FabienFerrero/UCA_Board/Gerber/readme.md

The PCB has been layout by hand, I'm an antenna designer and not a professional PCB layout maker, 
so you may find the layout not so much professional.

Whatever, this PCB is working quite well for proof of concept projects.

If you want to give an hand to make this project more professional, please send me an email.

Top View from ADS software

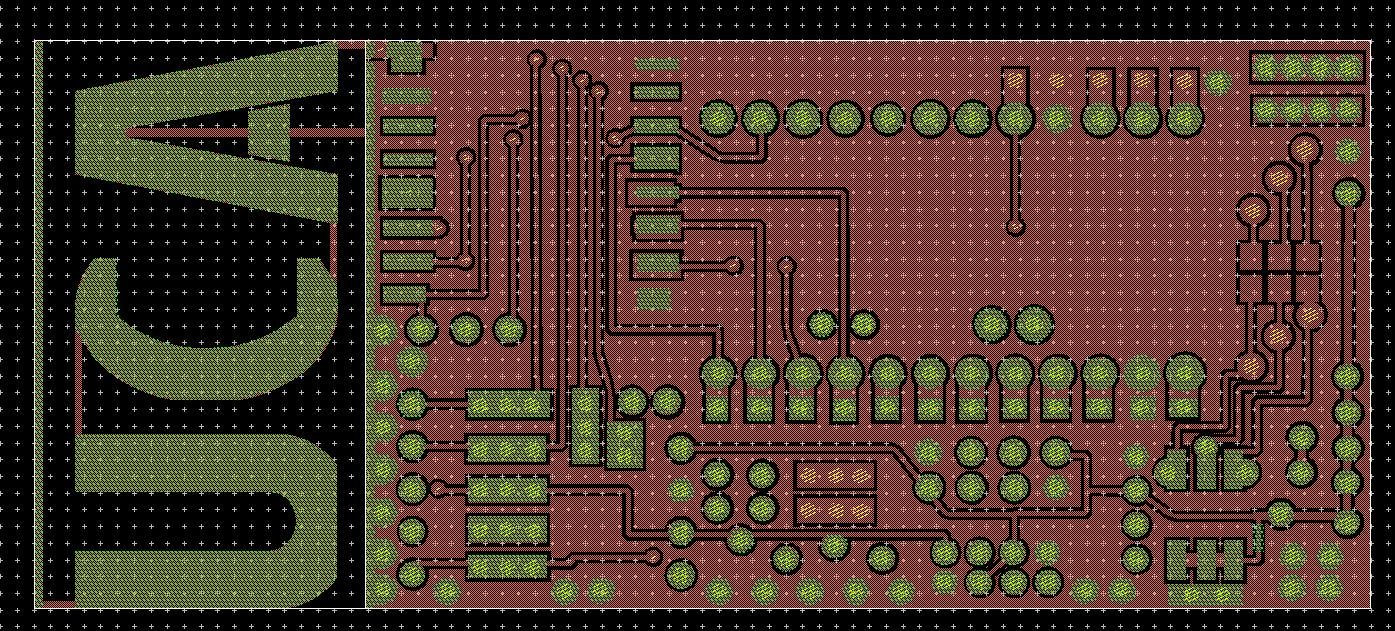
[picture p5: documents/pictures/UCA_layout.png]


Top view from DipTrace

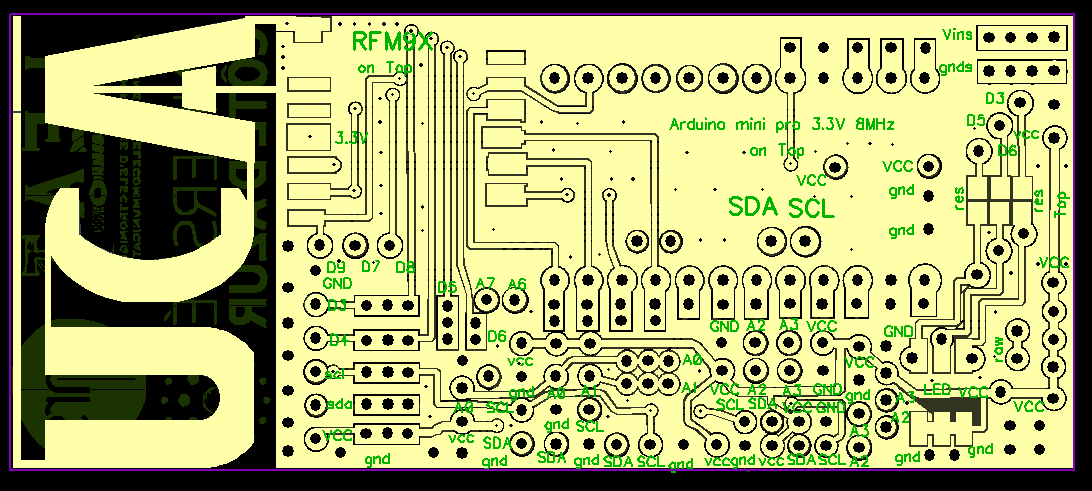
[picture p6: documents/pictures/UCA_layout_top.png]


Bottom view from DipTrace

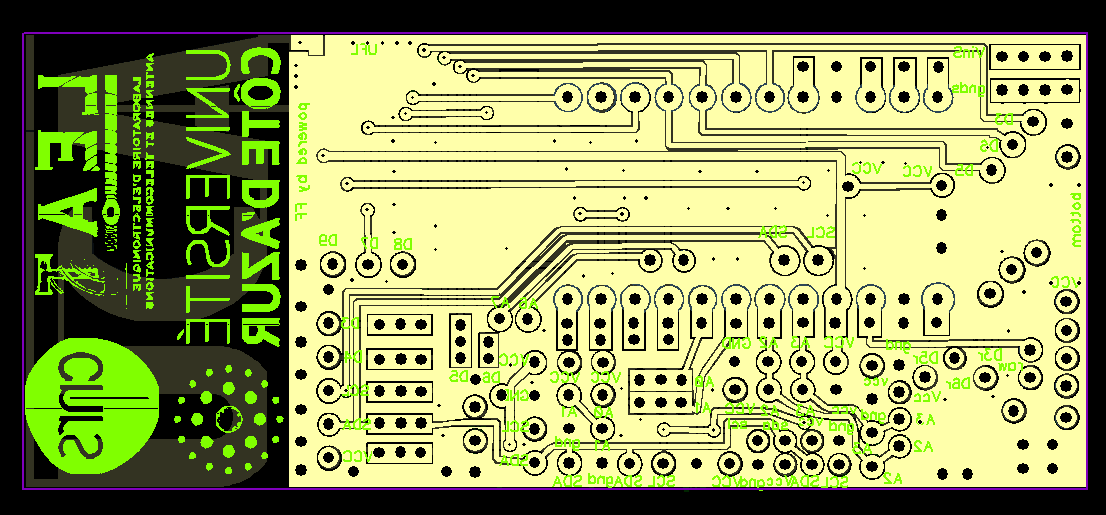
[picture p7: documents/pictures/UCA_layout_bot.png]


Picture of the Top view of the pcb
