FabienFerrero/UCA_Board/Antenna/readme.md

# This section is dedicated to the antenna part.

* Antennas are very sensitive to the environment, a tutorial is proposed to tune the UCA antenna
