FabienFerrero/UCA_Board/documents/Course/readme.md

You will find in this directory the course on LP-WAN technology in the frame of the MIT module
