FabienFerrero/UCA_Board/documents/Labs/readme.md

This Labs are done in the frame of Connected Objet course in Polytech'Nice
