FabienFerrero/UCA_Board/Arduino_Code/CW/readme.md

This code has been realized by CongDuc Pham,

It provides on Continuous wave for power for TRP measurements
