FabienFerrero/UCA_Board/Arduino_Code/LORAWAN/OTAA/LP_SI7021_TEMT6000/readme.md

This code has been modified from : https://github.com/tkerby/minilora-test

It includes :

* LoRaWan OTAA activation
* Adaptative Spreading factor
* Low-power sleep between Tx 
* SI7021 sensor for temperature and humidity
* Cayenne Payload

This code has been tested on EUR868 and AS923 bands

The bands can be selected in config.h of Arduino_LMIC Lib
