FabienFerrero/UCA_Board/Arduino_Code/LORAWAN/ABP/Basic/readme.md

Exemple of Activation By Personalisation (ABP)

You have to define :

NWKSKEY : [16 Bytes] MSB

APPSKEY : [16 Bytes] MSB

DEV ADDRESS : [8 Bytes] MSB

Pay attention to the frame counter in TTN, you have to reset it each time you reset your board.
