FabienFerrero/UCA_Board/Arduino_Code/LORAWAN/OTAA/LP_Thermistance/readme.md

This code has been modified from :
https://github.com/tkerby/minilora-test

A thermistance is used to measure temperature, and the data are formatted in LPP Cayenne format.
