FabienFerrero/UCA_Board/Antenna/UCA_Antenna_tuto.pdf

### Laboratory of Electronics Antennas and Telecommunications

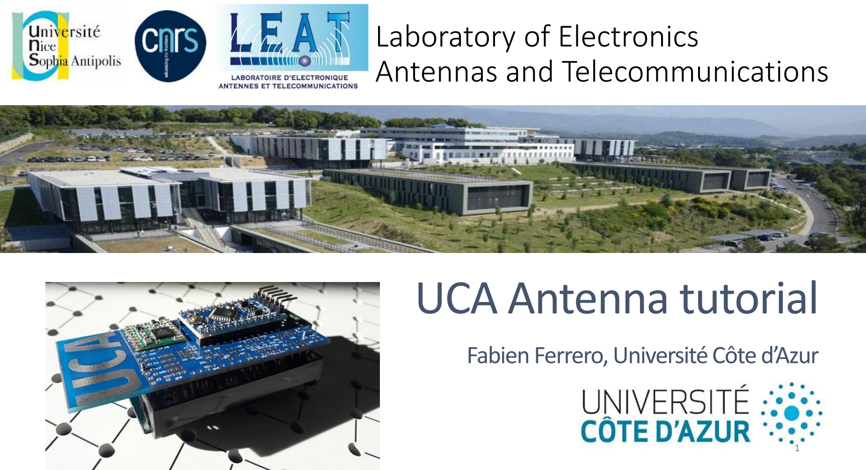
[picture p19: page 1]

# UCA Antenna tutorial

Fabien Ferrero, Université Côte d’Azur

## Antenna key parameters

- Antenna is a resonnant structure :
- antenna input impedance is changing with frequency
- antenna have a limited frequency bandwidth
- Miniature antenna can have a low efficiency due to metallic or dielectric losses
- Antenna is an open structure
- Compare to electronic components, antenna is strongly influenced by its surrounding environment
- For integrated antenna, the electromagnetic wave is generated by the antena and by the terminal ground plane
➢Small antenna has to be carefully tuned

Trade-off

Efficiency

Size | Bandwidth

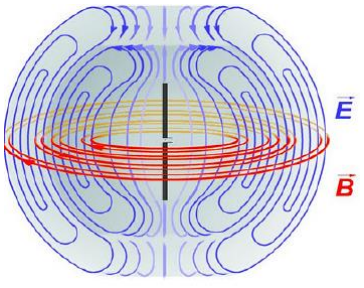
[picture p20: figure]

## Antenna key parameters

- Definition :
- Ps
: Power from the source
- Pref : Power reflected by the antenna
- Prad power radiated by the antenna
- Antenna Performance Indicator
- Reflection coefficient
- S11 is usually plotted in dB scale
- Classical S11 criteria is -10 dB (90% transmitted power)
- For miniature antenna, -6dB is commonly used (75% transmitted power)
- Total Efficiency
- Include matching loss (from S_11) and radiation loss caused by metallic and dielectric losses
- Can be plotted in linear or dB scale
- No specific criteria, 30-70% classically observed

50 ohm
source
N°1

Ps

Pref

Prad

|S11|

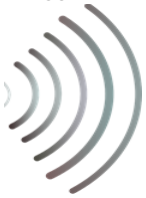
[picture p21: figure]

2 = Pref/Ps

ηt = Prad/Ps

## Antenna key parameters

- Antenna Performance Indicator
- Directivity
- Directional properties of the antenna as compared with those of an isotropic source.
- For an isotropic source, power is equally radiated in all directions.
- U is the mean radiation intensity over a sphere
- U θ,φ is the radiation intensity in a given direction
- Plotted in dBi
- Gain
- Include matching, radiation loss and directivity
- Radiation intensity of your antenna referenced to a loss-less isotropic source
- Plotted in dBi

G(θ,φ) =

U θ, φ
Ps/4π

U =

Prad
4π

D(θ, φ) =

U θ, φ
U

## UCA Antenna layout

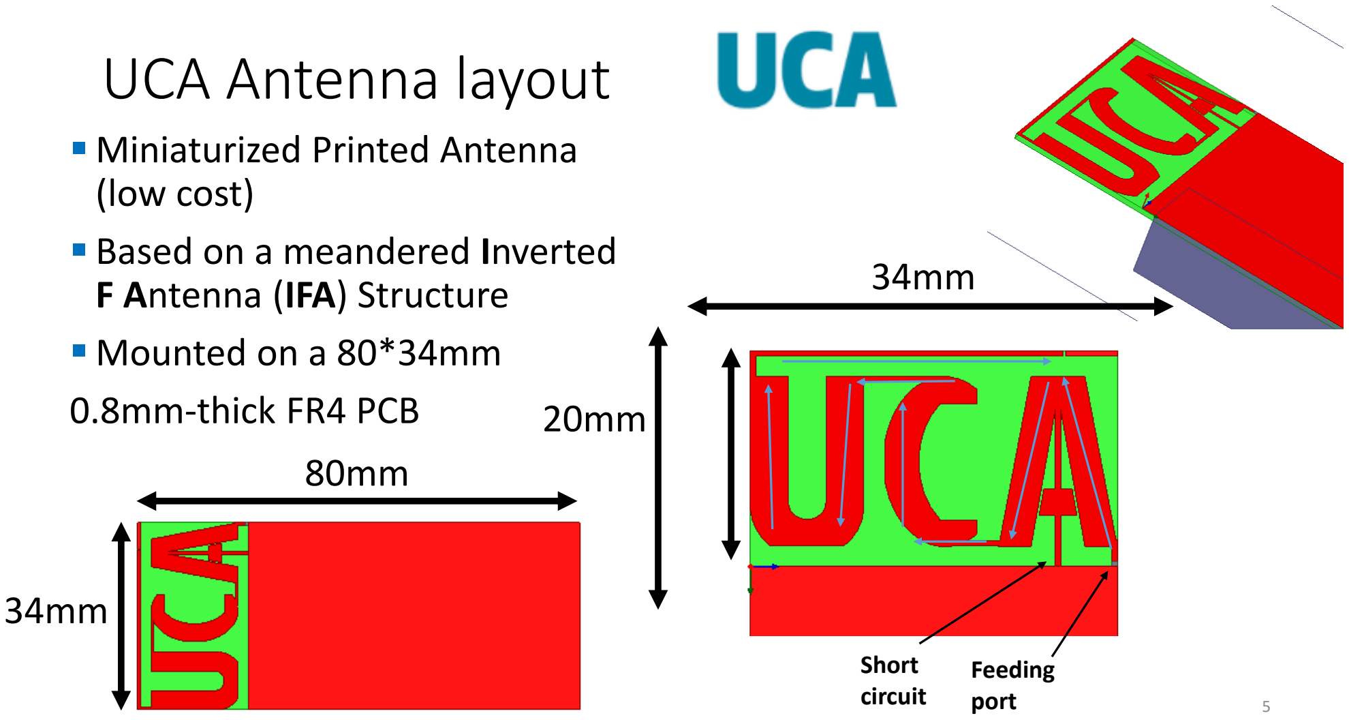
[picture p22: page 5]

- Miniaturized Printed Antenna (low cost)
- Based on a meandered Inverted F Antenna (IFA) Structure
- Mounted on a 80*34mm
0.8mm-thick FR4 PCB

34mm

20mm

34mm

80mm

Short
circuit

Feeding
port

## UCA Antenna tuned for EU band

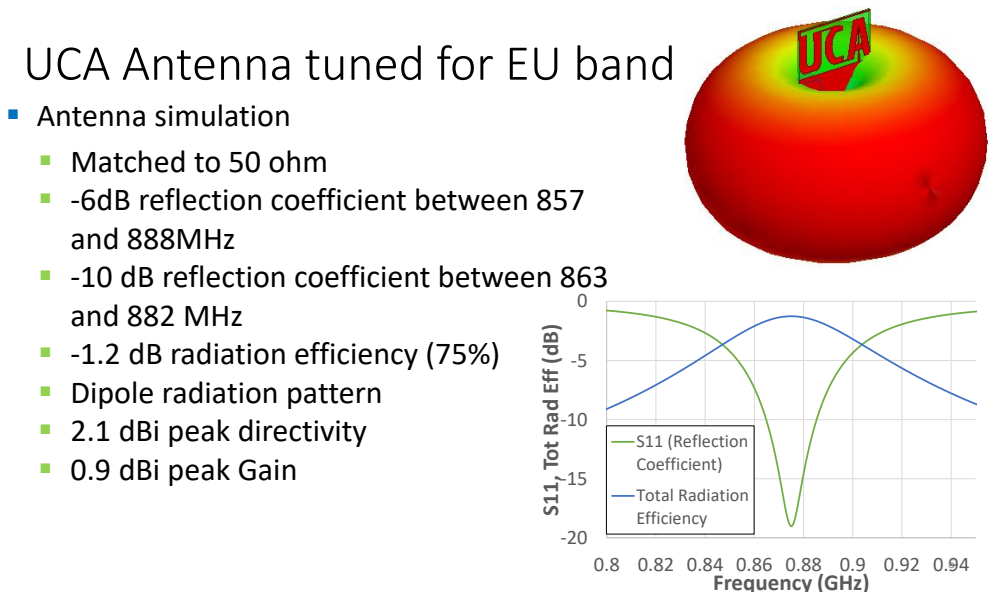
[picture p23: page 6]
0.8 0.82 0.84 0.86 0.88 0.9 0.92 0.94 Frequency (GHz); S11 (Reflection Coefficient); Total Radiation Efficiency

▪ Antenna simulation
▪ Matched to 50 ohm
▪ -6dB reflection coefficient between 857
and 888MHz
▪ -10 dB reflection coefficient between 863
and 882 MHz
▪ -1.2 dB radiation efficiency (75%)
▪ Dipole radiation pattern
▪ 2.1 dBi peak directivity
▪ 0.9 dBi peak Gain

S11, Tot Rad Eff (dB)

## UCA Antenna tuned for EU band

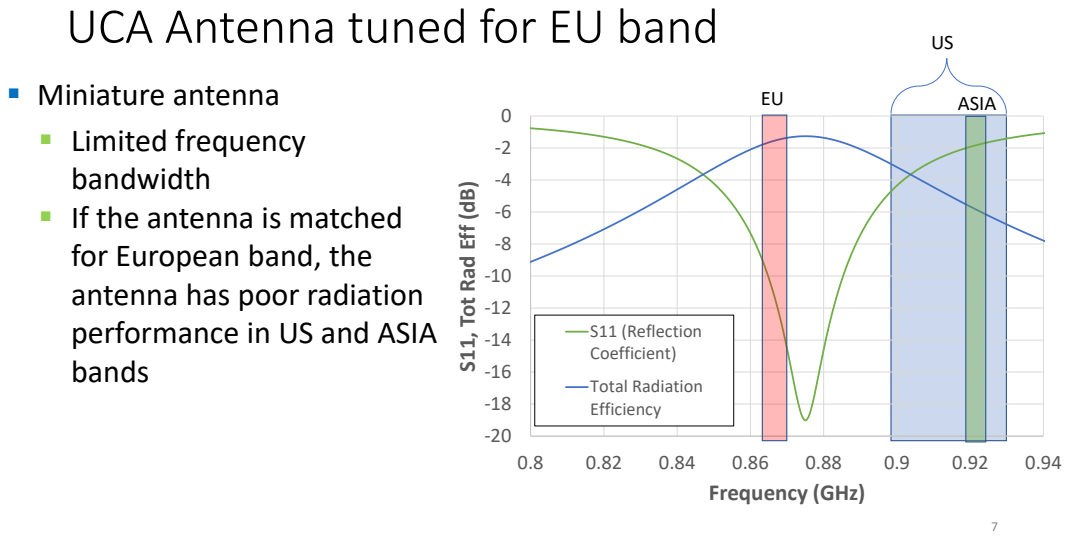
[picture p24: page 7]
Frequency (GHz); ASIA

▪ Miniature antenna
▪ Limited frequency
bandwidth
▪ If the antenna is matched
for European band, the
antenna has poor radiation
performance in US and ASIA
bands

S11, Tot Rad Eff (dB)

S11 (Reflection
Coefficient)
Total Radiation
Efficiency

## UCA Antenna tuning

- The antenna shape can be easily tuned to different frequencies
- The top line can be cut at different position to change the antenna trace length
- T_ant parameter can be tuned from 0 to 34mm
- Antenna resonance frequency can be tuned from 845 to 950MHz

Small cut in the top line

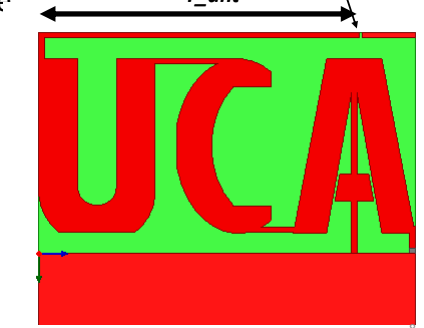
[picture p25: figure]

T_ant

## UCA Antenna tuning : Reflection coefficient

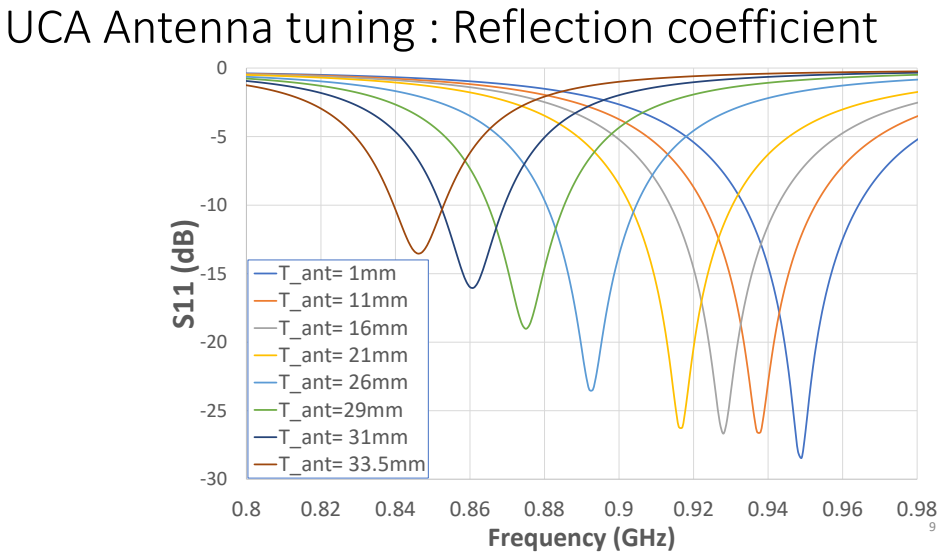
[picture p26: page 9]
Frequency (GHz)

T_ant= 1mm
T_ant= 11mm T_ant= 16mm

T_ant= 21mm T_ant= 26mm T_ant=29mm

T_ant= 31mm T_ant= 33.5mm

## UCA Antenna :Linear Total Radiation Efficiency

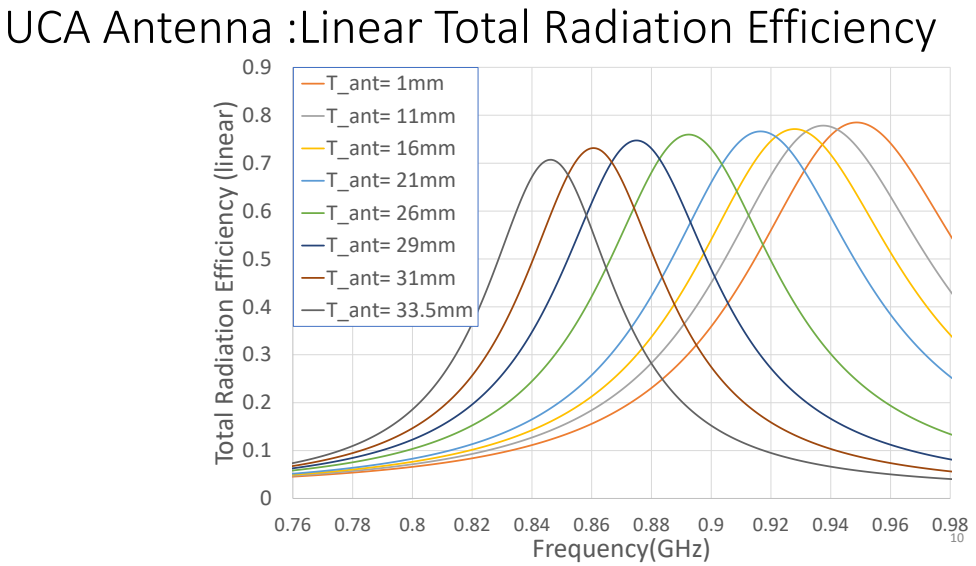
[picture p27: page 10]
Frequency(GHz)

T_ant= 1mm T_ant= 11mm

Total Radiation Efficiency (linear)

T_ant= 16mm
T_ant= 21mm T_ant= 26mm

T_ant= 29mm
T_ant= 31mm
T_ant= 33.5mm

## UCA Antenna :Total Radiation Efficiency in dB

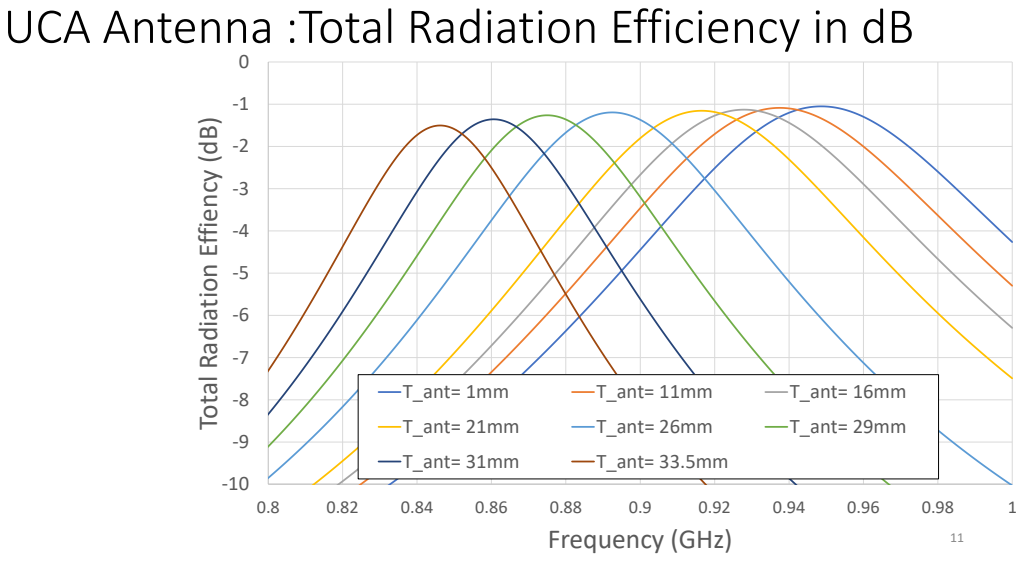
[picture p28: page 11]
Frequency (GHz)

Total Radiation Effiency (dB)

T_ant= 1mm | T_ant= 11mm | T_ant= 16mm
T_ant= 21mm | T_ant= 26mm | T_ant= 29mm
T_ant= 31mm | T_ant= 33.5mm

## UCA Antenna : Comparison with on-the-shelf antenna

80mm
170mm

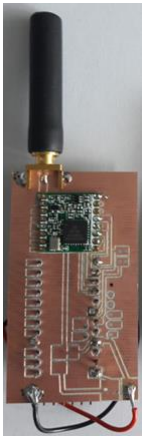
[picture p29: figure]

Short
monopole

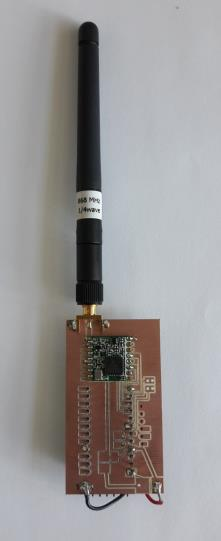
[picture p30: figure]

Quarter-wave
monopole

280mm

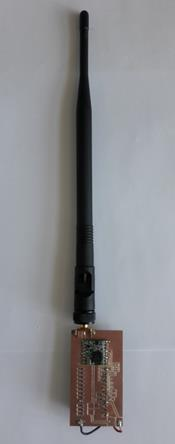
[picture p31: figure]

half-wave

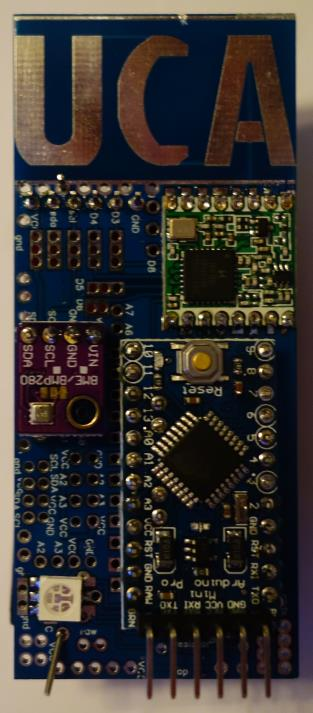
[picture p32: figure]

dipole UCA
antenna

105mm

## UCA Antenna : Measurements

- Measurement on Satimo Starlab
station
- Continuous wave with 14 dBm power from RFM95W module
- Efficiency calculated from the 3D
antenna measurement

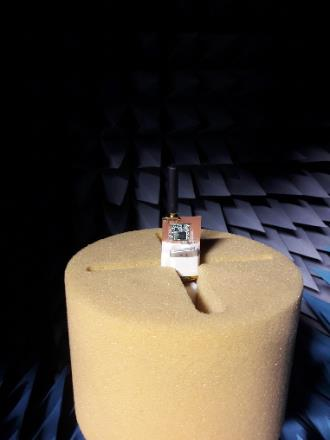
[picture p33: figure]
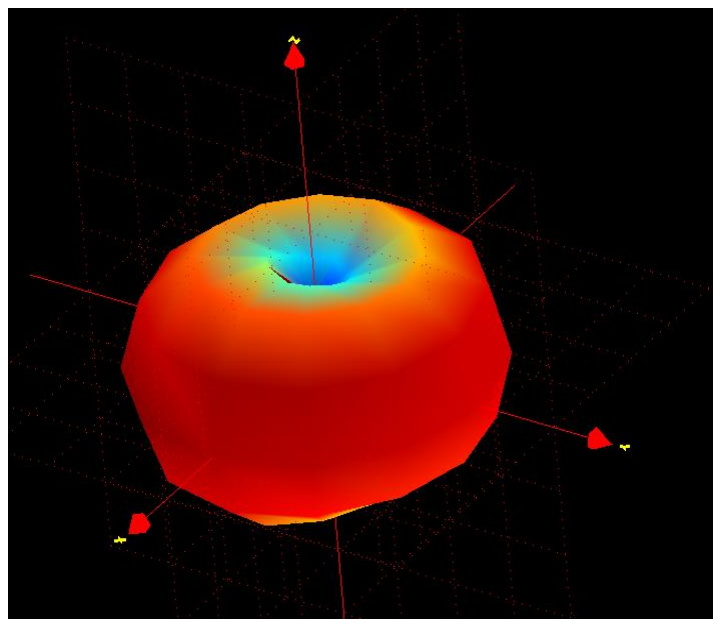
[picture p34: figure]

Antenna structure | TRP (dBm) | Total efficiency | Max Dimension
Small monopole | 14.7 | 74% | 105 mm
Quarter-wave monop. | 15.7 | 94% | 170 mm
Half-wave dipole. | 13.9 | 61% | 280 mm
UCA untuned | 13.8 | 60% | 80mm
UCA after tuning | 14.8 | 76% | 80mm 13
