FabienFerrero/UCA_Board/documents/Labs/Lab4_Power consumption.pdf

# Power consumption Lab

F. Ferrero

# Power consumption Lab

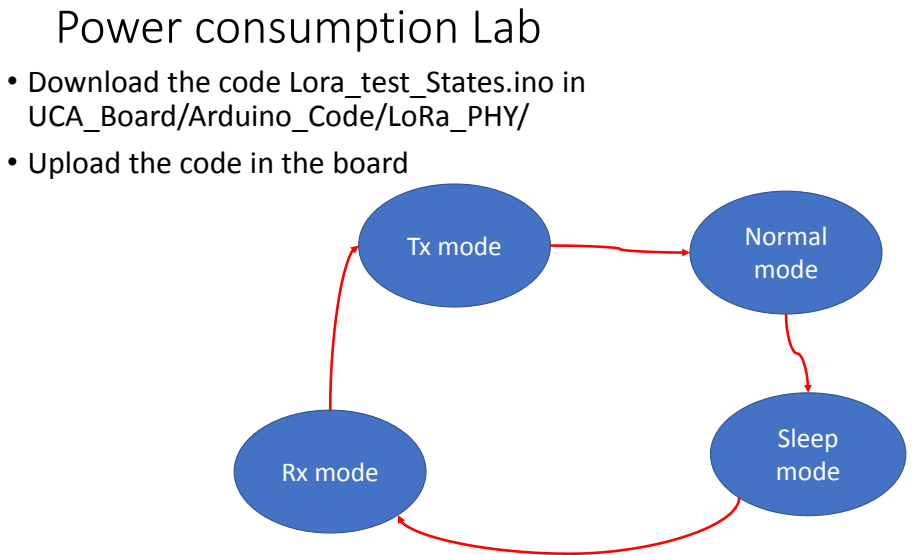
[picture p35: page 2]
Tx mode; Rx mode; Sleep mode; Normal mode

• Download the code Lora_test_States.ino in
UCA_Board/Arduino_Code/LoRa_PHY/
• Upload the code in the board

# Power consumption Lab

- The code set 4 differents states :
- Transmission mode (the Tx power can be tuned from 2 to 20dBm)
- Normal mode (Arduino in normal mode and transciever in sleep mode)
- Sleep mode
- Reception mode

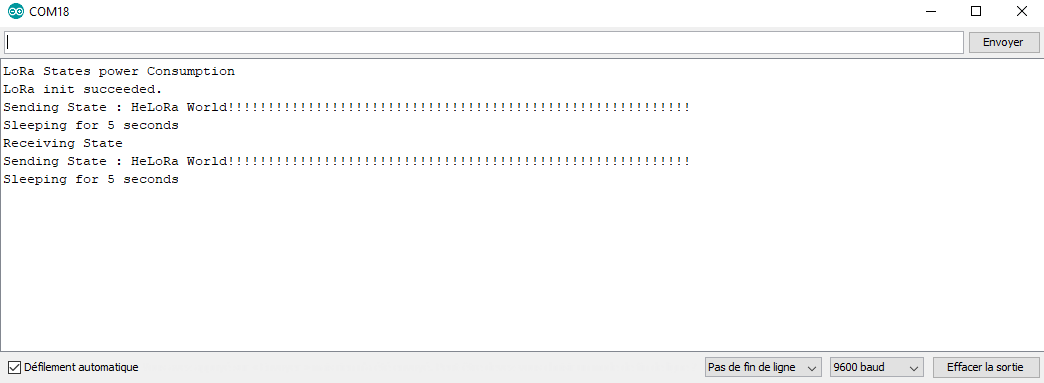
[picture p36: figure]

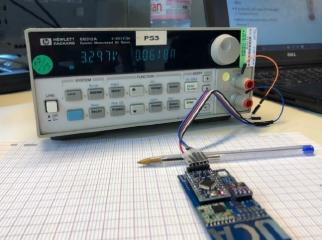
[picture p37: figure]

# Power consumption Lab

- You can use a 66312A DC source to measure the power consumption in the 3 different modes with 3.3V
- Try to power the Arduino on Vcc Pin and Raw Pin.
- The Vcc Pin can be powered up to 5V

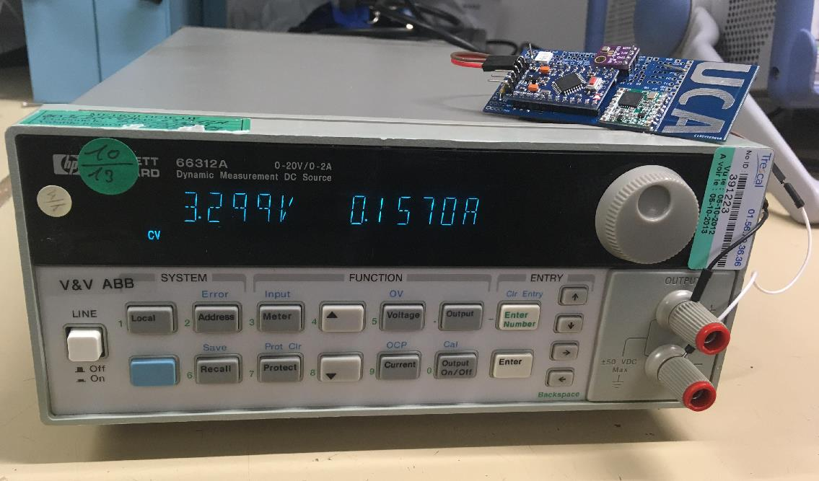
[picture p38: figure]

# Power consumption Lab

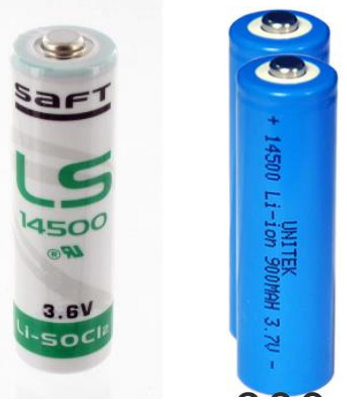
[picture p39: figure]

- Compare the autonomy of your device for a primary and secondary battery
- Scenario :
- For transmit, a SF9 and 14 dBm
- A transmit will take 200ms and 1 Tx each 10mn
- To wake-up and process the data, you need 300 ms with a normal mode
- Rest of the time, the device is in sleep mode
- What is the autonomy of the device ?
- For a AA metal lithium battery with 2.6 A.h
- For a AA lithium-ion battery with 0.9 A.h
