FabienFerrero/UCA_Board/documents/Course/Course_LPWAN.pdf

## Laboratory of Electronics Antennas and Telecommunications

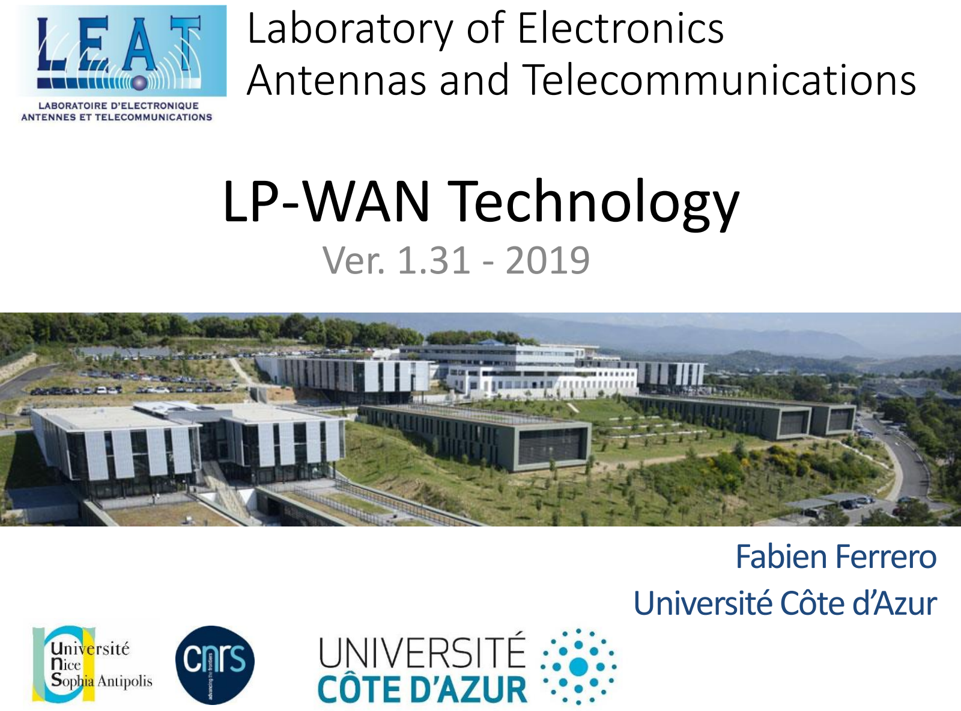
[picture p89: page 1]

# LP-WAN Technology

## Ver. 1.31 - 2019

### Fabien Ferrero Université Côte d’Azur

# Objectives

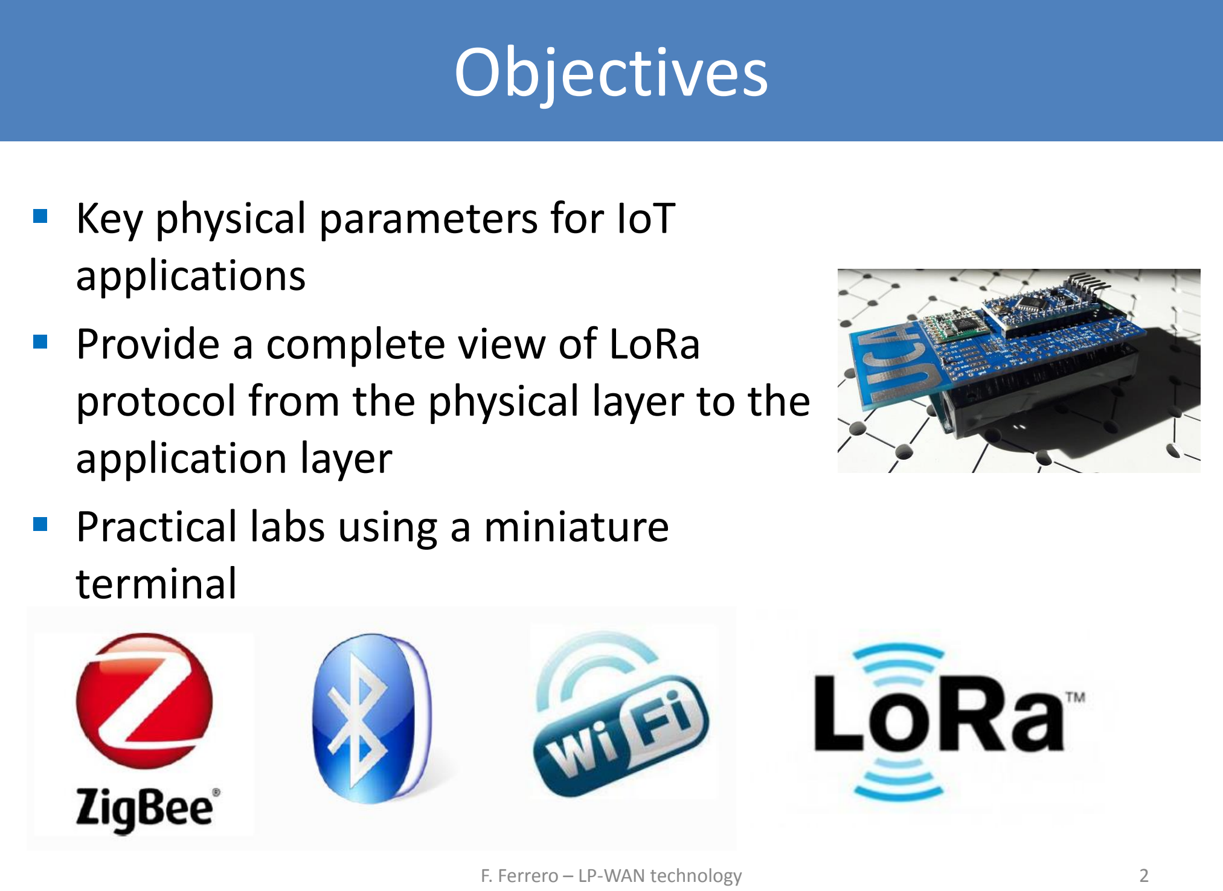
[picture p90: page 2]

### - Key physical parameters for IoT applications - Provide a complete view of LoRa protocol from the physical layer to the application layer - Practical labs using a miniature terminal

F. Ferrero – LP-WAN technology | 2

# Outline

## 0. Introduction I. Antenna and channel model II. Physical layer (LoRa modulation) III. MAC layer (LoRaWAN) and security

F. Ferrero – LP-WAN technology | 3

# LoRa vs LoRaWan

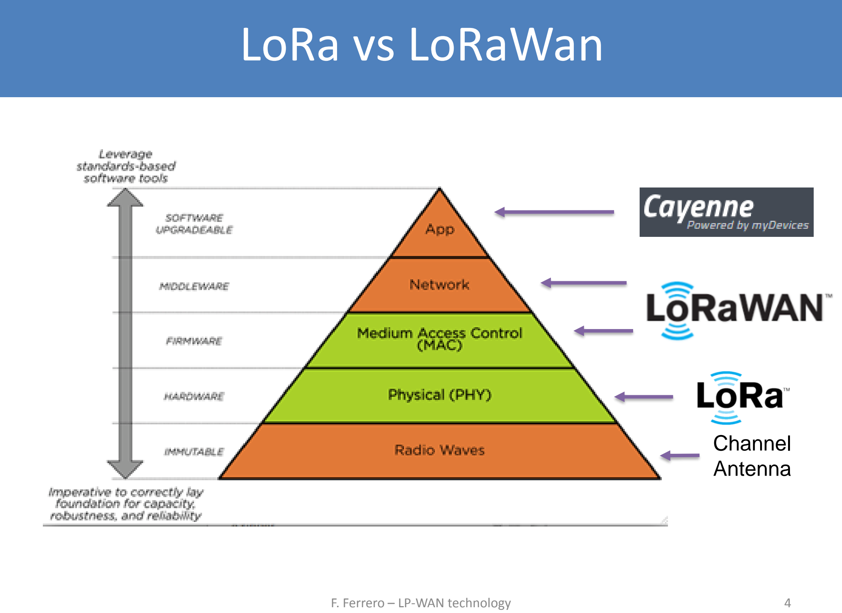
[picture p91: page 4]

F. Ferrero – LP-WAN technology | 4

Channel
Antenna

# What are we talking about ?

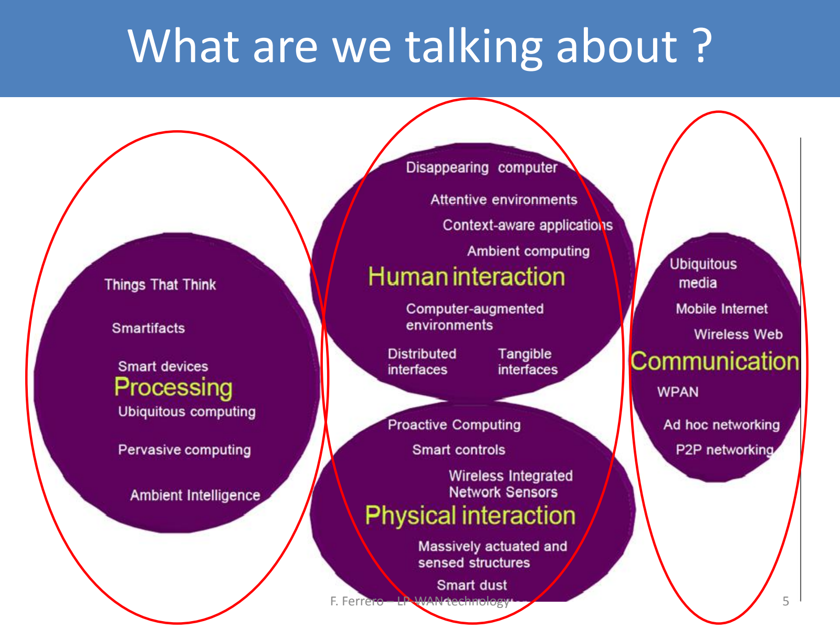
[picture p92: page 5]

F. Ferrero – LP-WAN technology | 5

# Anatomy of an IoT device

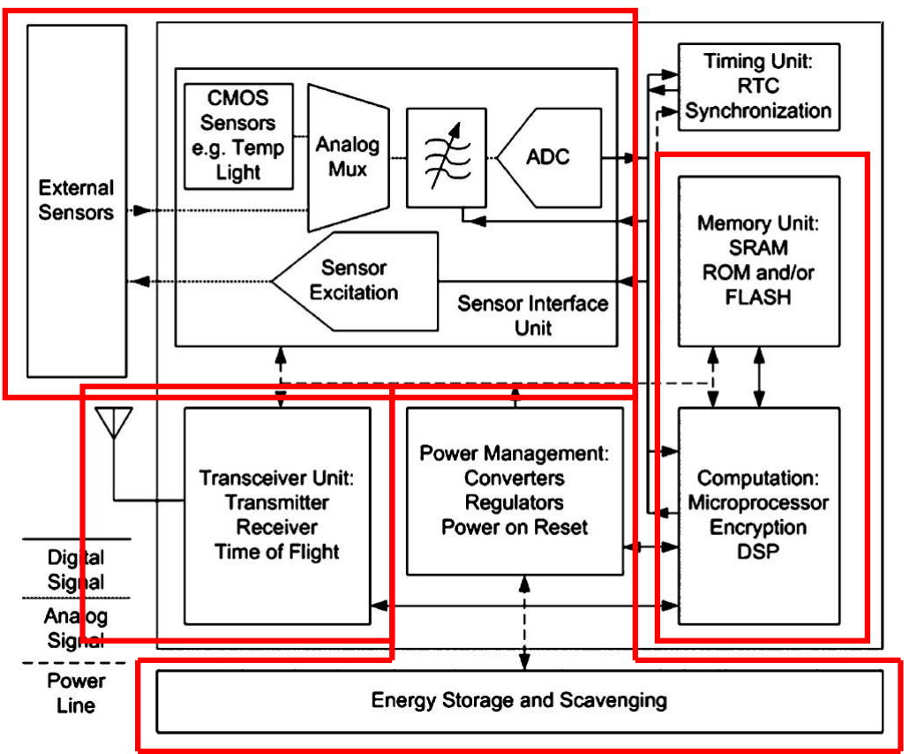
[picture p93: figure]

F. Ferrero – LP-WAN technology | 6

# Anatomy of our IoT device

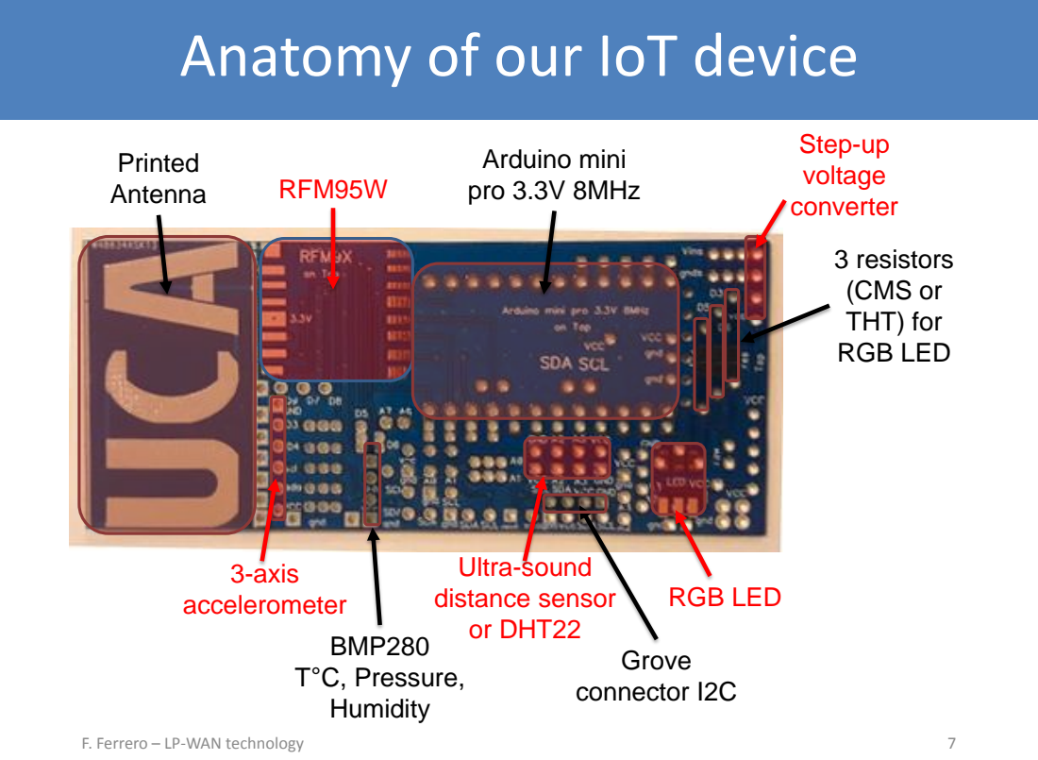
[picture p94: page 7]
F. Ferrero – LP-WAN technology; 3 resistors (CMS or THT) for RGB LED; RFM95W; Arduino mini pro 3.3V 8MHz; Step-up voltage converter; RGB LED; 3-axis accelerometer; BMP280 T°C, Pressure, Humidity; Grove connector I2C; Ultra-sound distance sensor or DHT22; Printed Antenna

# Communication Technology

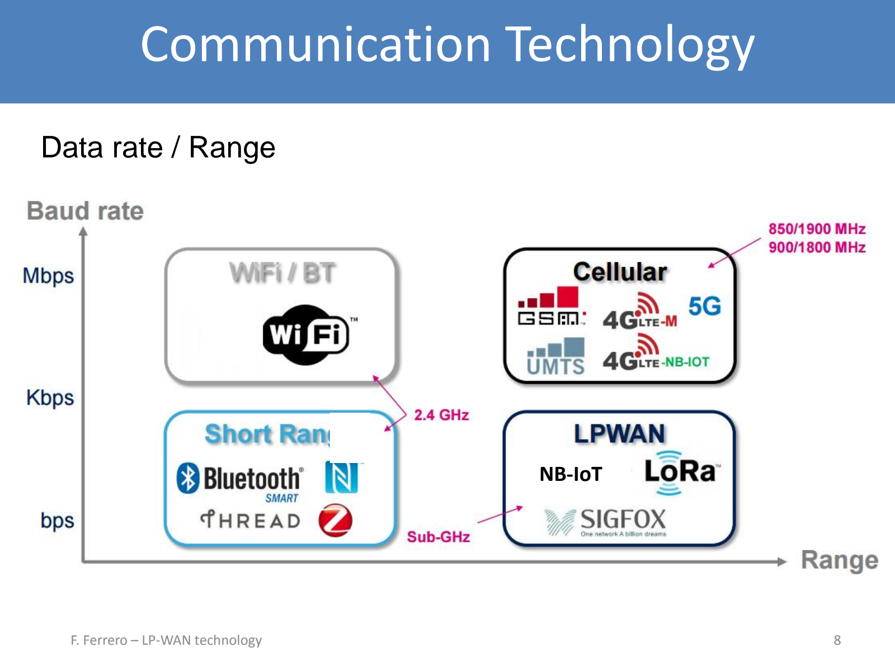
[picture p95: page 8]

F. Ferrero – LP-WAN technology | 8

NB-IoT

Data rate / Range

# Communication Technology

F. Ferrero – LP-WAN technology | 9
Techno | Net. Type | Freq | Range | Data Rate | Power
Wifi | Star | 2.4- 5GHz | 100m | 100Mb/s | 1W
BLE | P2P, mesh | 2.4- 5GHz | 100m | 1Mb/s | 10mW
Zigbee | P2P, mesh | 2.4- 5GHz | 250m | 250kb/s | 100mW
RFID | P2P | 900MHz | 7m | 500kb/s | 2W
NFC | P2P | 13.56MHz | 0.1m | 500kb/s | 100mW
EDGE | GERAN | 900MHz | 15 km | 384kb/s | 2W
UMTS | UTRAN | 2100MHz | 10 km | 10Mb/s | 2W
LTE | UTRAN | 700 MHz | 10 km | 100Mb/s | 2W
SigFox | Star | 900MHz | 15km | 100b/s | 25mW
LoRa | Star | 900MHz | 15km | 290b/s- 5kb/s | 25mw

# LP-WAN connectivity overview

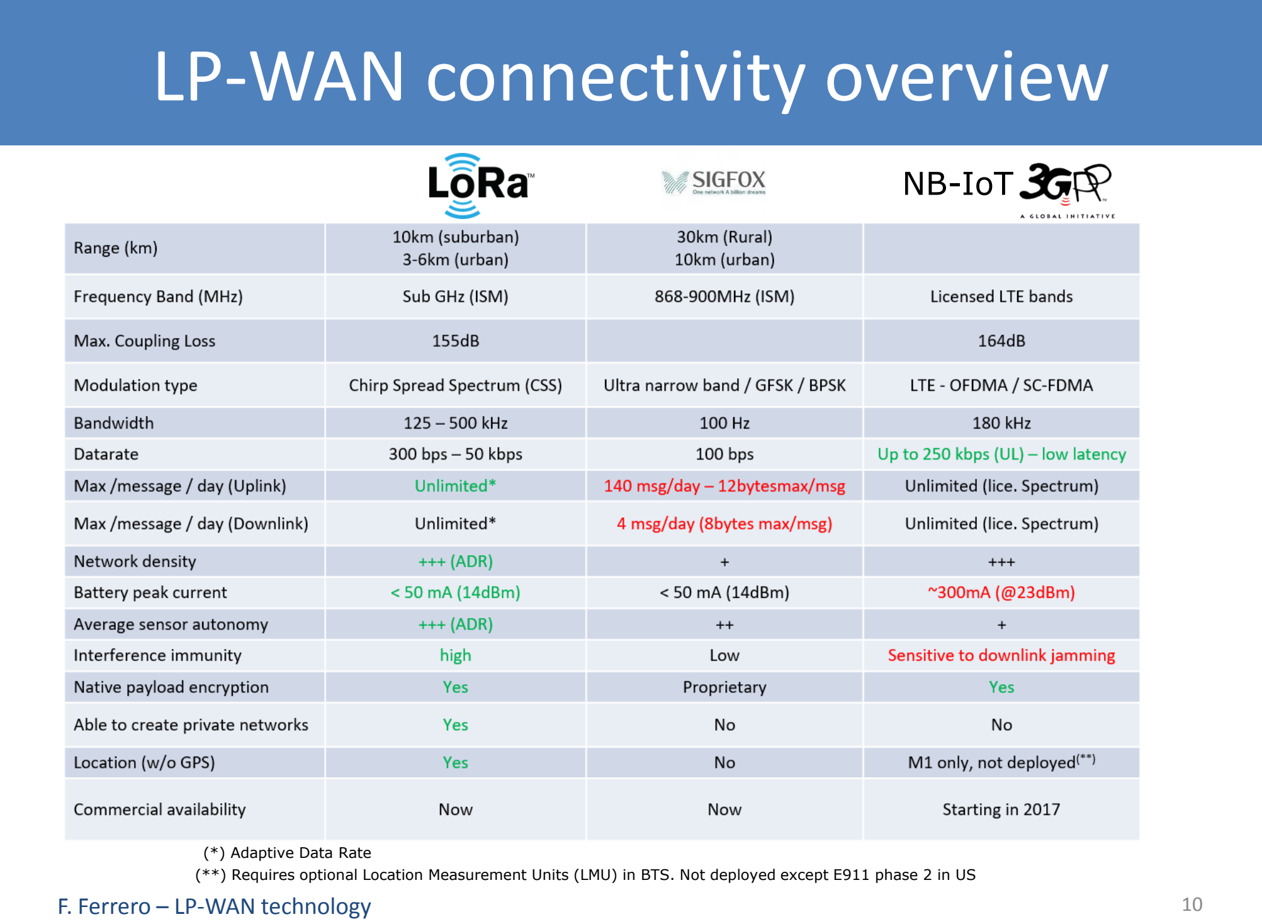
[picture p96: page 10]

F. Ferrero – LP-WAN technology | 10

(**) Requires optional Location Measurement Units (LMU) in BTS. Not deployed except E911 phase 2 in US

(*) Adaptive Data Rate

NB-IoT

# IoT Physical Key parameters

F. Ferrero – LP-WAN technology | Pictures from Nokia White paper | 11
- Propagation Channel
- Power sources
- Device size
- Security

# Propagation channel

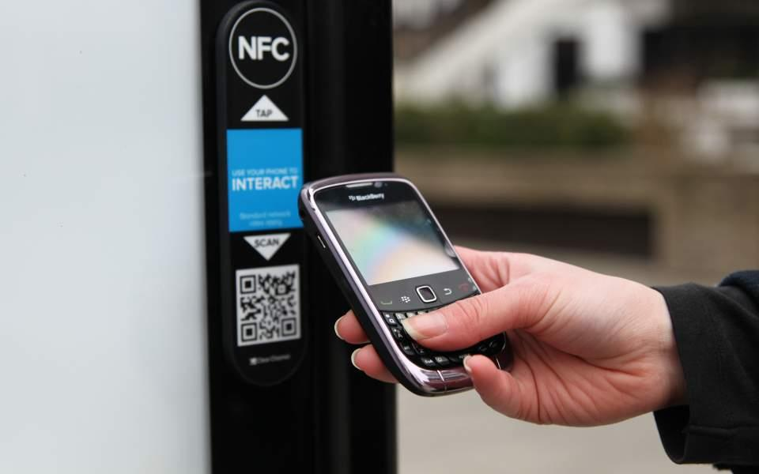
[picture p97: figure]
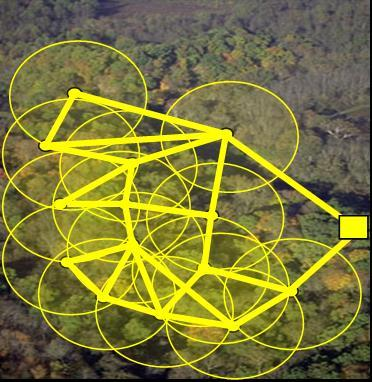
[picture p98: figure]

F. Ferrero – LP-WAN technology | 12
- Type of channel
- Distance among the communicating objects communicants
- Line of sight (LOS) / non-LOS
- Channel noise (interferences)

# Network area definitions

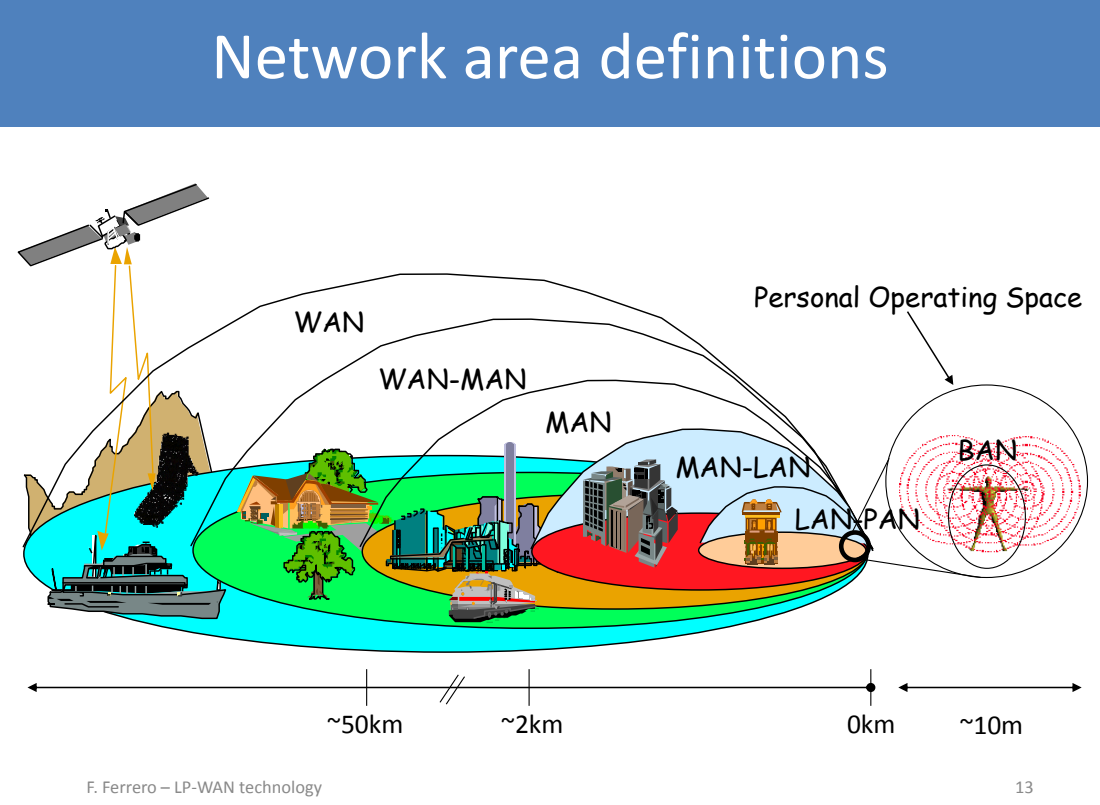
[picture p99: page 13]
F. Ferrero – LP-WAN technology; WAN; WAN-MAN; MAN; Pico-Cell; MAN-LAN; BAN; LAN-PAN

Personal Operating Space

# Network area definitions

F. Ferrero – LP-WAN technology | 14
- WAN (Wide Area Network)
- WANs interconnects facilities in different parts of a country or of the world
- MAN (Metropolitan Area Network)
- MANs shall be capable of operating over an area up to 50 Km in diameter
- LAN (Local Area Network)
- LANs shall be capable of supporting segments at least 100 meters in length.
- PAN (Personal Area Network)
- PANs shall be capable of supporting segments at least 10 meters in length.
- BAN (Body Area Network)
- A Wireless Body Area Network consists of small, intelligent devices attached on or implanted in the body.

# Practically

F. Ferrero – LP-WAN technology | 15
Carrier frequency | Channel losses over the same distance
Carrier frequency | Antenna dimensions

Communication

distance | X 10 | Channel attenuation

X 100

X 1000

Ideally

Usually, even more…

# Energy consumption

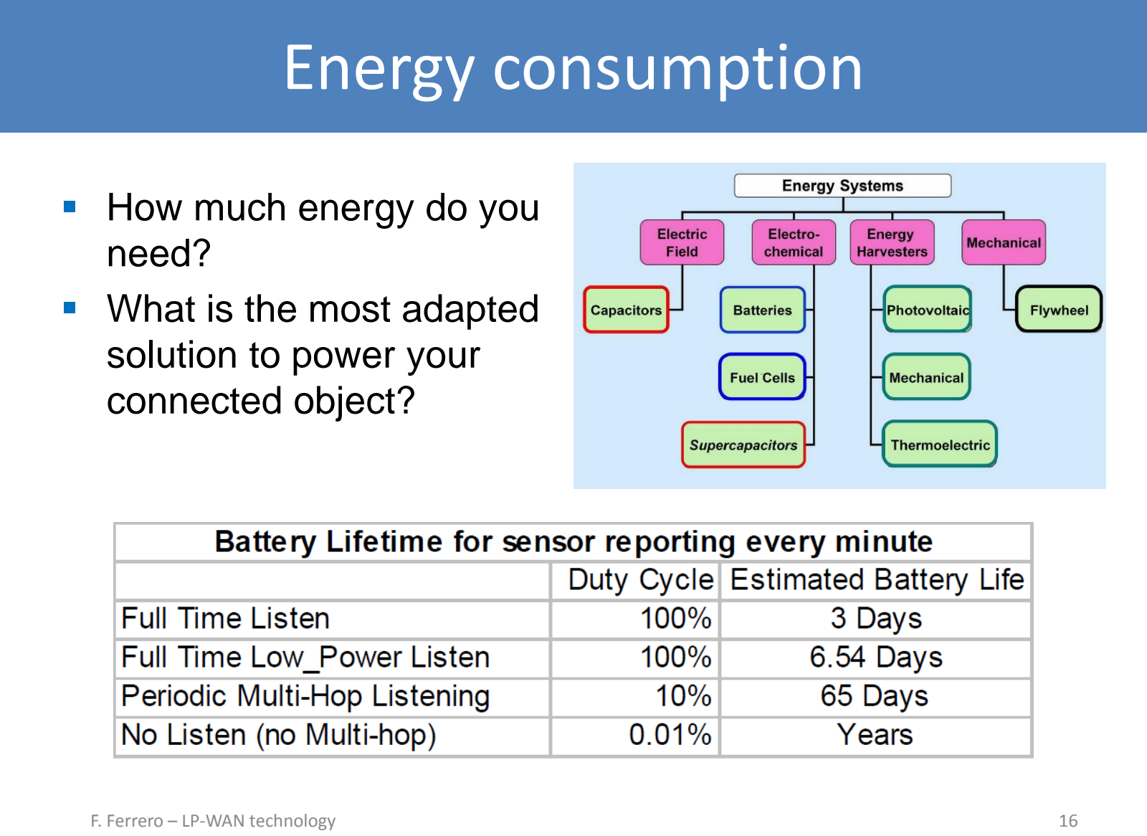
[picture p100: page 16]

F. Ferrero – LP-WAN technology | 16
- How much energy do you
need?
- What is the most adapted solution to power your
connected object?

# Object dimension

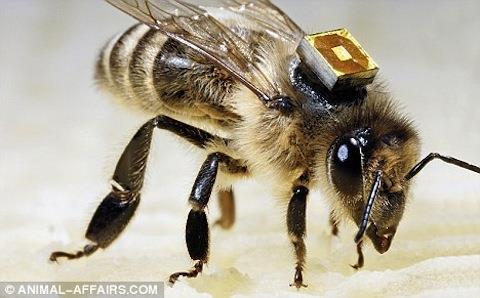
[picture p101: figure]

F. Ferrero – LP-WAN technology | 17
- As the dimension of the object decreases, the energy that can be stored decreases as well
- If the available space is not sufficient for storing enough energy (battery), this should be transferred (RFID) or found locally.
- Small dimensions limit the antenna efficiency. Communication will be still possible but over smaller distances.
- Usually electronics is not an issue in terms of miniaturization. The elements that need space are the antenna and the battery.

# Security

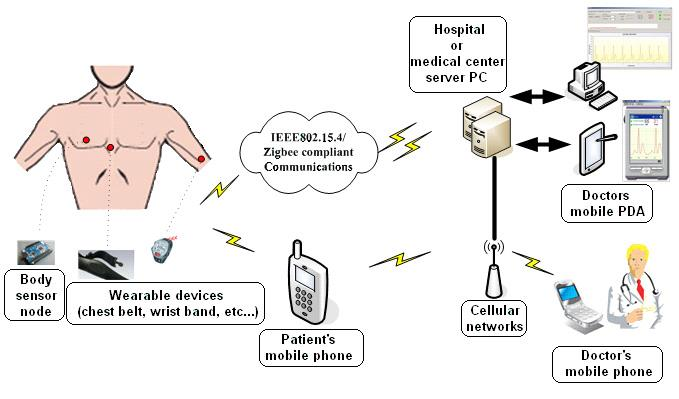
[picture p102: figure]

F. Ferrero – LP-WAN technology | 18
- What is the level of security needed by your application?
- What is the level of reliability needed by your application?

# What a the key parameters ?

F. Ferrero – LP-WAN technology | 19
- How much data rate do you need ?
- How is the propagation channel ?
- How small my device need to be ?
- How much energy do you need ?
- What level of security do you need ?

# Outline

## 0. Introduction I. Channel model and Antenna II. Physical layer (LoRa modulation) III. MAC layer (LoRaWAN) and security

F. Ferrero – LP-WAN technology | 20

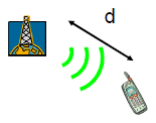
[picture p103: figure]

F. Ferrero – LP-WAN technology | 21

Free-space propagation

- No obstacles between transmitter and receiver
- The atmosphere is a uniform and non-absorbing medium
- Attenuation Lp depends on the distance d and the wavelength of the signal l
- l=c/f and c=3x10⁸ m/s

# Channel Ideal model

F. Ferrero – LP-WAN technology | 22

Real propagation :

- No Line of Sight
- Multiple paths between the transmitter and the receiver
- Attenuation Lp depends not only on the distance d and the wavelength of the signal l

# Real channel model

F. Ferrero – LP-WAN technology | 23

Practically, the free-space model is inadequate since:

- Multipath phenomenon
- Multiple paths between the transmitter and the receiver
- Shadowing phenomenon
- Obstruction of the direct line of sight between transmitter and receiver
- Fast fading phenomenon
- Destructive composition of different signal path that are close in time (phase opposition)

# Real Propagation

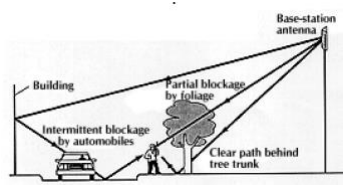
[picture p104: figure]

F. Ferrero – LP-WAN technology | 24
- Macroscopically, the electromagnetic waves are reflected by the obstacles between TX and RX
- The RX receives multiple signals shifted in time

# Multipath

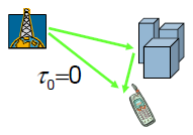
[picture p105: figure]

F. Ferrero – LP-WAN technology | 25

☐ Signal r(t): sum of N delayed and attenuated versions of s(t)

# Multipath

F. Ferrero – LP-WAN technology | 26

☐ Microscopically, the electromagnetic waves are diffracted and refracted by the obstacles between TX and RX
☐ Every path is constituted by a continuum of multiple paths

# Fading

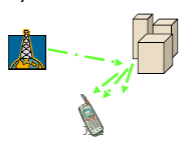
[picture p106: figure]

F. Ferrero – LP-WAN technology | 27

☐ Signal r(t): copy of s(t) attenuated and randomly delayed

# Fading

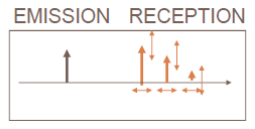
[picture p107: figure]

F. Ferrero – LP-WAN technology | 28

☐ Signal r(t): sum of N copies of s(t) randomly attenuated and delayed

# Multipath + Fading

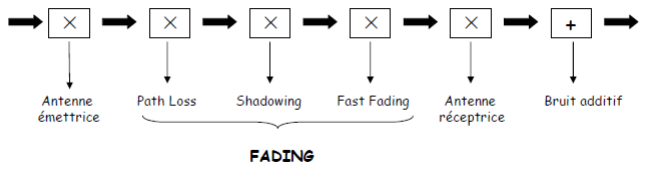
[picture p108: figure]

F. Ferrero – LP-WAN technology | 29

3 types of attenuation

☐ Path loss (distance attenuation)

- Decrease of the signal power due to the distance (deterministic)
☐ Shadowing (or slow fading)
- Slow variation of the signal amplitude due to large obstacle compare to the wavelength (hills, forest, building,…)
☐ Fast fading
- Fast variation of the signal amplitude (constructive or destructive combination of the electromagnetic waves)

# Attenuation

# Attenuation

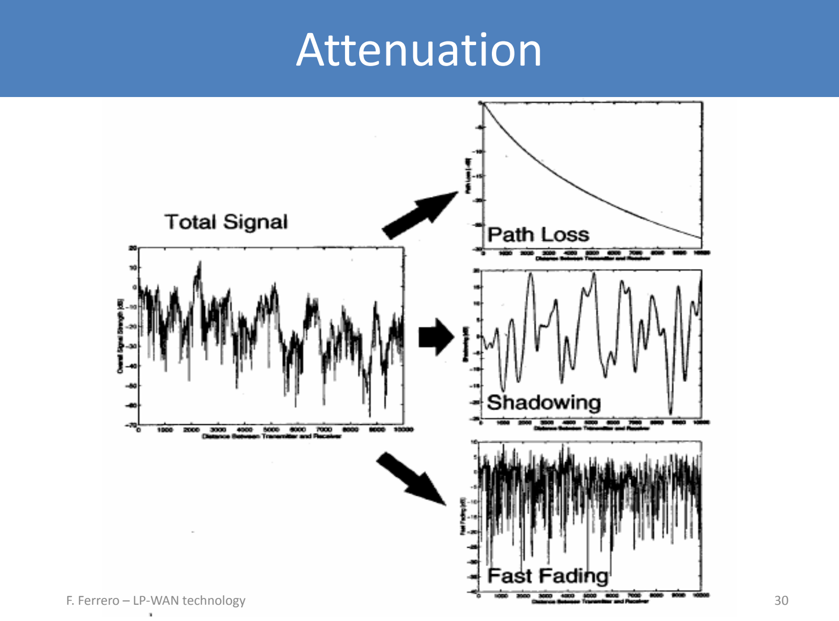
[picture p109: page 30]

F. Ferrero – LP-WAN technology | 30

# Average loss: power law model

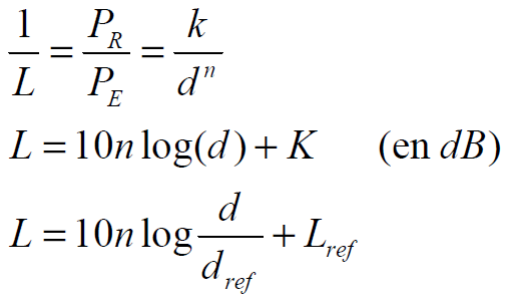
[picture p110: figure]

### - n : path loss calculated with measurements - Can be expressed in relative compared to a reference distance

- Most of the time, a distance of 1 m is choosen.
F. Ferrero – LP-WAN technology | 31

# Power law model

### Set of measurements done in a dedicated environment Curve interpolation fitting with the measured points

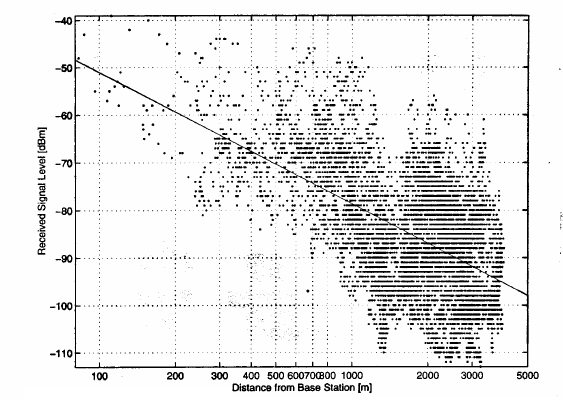
[picture p111: figure]

F. Ferrero – LP-WAN technology | 32

# Propagation

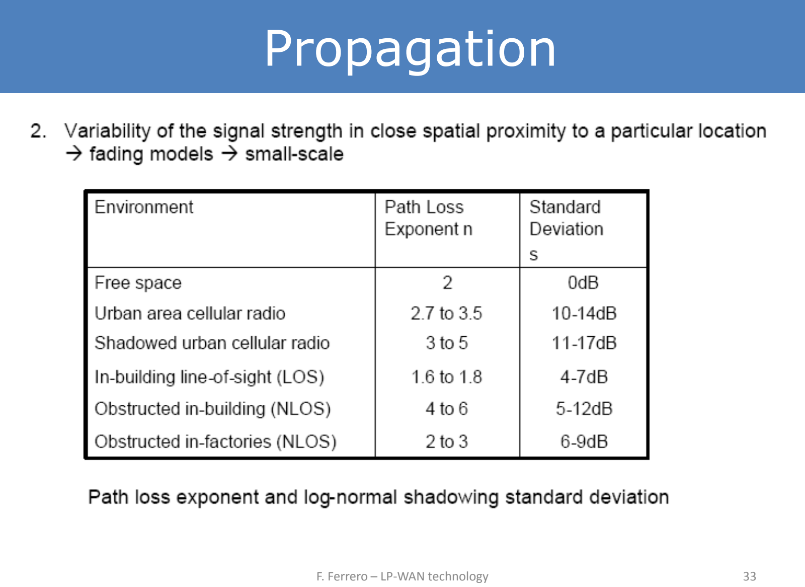
[picture p112: page 33]

33

F. Ferrero – LP-WAN technology

# Log-normal distribution around the average loss

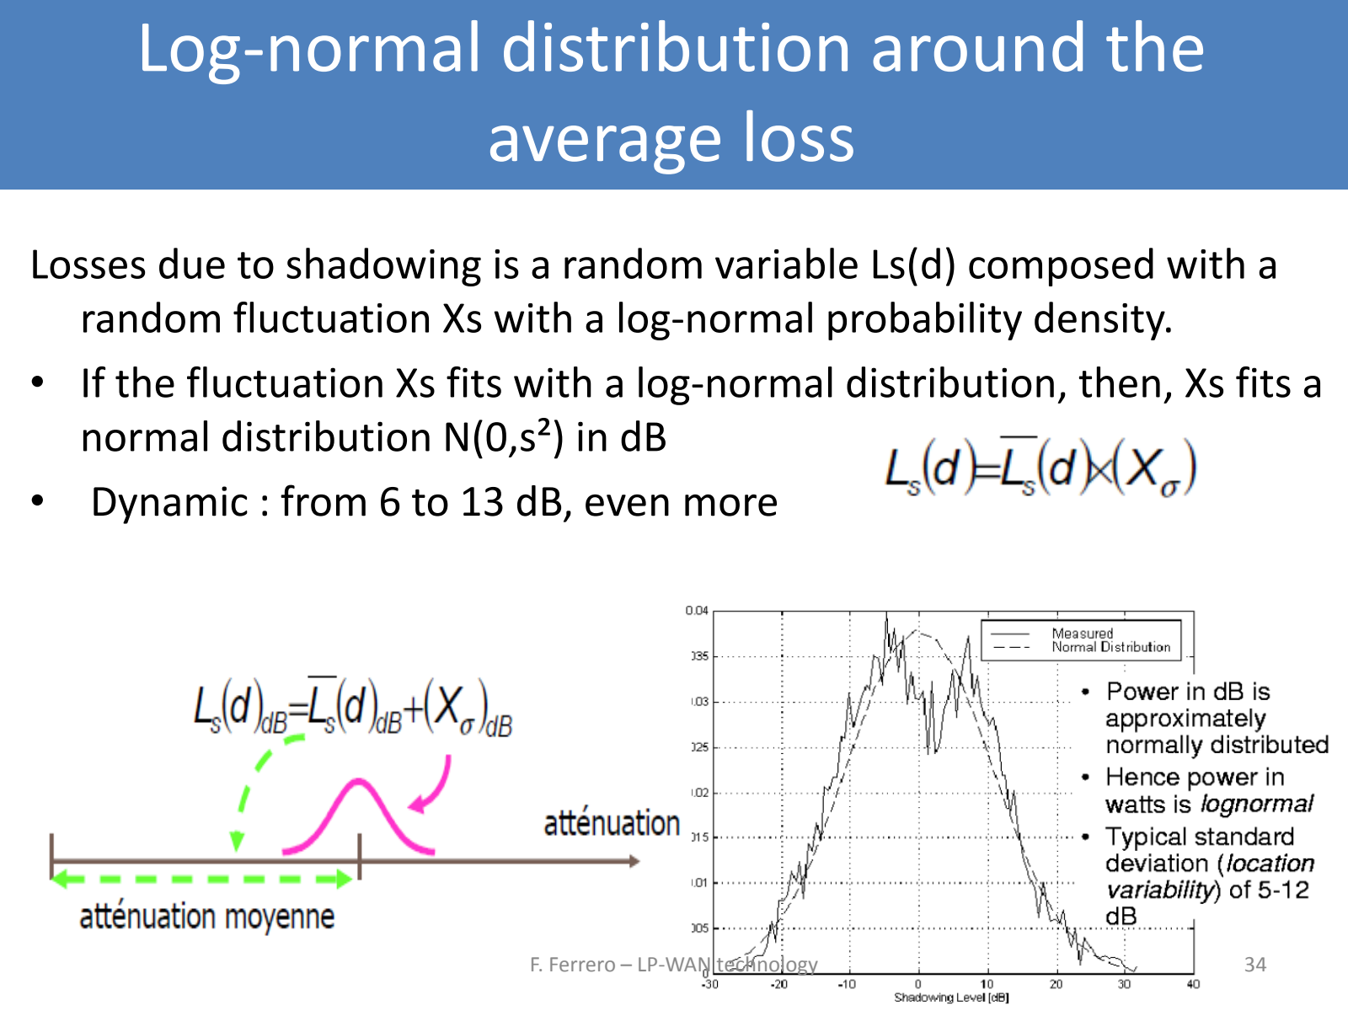
[picture p113: page 34]

Losses due to shadowing is a random variable Ls(d) composed with a random fluctuation Xs with a log-normal probability density.
- If the fluctuation Xs fits with a log-normal distribution, then, Xs fits a normal distribution N(0,s²) in dB
- Dynamic : from 6 to 13 dB, even more
F. Ferrero – LP-WAN technology | 34

# Labs

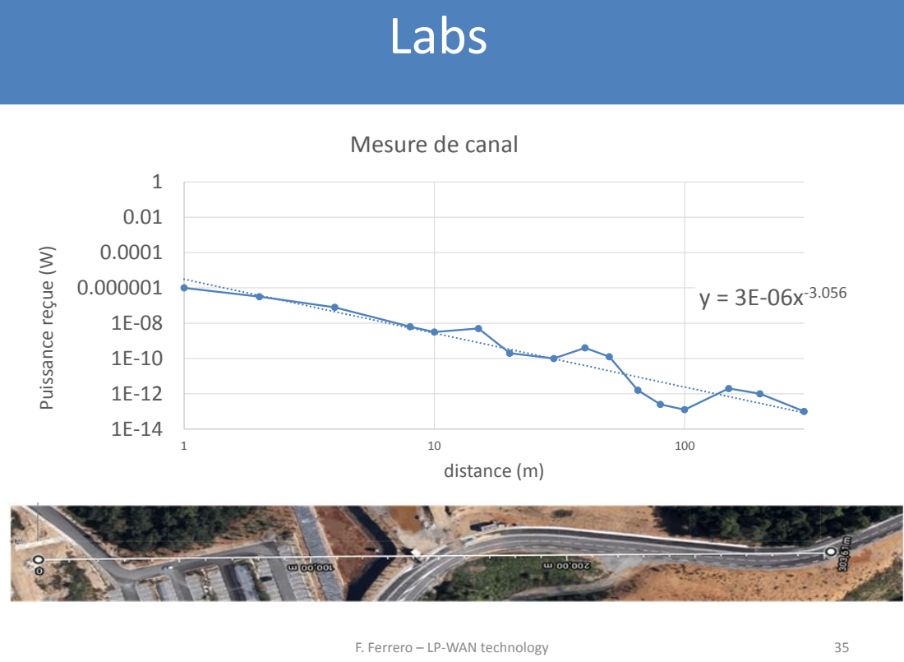
[picture p114: page 35]
F. Ferrero – LP-WAN technology; Puissance reçue (W); distance (m)

Mesure de canal

# Antenna Outline

- Antenna physical key parameters
- Low-cost Antenna Open Source project
F. Ferrero – LP-WAN technology | 36

## Antenna performance indicator

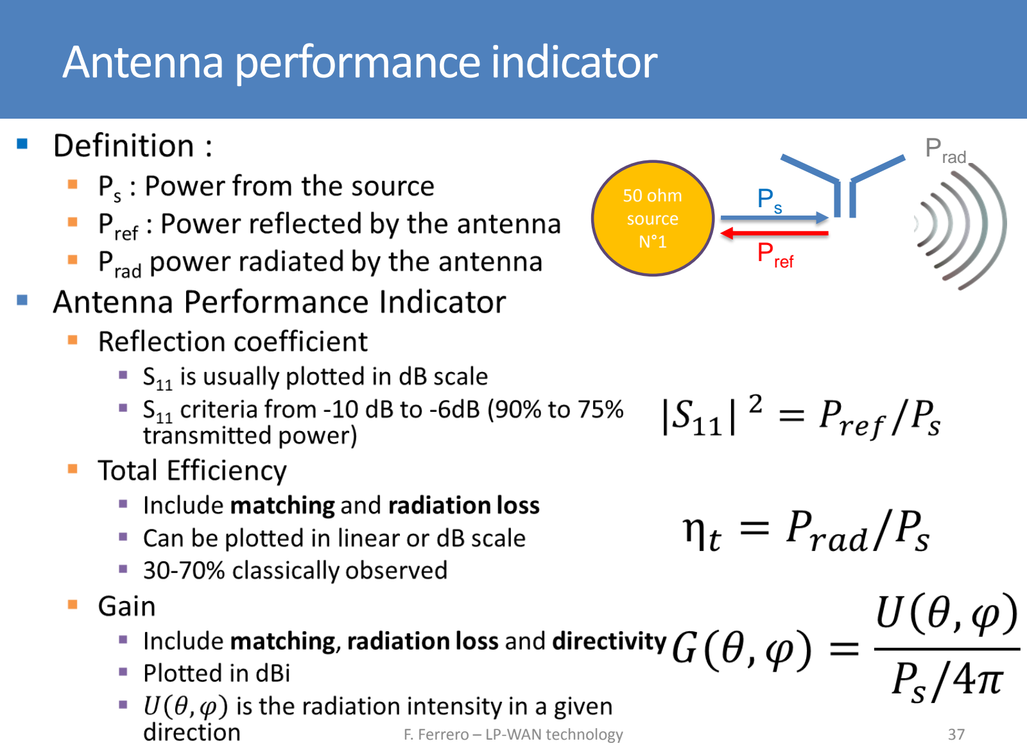
[picture p115: page 37]

50 ohm
source
N°1

Ps

Pref

Prad

37

F. Ferrero – LP-WAN technology

### - Antenna is a resonnant structure :

- Input impedance is changing with frequency
- Limited frequency bandwidth
- Miniature antenna can have a low efficiency due to metallic or dielectric losses

### - Antenna is an open structure

- Compare to electronic components, antenna is strongly influenced by its surrounding environment
- For integrated antenna, the electromagnetic wave is generated by the antenna and by the terminal ground plane

### - Small antenna has to be carefully tuned

Trade-off

Efficiency

Size | Bandwidth

## Antenna key parameters

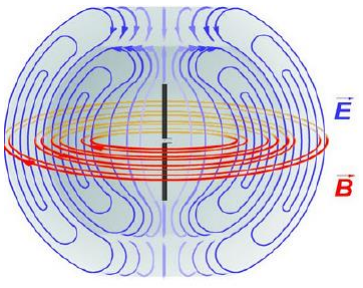
[picture p116: figure]

F. Ferrero – LP-WAN technology | 38

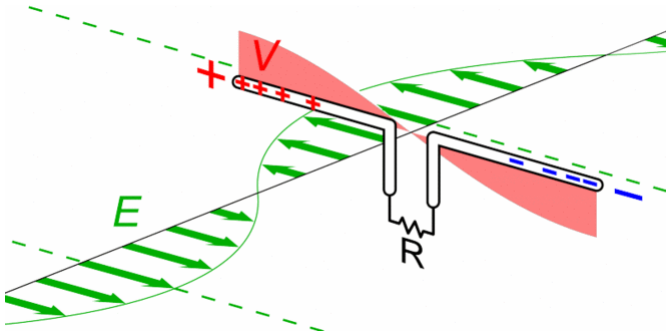
[picture p117: figure]

### - Antennas can be:

- Dual-pole : 2 parts will

## Effect of terminal chassis

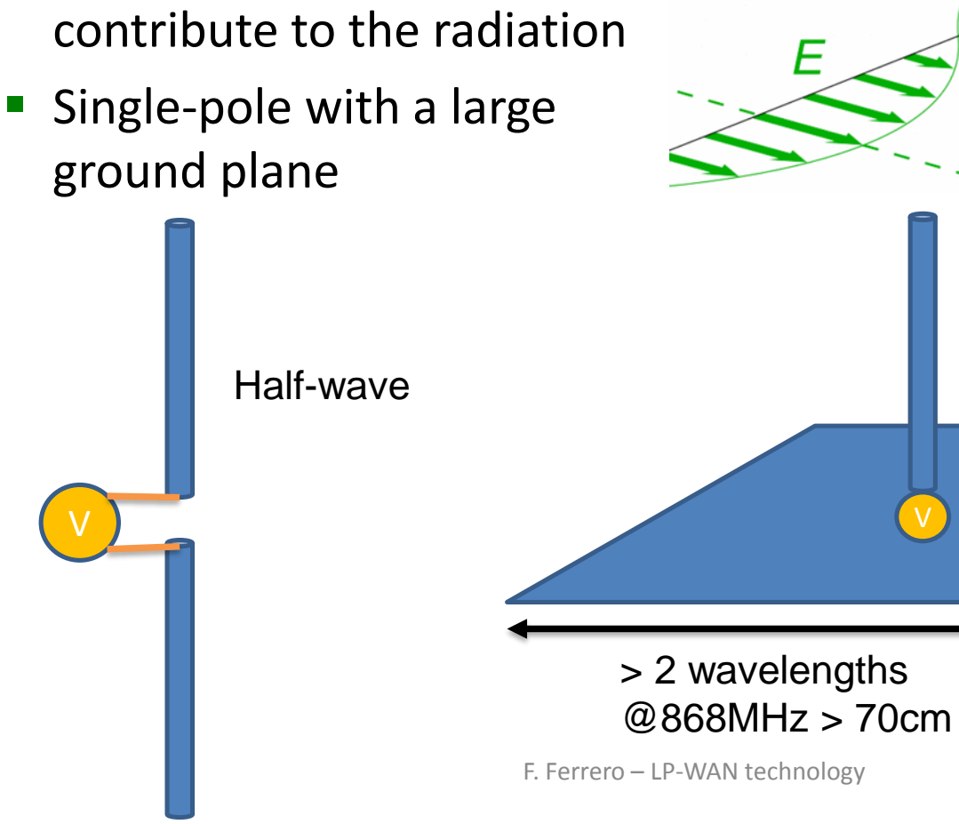
[picture p118: figure]
contribute to the radiation ▪ Single-pole with a large ground plane; Half-wave; > 2 wavelengths @868MHz > 70cm
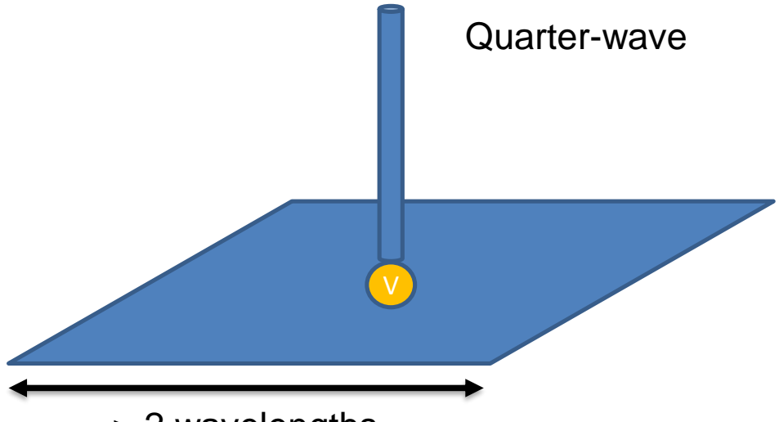
[picture p119: figure]
Quarter-wave

F. Ferrero – LP-WAN technology | 39

## - In most of the case, you will have a dual-pole antenna

## Effect of terminal chassis

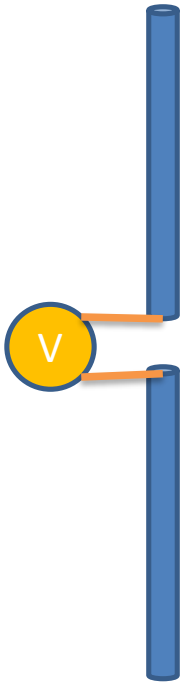
[picture p120: figure]

Half-wave

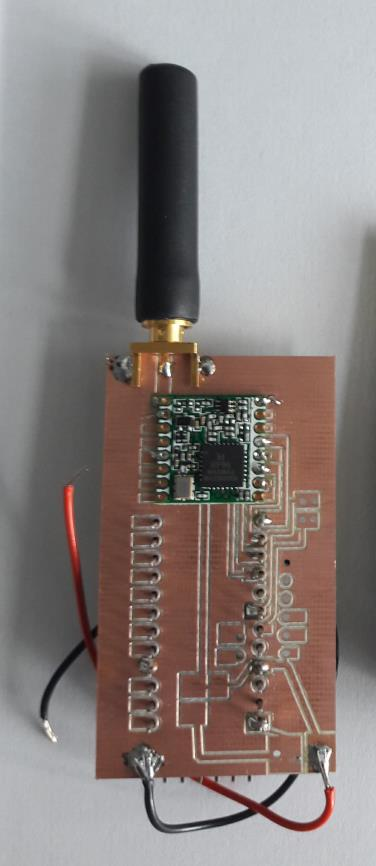
[picture p121: figure]
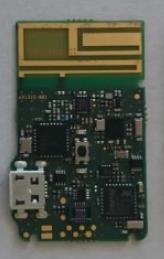
[picture p122: figure]

F. Ferrero – LP-WAN technology | 40

## - LoRa (868MHz) and GPS (1575MHz) antenna on small terminal

## Effect of terminal chassis

41

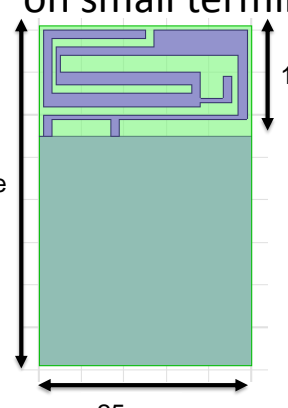
[picture p123: figure]

Device
size

25mm

11mm

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
20 | 30 | 40 | 50 | 60 | 70 | 80

Total Efficiency (dB)

Device Size (mm)

LoRa

GPS

F. Ferrero – LP-WAN technology

## Effect of the environment

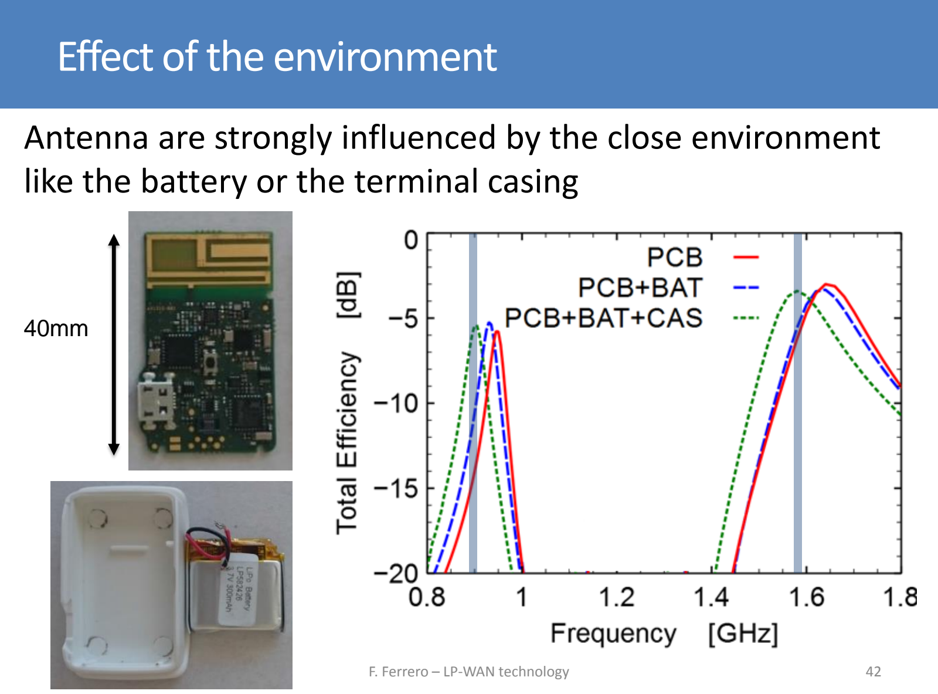
[picture p124: page 42]

### Antenna are strongly influenced by the close environment like the battery or the terminal casing

42

40mm

F. Ferrero – LP-WAN technology

## Effect of the environment

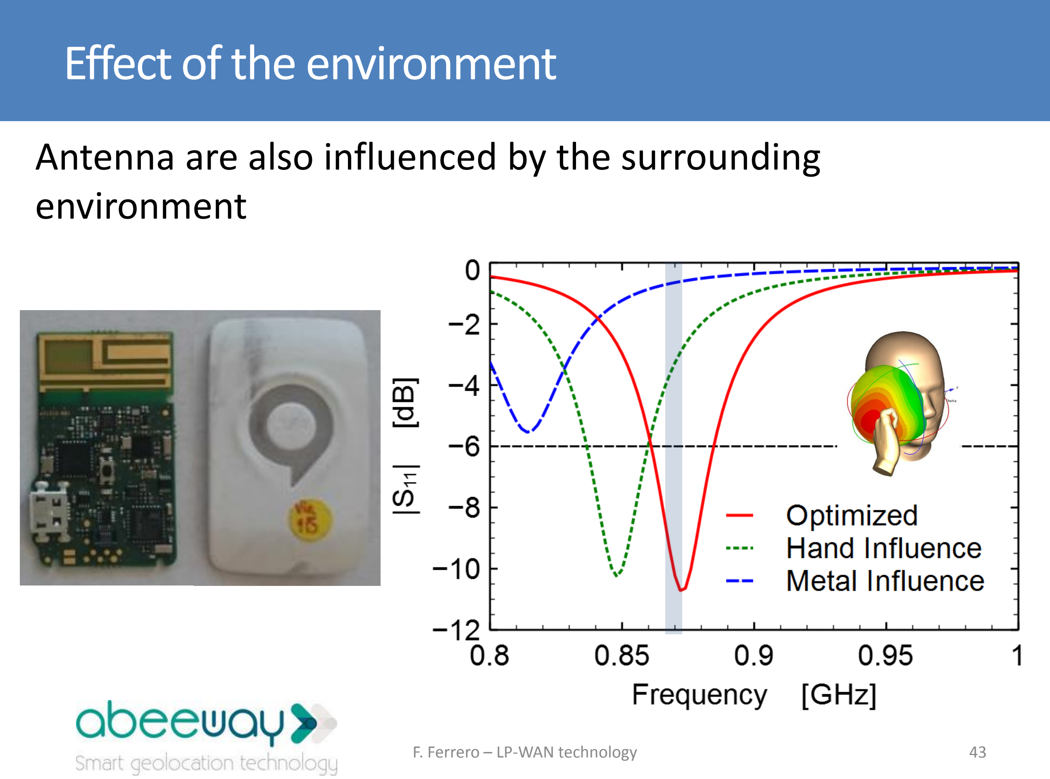
[picture p125: page 43]

### Antenna are also influenced by the surrounding environment

F. Ferrero – LP-WAN technology | 43

## Antenna measurement

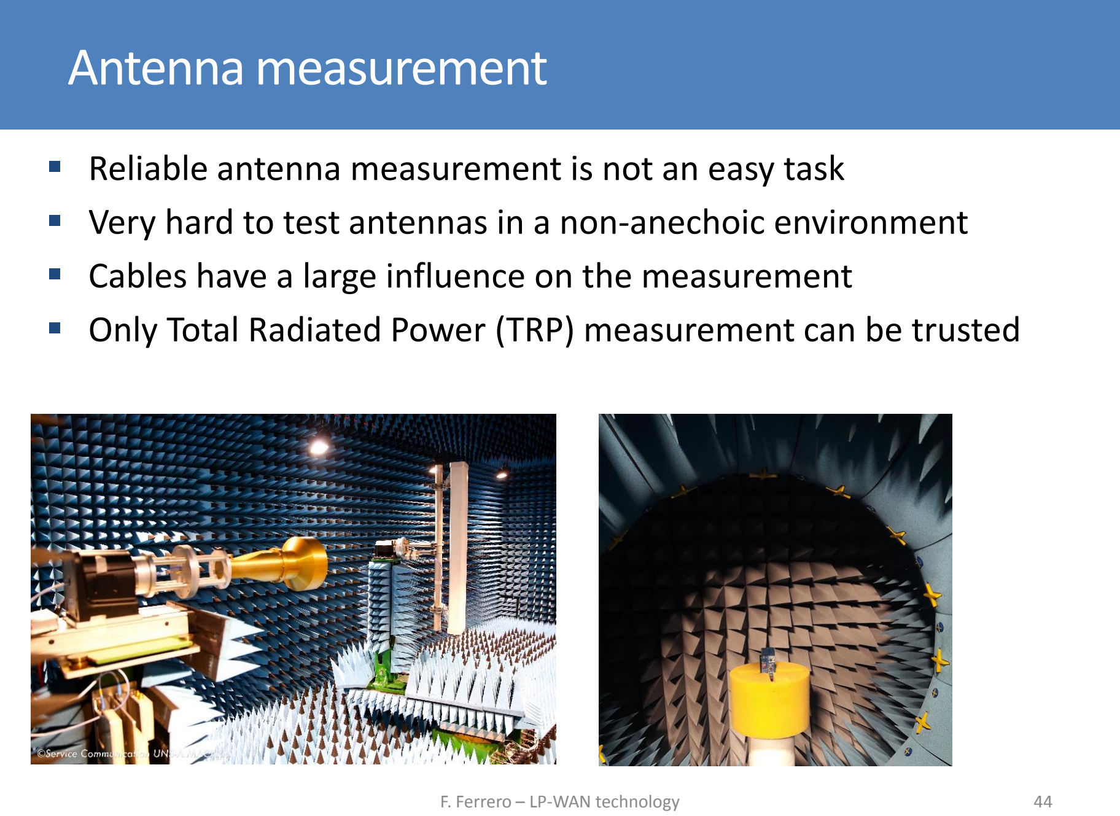
[picture p126: page 44]

- Reliable antenna measurement is not an easy task
- Very hard to test antennas in a non-anechoic environment
- Cables have a large influence on the measurement
- Only Total Radiated Power (TRP) measurement can be trusted
F. Ferrero – LP-WAN technology | 44

# Antenna Outline

- Antenna key parameters
- Low-cost Antenna Open Source project
- Micro-tracker Antenna Industrial project
F. Ferrero – LP-WAN technology | 45

# Design of cost efficient antenna @868MHz

- LoRa collar for Cattle Rustling applications

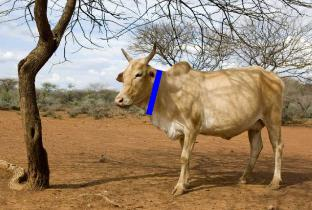
[picture p127: figure]

- Cost reduction
- Remove RF connectors ( a SMA connector is 4$)
- Avoid external antenna (cost between 2 and 8 $)
- A PCB is needed for component integration
- The cost for an extension of the PCB is negligible, so

PCB integrated antenna is very cost efficient

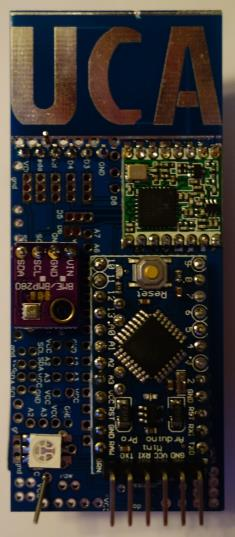
[picture p128: figure]

F. Ferrero – LP-WAN technology | 46

https://github.com/FabienFerrero/UCA_Board

# UCA Antenna layout

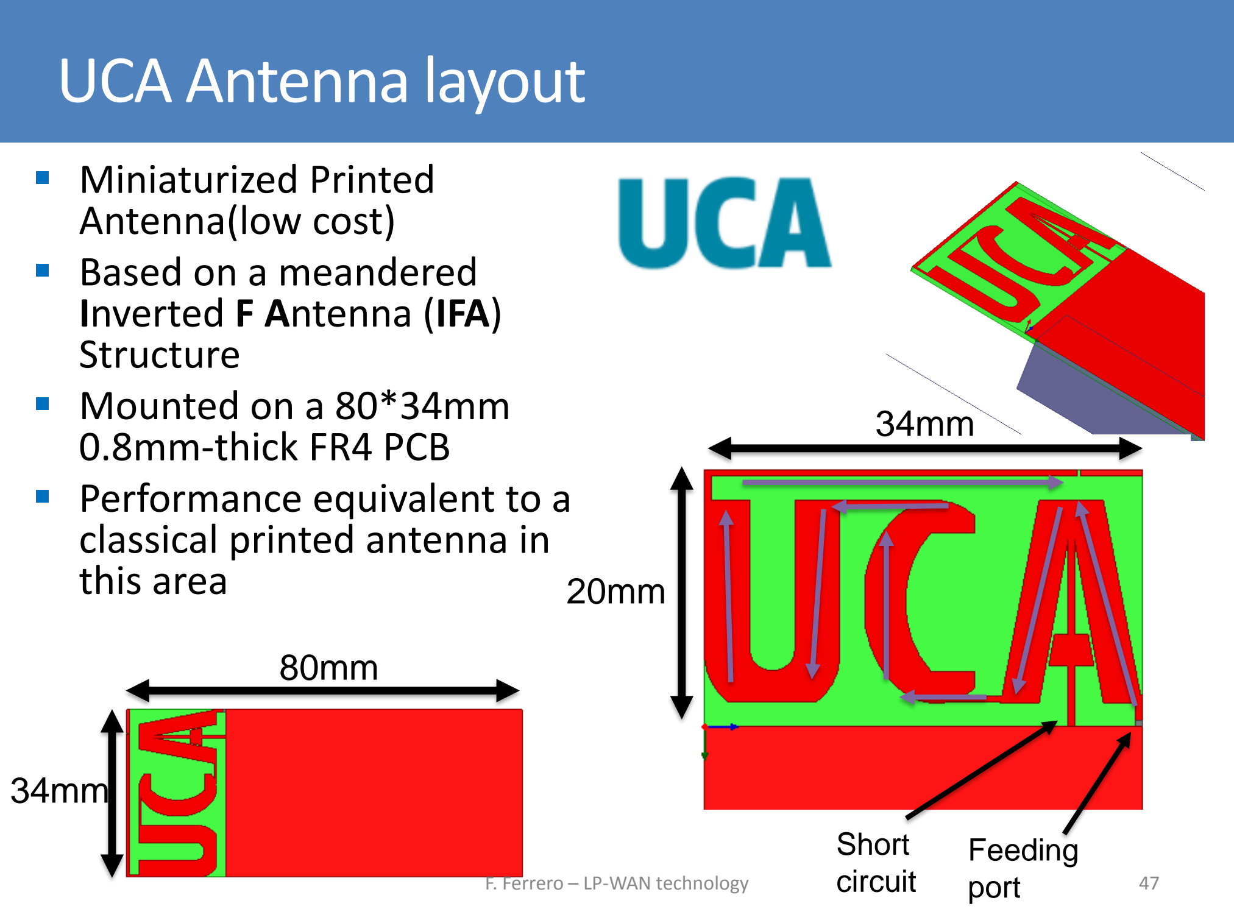
[picture p129: page 47]

- Miniaturized Printed
Antenna(low cost)
- Based on a meandered
Inverted F Antenna (IFA)
Structure
- Mounted on a 80*34mm
0.8mm-thick FR4 PCB
- Performance equivalent to a classical printed antenna in this area

34mm

20mm

34mm

80mm

47

Short
circuit

Feeding

port F. Ferrero – LP-WAN technology

### - Antenna simulation

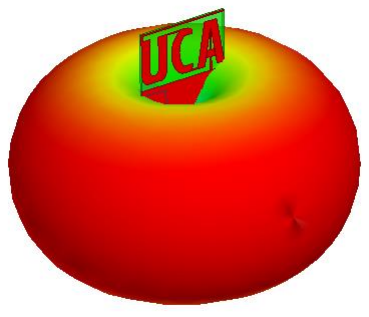
[picture p130: figure]

### - Matched to 50 ohm

### - Bw = 30MHz (@-6dB )

### - -1.2 dB radiation efficiency

(75%)

### - Dipole radiation pattern

### - 2.1 dBi peak directivity

### - 0.9 dBi peak Gain

48

# UCA Antenna tuned for EU band

F. Ferrero – LP-WAN technology

# UCA Antenna tuned for EU band

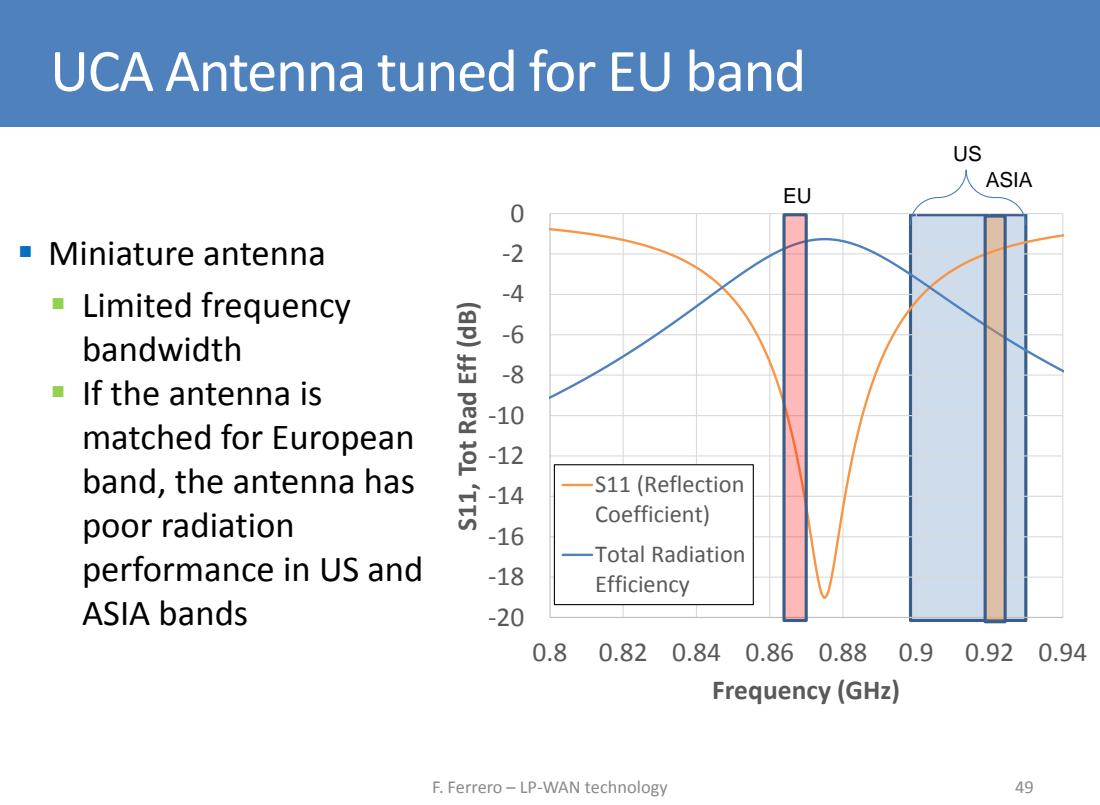
[picture p131: page 49]
ASIA bands; 0.8 0.82 0.84 0.86 0.88 0.9 0.92 0.94 Frequency (GHz); ASIA

▪ Miniature antenna
▪ Limited frequency
bandwidth
▪ If the antenna is
matched for European
band, the antenna has
poor radiation
performance in US and

S11, Tot Rad Eff (dB)

S11 (Reflection
Coefficient)
Total Radiation
Efficiency

F. Ferrero – LP-WAN technology

- The antenna shape can be easily tuned to different frequencies
- The top line can be cut at different position to change the antenna trace length
- T_ant parameter can be tuned from 0 to 34mm
- Antenna resonance frequency can be tuned from 845 to
950MHz

Small cut in the top
line

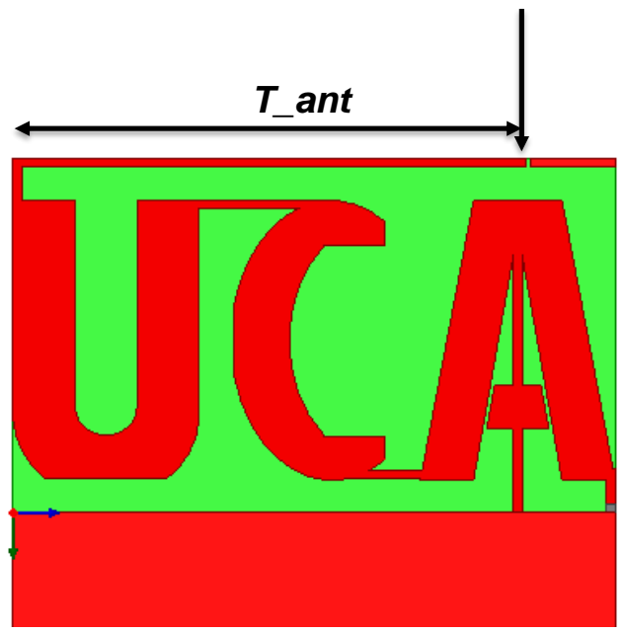
[picture p132: figure]
T_ant

50

# Antenna design

F. Ferrero – LP-WAN technology

## UCA Antenna tuning : Reflection coefficient

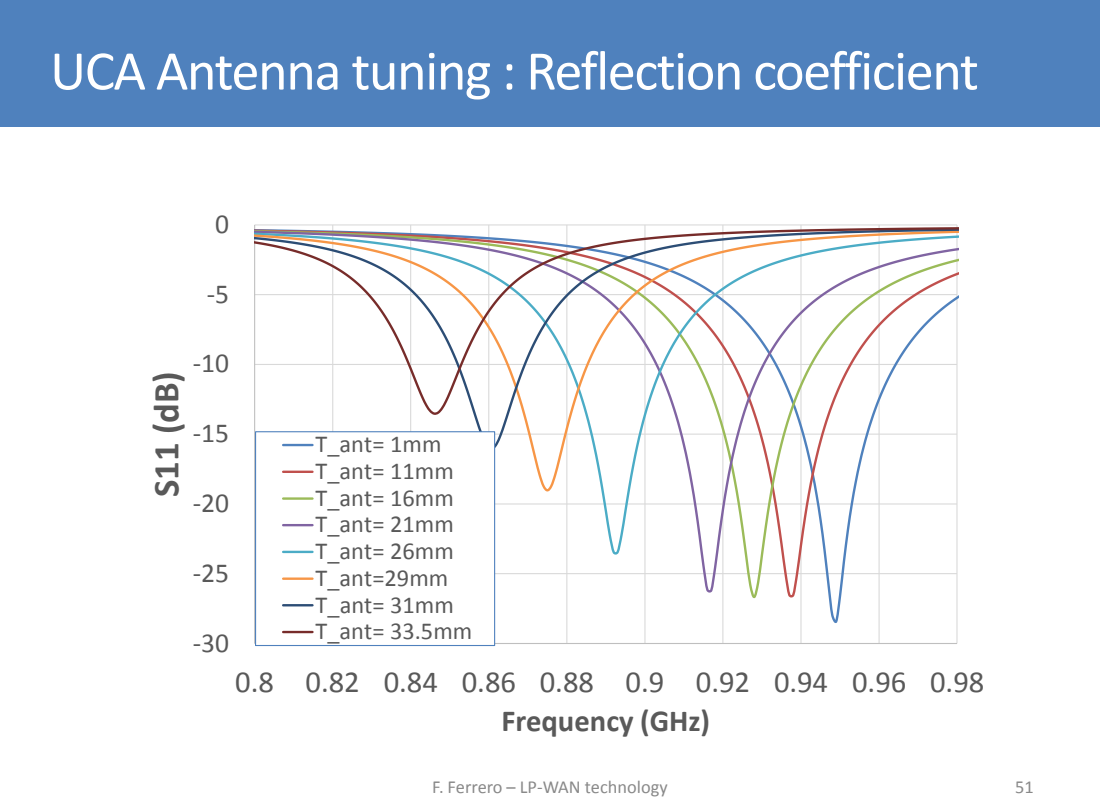
[picture p133: page 51]
Frequency (GHz)

T_ant= 1mm T_ant= 11mm T_ant= 16mm

T_ant= 21mm T_ant= 26mm

T_ant=29mm T_ant= 31mm T_ant= 33.5mm

F. Ferrero – LP-WAN technology

# UCA Antenna : Linear Total Rad. Efficiency

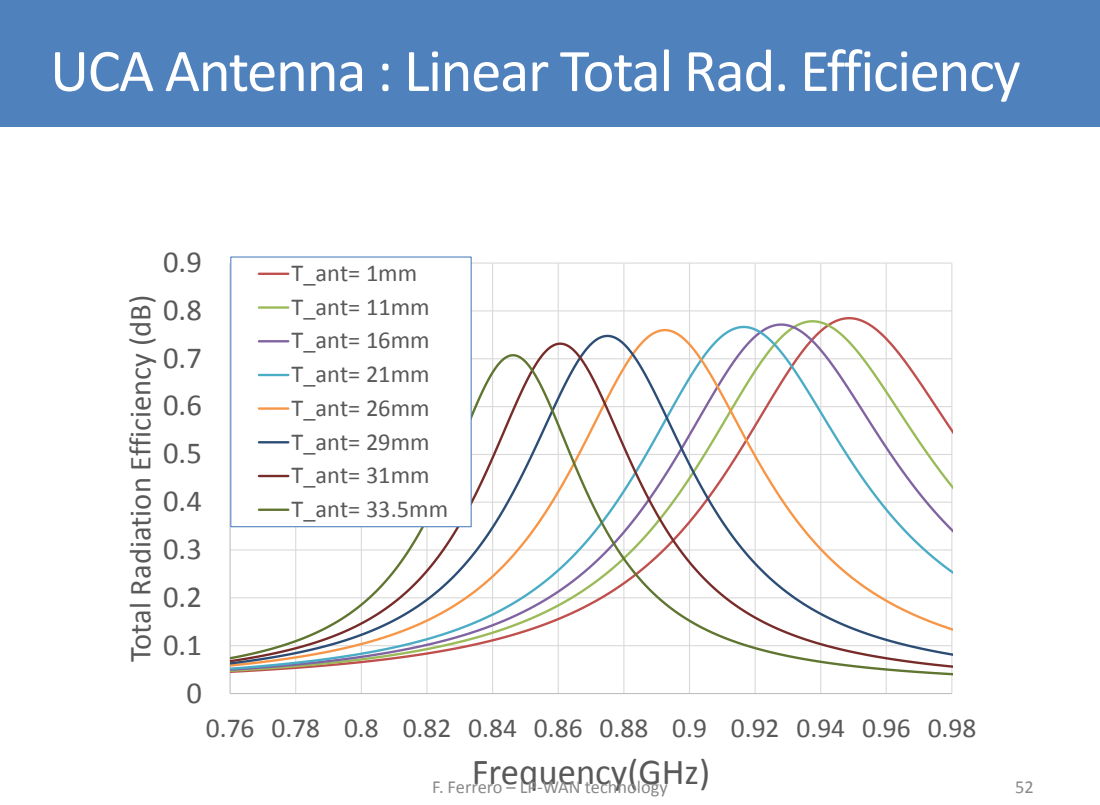
[picture p134: page 52]

T_ant= 1mm T_ant= 11mm

Total Radiation Efficiency (dB)

T_ant= 16mm
T_ant= 21mm T_ant= 26mm

T_ant= 29mm
T_ant= 31mm
T_ant= 33.5mm

Frequency(GHz)
F. Ferrero – LP-WAN technology

# II. Physical layer (LoRa modulation)

- Spread Spreading technique
- Chirp Spread Spectrum
- LoRa Spreading factor
F. Ferrero – LP-WAN technology | 53

## LoRa modulation

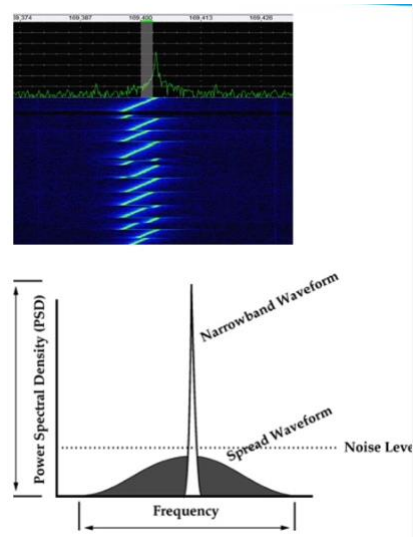
[picture p135: figure]

F. Ferrero – LP-WAN technology | 54

Spread spectrum technique :

Increase communication distance by increasing energy per bit :
- Increase transmit power
- Lower modulation rate

3 types of spread spectrum technique :
- FHSS : Freq Hopping (used in Bluetooth)
- DSSS : Direct Sequence (UMTS and Zigbee)
- CCS : Chirp Spread Spectrum (LoRa)

Robust to interference, multipath and fading

## CSS : Chirp Spread Spectrum

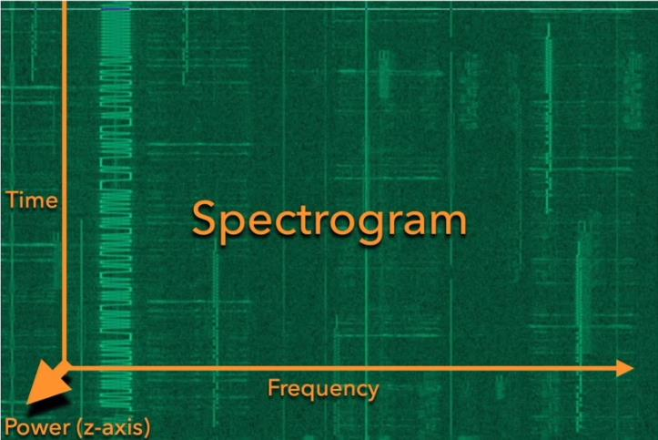
[picture p136: figure]

F. Ferrero – LP-WAN technology | 55

## CSS : Chirp Spread Spectrum

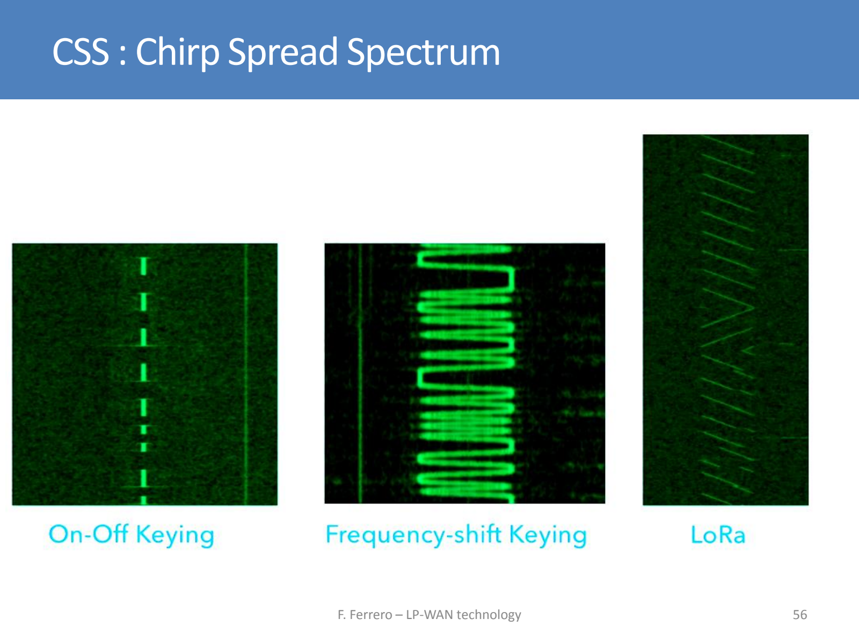
[picture p137: page 56]

F. Ferrero – LP-WAN technology | 56

## LoRa Chirp Spread Spectrum (CSS)

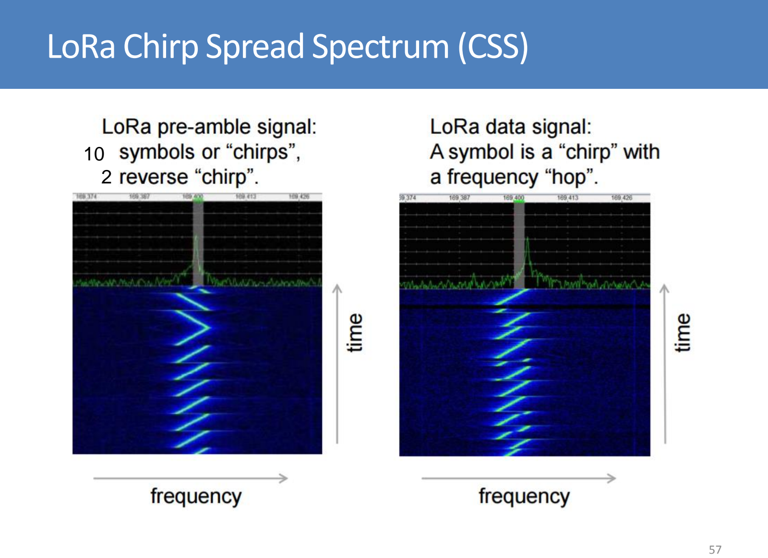
[picture p138: page 57]

57

2

10

## LoRa Chirp Spread Spectrum (CSS)

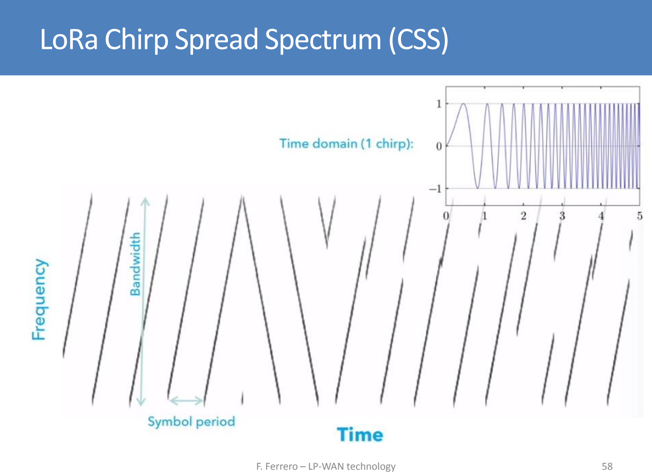
[picture p139: page 58]

F. Ferrero – LP-WAN technology | 58

## LoRa Bit rate

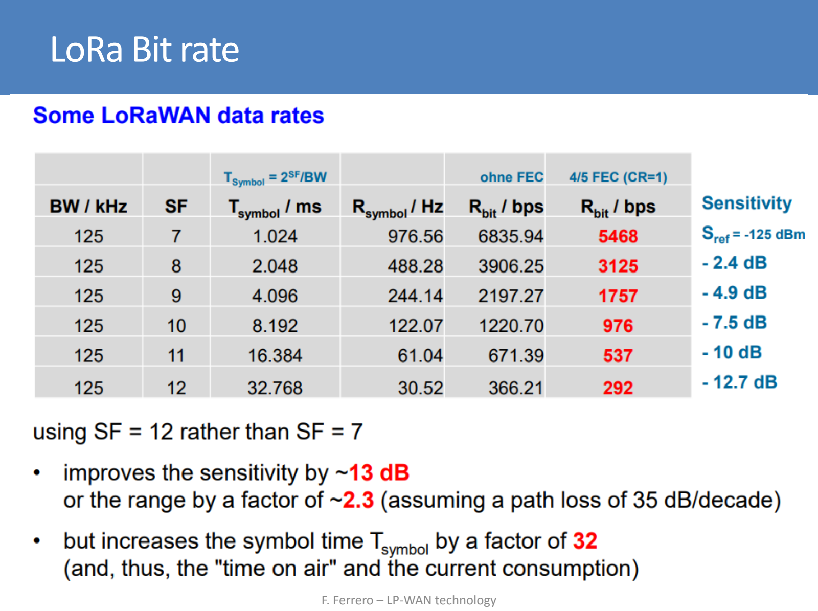
[picture p140: page 59]

59
F. Ferrero – LP-WAN technology

## LoRa CSS modulation

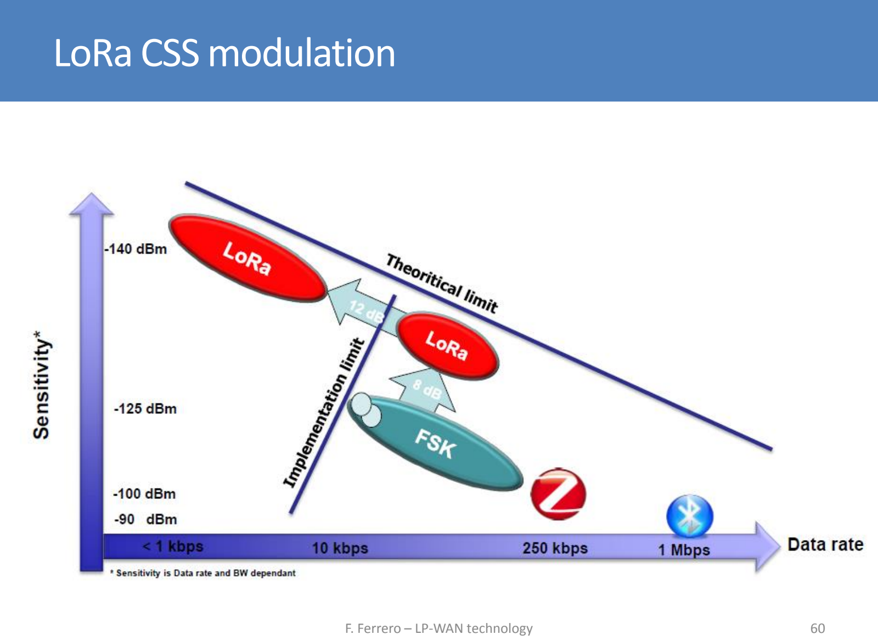
[picture p141: page 60]

F. Ferrero – LP-WAN technology | 60

## LoRa Modulation : Synthesis

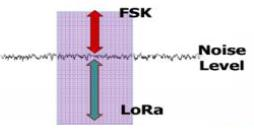
[picture p142: figure]

F. Ferrero – LP-WAN technology | 61

Benefits :

- Simple to implement (Constant enveloppe)
- Bandwidth scalable
- Very resistant to in-band and out-of band interferences
- High immunity to multi path and fading
- Doppler shift resitance
- Moving devices
- High clock tolerances
- Orthogonal with other non-LoRa communications (OFDM, narrowband FSK…)
- Orthogonal with LoRa systems using a different Spreading Factor
- Good sensitivity
- Lora reception is simple
