FabienFerrero/UCA_Board/documents/Conferences/DaNang_UCA_04_2018.pdf

## Laboratory of Electronics Antennas and Telecommunications

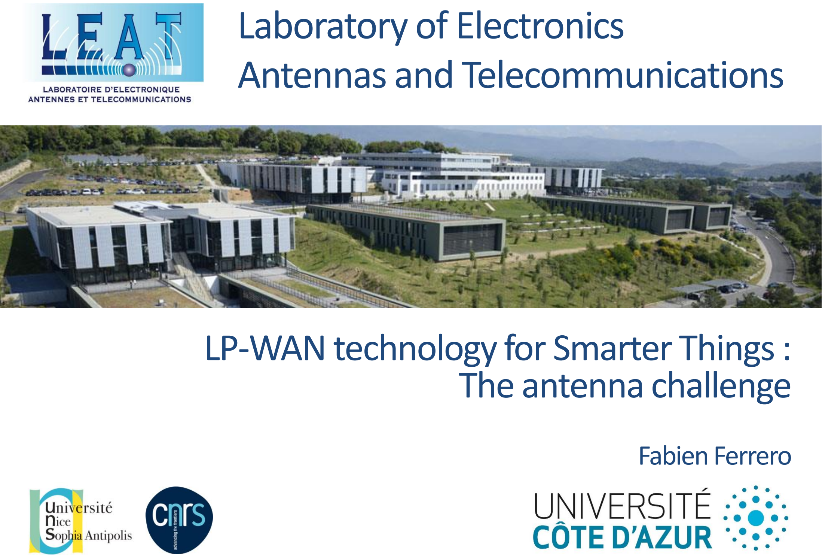
[picture p143: page 1]

## LP-WANtechnology for Smarter Things : The antenna challenge

Fabien Ferrero

## Outline

- LP-WAN Motivation
- Why antenna is important ? A practical example
- Antenna key parameters
- Low-cost Antenna Open Source project
- Micro-tracker Antenna Industrial project
- Da Nang/UCA : research perspectives
- Next Smart Campus Campaign

## IoT opportunities : Potential market

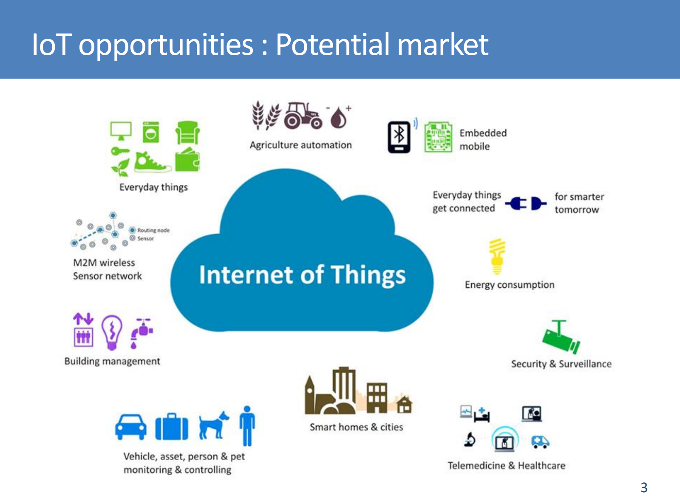
[picture p144: page 3]

## IoT opportunities : Potential market

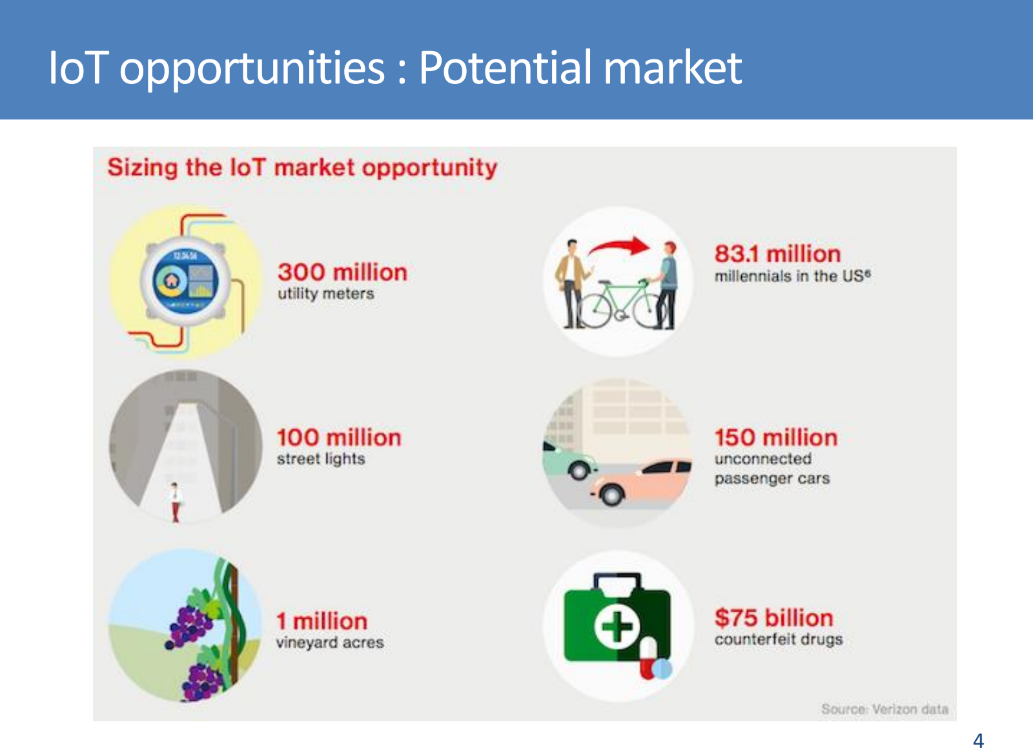
[picture p145: page 4]

## IoT opportunities : Potential market

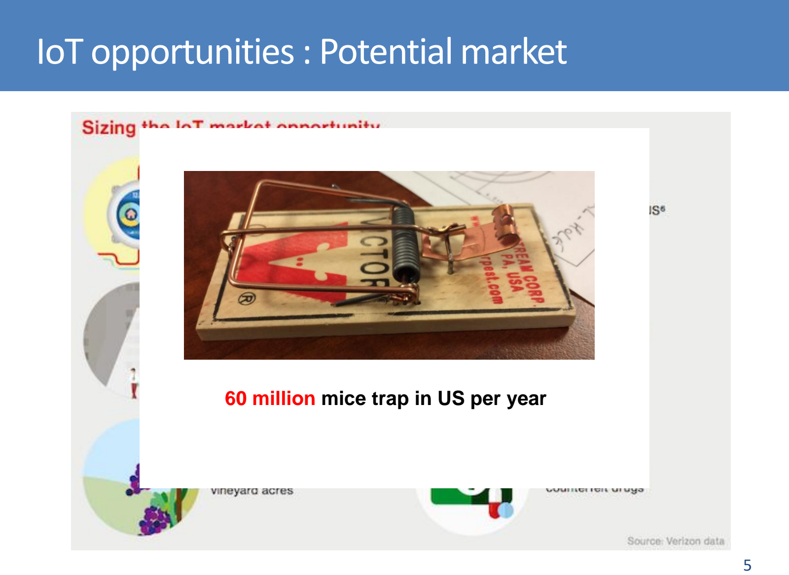
[picture p146: page 5]

### 60 million mice trap in US per year

## LP-WAN to improve energy and water access

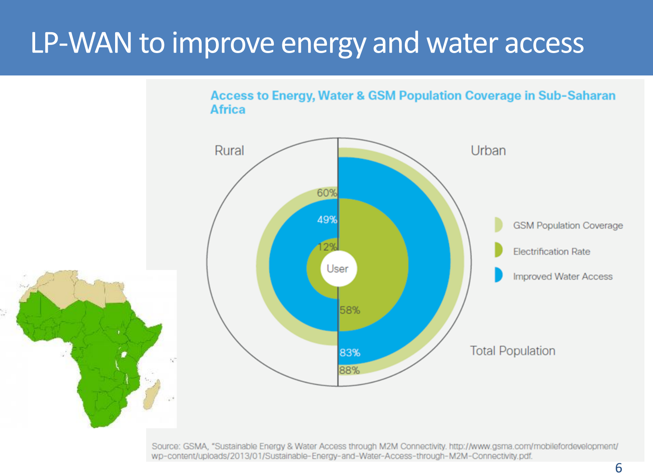
[picture p147: page 6]

## IoT opportunities : Hype cycle

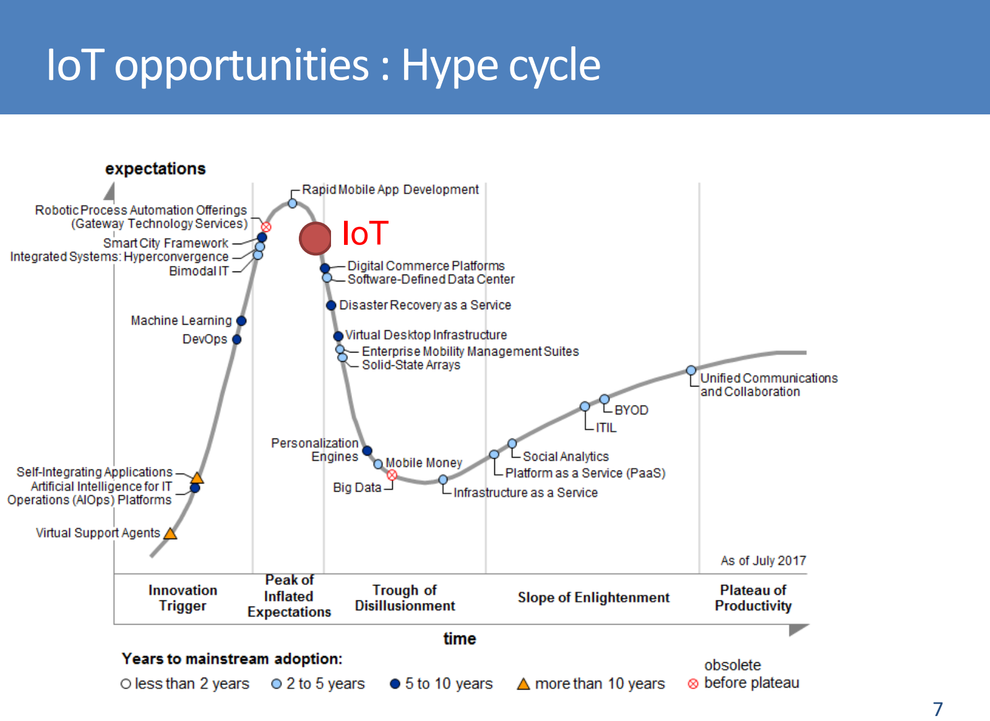
[picture p148: page 7]

IoT

## LP-WAN technologies opportunities

LP-WAN provides
new capabilities :

Low-power and long
communication
range

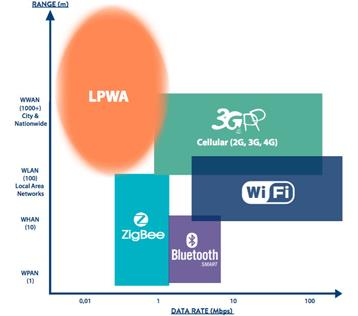
[picture p149: figure]

Power | 1mW | 10mW | 100mW

## LP-WAN technologies opportunities

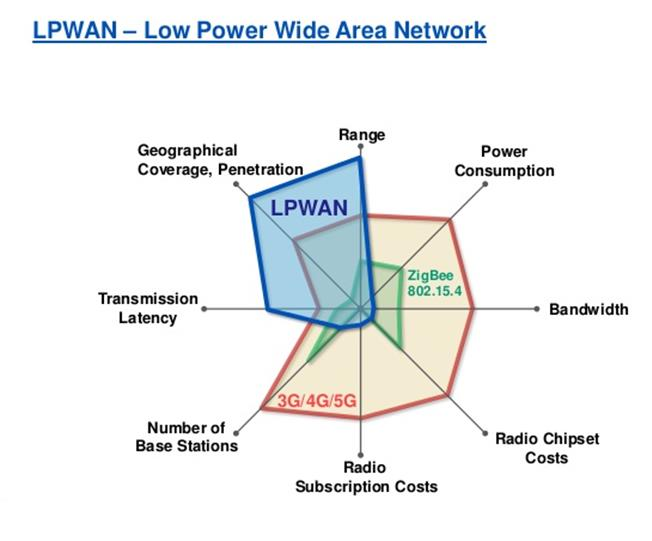
[picture p150: figure]

## LP-WAN ISM bands

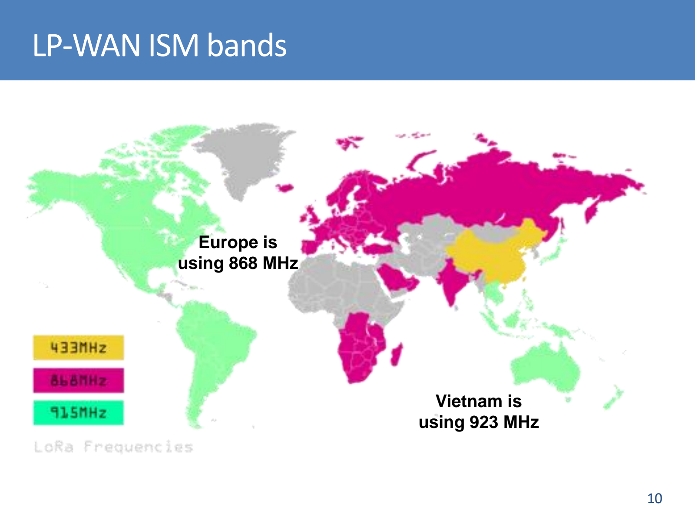
[picture p151: page 10]

Europe is
using 868 MHz

Vietnam is
using 923 MHz

## LP-WAN technologies comparison

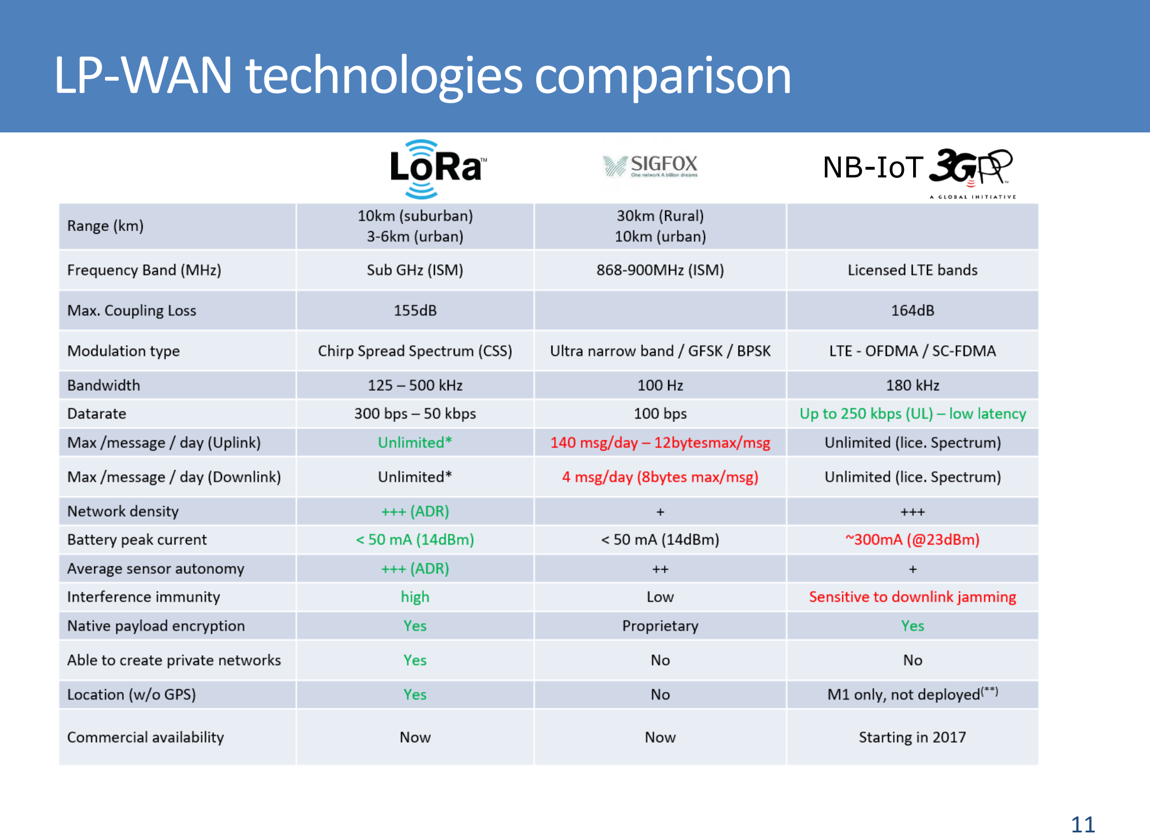
[picture p152: page 11]

NB-IoT

## LP-WAN network

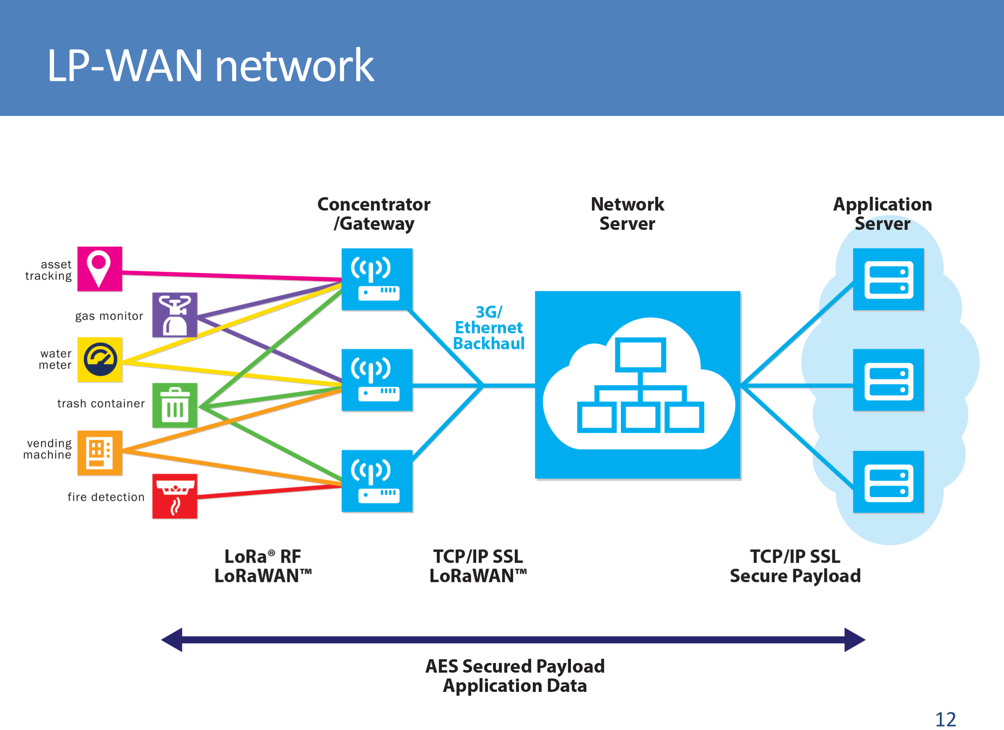
[picture p153: page 12]

## Outline

- LP-WAN Motivation
- Why antenna is important ? A practical example
- Antenna key parameters
- Low-cost Antenna Open Source project
- Micro-tracker Antenna Industrial project
- Da Nang/UCA : research perspectives
- Conclusion and perspectives

## Antenna isimportant for communication range

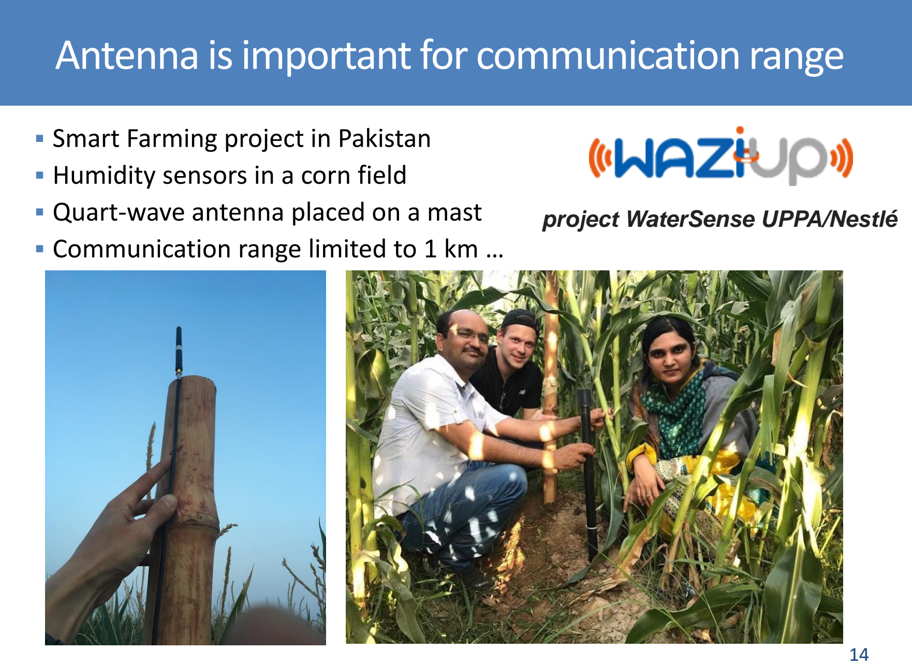
[picture p154: page 14]

- Smart Farming project in Pakistan
- Humidity sensors in a corn field
- Quart-wave antenna placed on a mast
- Communication range limited to 1 km … project WaterSense UPPA/Nestlé

## Antenna isimportant for communication range

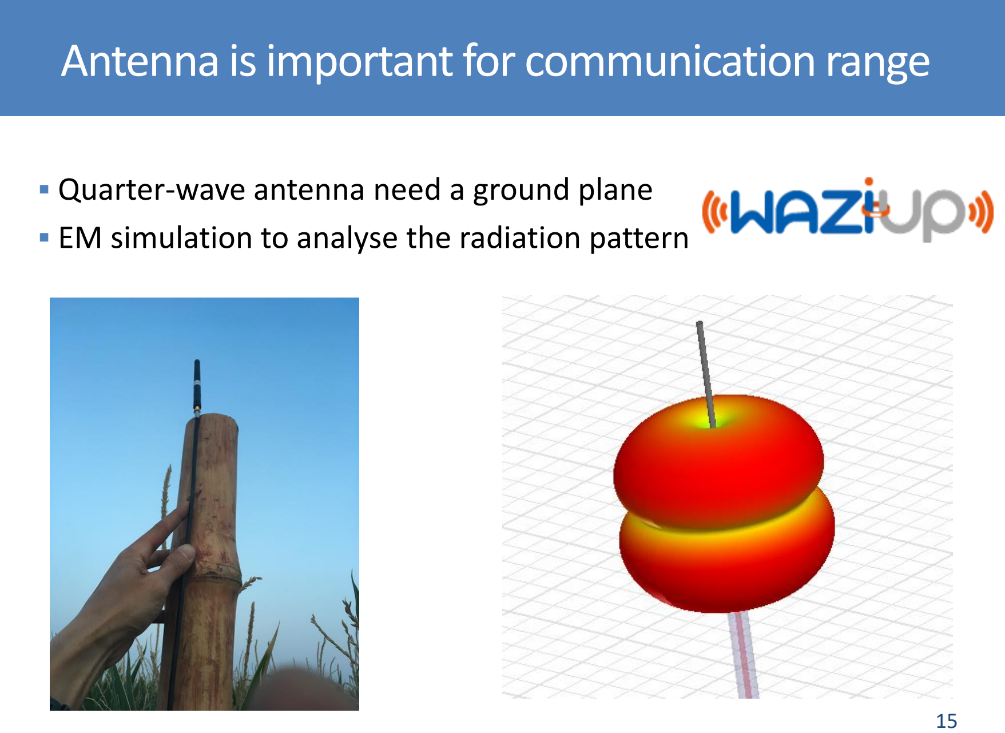
[picture p155: page 15]

- Quarter-wave antenna need a ground plane
- EM simulation to analyse the radiation pattern

## Antenna isimportant for communication range

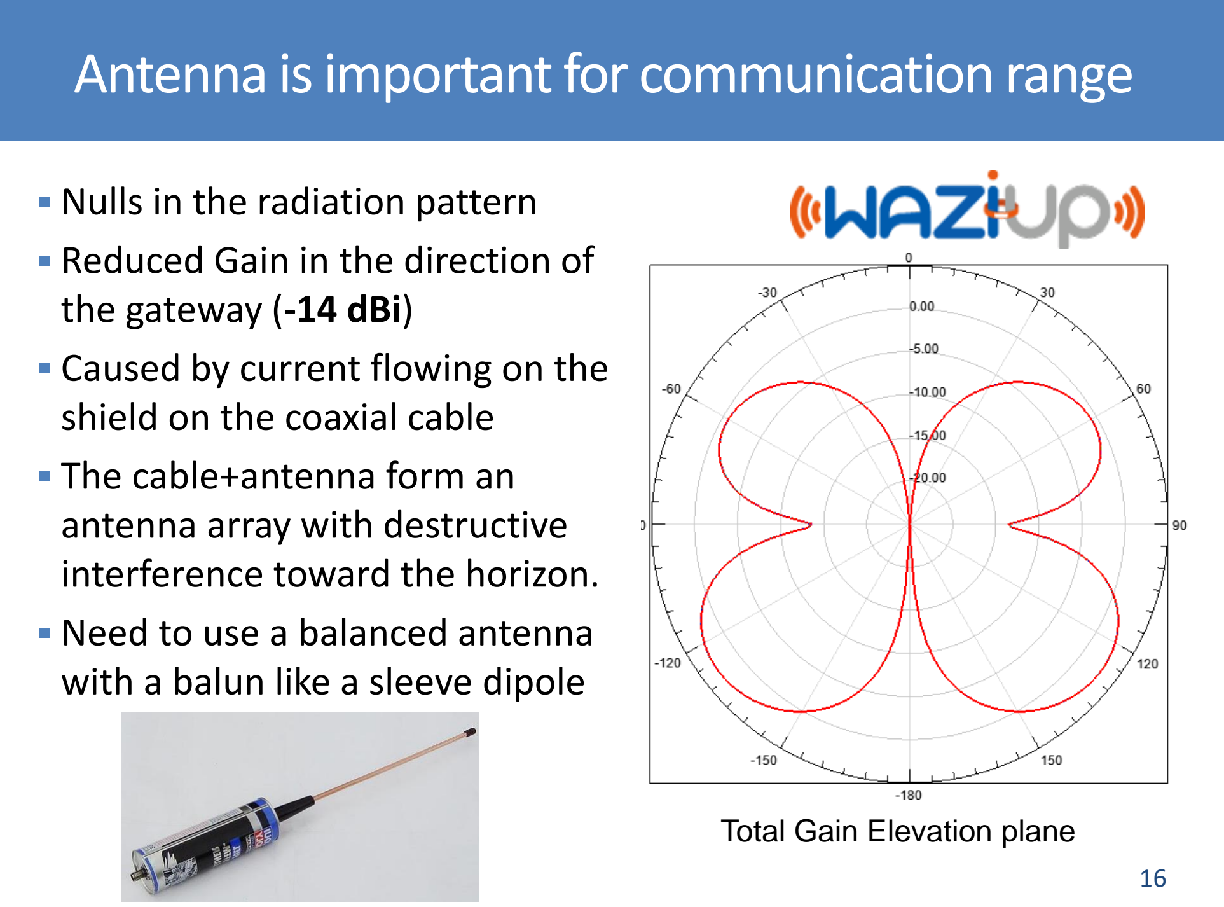
[picture p156: page 16]

- Nulls in the radiation pattern
- Reduced Gain in the direction of the gateway (-14 dBi)
- Caused by current flowing on the shield on the coaxial cable
- The cable+antenna form an antenna array with destructive interference toward the horizon.
- Need to use a balanced antenna with a balun like a sleeve dipole

Total Gain Elevation plane

## Outline

- LP-WAN Motivation
- Why antenna is important ? A practical example
- Antenna key parameters
- Low-cost Antenna Open Source project
- Micro-tracker Antenna Industrial project
- Da Nang/UCA : research perspectives
- Conclusion and perspectives

- Definition :
- Ps

: Power from the source
- Pref : Power reflected by the antenna
- Prad power radiated by the antenna
- Antenna Performance Indicator
- Reflection coefficient
- S11 is usually plotted in dB scale
- S11 criteria from -10 dB to -6dB (90% to 75% transmitted power)
- Total Efficiency
- Include matching and radiation loss
- Can be plotted in linear or dB scale
- 30-70% classically observed
- Gain
- Include matching, radiation loss and directivity
- Plotted in dBi
- U θ,φ is the radiation intensity in a given direction

50 ohm
source
N°1

Ps

Pref

Prad

|S11|

2 = Pref/Ps

ηt = Prad/Ps

## Antenna performance indicator

## G(θ,φ) =

## U θ, φ Ps/4π

### ▪Antenna is a resonnant structure :

- Input impedance is changing with frequency
- Limited frequency bandwidth
- Miniature antenna can have a low efficiency due to metallic or dielectric losses

### ▪Antenna is an open structure

- Compare to electronic components, antenna is strongly influenced by its surrounding environment
- For integrated antenna, the electromagnetic wave is generated by the antenna and by the terminal ground plane
- Small antenna has to be carefully tuned

Trade-off

Efficiency

Size | Bandwidth

## Antenna key parameters

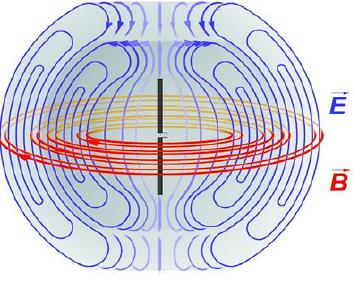
[picture p157: figure]

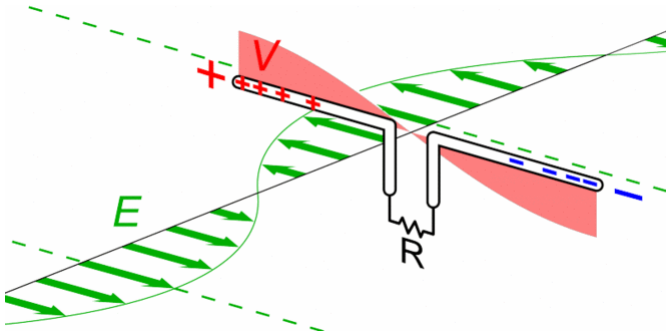
[picture p158: figure]

▪Antennas can be:
- Dual-pole : 2 parts will

## Effect of terminal chassis

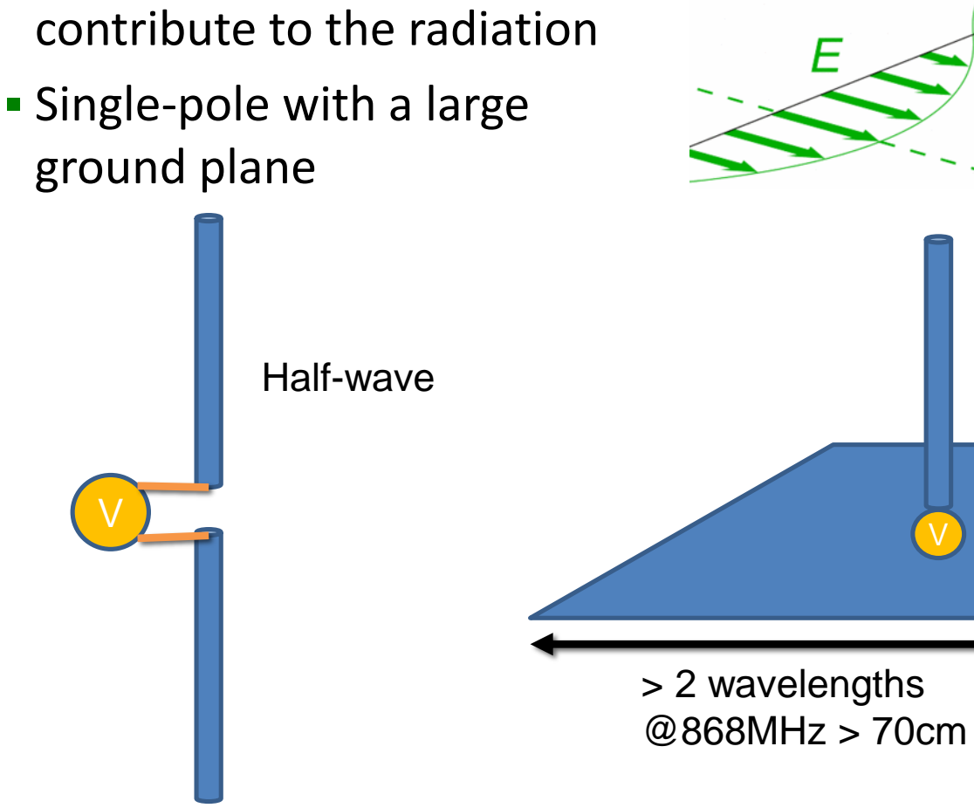
[picture p159: figure]
contribute to the radiation ▪ Single-pole with a large ground plane; Half-wave; > 2 wavelengths @868MHz > 70cm
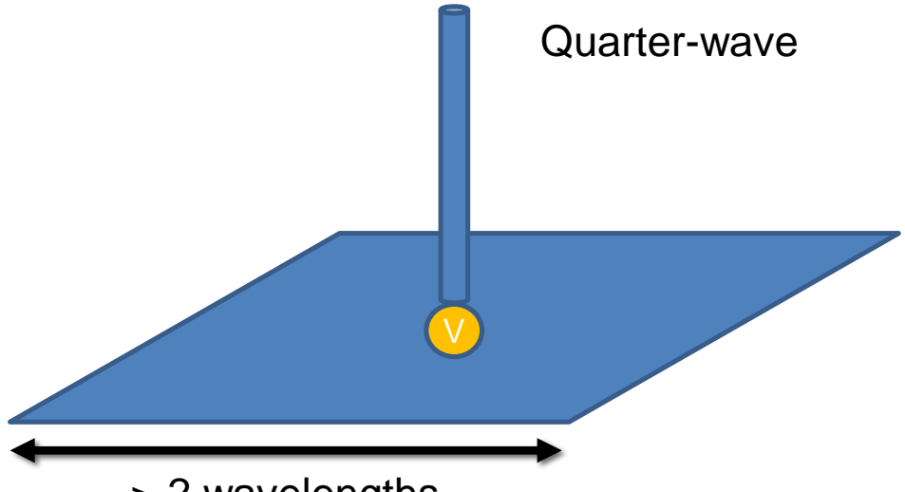
[picture p160: figure]
Quarter-wave

- In most of the case, you will have a dual-pole antenna

## Effect of terminal chassis

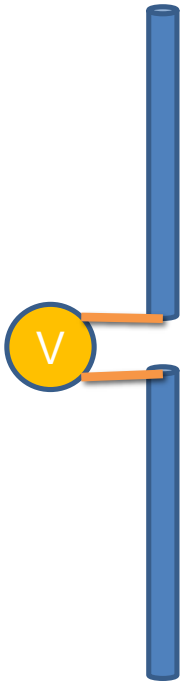
[picture p161: figure]

Half-wave


- LoRa (868MHz) and GPS (1575MHz) antenna on small terminal

## Effect of terminal chassis

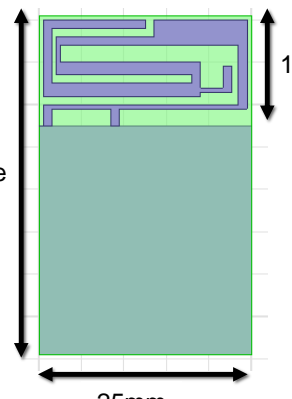
[picture p162: figure]

Device
size

25mm

11mm

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
20 | 30 | 40 | 50 | 60 | 70 | 80

Total Efficiency (dB)

Device Size (mm)

LoRa

GPS

## Effect of the environment

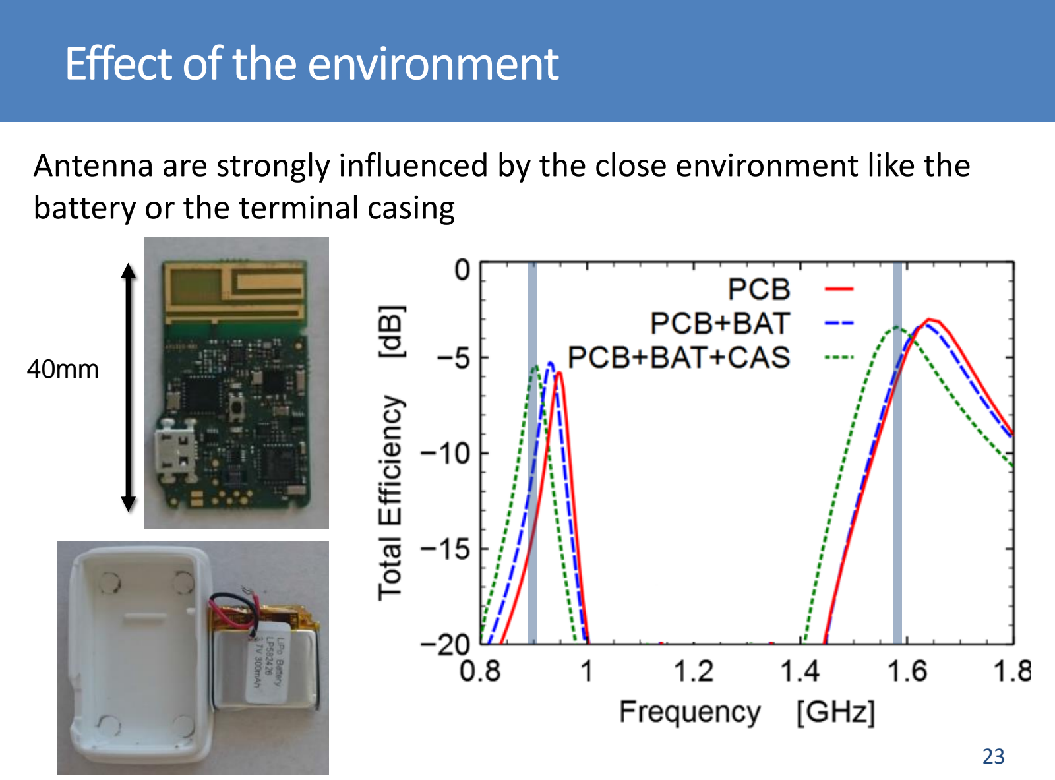
[picture p163: page 23]

Antenna are strongly influenced by the close environment like the battery or the terminal casing

40mm

## Effect of the environment

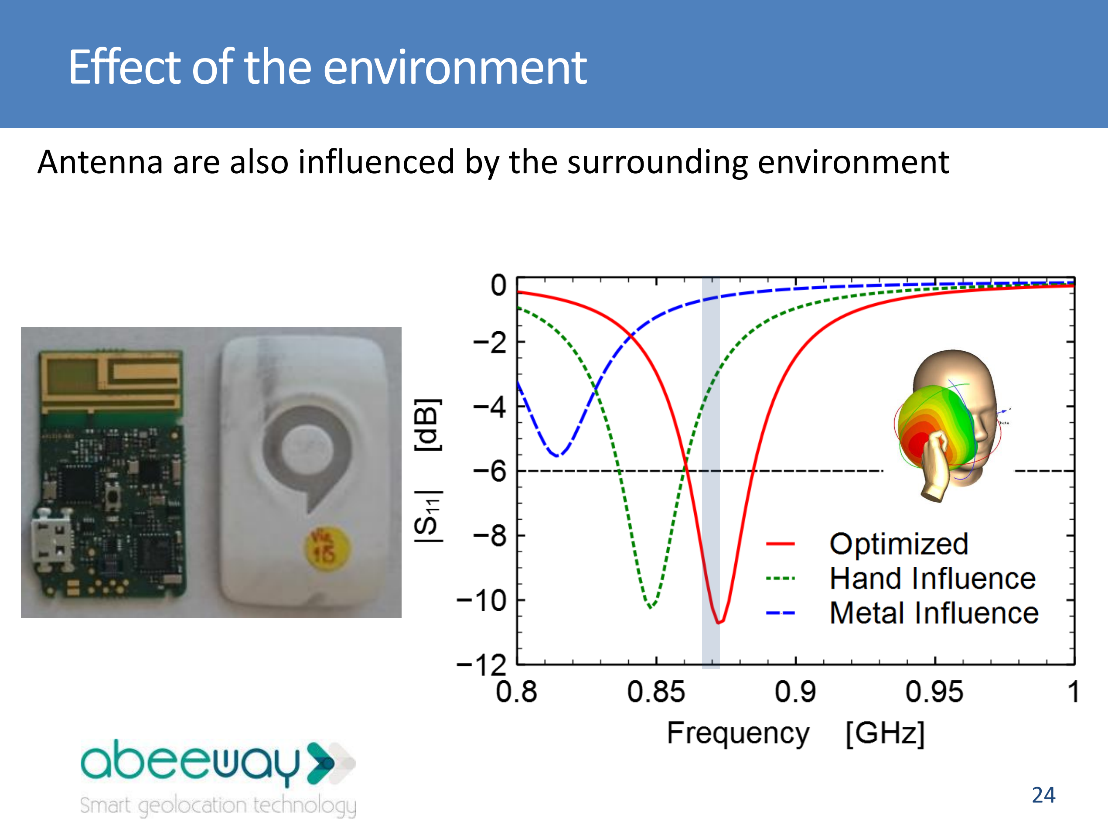
[picture p164: page 24]

Antenna are also influenced by the surrounding environment

## Antenna measurement

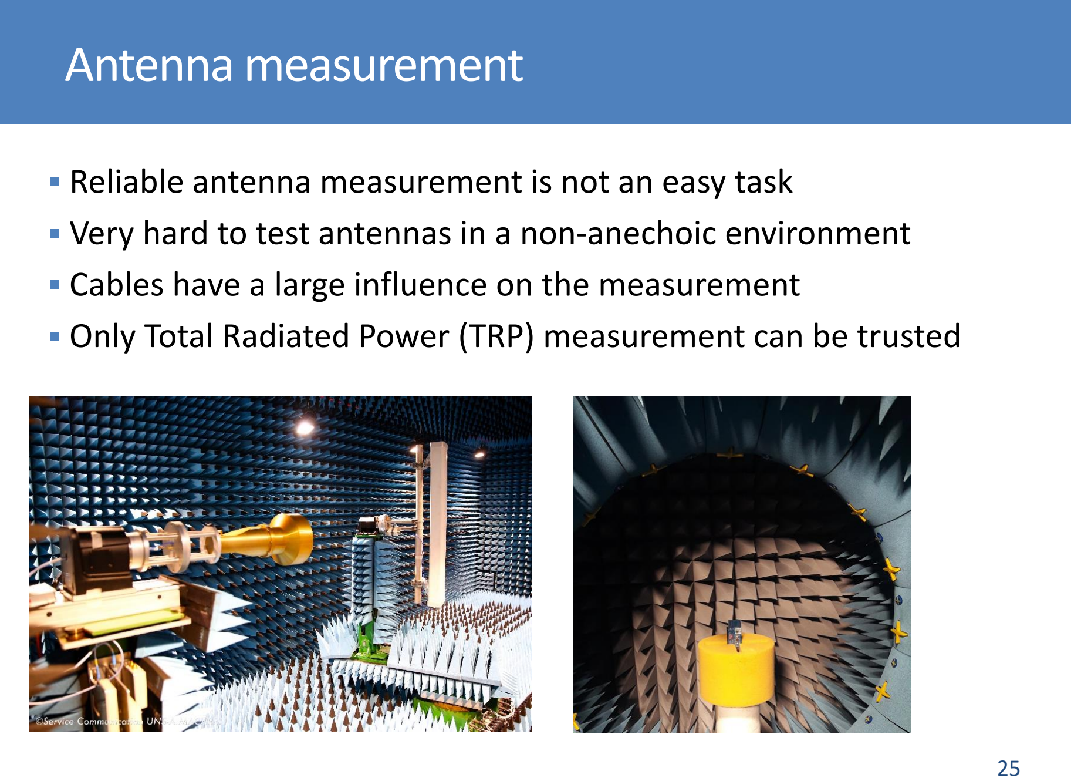
[picture p165: page 25]

- Reliable antenna measurement is not an easy task
- Very hard to test antennas in a non-anechoic environment
- Cables have a large influence on the measurement
- Only Total Radiated Power (TRP) measurement can be trusted

## Outline

- LP-WAN Motivation
- Why antenna is important ? A practical example
- Antenna key parameters
- Low-cost Antenna Open Source project
- Micro-tracker Antenna Industrial project
- Da Nang/UCA : research perspectives
- Conclusion and perspectives

## Design of cost efficient antenna @868MHz

- LoRa collar for Cattle Rustling applications


- Cost reduction
- Remove RF connectors ( a SMA connector is 4$)
- Avoid external antenna (cost between 2 and 8 $)
- A PCB is needed for component integration
- The cost for an extension of the PCB is negligible, so

PCB integrated antenna is very cost efficient

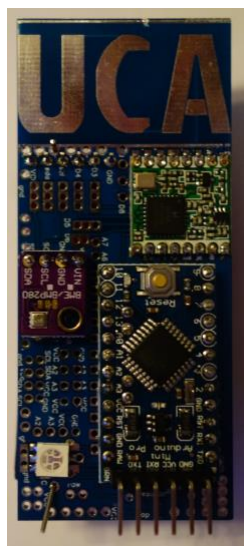
[picture p166: figure]

## UCA Antenna layout

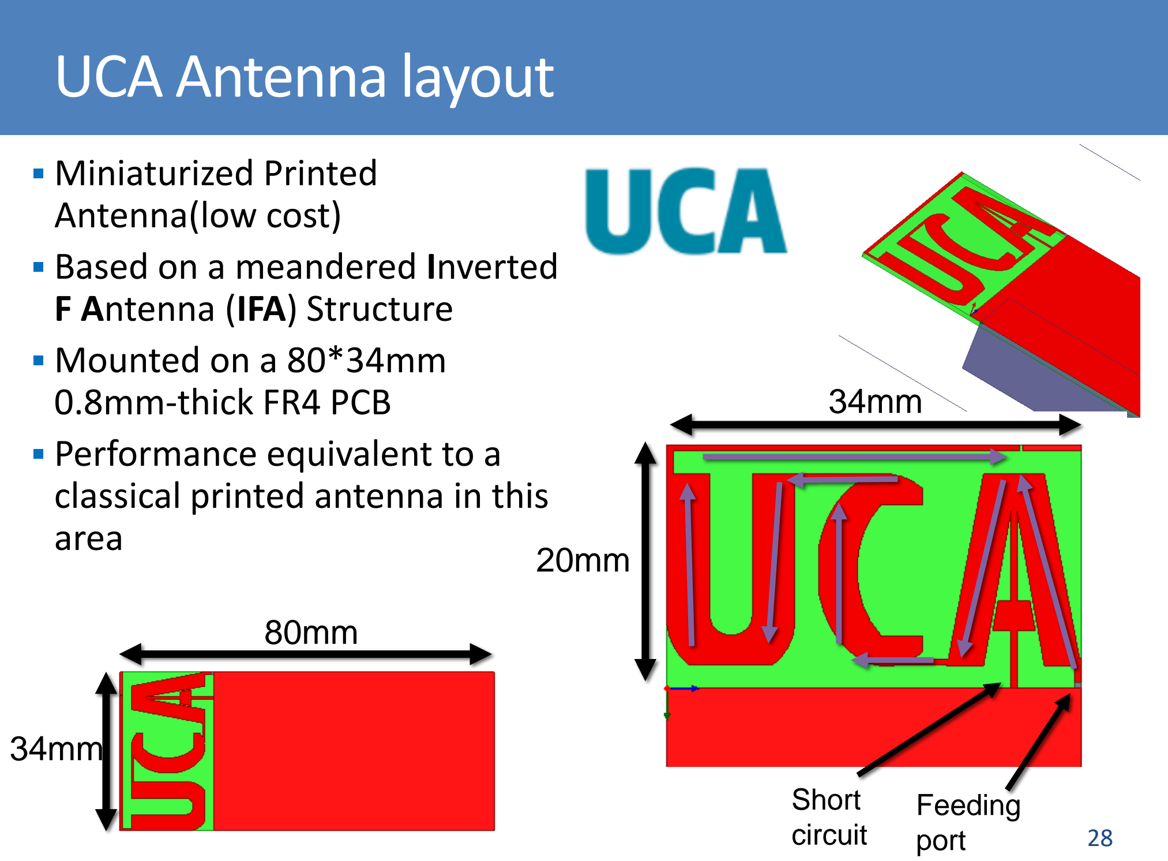
[picture p167: page 28]

- Miniaturized Printed
Antenna(low cost)
- Based on a meandered Inverted F Antenna (IFA) Structure
- Mounted on a 80*34mm
0.8mm-thick FR4 PCB
- Performance equivalent to a classical printed antenna in this area

34mm

20mm

34mm

80mm

Short
circuit

Feeding
port

- Antenna simulation


- Matched to 50 ohm
- Bw = 30MHz (@-6dB )
- -1.2 dB radiation efficiency

(75%)

- Dipole radiation pattern
- 2.1 dBi peak directivity
- 0.9 dBi peak Gain

## UCA Antenna tuned for EU band

## UCA Antenna tuned for EU band

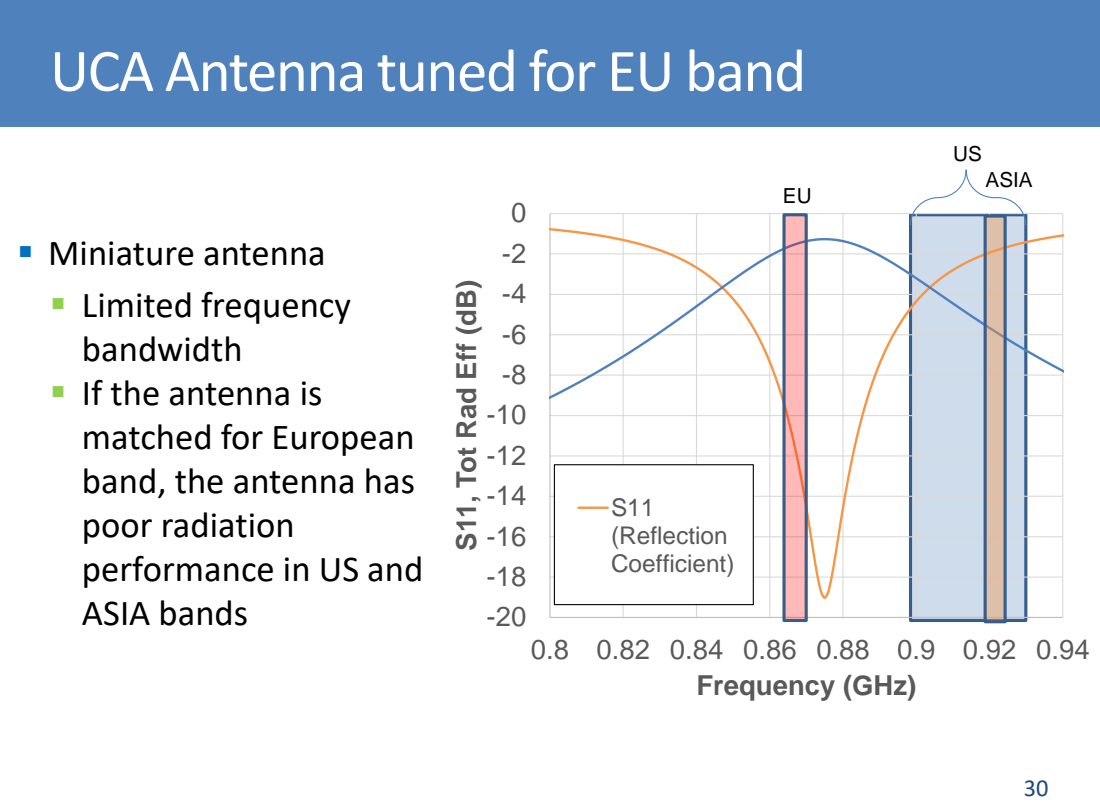
[picture p168: page 30]
ASIA bands; 0.8 0.82 0.84 0.86 0.88 0.9 0.92 0.94 Frequency (GHz); ASIA

▪ Miniature antenna
▪ Limited frequency
bandwidth
▪ If the antenna is
matched for European
band, the antenna has
poor radiation
performance in US and

S11, Tot Rad Eff (dB)

S11 (Reflection

Coefficient)

- The antenna shape can be easily tuned to different frequencies
- The top line can be cut at different position to change the antenna trace length
- T_ant parameter can be tuned from 0 to 34mm
- Antenna resonance frequency can be tuned from 845 to
950MHz

Small cut in the top
line

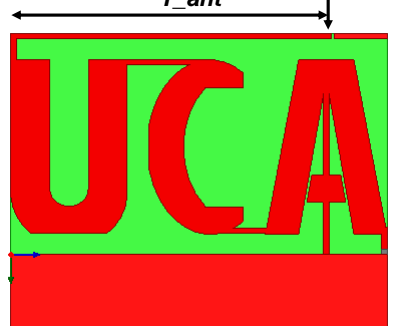
[picture p169: figure]

T_ant

## Antenna design

## UCA Antenna tuning : Reflection coefficient

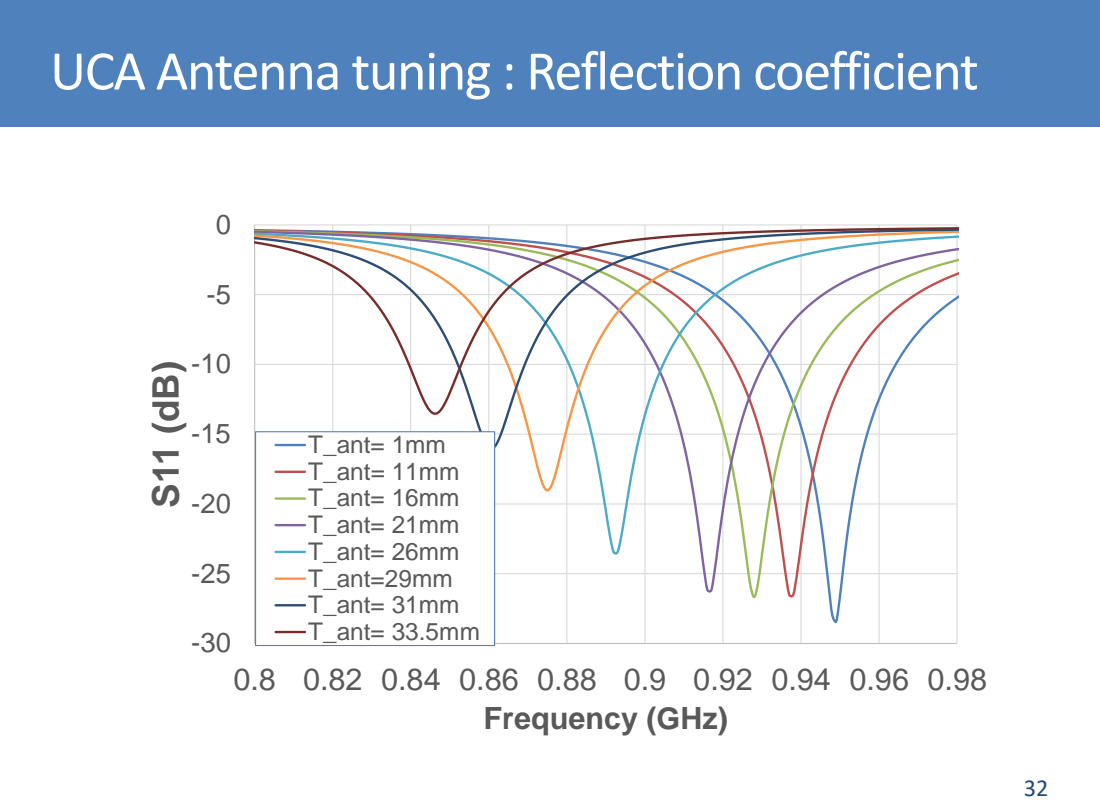
[picture p170: page 32]
Frequency (GHz)

T_ant= 1mm T_ant= 11mm T_ant= 16mm

T_ant= 21mm T_ant= 26mm

T_ant=29mm T_ant= 31mm T_ant= 33.5mm

## UCA Antenna : Linear Total Rad. Efficiency

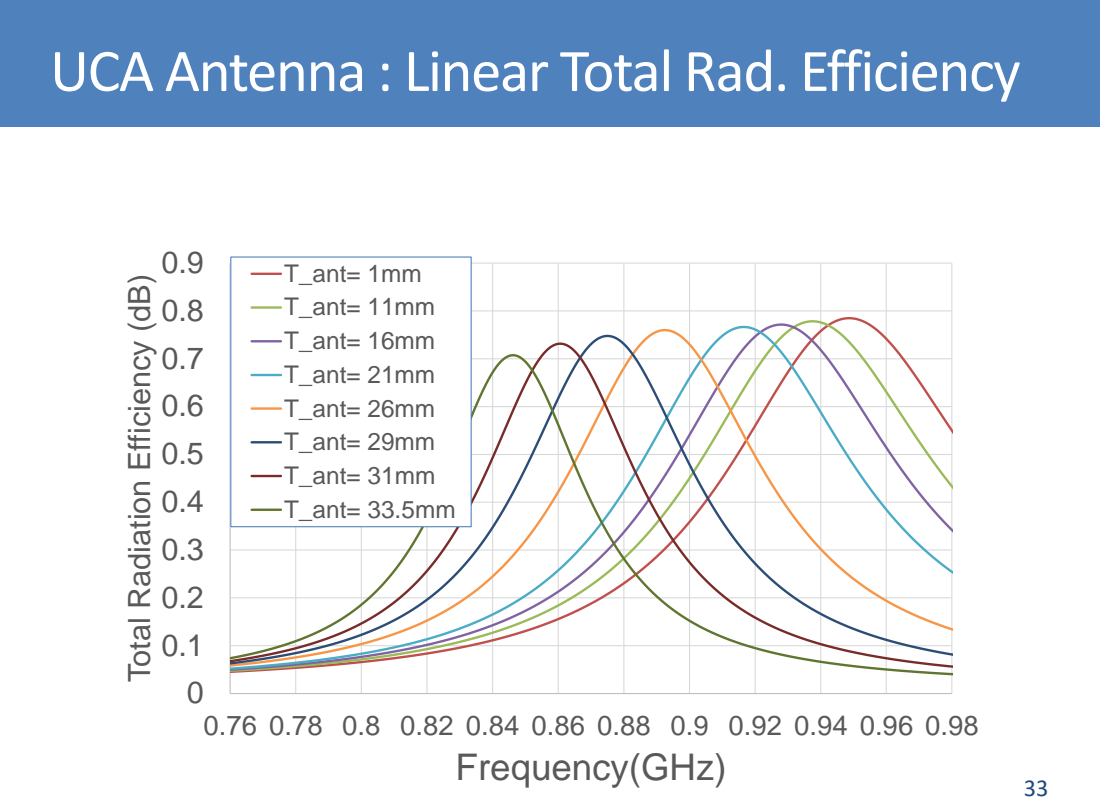
[picture p171: page 33]
0.76 0.78 0.8 0.82 0.84 0.86 0.88 0.9 0.92 0.94 0.96 0.98 Frequency(GHz)

Total Radiation Efficiency (dB)

T_ant= 1mm T_ant= 11mm

T_ant= 16mm
T_ant= 21mm
T_ant= 26mm T_ant= 29mm

T_ant= 31mm
T_ant= 33.5mm

## Comparison with on-the-shelf antenna

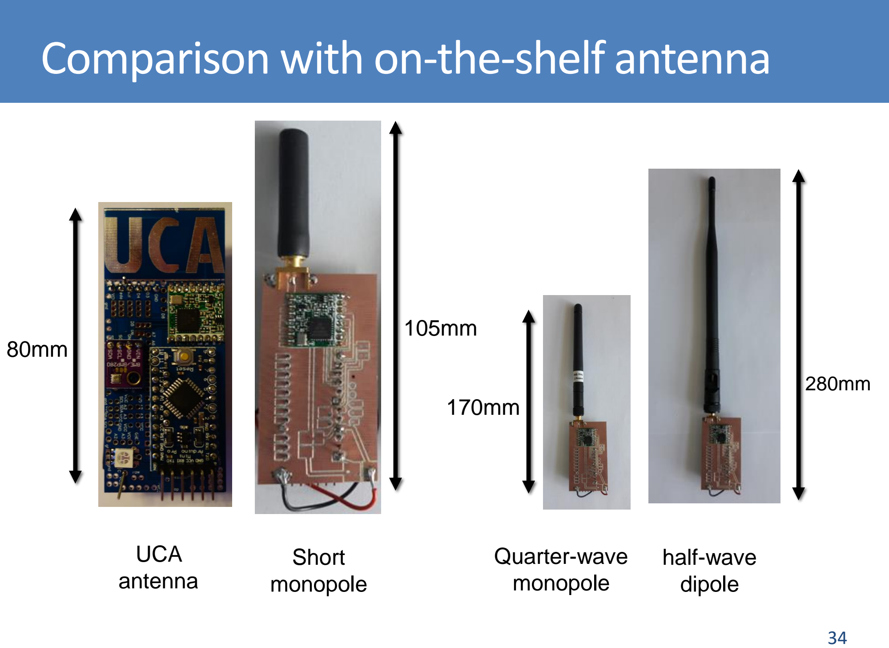
[picture p172: page 34]

80mm

170mm

Short
monopole

Quarter-wave
monopole

280mm

half-wave
dipole

UCA
antenna

105mm

- Measurement on Satimo
Starlab station
- Continuous wave with 14 dBm power from RFM95W module
- Efficiency calculated from the
3D antenna measurement

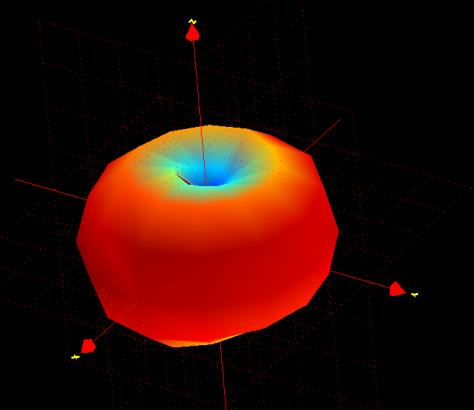
[picture p173: figure]

Antenna structure | EIRP (dBm) | Total efficiency | Max Dimension
Small monopole | 14.7 | 74% | 105 mm
Quarter-wave monop. | 15.7 | 94% | 170 mm
Half-wave dipole | 13.9 | 61% | 280 mm
UCA untuned | 13.8 | 60% | 80mm
UCA after tuning | 14.8 | 76% | 80mm

## Comparison with on-the-shelf antenna

https://github.com/FabienFerrero/UCA_Board

## Terminal Autonomy with a battery

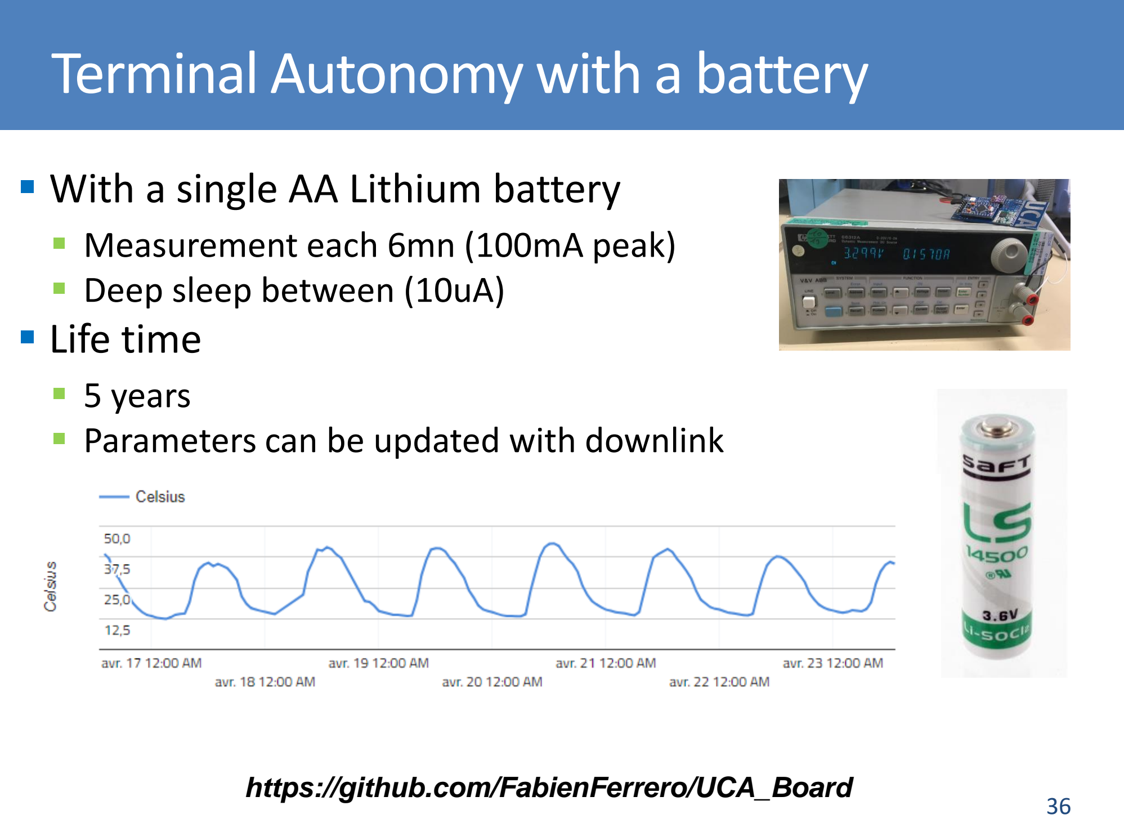
[picture p174: page 36]

- With a single AA Lithium battery
- Measurement each 6mn (100mA peak)
- Deep sleep between (10uA)
- Life time
- 5 years
- Parameters can be updated with downlink

https://github.com/FabienFerrero/UCA_Board

## Outline

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

## Micro-tracker Antenna Industrial project

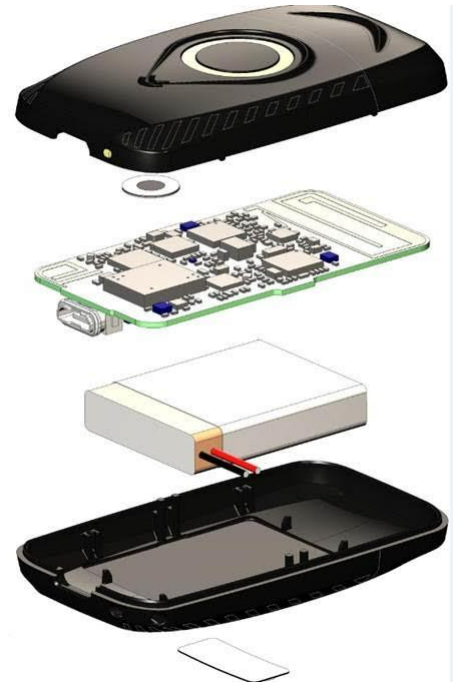
[picture p175: figure]

- Specs
- LoRa 868 or 915MHz
- WiFi/BLE (2.4GHz)
- GPS L1
- Terminal size: 50*28mm²
- Proposed solution
- Dual-band LoRa/GPS
- SP4T to switch between LoRa Rx/Tx/Txboost and GPS.
- WiFi/BLE antenna (2.4-2.48 GHz)

## Micro-tracker Antenna Industrial project

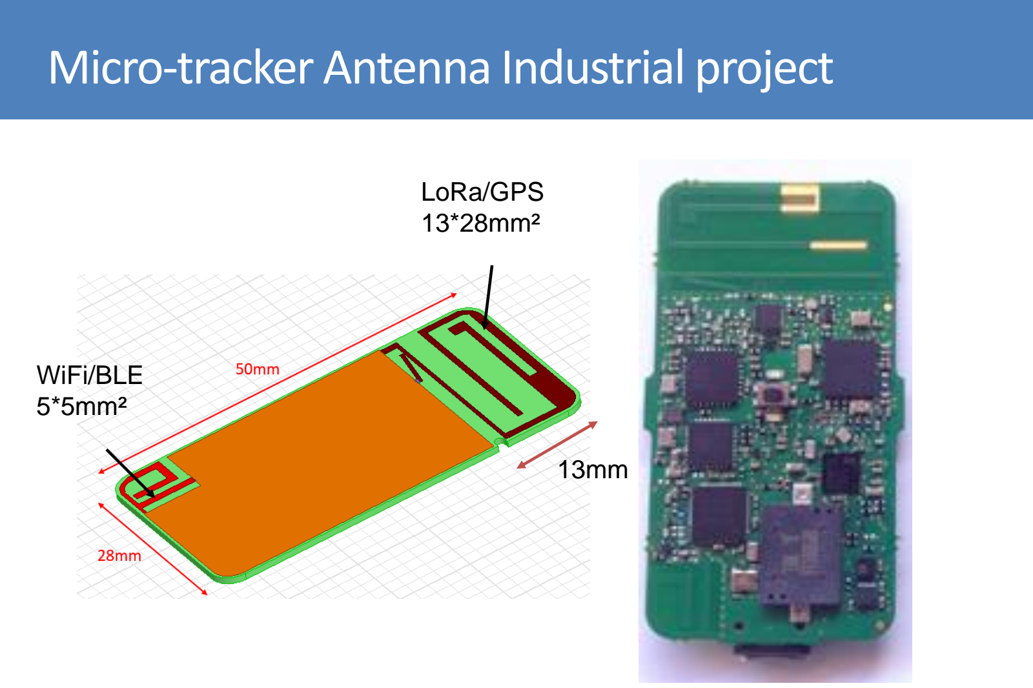
[picture p176: page 39]

LoRa/GPS
13*28mm²

WiFi/BLE
5*5mm²

13mm

## Micro-tracker Antenna Industrial project

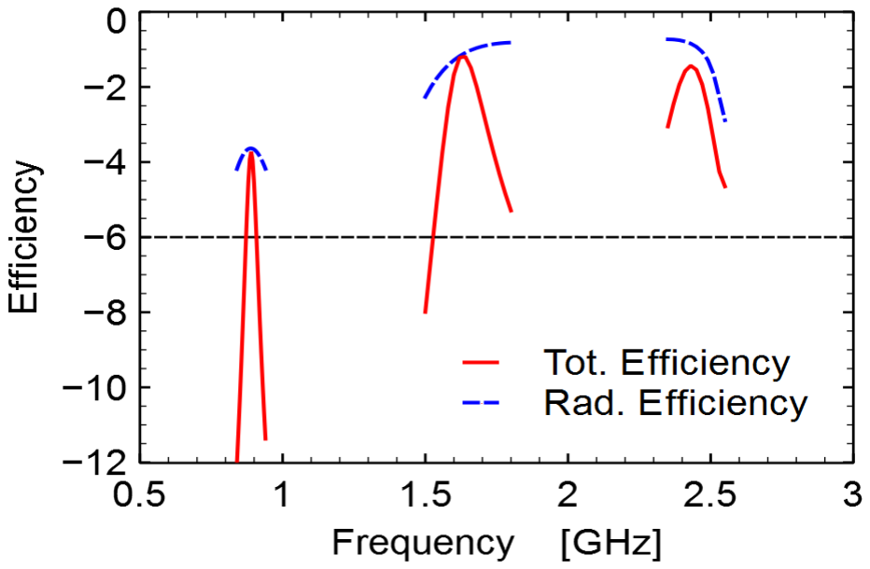
[picture p177: figure]

- Total Efficiency LoRa -4 dB (40%)
- Total Efficiency GPS -1.5 dB (70%)
- Total Efficiency WiFi/BLE -1.5 dB (70%)

## Micro-tracker Antenna Industrial project

Radiation pattern

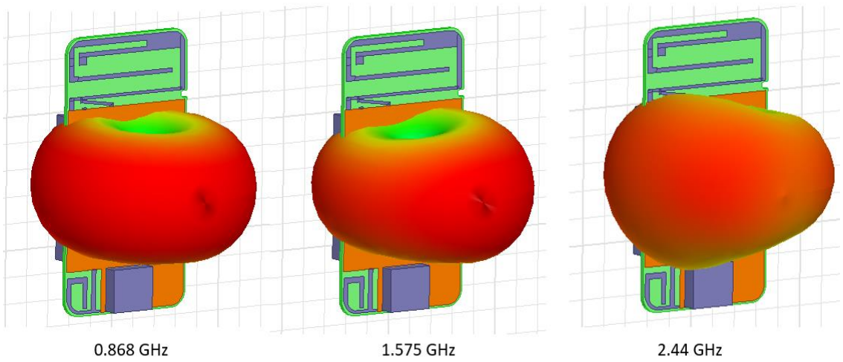
[picture p178: figure]

## Micro-tracker Antenna Industrial project

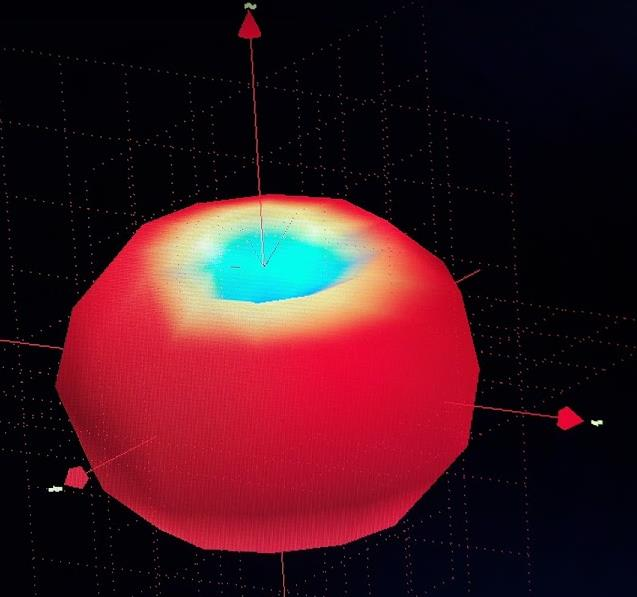
[picture p179: figure]

Measurements :
- LoRa : Peak Gain -1.5dBi
- BLE/WiFi : Peak Gain 0.5 dBi
- GPS : Estimated at 0dB from anechoic chamber measurement with GPS protocol tester.

## Outline

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

## LoRaWAN in Da Nang

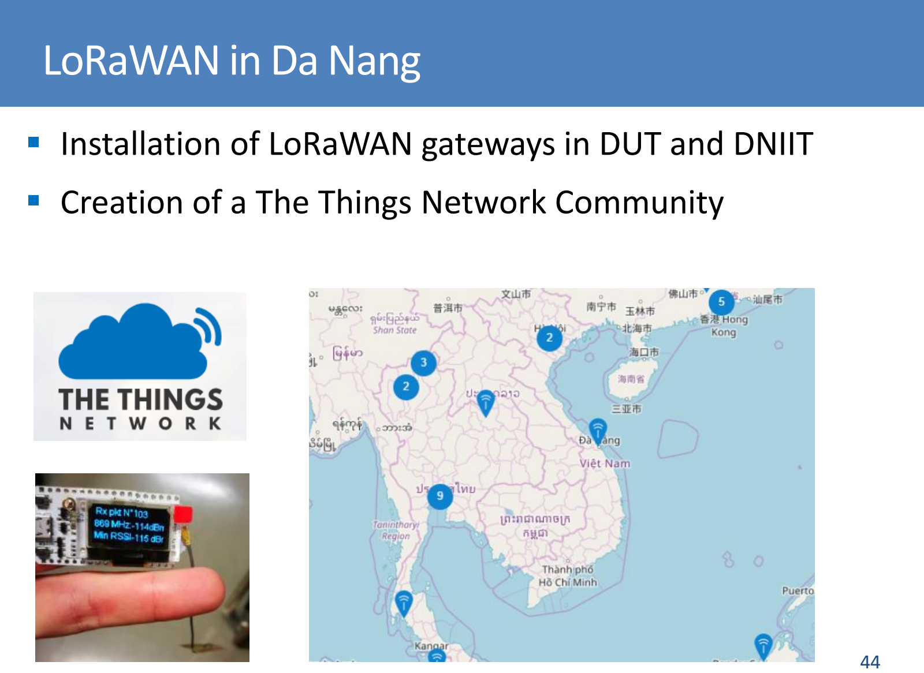
[picture p180: page 44]

- Installation of LoRaWAN gateways in DUT and DNIIT
- Creation of a The Things Network Community

## Da Nang/UCA : research perspectives

- Power management & Energy Harvesting
- Low-cost and low-power localization
- Advanced sensors for advanced applications
- Mix of LoRa, Bluetooth, Wifi, RFID, NFC, etc …
- Communication robustness and security

PAPIoT project -> MAVAK (MAng VAt-the Ket-noi )

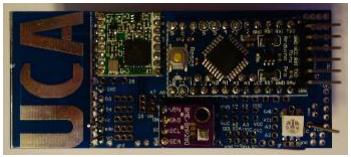
[picture p181: figure]

## REFERENCES

- C. Pham, F. Ferrero, M. Diop, L. Lizzi, O. Dieng, O. Thiaré, "Low-cost Antenna Technology for
LPWAN IoT in Rural Applications", Proceedings of the 7th IEEE International Workshop on Advances (http://cpham.perso.univ-pau.fr/Paper/IWASI17.pdf) in Sensors and Interfaces (IWASI'17), Vieste, Italy, June 15-16, 2017.
- F. Ferrero, L. Lizzi, C. Danchesi and S. Boudaud, "Environmental sensitivity of miniature antennas for IoT devices," 2016 IEEE International Symposium on Antennas and Propagation (APSURSI), Fajardo, 2016, pp. 1749-1750.
- H. Berrada, F. Ferrero, L. Lizzi, C. Danchesi and S. Boudaud, "Characterization of miniature antenna for sub-GHz on-body applications," 2017 IEEE International Symposium on Antennas and Propagation & USNC/URSI National Radio Science Meeting, San Diego, CA, 2017, pp. 2001-2002.
- Juan Nogueira Nine, Stephane Boudaud, Fabien Ferrero and Leonardo Lizzi, “LPWAN as Enabler for Widespread Geolocation Solutions”, Embedded World 2017, Nuremberg, Germany

Thanks to Cong Duc Pham for sharing the nice pictures and use cases

Thanks to Christophe Danchesi and Stephane Boudaud from Abeeway for sharing the micro-tracker pictures

Thanks to Juan Nogueira for the nice pictures from Flex

And Thanks to Leonardo Lizzi from UCA for contributing on most on this work

## DANANG INTERNATIONAL INSTITUED OF TECHNOLOGY

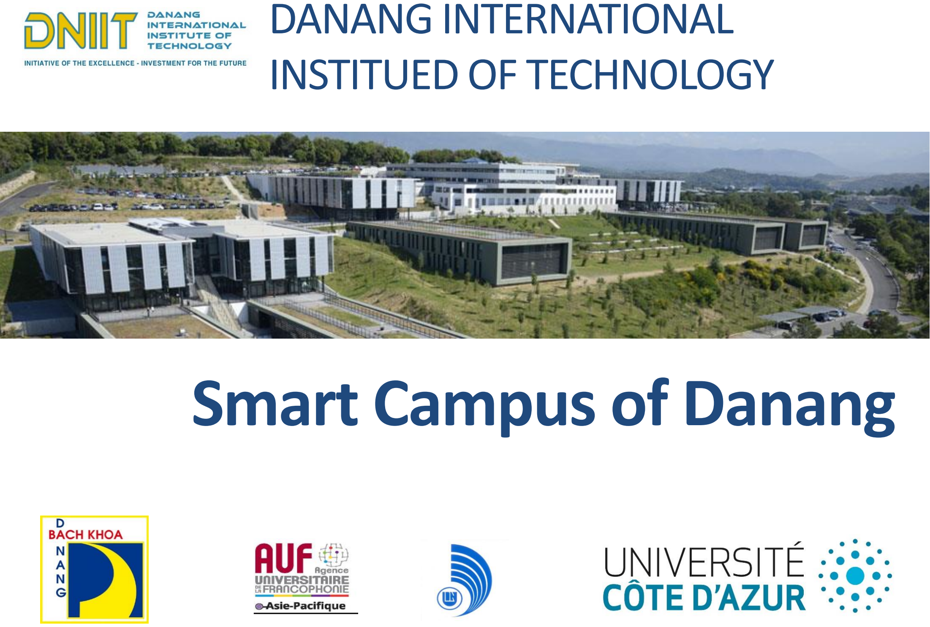
[picture p182: page 47]

# Smart Campus of Danang

## Laboratory of Electronics Antennas and Telecommunications

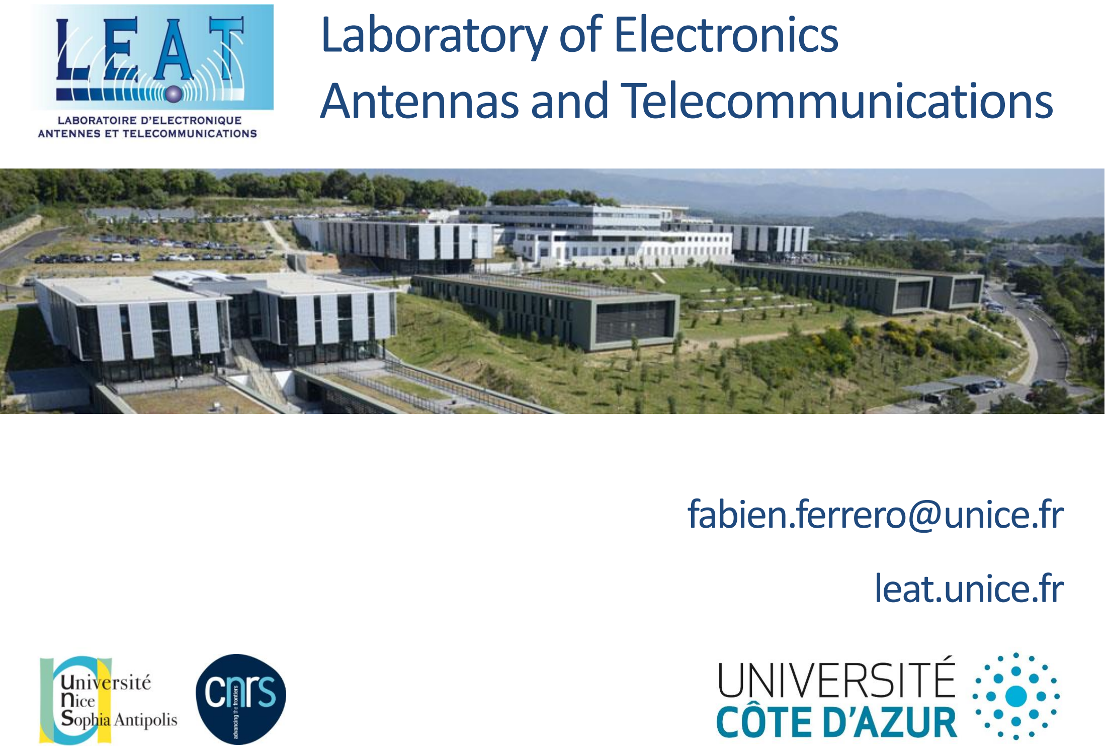
[picture p183: page 48]

fabien.ferrero@unice.fr
leat.unice.fr
