FabienFerrero/UCA_Board/documents/Course/Lab2_LoRaWan_Register_device.pdf

# LoRaWan Register a device on TTN

F. Ferrero

## LoRaWan with The Thing Network

- The Things Network is a global, open, crowd-sourced Internet of Things data
network.
- The Things Network Backend route messages from Nodes to the right Application, and back
- First, you have to register to https://www.thethingsnetwork.org/ , when it is done, tell me your ID, I will add you as a collaborator on the Polytech’ application
- You can also join the Sophia Antipolis TTN community : (https://www.thethingsnetwork.org/community/sophia-antipolis/)

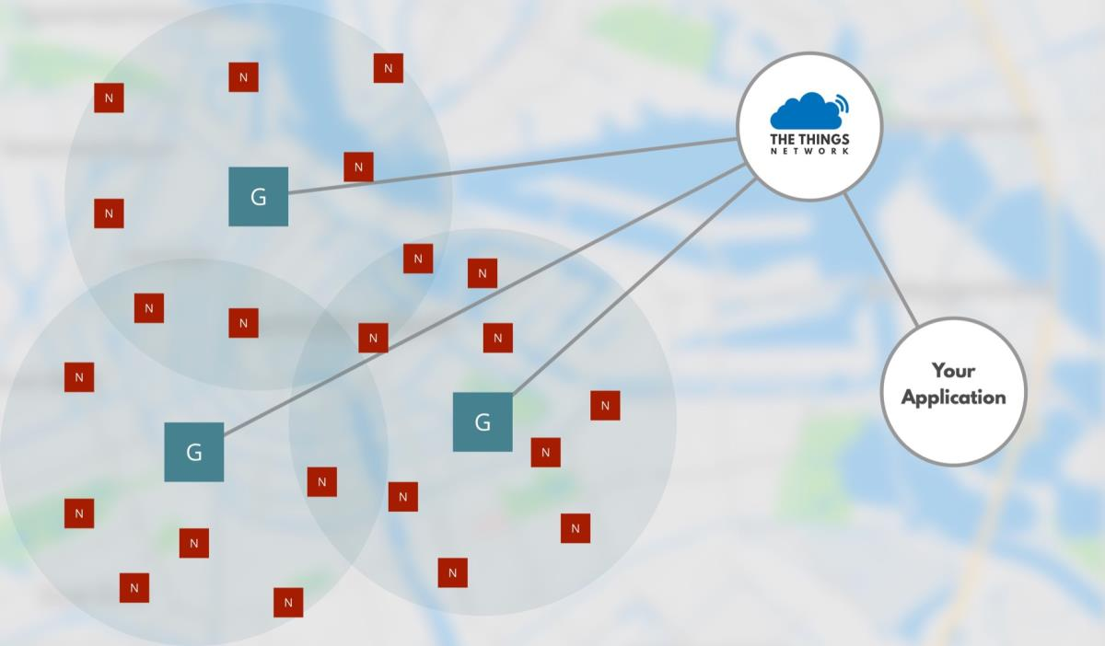
[picture p184: figure]

## Adding a new device

- Go to « Projets Polytech »application and register device
- For ID and EUI, use the N° 50ff1a00000000XX and just incremant XX.
- To remember it : « 50ff1a » is for « SOPHIA »
- It will provide Device EUI, Application EUI and App Key

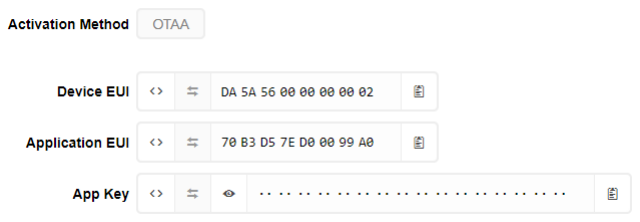
[picture p185: figure]

## Activation by Personalization (ABP)

- Go to settings
- Select ABP and save
- Go back to Overview
- You have now the Device Address and the two 128 AES keys
- You can click on Hex-C Style to have the key in the right format

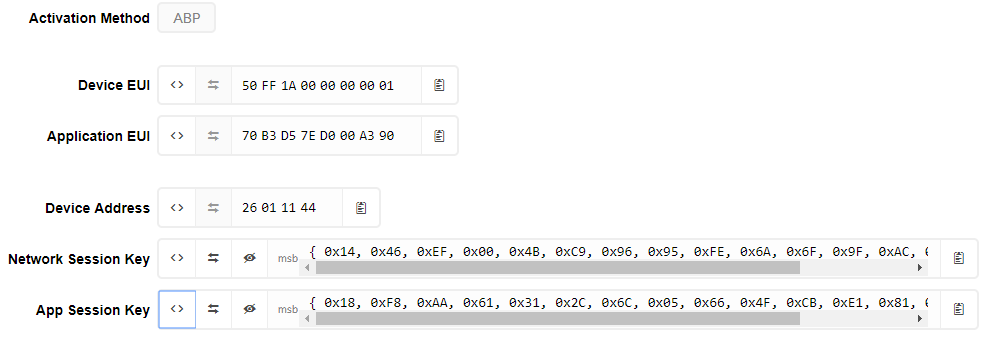
[picture p186: figure]

## Activation by Personalization (ABP)

- Go to my Github : https://github.com/FabienFerrero/UCA_Board
- Download the archive (.zip) and extract the archive
- Copy the file from Arduino_Code/Libraries/ to /Document/Arduino/ Libraries/
- Open the code Arduino_Code/LORAWAN/ABP/Basic/UCA-ABP_Basic.ino
- Copy/Paste NWKSKEY, APPSKEY and DEVADDR with your IDs from TTN

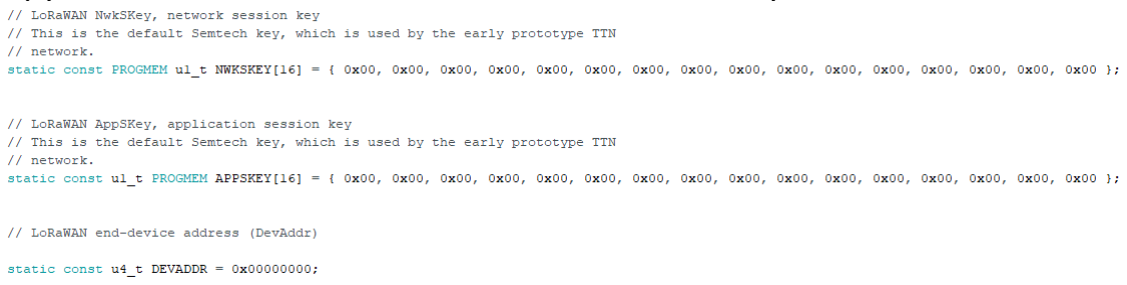
[picture p187: figure]

## Activation by Personalization (ABP)

- Compile and download the code on your board
- Look at the TTN device overview
- Frames up should increment each minutes as you board is sending an uplink each 60s.
- Have look on data
- For each uplink, you can look many details as RSSI, SNR, airtime, modulation, coding rate, GW ID, etc …

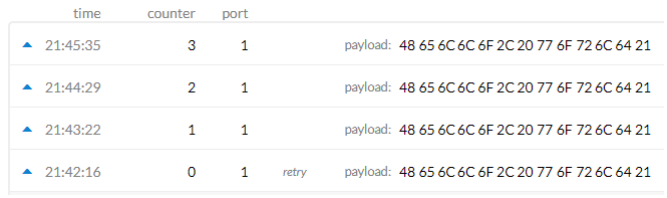
[picture p188: figure]

## Activation by Personalization (ABP)

Frame counter security
- Now reset you board (click on the red button on the Arduino mini pro)
- TTN is no more receiving the data
- Click on « reset frame counters » and reset you board again
- As you can see, frame counter is a security features to avoid replay attack (done by capturing and re-transmitting the messages)
Downlink
- Open your serial monitor
- In TTN overview, go to downling, add a payload like « BABA » and click on send
- After the next uplink, you should see the number of byte received in downlink

## Over the Air Activation (OTAA)

- In TTN Settings of your device, select OTAA and save
- Open the code Arduino_Code/LORAWAN/OTAA/LP_Basic/UCA-OTAA_Basic.ino
- copy paste after clicking on hexa-style the DEV-EUI, APP-EUI and App Key
- Be carefull !!!
- Device EUI and Application EUI are lsb
- App Key is msb

## Over the Air Activation (OTAA)

- Look in data
- You should see a first uplink that
request the connection
- And a second packet witht the first data
- On the serial monitor you can see the Joining process and then Joined and Tx.
- The device go to sleep after the Tx

Board
request for
connection

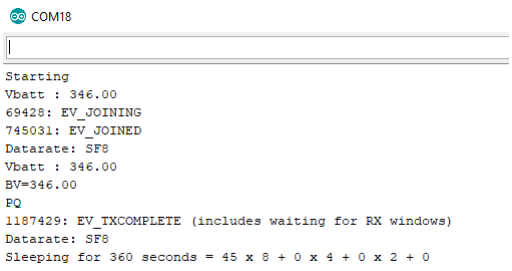
[picture p189: figure]

First packet
with data

## Over the Air Activation (OTAA) and data

- Try now the code
Arduino_Code/LORAWAN/OTAA/LP_BME280/UCA-BME280.ino
- It use the sensor BME280 that measure T°c, Humidity and Pressure
- The code is using Cayenne LPP format (https://github.com/myDevicesIoT/cayenne-docs/blob/master/docs/LORA.md)
- Now you can see sensor data in the uplink packet

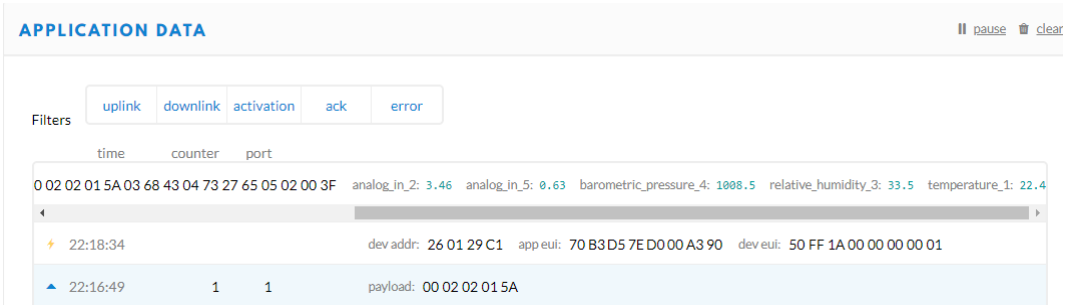
[picture p190: figure]

## Using Cayenne to see you data

- Go to https://mydevices.com/ and create an account
- Add a device by selecting LoRa/TheThingNetwork and Cayenne LPP.
- Just add your device EUI
- You should see your data

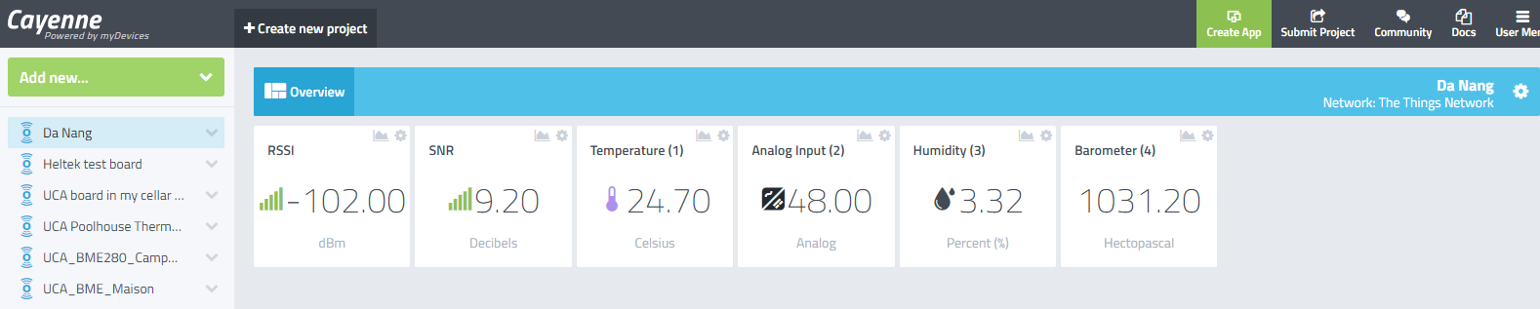
[picture p191: figure]

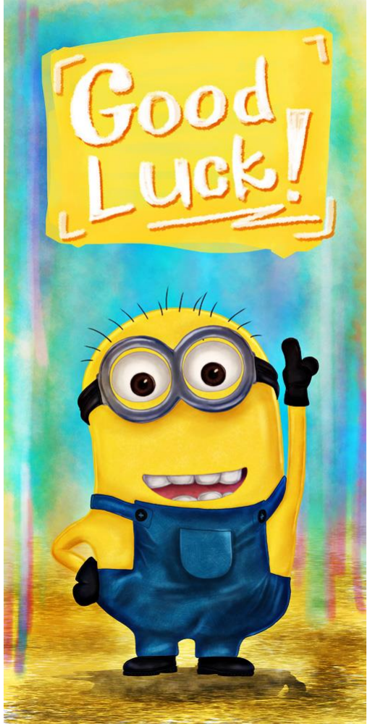
[picture p192: figure]

## Good luck for you projects !
