FabienFerrero/UCA_Board/documents/Conferences/IWASI_UCA_06_2017.pdf

# Low-cost Antenna Technology for LPWAN IoT in Rural Applications

# C. Pham¹

# , F. Ferrero², M. Diop¹

# , L. Lizzi², O. Dieng³, O. Thiaré³

# 1University of Pau, LIUPPA, France 2Université Côte d'Azur, LEAT, France 3University Gaston Berger, Senegal

# 7th IEEE IWASI Intl Conference Friday, June 16th, 2017 Vieste, Italy

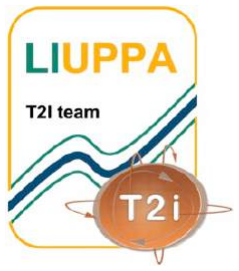
[picture p193: figure]
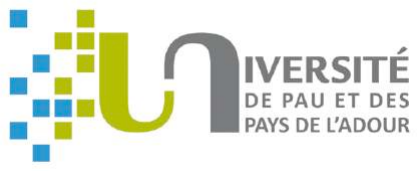
[picture p194: figure]

# Prof. Congduc Pham

# http://www.univ-pau.fr/~cpham Université de Pau, France

# BigData & low-cost IoT

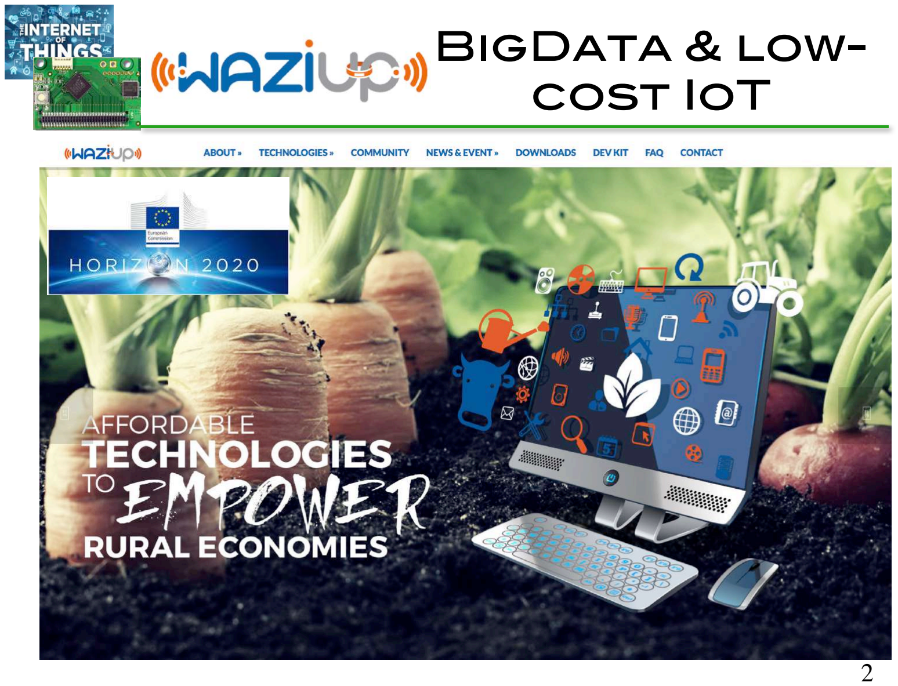
[picture p195: page 2]

# Objectives

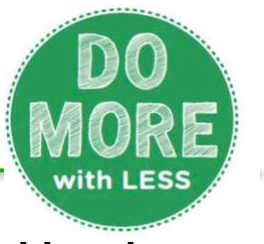
[picture p196: figure]

q To propose low-cost and energy-efficient hardware platforms that fit to African context q To design and develop IoT long-range communication framework (device+gateway) q To develop and validate the open IoT and Big data and advanced analytic application platform q To offer open sources WAZIUP (hardware and software) platform for developer and SMEs communities q To engage local communities/entrepreneurs for sustainable innovation

# maturation of the IoT market…

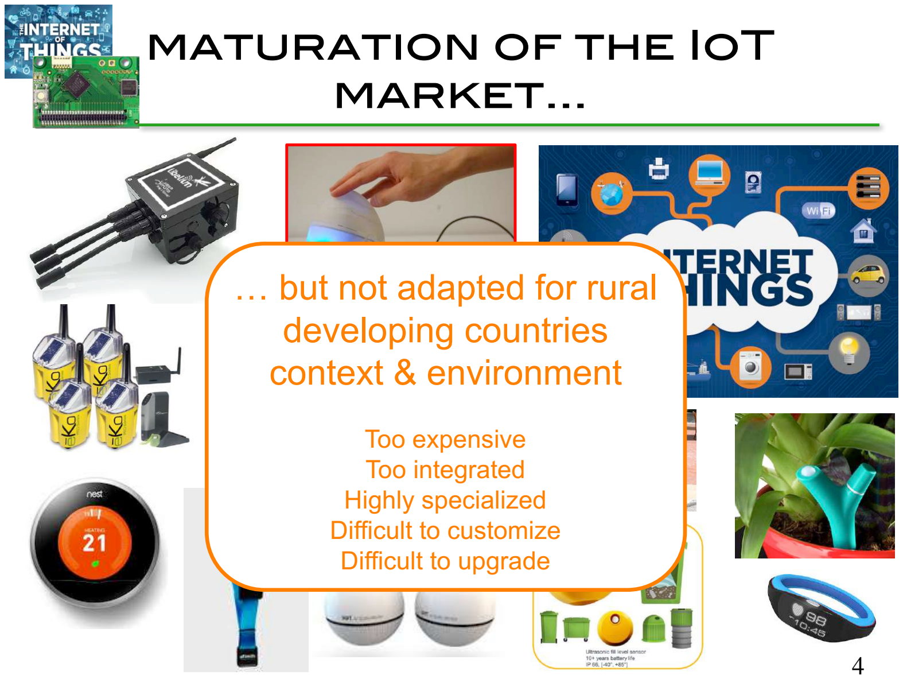
[picture p197: page 4]

# … but not adapted for rural developing countries context & environment

# Too expensive Too integrated Highly specialized Difficult to customize Difficult to upgrade

# Internet, Cloud & big data analytics

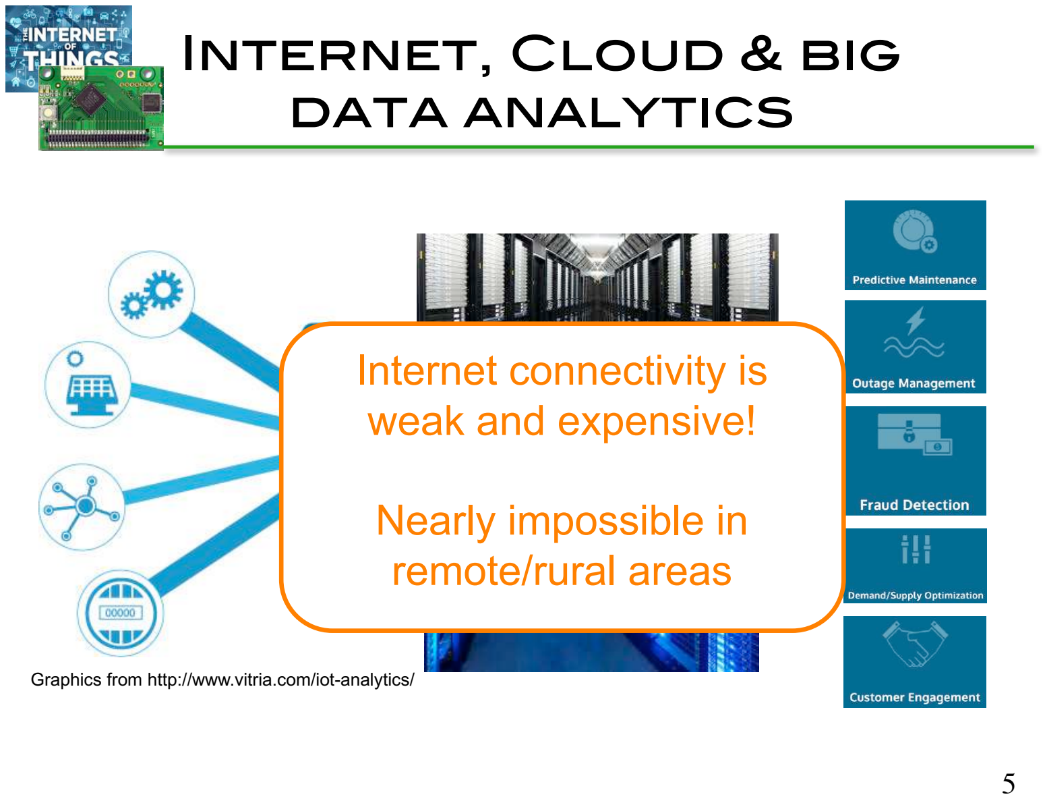
[picture p198: page 5]

# Graphics from http://www.vitria.com/iot-analytics/

# Internet connectivity is weak and expensive!

# Nearly impossible in remote/rural areas

# Low-cost hardware

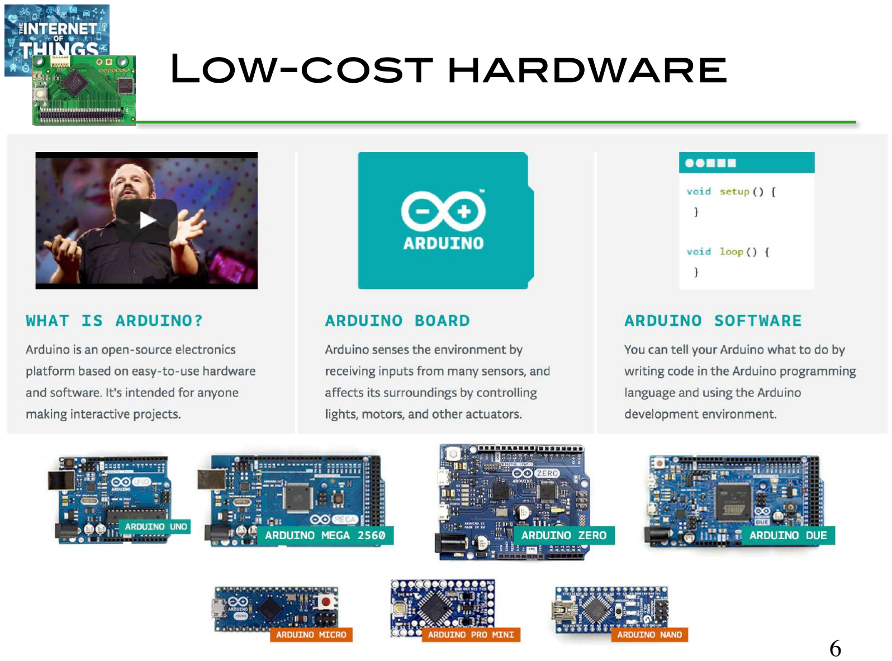
[picture p199: page 6]

# Low-power & long-range radio technologies

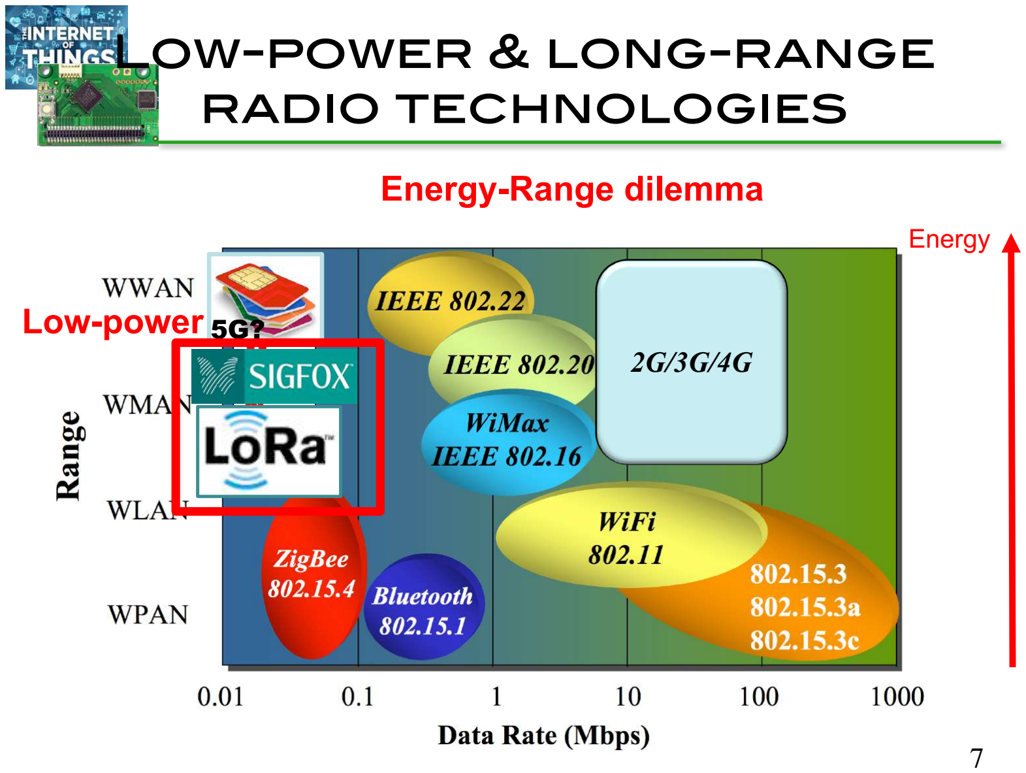
[picture p200: page 7]

# Energy

# Energy-Range dilemma

L
P
W
A
N
?

5G?

# 2G/3G/4G

# Low-power

# LPWAN architecture

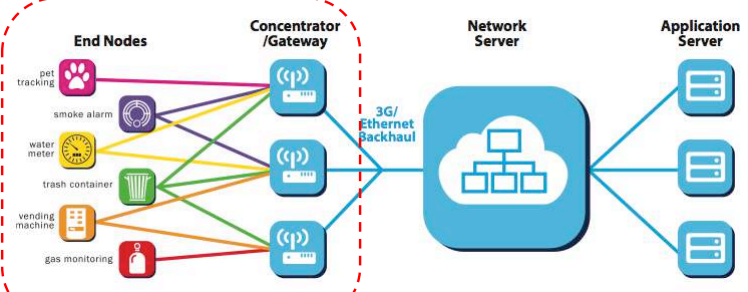
[picture p201: figure]

# Figure from Semtech

# SW/HW building blocks integration

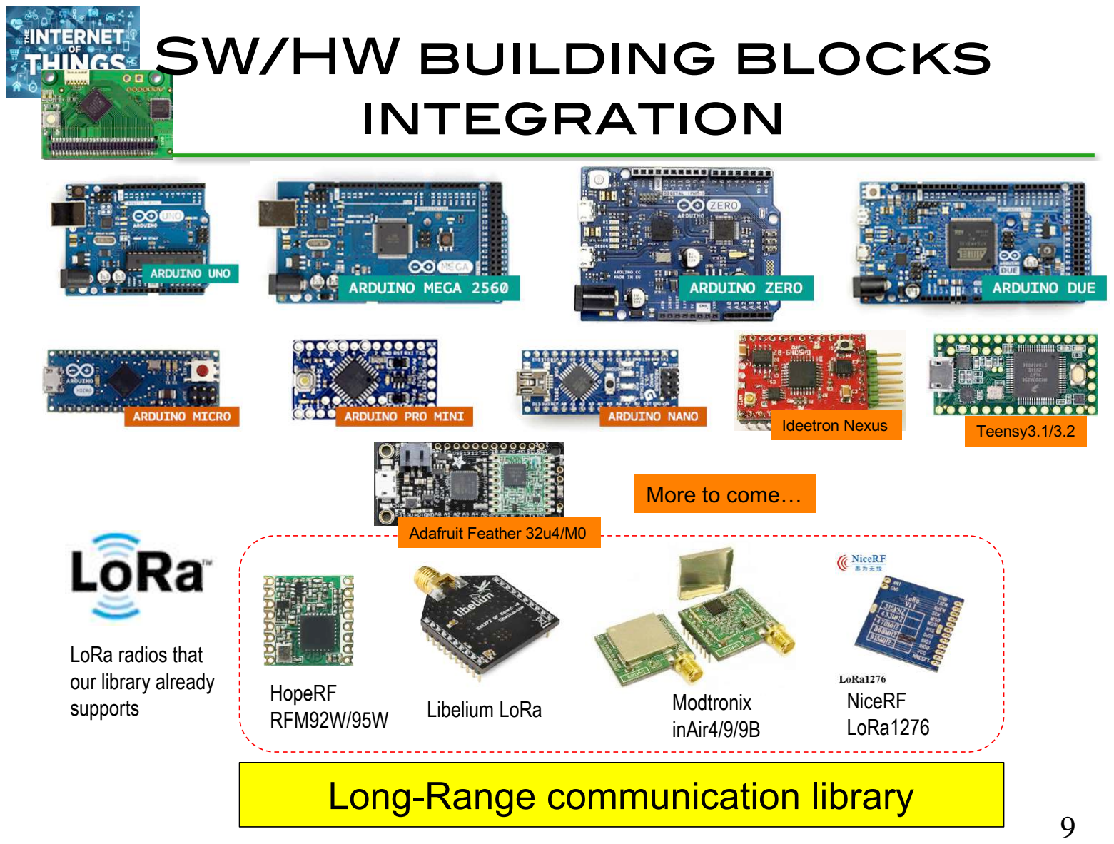
[picture p202: page 9]

# Long-Range communication library

# Libelium LoRa HopeRF RFM92W/95W

# Modtronix inAir4/9/9B

# LoRa radios that our library already

supports | NiceRF
| LoRa1276
Ideetron Nexus | Teensy3.1/3.2

# Adafruit Feather 32u4/M0

# More to come…

# Ready-to-use templates

# setup

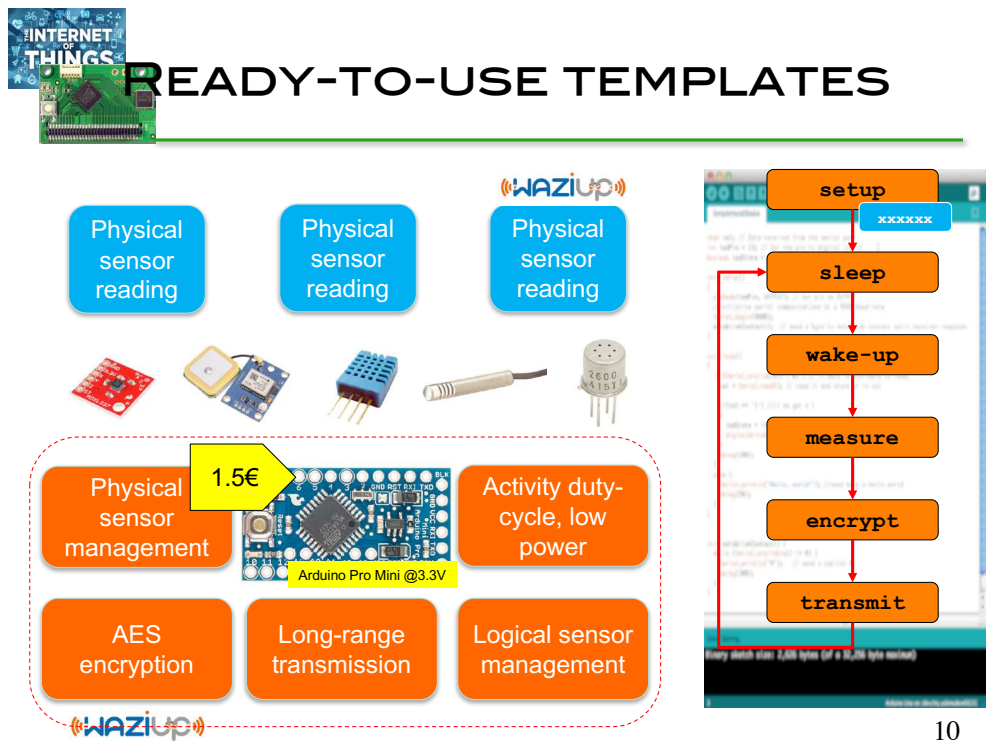
[picture p203: page 10]
Physical sensor reading; Physical sensor management; Long-range transmission; Activity duty- cycle, low power; Logical sensor management; AES encryption; sleep; wake-up; measure; encrypt; transmit; xxxxxx Physical sensor reading

Arduino Pro Mini @3.3V

# Generic sensing IoT device

# q Build low-cost, low-power, Long-range enabled generic platform q Methodology for low-cost platform design

q Technology transfers to user communities,

# economic actors, stakeholders,…

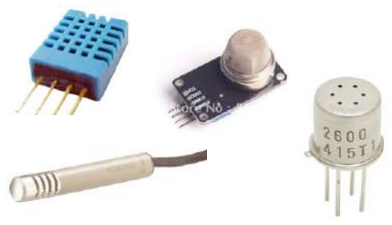
[picture p204: figure]
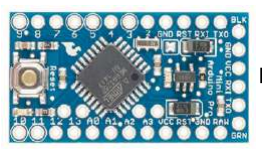
[picture p205: figure]
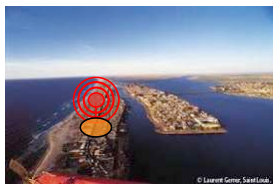
[picture p206: figure]
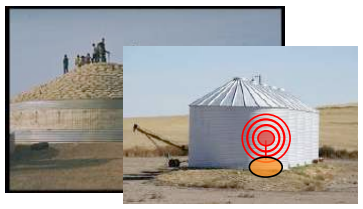
[picture p207: figure]
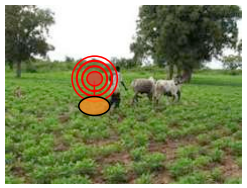
[picture p208: figure]
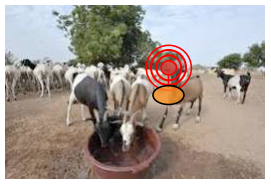
[picture p209: figure]

# Generic sensing IoT device

# q Build low-cost, low-power, Long-range enabled

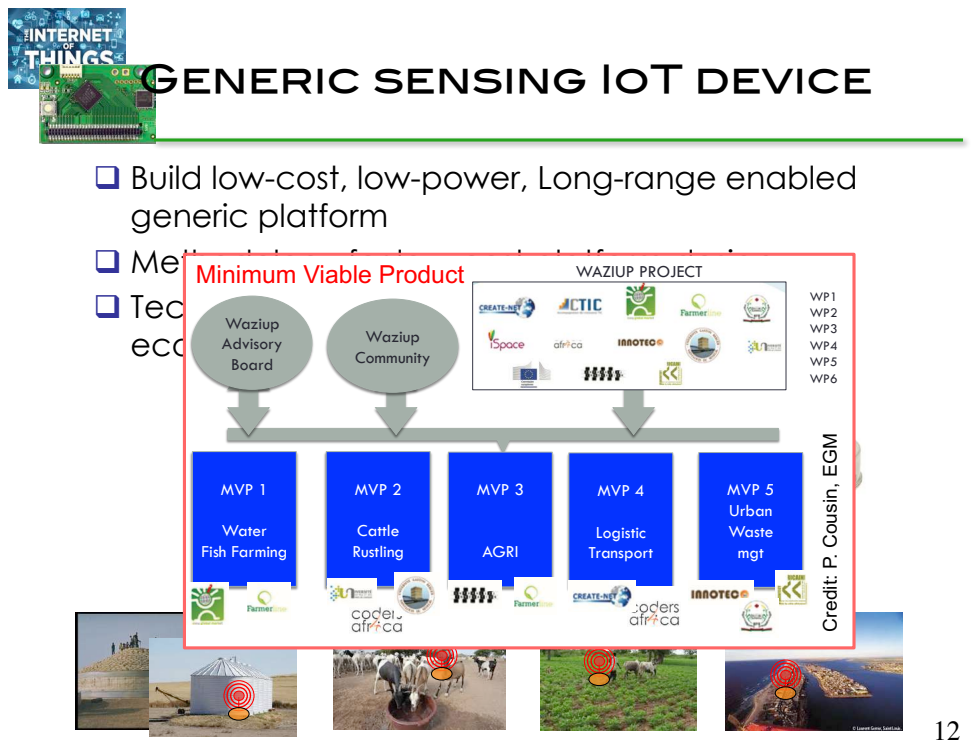
[picture p210: page 12]
MVP 1; Water Fish Farming; MVP 2; Cattle Rustling; MVP 3; AGRI; MVP 4; Logistic Transport; MVP 5 Urban Waste mgt; Waziup Advisory Board; Waziup Community; WAZIUP PROJECT

generic platform
q Methodology for low-cost platform design
q Technology transfers to user communities,
economic actors, stakeholders,…

Minimum Viable Product

Credit: P. Cousin, EGM

# radio bridge

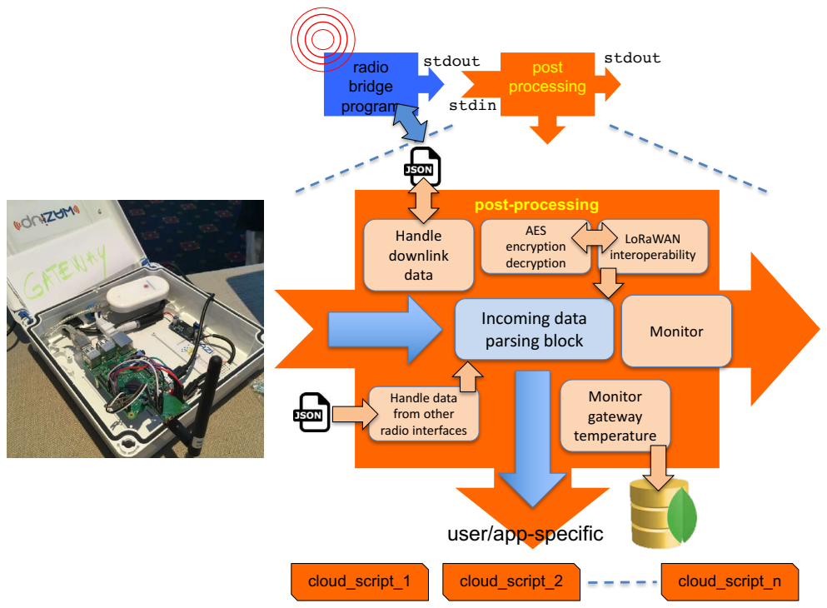
[picture p211: page 13]
program; stdout; stdin; post processing; post-processing; Incoming data parsing block; Handle downlink data; cloud_script_1; Monitor gateway temperature; LoRaWAN interoperability; Handle data from other radio interfaces; cloud_script_2; cloud_script_n; AES encryption decryption; Monitor

user/app-specific

# Low-cost buoy for fish farming MVP

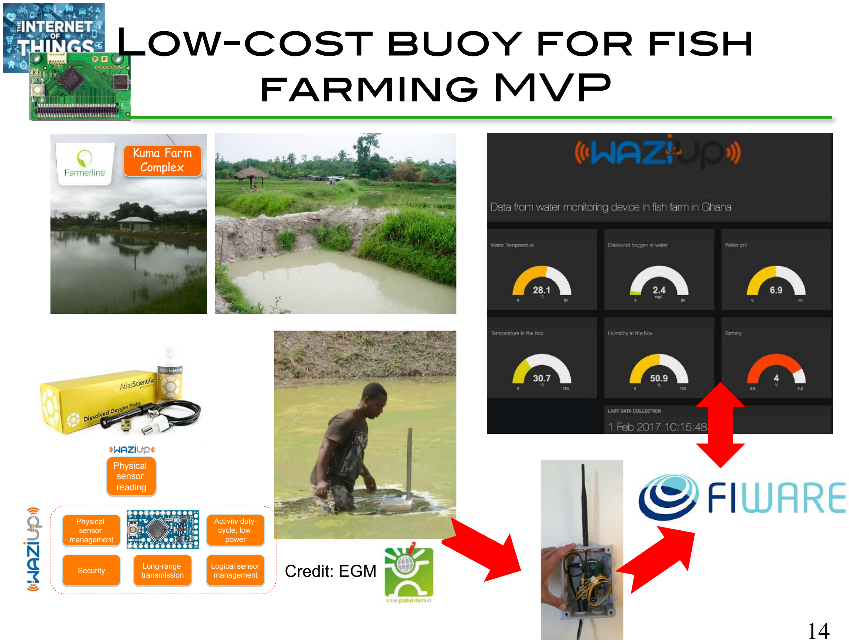
[picture p212: page 14]

# Kuma Farm Complex

# Physical sensor management

# Long-range transmission

# Activity duty-cycle, low power

# Logical sensor management Security

# Physical sensor reading

# Credit: EGM

# Soil humidity sensors for agri MVP

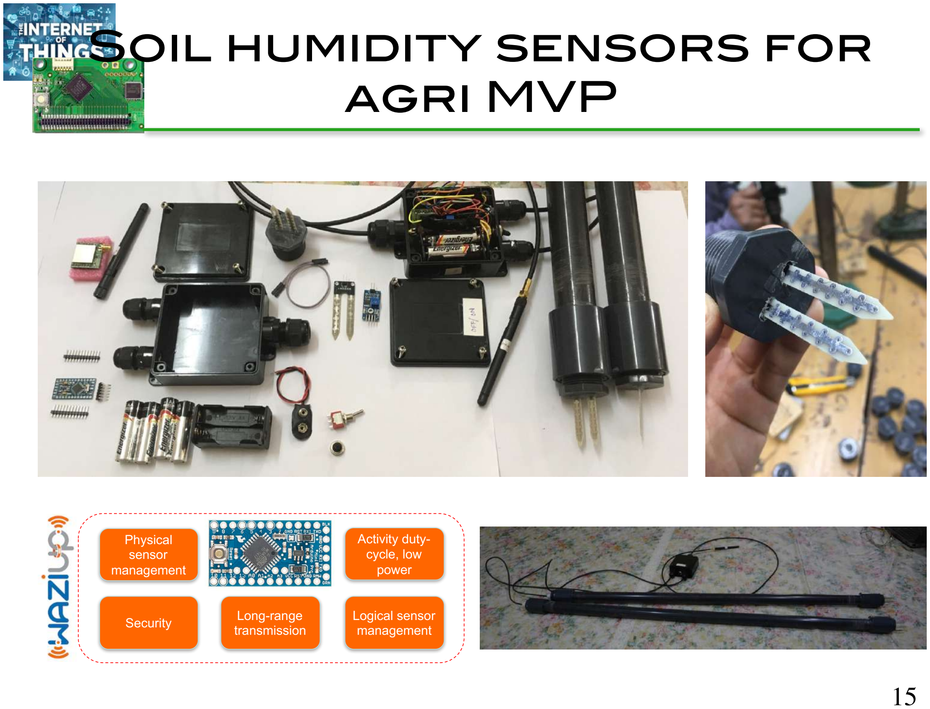
[picture p213: page 15]

# Physical sensor management

# Long-range transmission

# Activity duty-cycle, low power

# Logical sensor management Security

# Deployment for Nestlé's WaterSense project

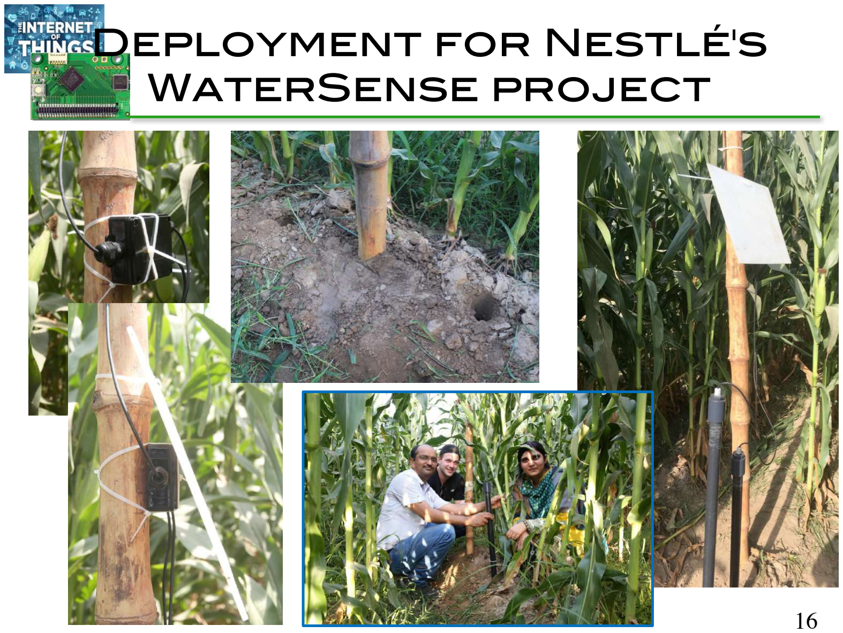
[picture p214: page 16]

# Collar for Cattle Rustling MVP

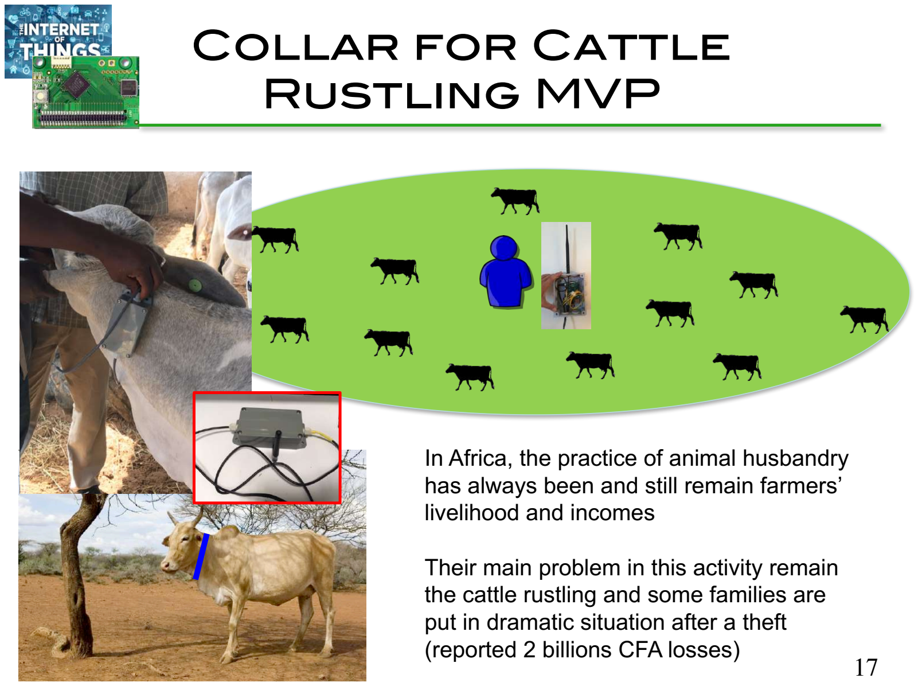
[picture p215: page 17]

# In Africa, the practice of animal husbandry has always been and still remain farmers’ livelihood and incomes

# Their main problem in this activity remain the cattle rustling and some families are put in dramatic situation after a theft (reported 2 billions CFA losses)

# Collar for Cattle Rustling MVP

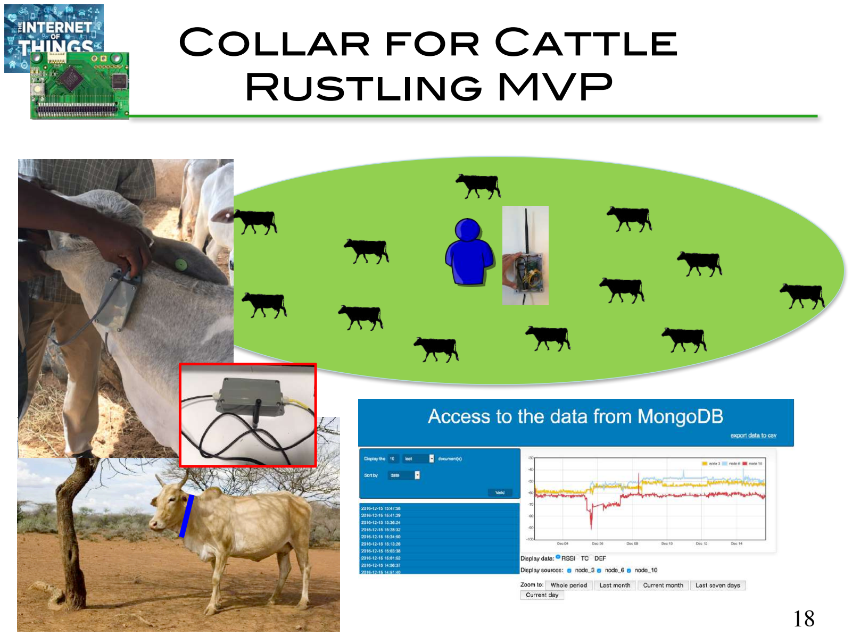
[picture p216: page 18]

# Easy integration and customization

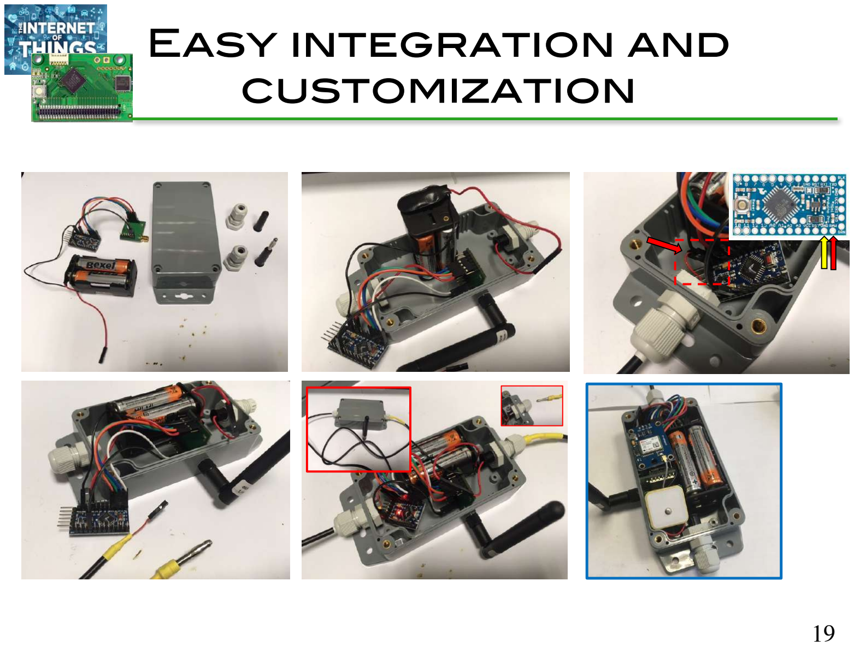
[picture p217: page 19]

# Afimilk collar courtesy of I. Andonovic from University of Strathclyde

# Design of cost efficient antenna @868MHz

# q Cost reduction

# q Avoids RF connectors, use less expensive LoRa module q Avoid external antenna q A PCB is needed for component integration q The cost for an extension of the PCB is negligible, so PCB integrated antenna is very cost efficient

# q Radiation performance

# q Two parameters need to be optimized : impedance matching and radiation efficiency q Impedance matching can be easily optimized with antenna geometry q Radiation efficiency mainly depend on the antenna size

# Antenna design

# q Open-source layout

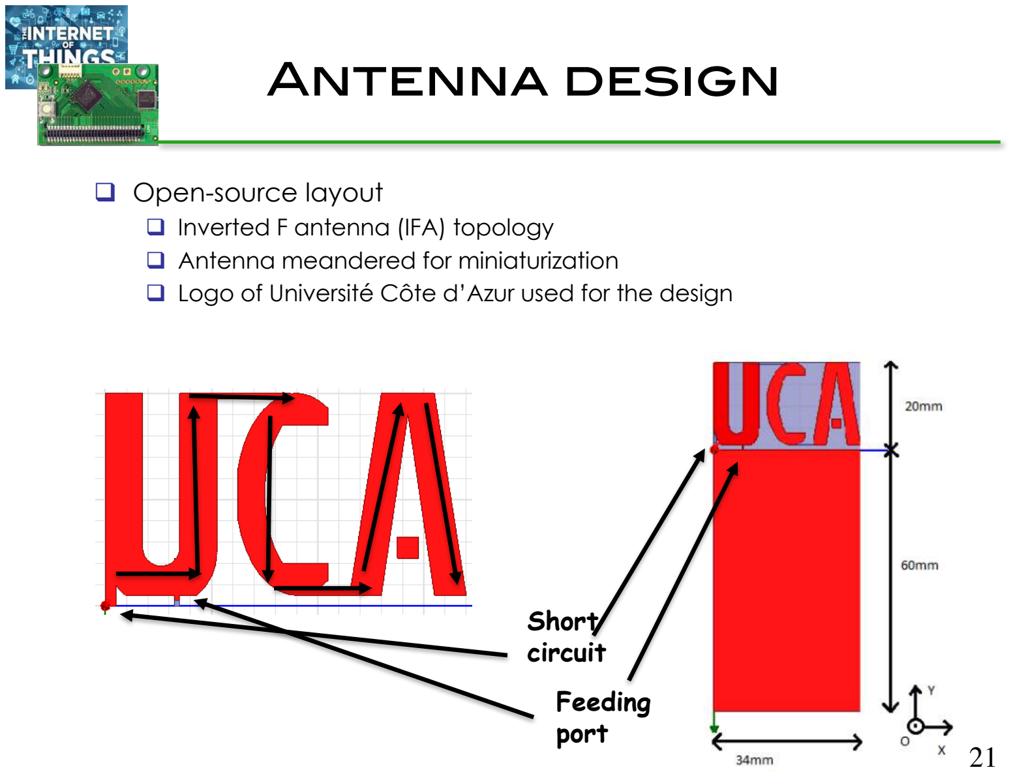
[picture p218: page 21]

# Feeding port

# Short circuit

# q Inverted F antenna (IFA) topology q Antenna meandered for miniaturization q Logo of Université Côte d’Azur used for the design

# Low-cost integration

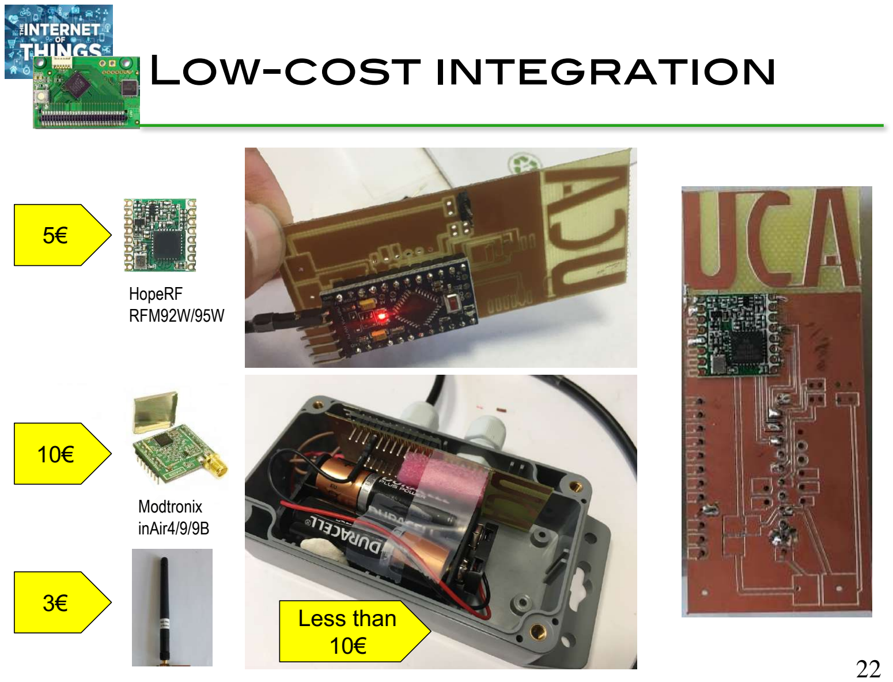
[picture p219: page 22]

# HopeRF RFM92W/95W

5€

10€

# Modtronix inAir4/9/9B

3€ | Less than
| 10€

# Antenna characteristics

# q Antenna simulation

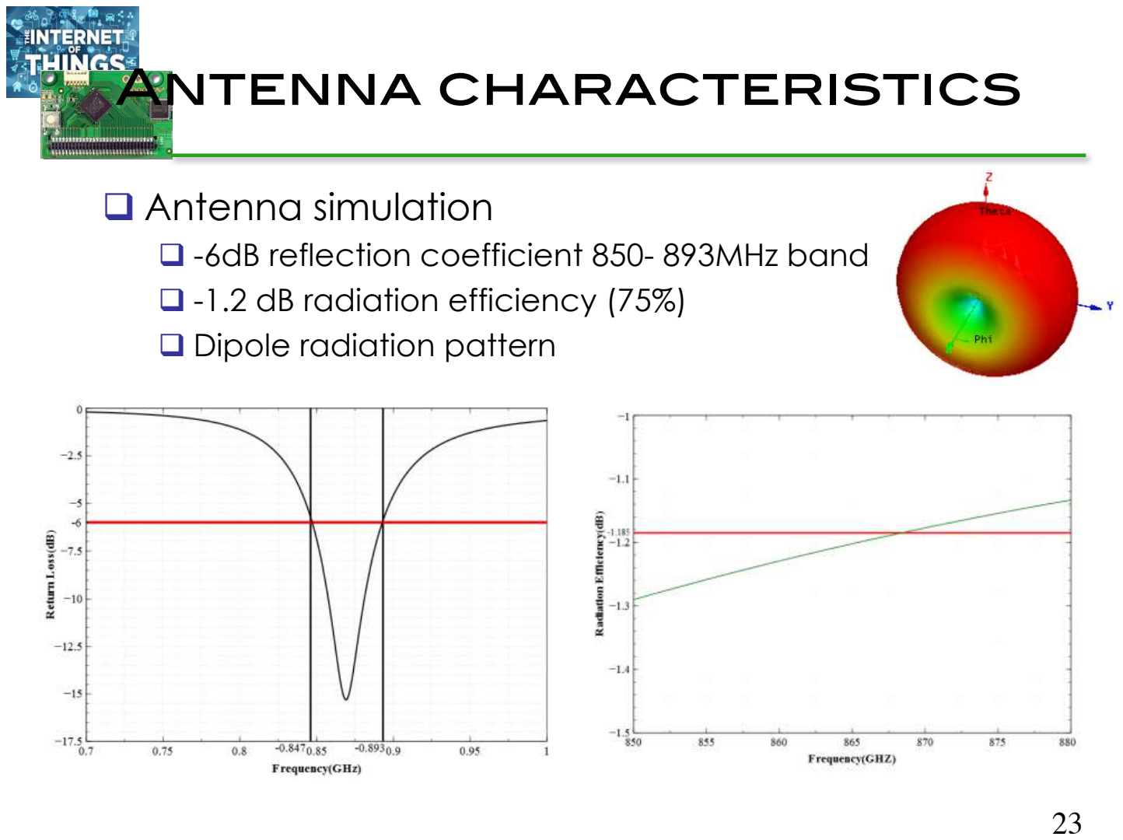
[picture p220: page 23]

# q -6dB reflection coefficient 850- 893MHz band q -1.2 dB radiation efficiency (75%) q Dipole radiation pattern

# comparison with external antennas

105mm
170mm

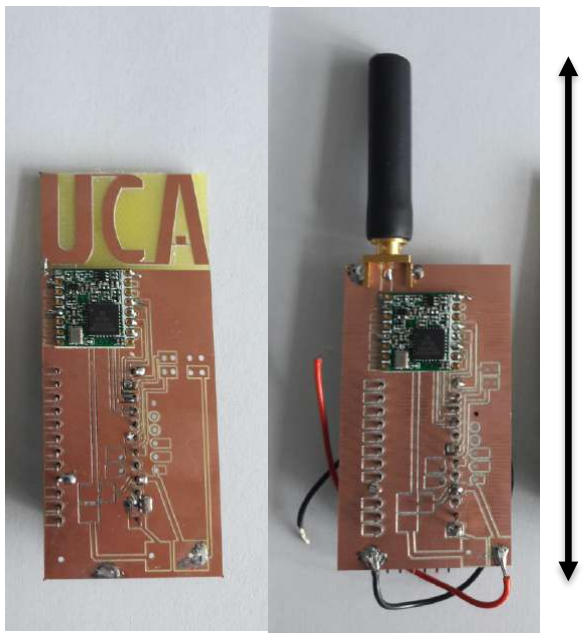
[picture p221: figure]

# Short monopole

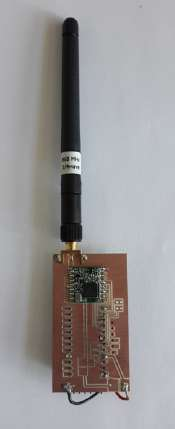
[picture p222: figure]

# Quarter-wave monopole

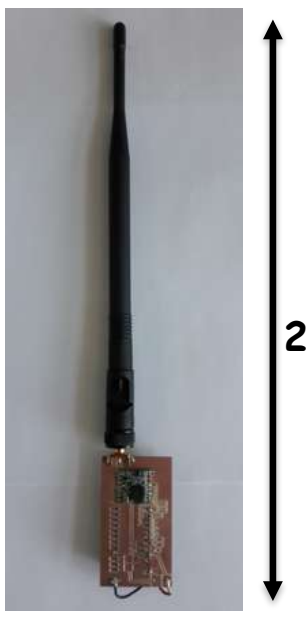
[picture p223: figure]

280mm

# half-wave dipole UCA antenna

# Radiation measurements : Synthesis

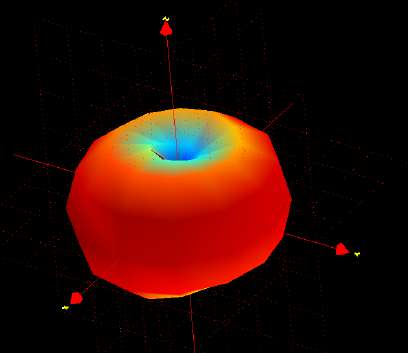
[picture p224: figure]
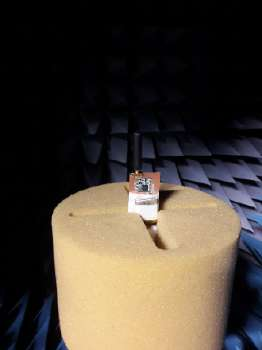
[picture p225: figure]

# q Measurement on Satimo Starlab station

# q Continuous wave with 14 dBm power q Efficiency calculated from the 3D antenna measurement

Antenna structure | TRP (dBm) | Total efficiency | Max Dimension
Small monopole | 14.7 | 74% | 105 mm
Quarter-wave monop. | 15.7 | 94% | 170 mm
Half-wave monop. | 13.9 | 61% | 280 mm
UCA without casing | 13.8 | 60% | 80mm
UCA with casing | 14.8 | 76% | 80mm

# Field tests

# SNR AND RSSI OF 1/4 WAVE MONOPOLE AND

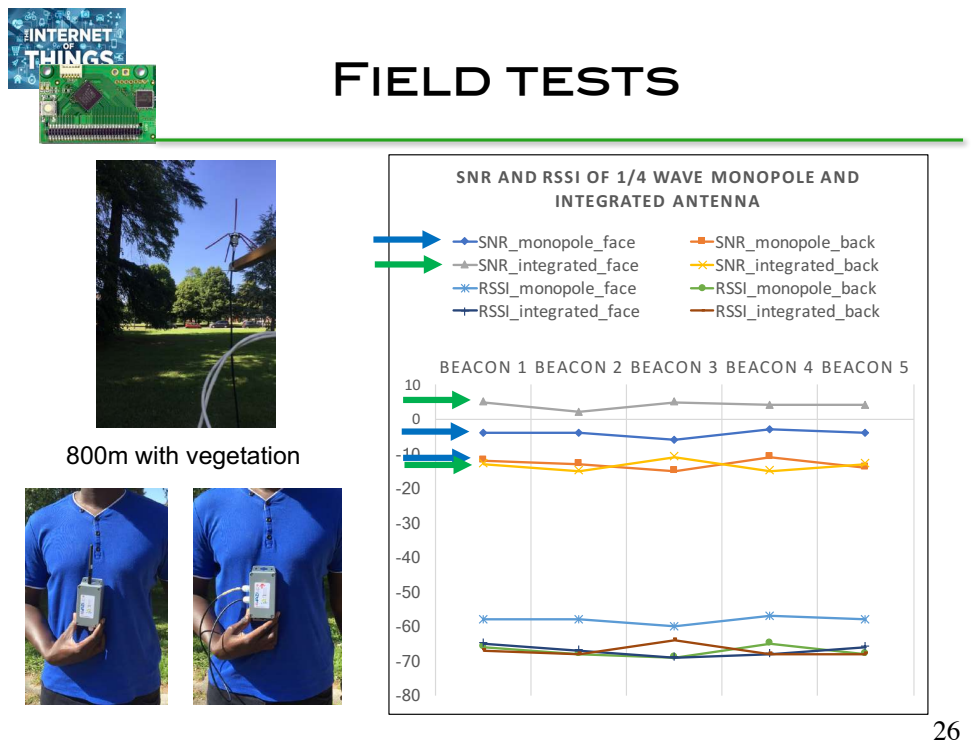
[picture p226: page 26]
800m with vegetation; BEACON 1 BEACON 2 BEACON 3 BEACON 4 BEACON 5; INTEGRATED ANTENNA; SNR_monopole_face; SNR_monopole_back; SNR_integrated_face; SNR_integrated_back; RSSI_monopole_face; RSSI_monopole_back; RSSI_integrated_face; RSSI_integrated_back

# Tutorials/resources

Author : Congduc Pham, University of Pau, France | page
Last update : 07.09.2016

1

EU"H2020 grant"agreement"number"687607

## Low-cost LoRa IoT devices and gateway FAQ

1) What is Internet-of-Thing (IoT)?

From IERC (European Research Cluster on the Internet of Thing)

The IERC definition states that IoT is "A dynamic global network infrastructure with self-configuring capabilities based on standard and interoperable communication protocols where physical and virtual “things” have identities, physical attributes, and virtual personalities and use intelligent interfaces, and are seamlessly integrated into the information network."

From http://www.gartner.com/it-glossary/internet-of-things/

"The Internet of Things (IoT) is the network of physical objects that contain embedded technology to communicate and sense or interact with their internal states or the external environment."

From http://internetofthingsagenda.techtarget.com/definition/Internet-of-Things-IoT

"The Internet of Things (IoT) is a system of interrelated computing devices, mechanical and digital machines, objects, animals or people that are provided with unique identifiers and the ability to transfer data over a network without requiring human-to-human or human-to-computer interaction."
2) What is WAZIUP?

The EU H2020 WAZIUP project, namely the Open Innovation Platform for IoT-Big Data in Sub-Saharan Africa is a collaborative research project using cutting edge technology applying IoT and Big Data to improve the working conditions in the rural ecosystem of Sub-Saharan Africa. First, WAZIUP operates by involving farmers and breeders in order to define the platform specifications in focused validation cases. Second, while tackling challenges which are specific to the rural ecosystem, it also engages the flourishing ICT ecosystem in those countries by fostering new tools and good practices, entrepreneurship and start-ups. Aimed at boosting the ICT sector, WAZIUP proposes solutions aiming at long term sustainability.

WAZIUP will deliver a communication and big data application platform and generate locally the know how by training by use case and examples. The use of standards will help to create an interoperable platform, fully open source, oriented to radically new paradigms for innovative application/services delivery. WAZIUP is driven by the following visions:

1. Empower the African Rural Economy. Develop new technological enablers to empower the African rural economy now threatened by the concurrent action of rapid urbanization and of climate change. WAZIUP technologies can support the necessary services and infrastructures to launch agriculture and breeding on a new scale;

# Low-cost LoRa IoT device:! a step-by-step tutorial!

# Prof. Congduc Pham

## http://www.univ-pau.fr/~cpham Université de Pau, France

# Building an IoT device for outdoor usage:! a step-by-step tutorial!

# Prof. Congduc Pham

## http://www.univ-pau.fr/~cpham Université de Pau, France

# Low-cost LoRa IoT device:! supported physical sensors!

# Prof. Congduc Pham

## http://www.univ-pau.fr/~cpham Université de Pau, France

# Low-cost LoRa IoT:! using the WAZIUP demo kit!

# Prof. Congduc Pham

## http://www.univ-pau.fr/~cpham Université de Pau, France

# Low-cost LoRa gateway:! a step-by-step tutorial!

# Prof. Congduc Pham

## http://www.univ-pau.fr/~cpham Université de Pau, France

# Tutorial on hardware & software for low-cost long-range IoT!

## Prof. Congduc Pham

http://www.univ-pau.fr/~cpham Université de Pau, France

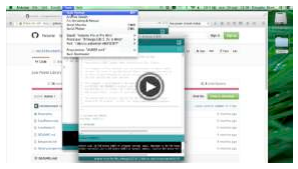
[picture p227: figure]
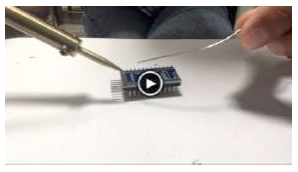
[picture p228: figure]
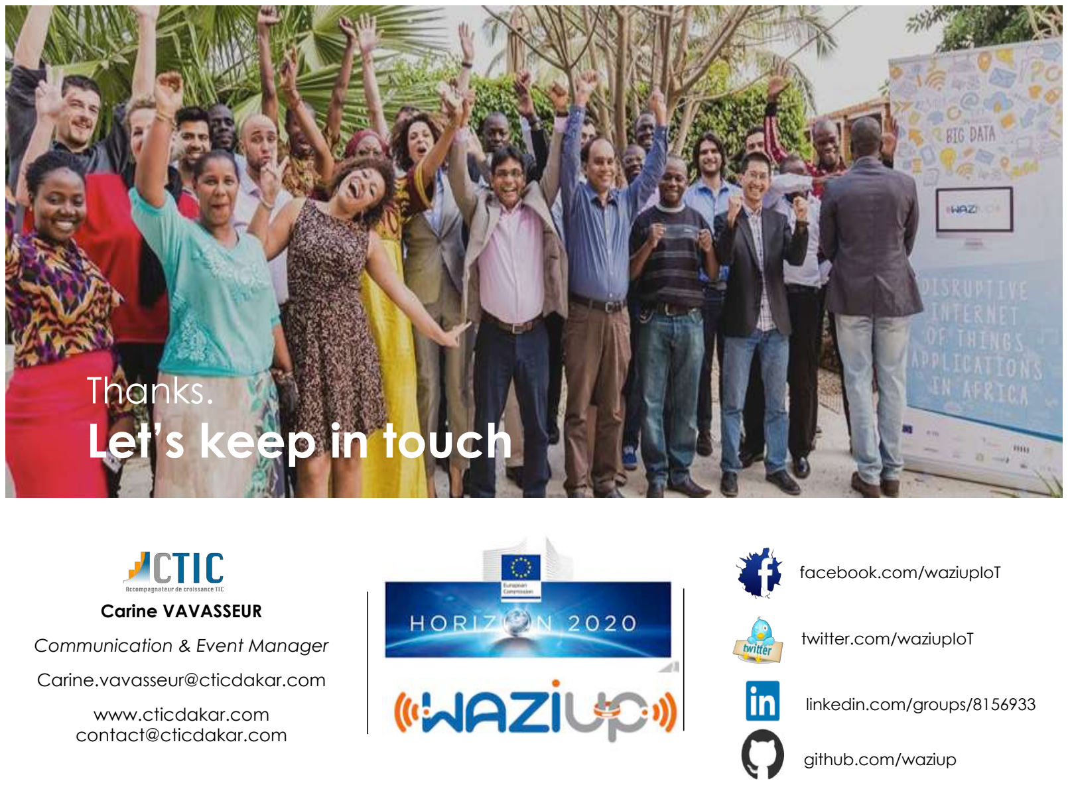
[picture p229: page 28]

Thanks.

# Let’s keep in touch

# facebook.com/waziupIoT

# twitter.com/waziupIoT

# linkedin.com/groups/8156933

# github.com/waziup

# Carine VAVASSEUR Communication & Event Manager

# Carine.vavasseur@cticdakar.com www.cticdakar.com contact@cticdakar.com
