FabienFerrero/UCA_Board/documents/Conferences/EUCAP_UCA_04_2018.pdf

## 9-13 April 2018, London, UK

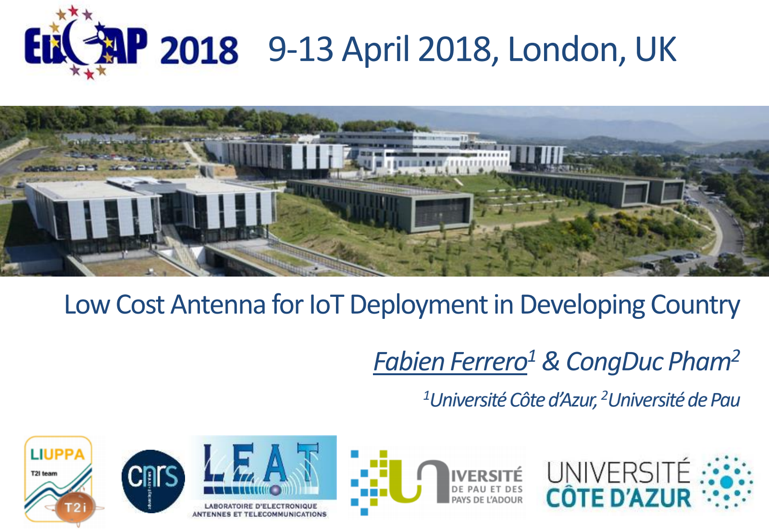
[picture p230: page 1]

Low Cost Antenna for IoT Deployment in Developing Country

Fabien Ferrero¹& CongDuc Pham²

1Université Côte d’Azur, ²Université de Pau

## Outline

- IoT for Developing country : Opportunity and Challenge
- Low-cost Antenna for end-node
- Low-cost Antenna for gateway
- Conclusion and perspectives

## LP-WAN technologies opportunities

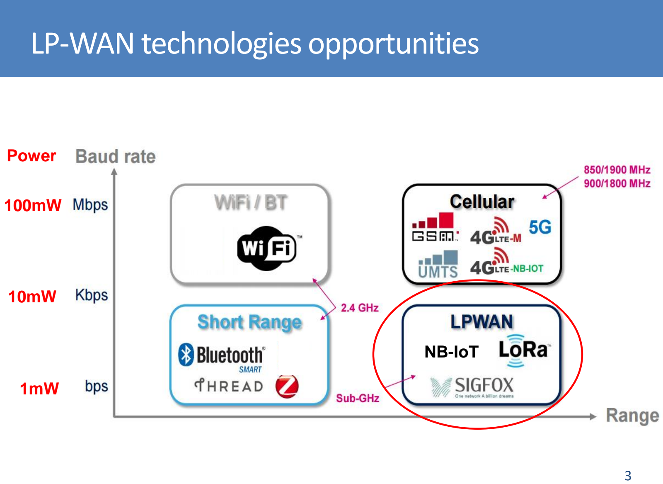
[picture p231: page 3]

NB-IoT

Power

1mW

10mW

100mW

## LP-WAN to improve energy and water access

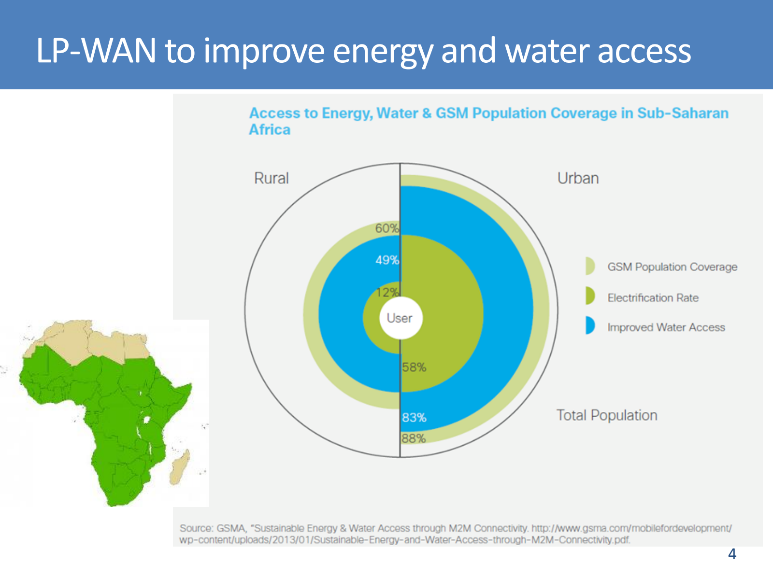
[picture p232: page 4]

## LP-WAN to improve energy and water access

“Give a man a fish and you feed him for a day; teach a man to fish and you feed him for a lifetime”
Chineese Proverb

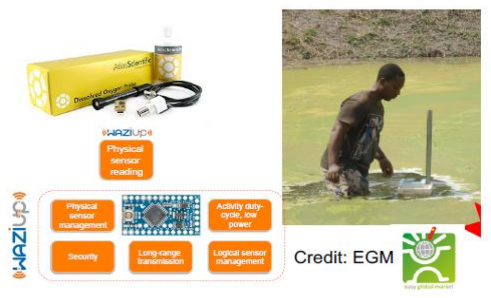
[picture p233: figure]

## Do It Yourself IOT technologies

Widespread implementation of IoT solutions in developing countries are helped by technological and social trends:

- Prices for IoT component have declined by 80-90 per cent over the past 5 years
- Internet penetration is increasing : 35 per cent of people now have access
- Falling cost of smartphones is driving rapid uptake in Internet access in the developing world.

To foster this trends, we can :
- Provide simple and robust building blocks for DIY IoT project
- Develop simple tutorial to help for project implementation
- Initiate Open-source project to prime the pump

What antenna is needed ?
- Low cost, robust and easy to assemble
- Good documentation and tutorial
- Simple and low-cost method to measure and to optimize antenna

## Outline

- IoT for Developing country : Opportunity and Challenge
- Antenna for end-node : LoRa collar
- Antenna for gateway
- Conclusion and perspectives

## Design of cost efficient antenna @868MHz

- LoRa collar for Cattle Rustling applications

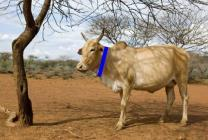
[picture p234: figure]

- Localization using GPS
- Data transmission using LoRa (868MHz)
- Initial solution based on-the-shelf antenna
- New Custom Antenna for LoRa

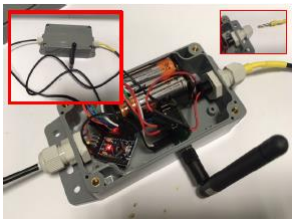
[picture p235: figure]

- Remove RF connectors ( a SMA connector is 4$)
- Avoid external antenna (cost between 2 and 8 $)
- A PCB is needed for component integration
- The cost for an extension of the PCB is negligible,

so PCB integrated antenna is very cost efficient

## Design of cost efficient antenna @868MHz

- LoRa collar for Cattle Rustling applications
- Localization using GPS
- Data transmission using LoRa (868MHz)
- Initial solution based on-the-shelf antenna
- New Custom Antenna for LoRa

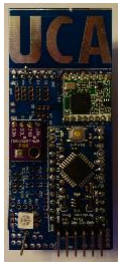
[picture p236: figure]

- Remove RF connectors ( a SMA connector is 4$)
- Avoid external antenna (cost between 2 and 8 $)
- A PCB is needed for component integration
- The cost for an extension of the PCB is negligible,

so PCB integrated antenna is very cost efficient

## UCA Antenna layout @868MHz

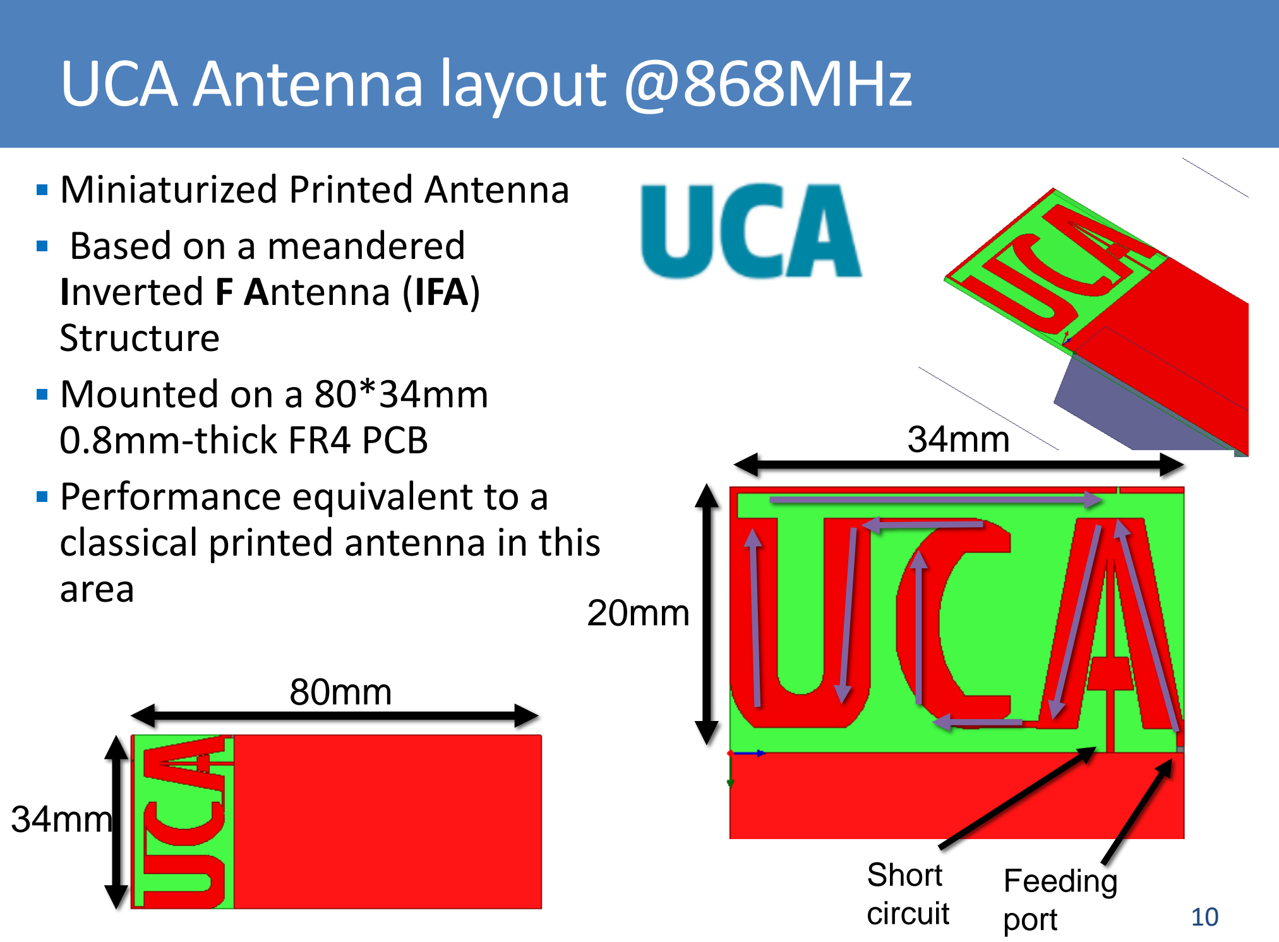
[picture p237: page 10]

- Miniaturized Printed Antenna
- Based on a meandered
Inverted F Antenna (IFA)
Structure
- Mounted on a 80*34mm
0.8mm-thick FR4 PCB
- Performance equivalent to a classical printed antenna in this area

34mm

20mm

34mm

80mm

Short
circuit

Feeding
port


- Antenna simulation
- Matched to 50 ohm
- BW = 30MHz (@-6dB )
- -1.2 dB radiation efficiency (75%)
- Dipole radiation pattern
- 2.1 dBi peak directivity
- 0.9 dBi peak Gain

## UCA Antenna tuned for EU band

## UCA Antenna tuned for EU band

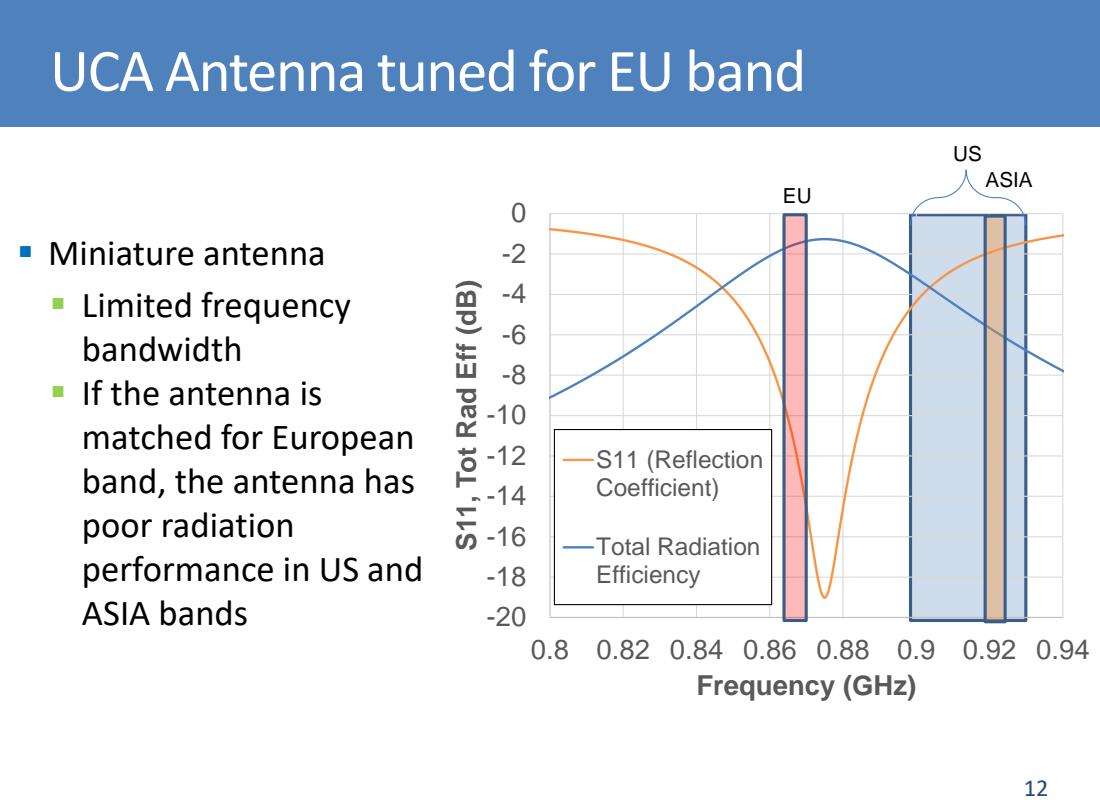
[picture p238: page 12]
ASIA bands; 0.8 0.82 0.84 0.86 0.88 0.9 0.92 0.94 Frequency (GHz); S11 (Reflection Coefficient); Total Radiation Efficiency; ASIA

▪ Miniature antenna
▪ Limited frequency
bandwidth
▪ If the antenna is
matched for European
band, the antenna has
poor radiation
performance in US and

S11, Tot Rad Eff (dB)

- The antenna shape can be easily tuned to different frequencies
- The top line can be cut at different position to change the antenna trace length
- T_ant parameter can be tuned from 0 to 34mm
- Antenna resonance frequency can be tuned from 845 to
950MHz

Small cut in the top
line


T_ant

## Antenna design frequency tuning

## UCA Antenna tuning : Reflection coefficient

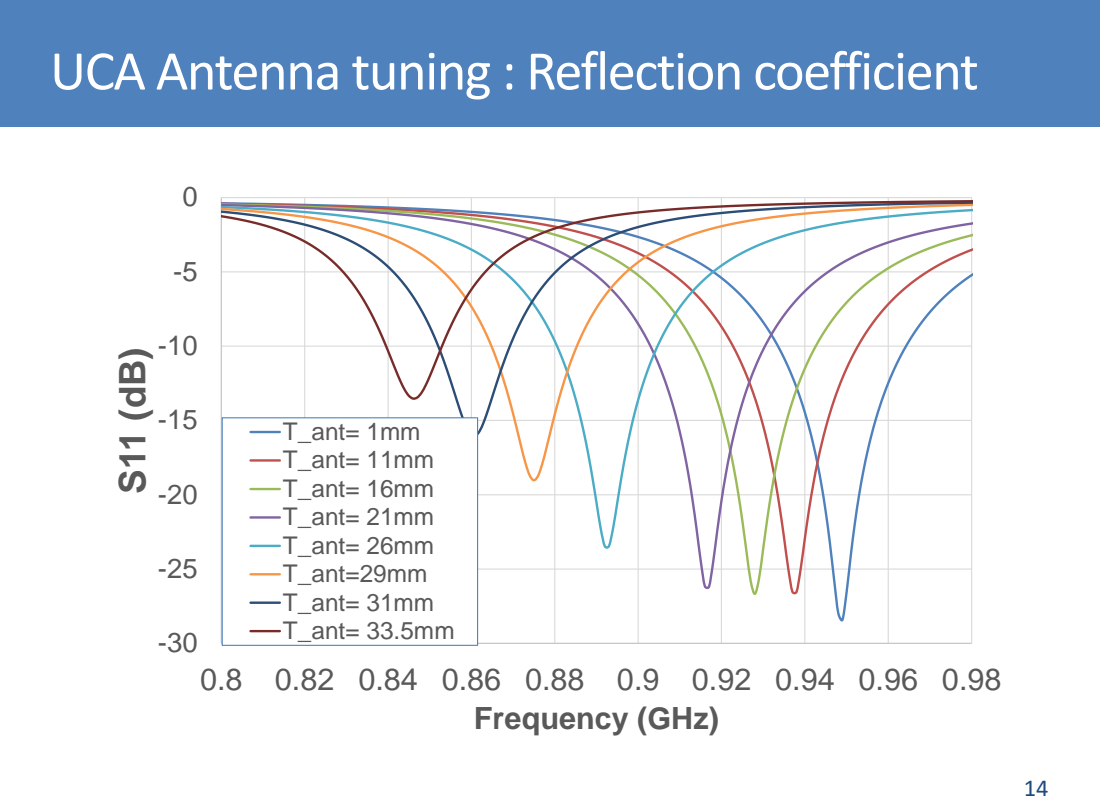
[picture p239: page 14]
Frequency (GHz)

T_ant= 1mm T_ant= 11mm T_ant= 16mm

T_ant= 21mm T_ant= 26mm

T_ant=29mm T_ant= 31mm T_ant= 33.5mm

## UCA Antenna : Linear Total Rad. Efficiency

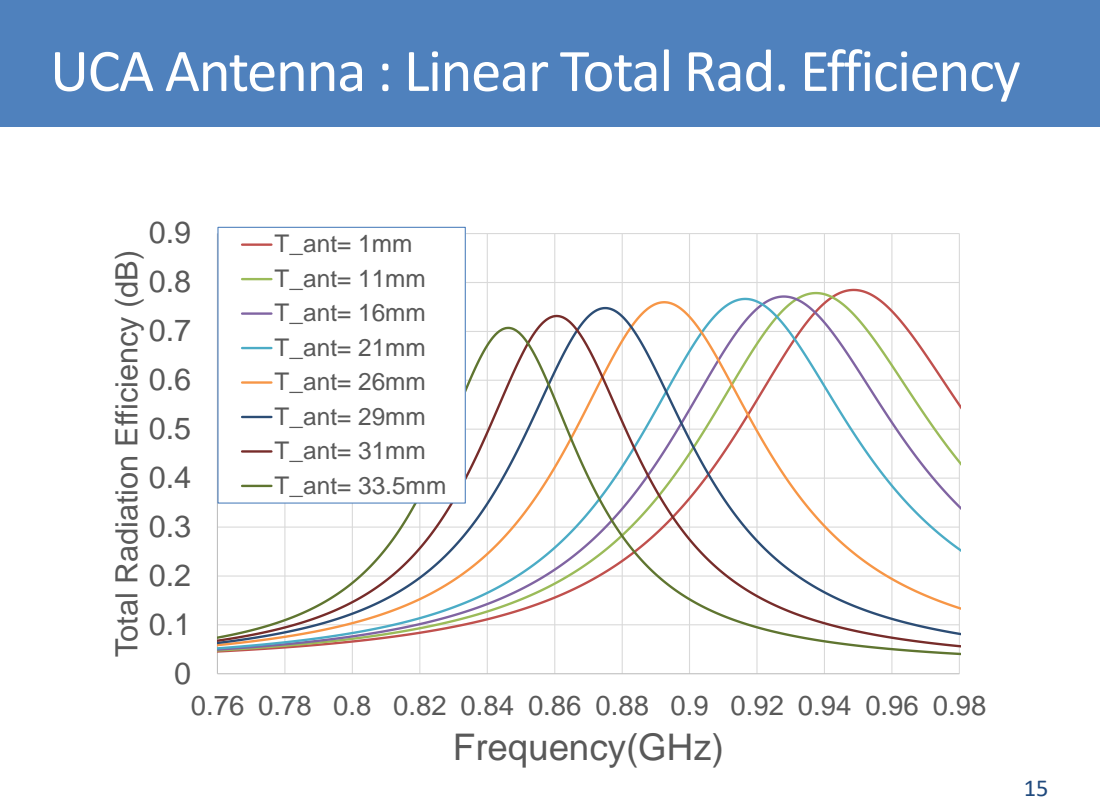
[picture p240: page 15]
0.76 0.78 0.8 0.82 0.84 0.86 0.88 0.9 0.92 0.94 0.96 0.98 Frequency(GHz)

T_ant= 1mm T_ant= 11mm

Total Radiation Efficiency (dB)

T_ant= 16mm
T_ant= 21mm T_ant= 26mm

T_ant= 29mm
T_ant= 31mm
T_ant= 33.5mm

## Comparison with on-the-shelf antenna

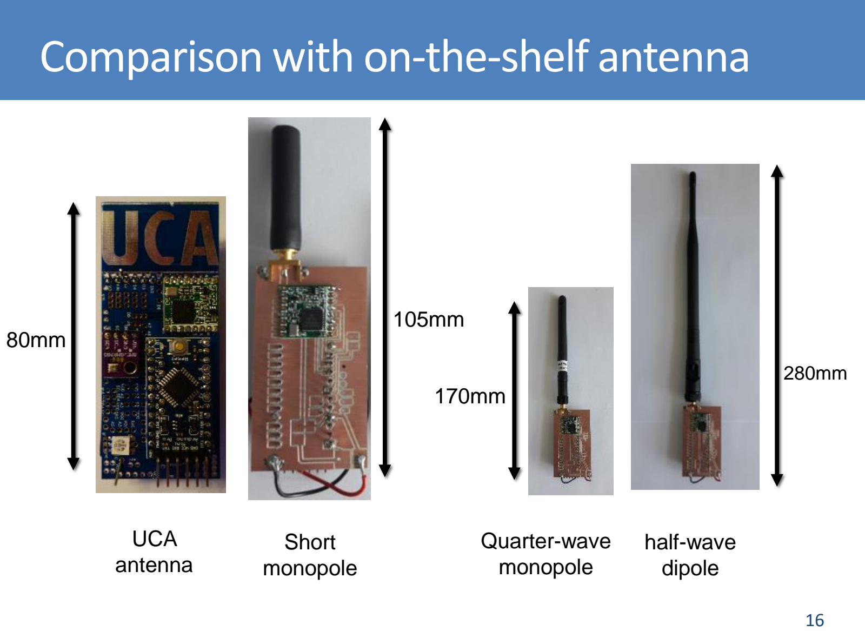
[picture p241: page 16]

80mm

170mm

Short
monopole

Quarter-wave
monopole

280mm

half-wave
dipole

UCA
antenna

105mm

- Measurement on Satimo
Starlab station
- Continuous wave with 14 dBm power from RFM95W module
- Efficiency calculated from the
3D antenna measurement

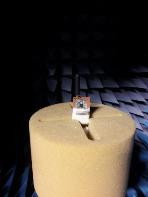
[picture p242: figure]
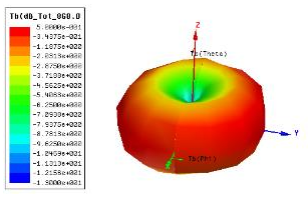
[picture p243: figure]

Antenna structure | EIRP (dBm) | Total efficiency | Max Dimension
Small monopole | 14.7 | 74% | 105 mm
Quarter-wave monop. | 15.7 | 94% | 170 mm
Half-wave dipole | 13.9 | 61% | 280 mm
UCA untuned | 13.8 | 60% | 80mm
UCA after tuning | 14.8 | 76% | 80mm

## Comparison with on-the-shelf antenna

https://github.com/FabienFerrero/UCA_Board

## DIY Integration : Tutorial to fabricate the collar

Complete tutorial to fabricate this collar :

- https://github.com/CongducPham/tutorials/blob/master/Low-cost-LoRa-Collar.pdf

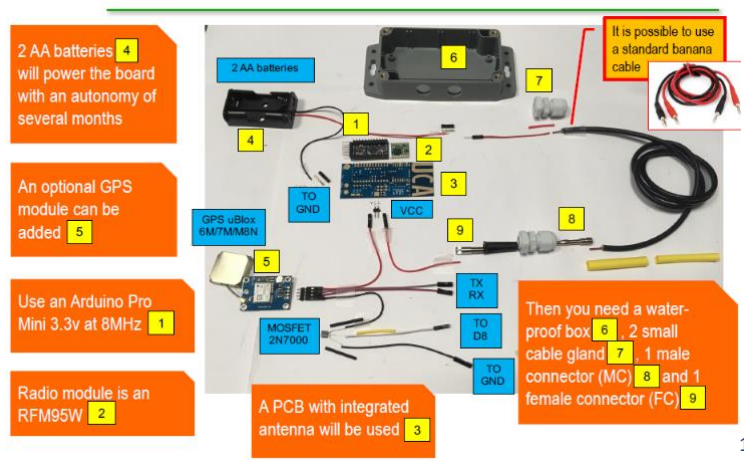
[picture p244: figure]

## DIY Integration : Tutorial to fabricate the collar

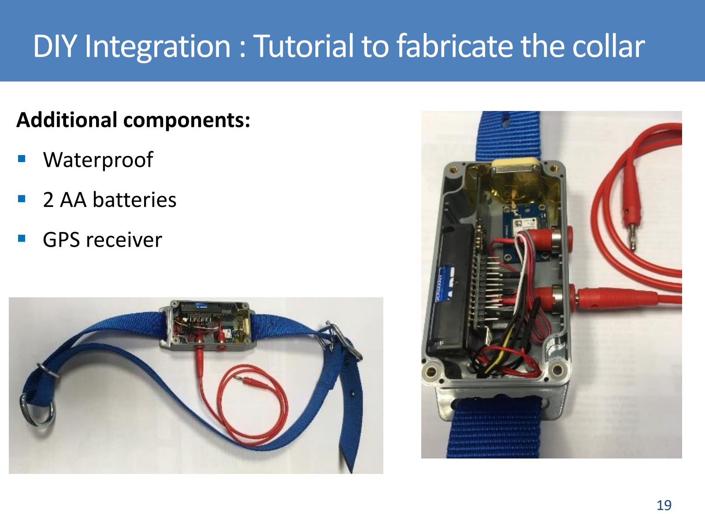
[picture p245: page 19]

Additional components:
- Waterproof
- 2 AA batteries
- GPS receiver

## DIY Integration : Tutorial to fabricate the collar

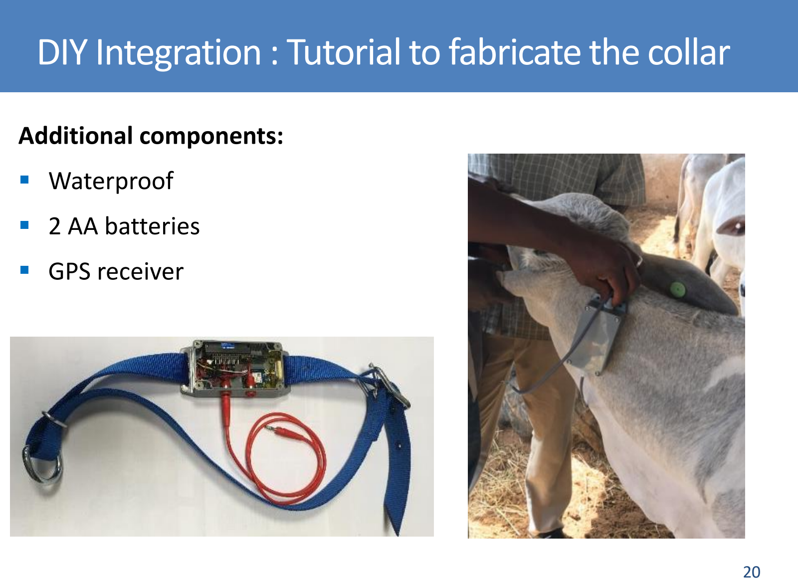
[picture p246: page 20]

Additional components:
- Waterproof
- 2 AA batteries
- GPS receiver

## Outline

- IoT for Developing country : Opportunity and Challenge
- Antenna for end-node
- Antenna for gateway
- Conclusion and perspectives

## Antenna with cable

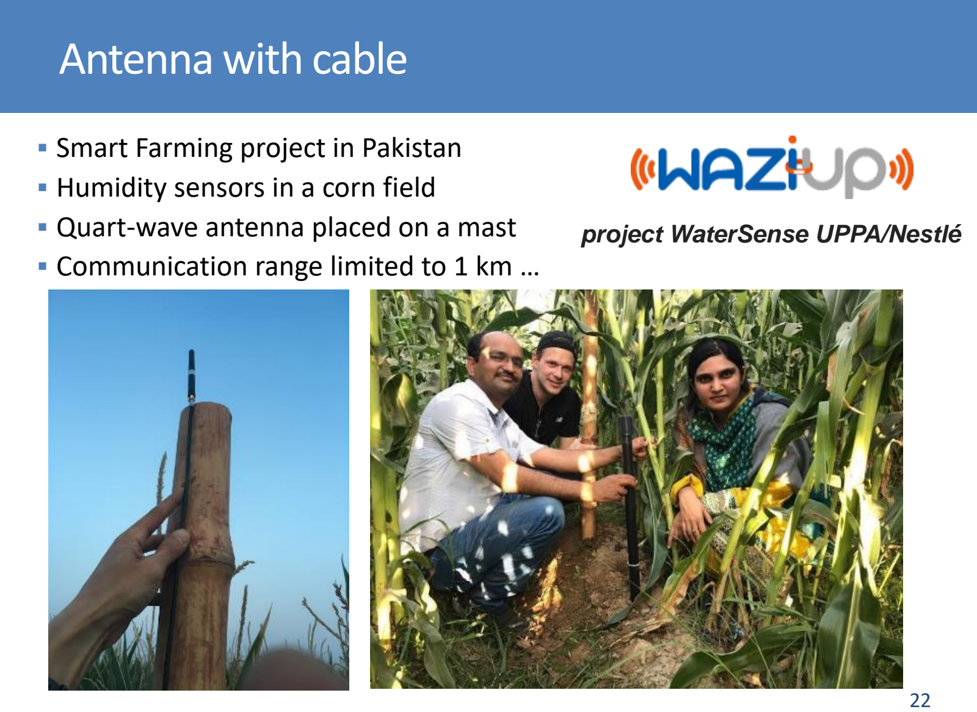
[picture p247: page 22]

- Smart Farming project in Pakistan
- Humidity sensors in a corn field
- Quart-wave antenna placed on a mast
- Communication range limited to 1 km … project WaterSense UPPA/Nestlé

## Antenna with cable

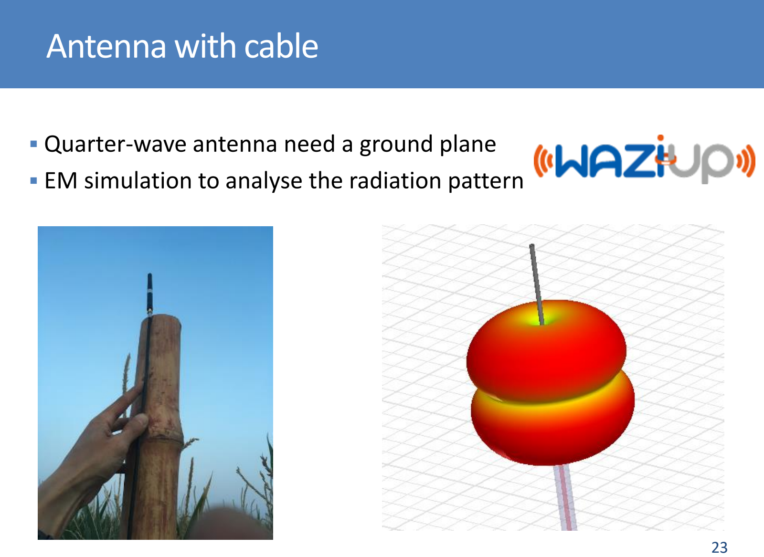
[picture p248: page 23]

- Quarter-wave antenna need a ground plane
- EM simulation to analyse the radiation pattern

## Antenna with cable

- Nulls in the radiation pattern
- Reduced Gain in the direction of the gateway (-14 dBi)
- Caused by current flowing on the shield on the coaxial cable
- Need to use a balanced antenna with a balun like a sleeve dipole

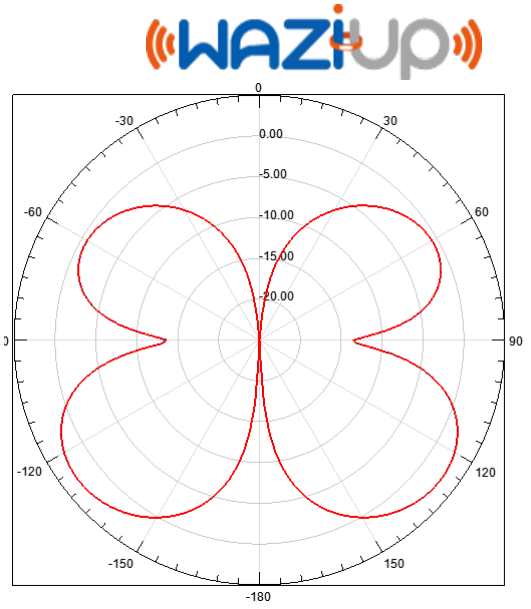
[picture p249: figure]

Total Gain Elevation plane

## Half-wave dipole Antenna

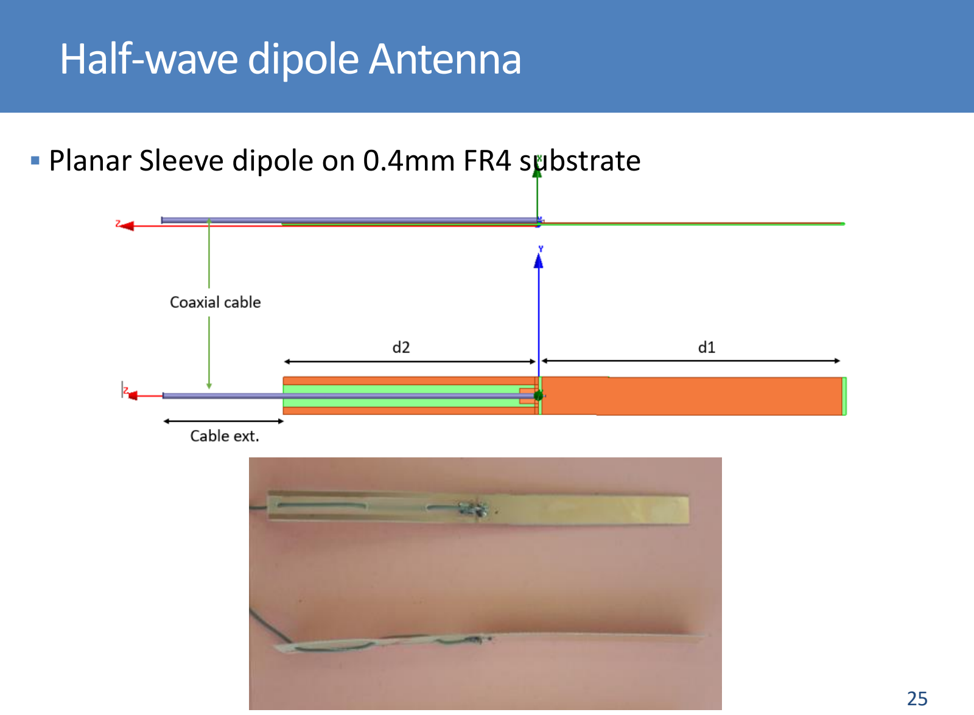
[picture p250: page 25]

- Planar Sleeve dipole on 0.4mm FR4 substrate

## Comparison with on-the-shelf antenna

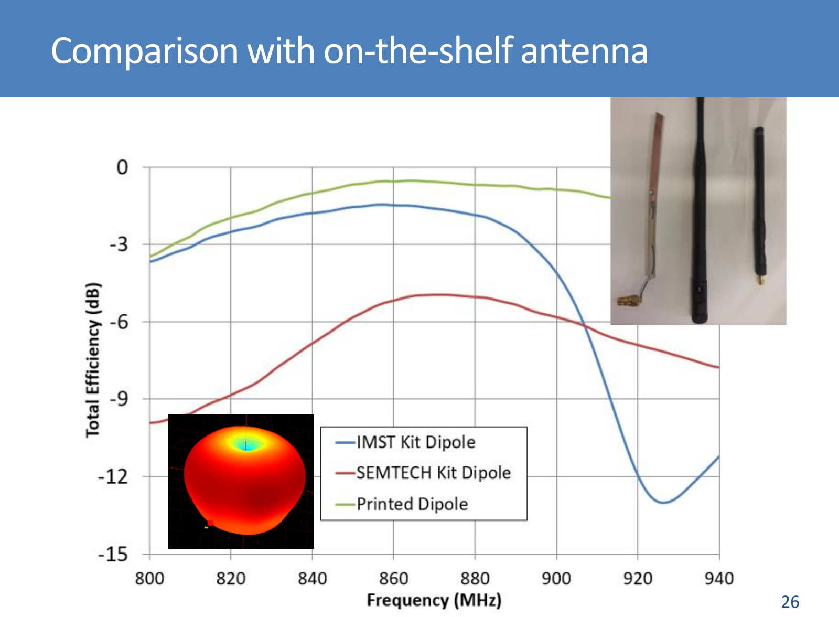
[picture p251: page 26]

## Outline

- IoT for Developing country : Opportunity and Challenge
- Antenna for end-node
- Antenna for gateway
- Conclusion and perspectives

## Conclusion and Perspectives

- DIY project need low-cost and simple antenna
- Great opportunity for education

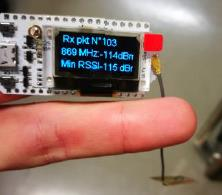
[picture p252: figure]
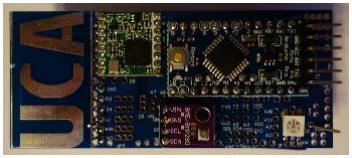
[picture p253: figure]

- Dual-band antenna for 433 and 868MHz
- Low-cost localization based on LoRa signal
- Need simple measurement method to tune the antenna

## Laboratory of Electronics Antennas and Telecommunications

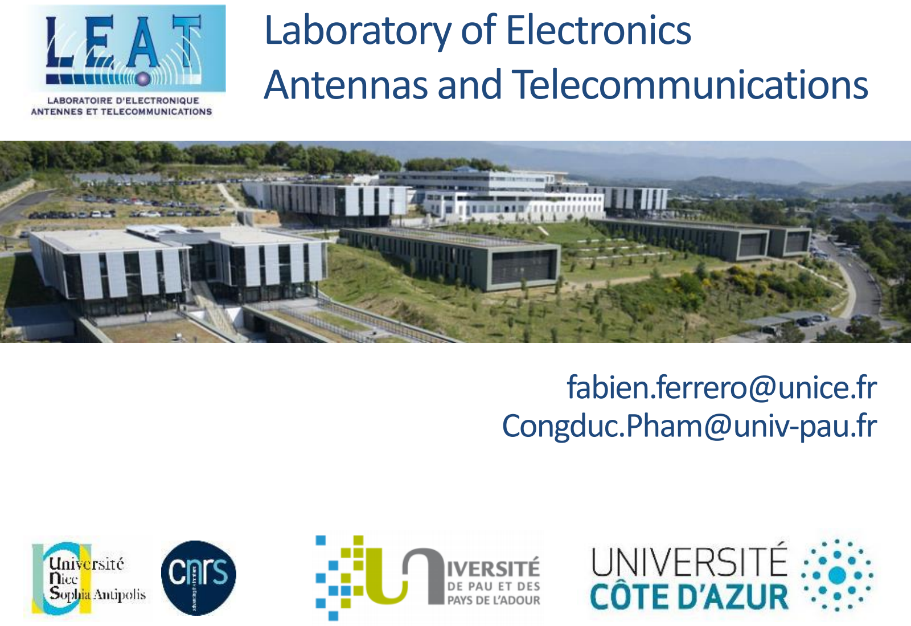
[picture p254: page 29]

fabien.ferrero@unice.fr
Congduc.Pham@univ-pau.fr

## Do It Yourself IOT technologies

IoT create substantial changes for populations in emerging and developing countries.

The prospects for widespread implementation of IoT solutions in development contexts are helped by broader technological and social trends:
- Prices for sensors, an integral component of IoT applications, have declined by about 80-90 per cent over the past five years.
- Internet penetration in developing countries is increasing. 35 per cent of people in developing countries now have access to the Internet.
- falling cost of smartphones is driving rapid uptake in Internet access in the developing world. Across emerging and developing countries, a median average of 24 per cent of the population now owns such a device.

## Do It Yourself IOT technologies

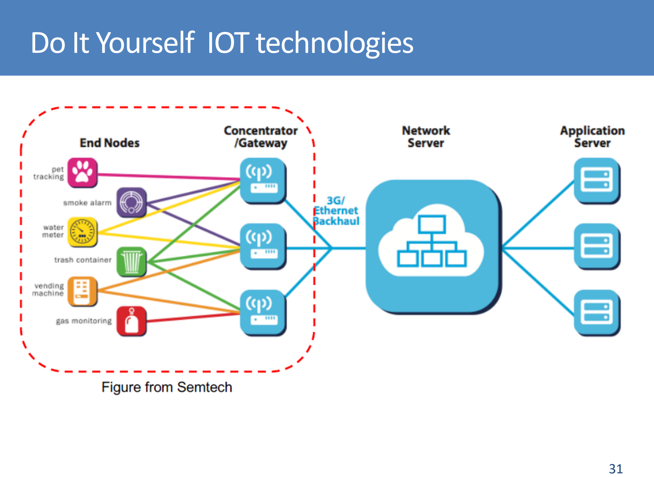
[picture p255: page 31]
