FabienFerrero/UCA_Board/documents/Conferences/TTN_UCA_02_2018.pdf

## Laboratory of Electronics Antennas and Telecommunications

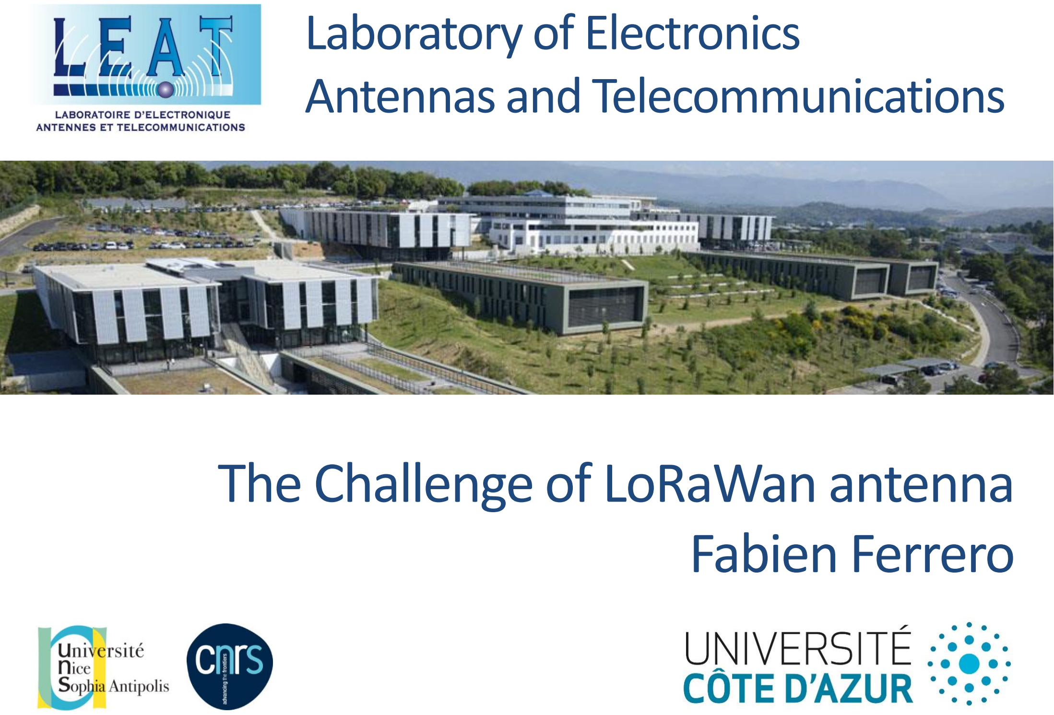
[picture p256: page 1]

## The Challenge of LoRaWan antenna Fabien Ferrero

## Outline

- Why antenna is important ? A practical example
- Antenna key parameters
- Low-cost Antenna Open Source project
- Micro-tracker Antenna Industrial project
- Conclusion and perspectives

## Antenna isimportant for communication range

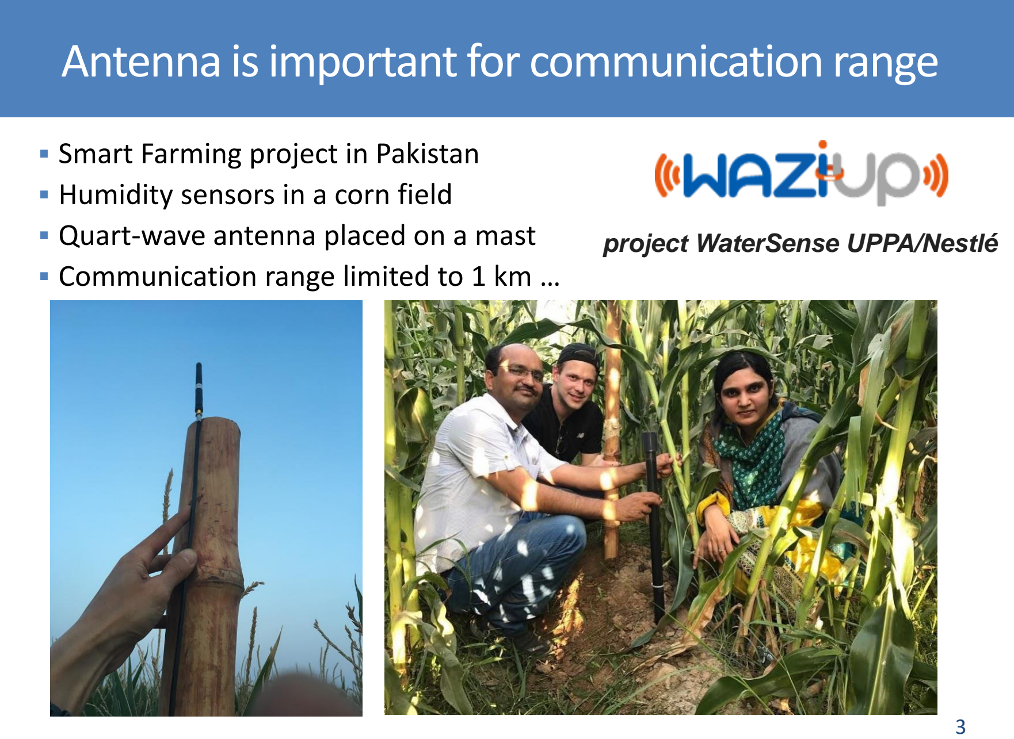
[picture p257: page 3]

- Smart Farming project in Pakistan
- Humidity sensors in a corn field
- Quart-wave antenna placed on a mast
- Communication range limited to 1 km … project WaterSense UPPA/Nestlé

## Antenna isimportant for communication range

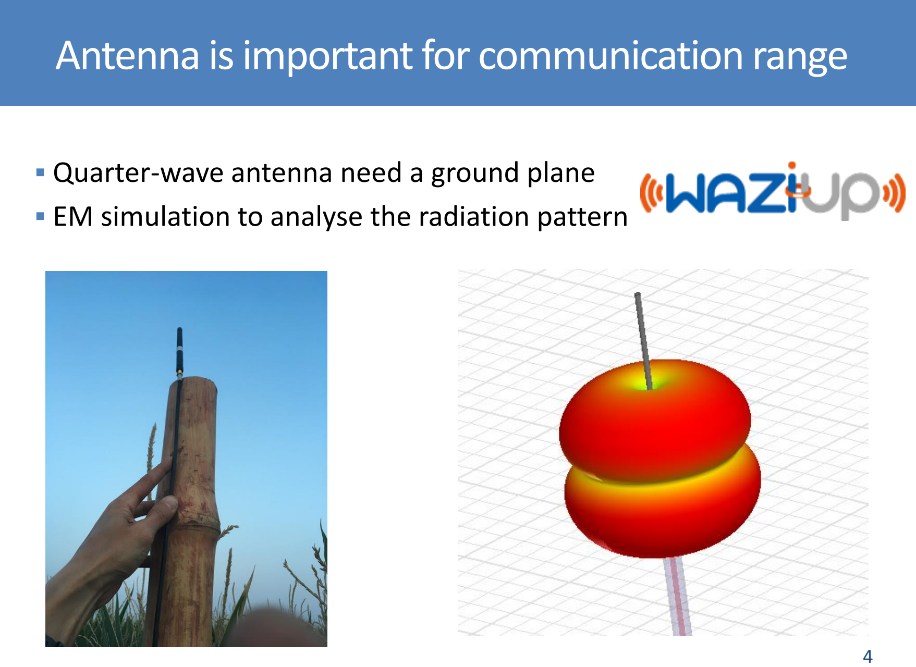
[picture p258: page 4]

- Quarter-wave antenna need a ground plane
- EM simulation to analyse the radiation pattern

## Antenna isimportant for communication range

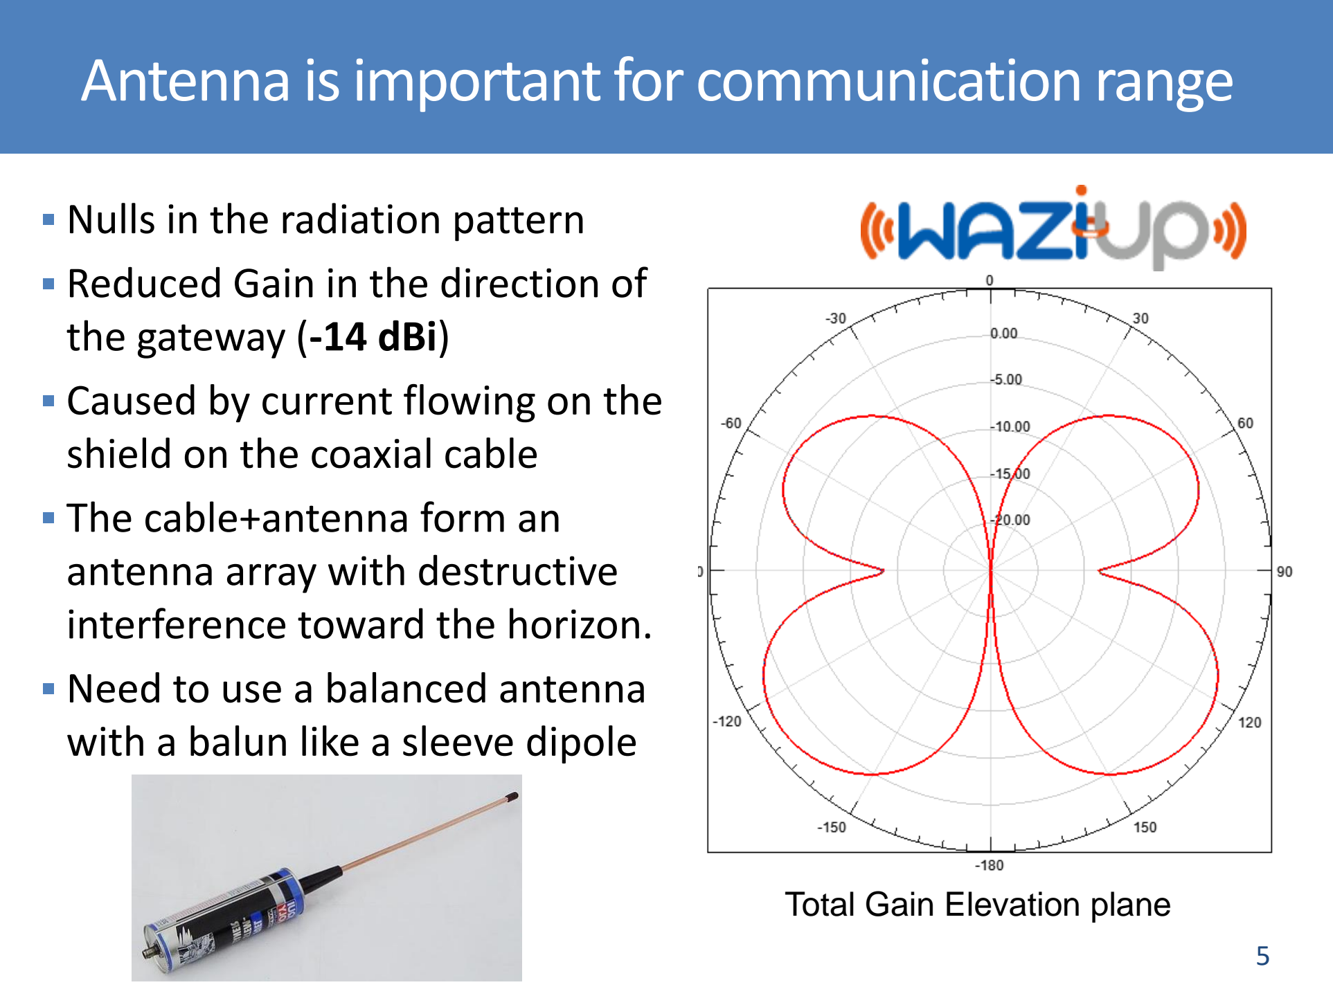
[picture p259: page 5]

- Nulls in the radiation pattern
- Reduced Gain in the direction of the gateway (-14 dBi)
- Caused by current flowing on the shield on the coaxial cable
- The cable+antenna form an antenna array with destructive interference toward the horizon.
- Need to use a balanced antenna with a balun like a sleeve dipole

Total Gain Elevation plane

## Outline

- Why antenna is important ? A practical exemple
- Antenna key parameters
- Low-cost Antenna Open Source project
- Micro-tracker Antenna Industrial project
- Conclusion and perspectives

- Definition :
- Ps

: Power from the source
- Pref : Power reflected by the antenna
- Prad power radiated by the antenna
- Antenna Performance Indicator
- Reflection coefficient
- S11 is usually plotted in dB scale
- S11 criteria from -10 dB to -6dB (90% to 75% transmitted power)
- Total Efficiency
- Include matching and radiation loss
- Can be plotted in linear or dB scale
- 30-70% classically observed
- Gain
- Include matching, radiation loss and directivity
- Plotted in dBi
- U θ,φ is the radiation intensity in a given direction

50 ohm
source
N°1

Ps

Pref

Prad

|S11|

2 = Pref/Ps

ηt = Prad/Ps

## Antenna performance indicator

## G(θ,φ) =

## U θ, φ Ps/4π

### ▪Antenna is a resonnant structure :

- Input impedance is changing with frequency
- Limited frequency bandwidth
- Miniature antenna can have a low efficiency due to metallic or dielectric losses

### ▪Antenna is an open structure

- Compare to electronic components, antenna is strongly influenced by its surrounding environment
- For integrated antenna, the electromagnetic wave is generated by the antenna and by the terminal ground plane
- Small antenna has to be carefully tuned

Trade-off

Efficiency

Size | Bandwidth

## Antenna key parameters


## Antenna key parameters

Efficiency

Size | Bandwidth
Bandwidth | Size

Efficiency

Directivity | Sensitivity

Multidimensional Constraints

## How much can I radiate ?

- Regulators defines the maximum radiated power in Equivalent Radiated Power (ERP)
In Europe : ERP @868MHz is 14 dBm
- Effective Radiated Power : amount of power applied to a half-wave dipole to give the same power density at a given point
- Effective Isotropic Radiated Power : the reference is an isotropic radiator
EIRP = ERP + 2 dB

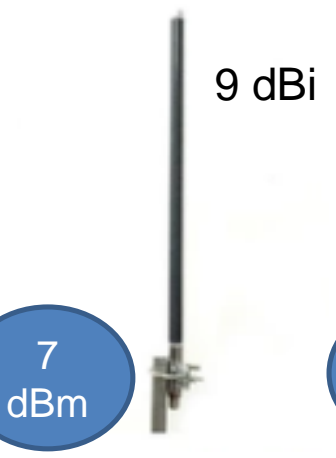
[picture p260: figure]
7 dBm
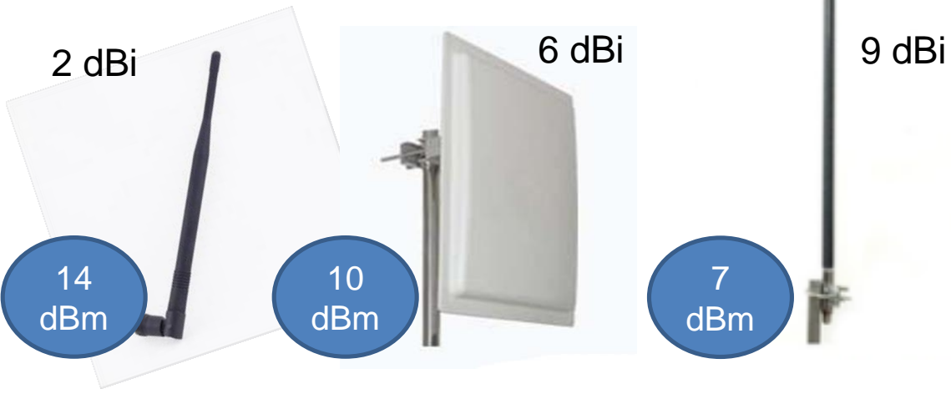
[picture p261: figure]
14 dBm; 10 dBm; 2 dBi; 6 dBi; 9 dBi

-1 dBi
Gain:

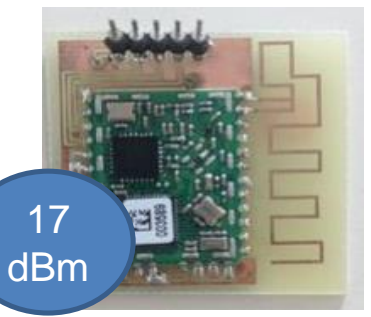
[picture p262: figure]
17 dBm

Ps


▪Antennas can be:
- Dual-pole : 2 parts will

## Effect of terminal chassis

contribute to the radiation ▪ Single-pole with a large ground plane; Half-wave; > 2 wavelengths @868MHz > 70cm
Quarter-wave

- In most of the case, you will have a dual-pole antenna

## Effect of terminal chassis


Half-wave


- LoRa (868MHz) and GPS (1575MHz) antenna on small terminal

## Effect of terminal chassis


Device
size

25mm

11mm

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
20 | 30 | 40 | 50 | 60 | 70 | 80

Total Efficiency (dB)

Device Size (mm)

LoRa

GPS

## Effect of the environment

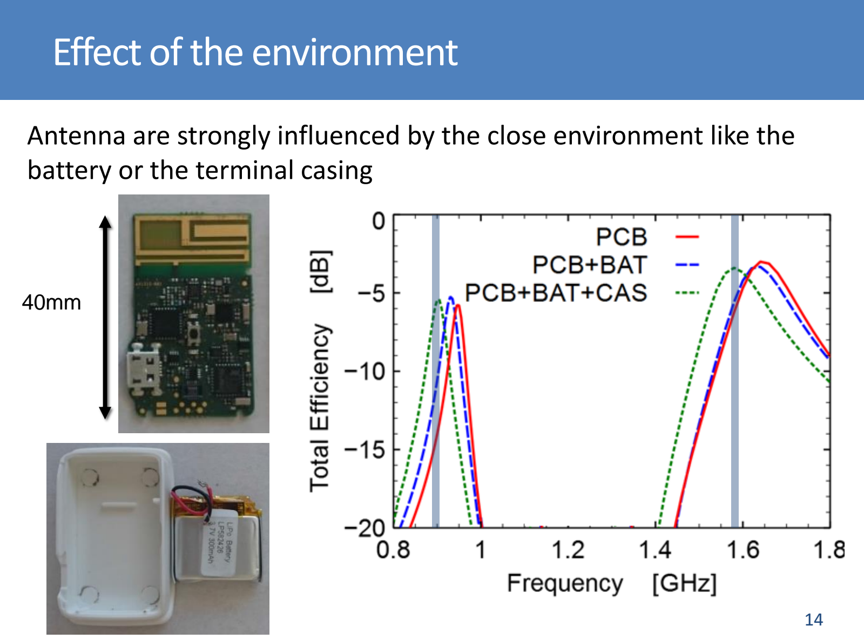
[picture p263: page 14]

Antenna are strongly influenced by the close environment like the battery or the terminal casing

40mm

## Effect of the environment

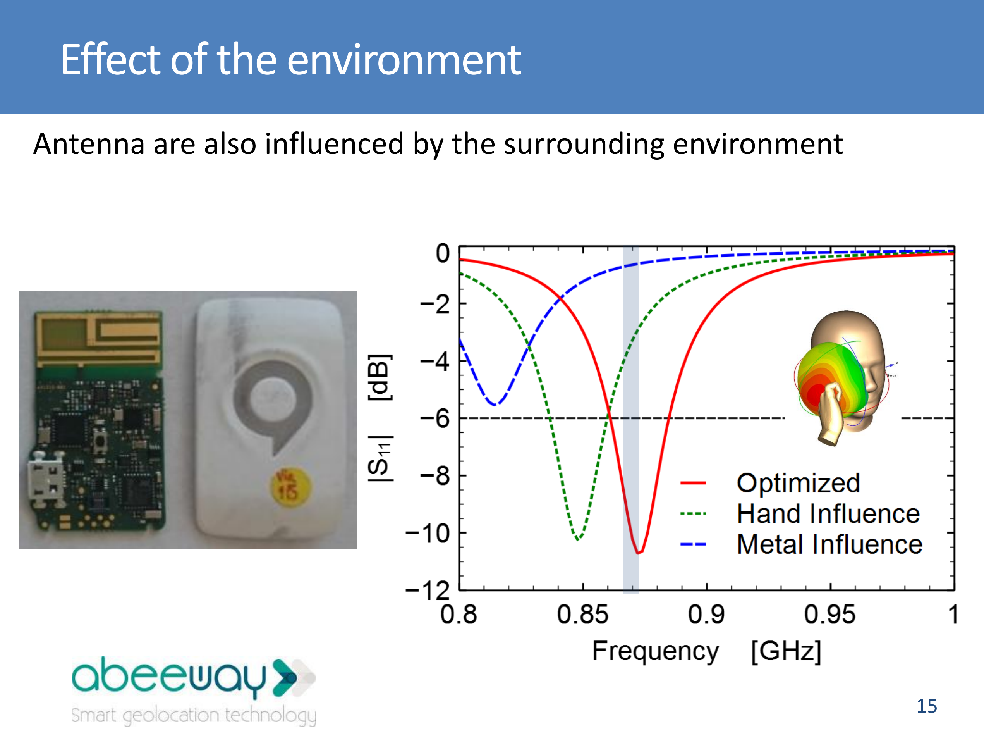
[picture p264: page 15]

Antenna are also influenced by the surrounding environment

## Antenna measurement

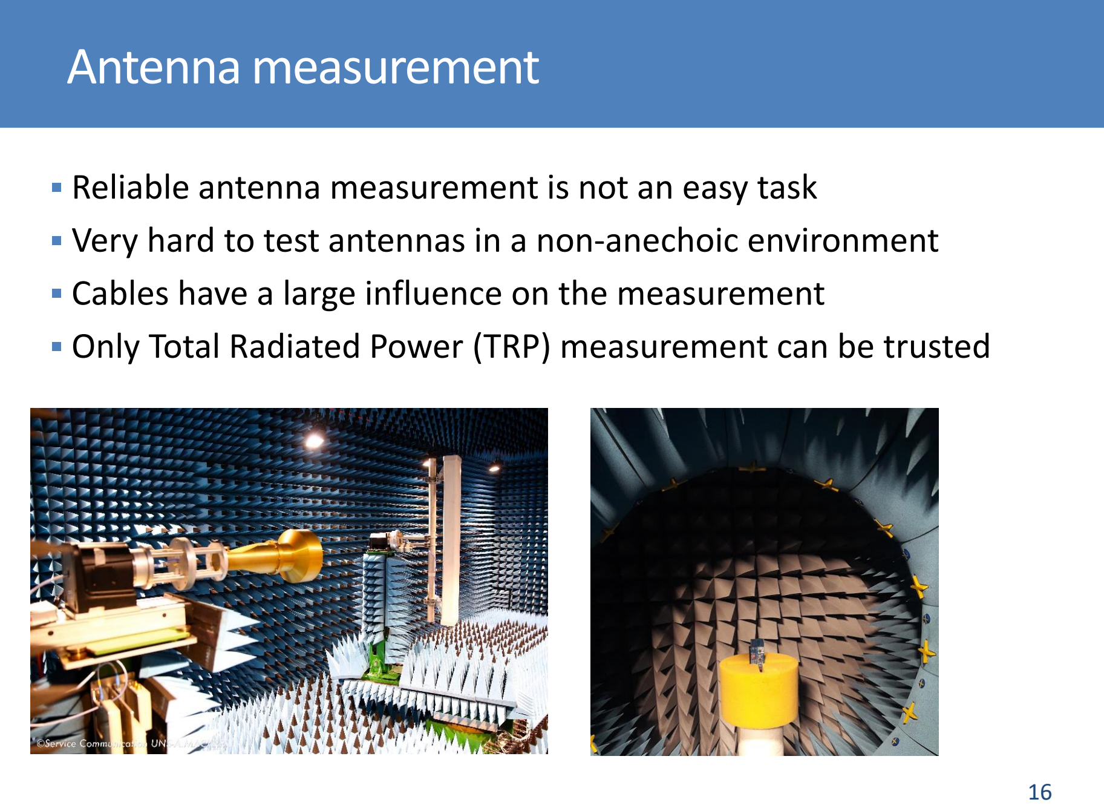
[picture p265: page 16]

- Reliable antenna measurement is not an easy task
- Very hard to test antennas in a non-anechoic environment
- Cables have a large influence on the measurement
- Only Total Radiated Power (TRP) measurement can be trusted

## Outline

- Why antenna is important ? A practical exemple
- Antenna key parameters
- Low-cost Antenna Open Source project
- Micro-tracker Antenna Industrial project
- Conclusion and perspectives

## Design of cost efficient antenna @868MHz

- LoRa collar for Cattle Rustling applications


- Cost reduction
- Remove RF connectors ( a SMA connector is 4$)
- Avoid external antenna (cost between 2 and 8 $)
- A PCB is needed for component integration
- The cost for an extension of the PCB is negligible, so

PCB integrated antenna is very cost efficient


## UCA Antenna layout

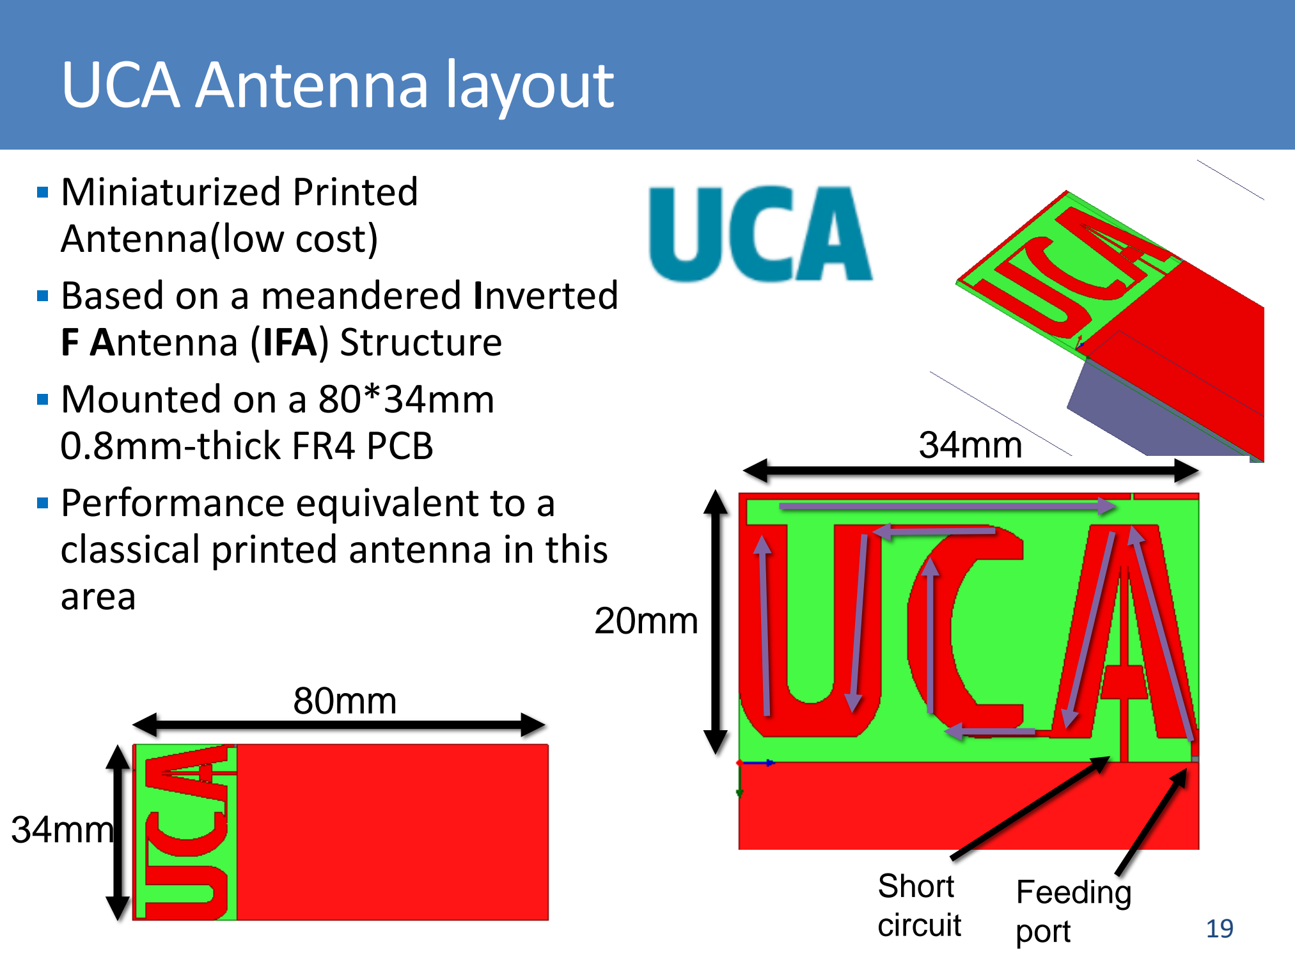
[picture p266: page 19]

- Miniaturized Printed
Antenna(low cost)
- Based on a meandered Inverted F Antenna (IFA) Structure
- Mounted on a 80*34mm
0.8mm-thick FR4 PCB
- Performance equivalent to a classical printed antenna in this area

34mm

20mm

34mm

80mm

Short
circuit

Feeding
port

- Antenna simulation


- Matched to 50 ohm
- Bw = 30MHz (@-6dB )
- -1.2 dB radiation efficiency

(75%)

- Dipole radiation pattern
- 2.1 dBi peak directivity
- 0.9 dBi peak Gain

## UCA Antenna tuned for EU band

## UCA Antenna tuned for EU band

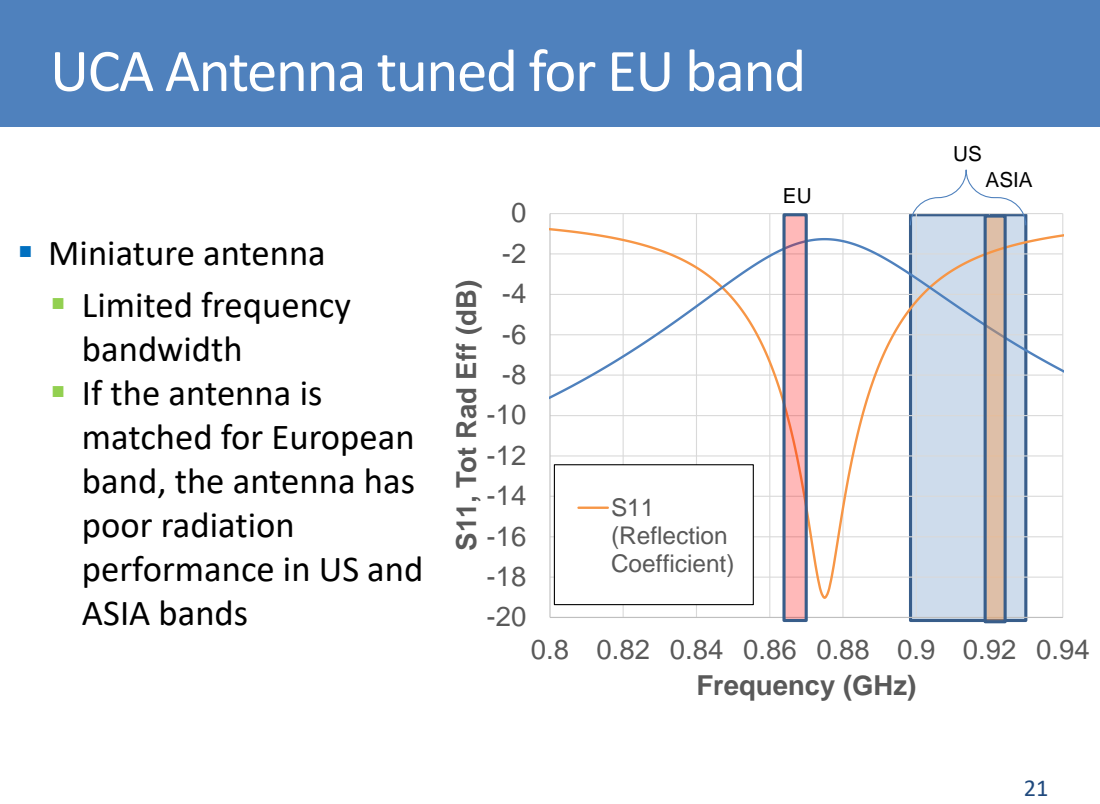
[picture p267: page 21]
ASIA bands; 0.8 0.82 0.84 0.86 0.88 0.9 0.92 0.94 Frequency (GHz); ASIA

▪ Miniature antenna
▪ Limited frequency
bandwidth
▪ If the antenna is
matched for European
band, the antenna has
poor radiation
performance in US and

S11, Tot Rad Eff (dB)

S11 (Reflection

Coefficient)

- The antenna shape can be easily tuned to different frequencies
- The top line can be cut at different position to change the antenna trace length
- T_ant parameter can be tuned from 0 to 34mm
- Antenna resonance frequency can be tuned from 845 to
950MHz

Small cut in the top
line


T_ant

## Antenna design

## UCA Antenna tuning : Reflection coefficient

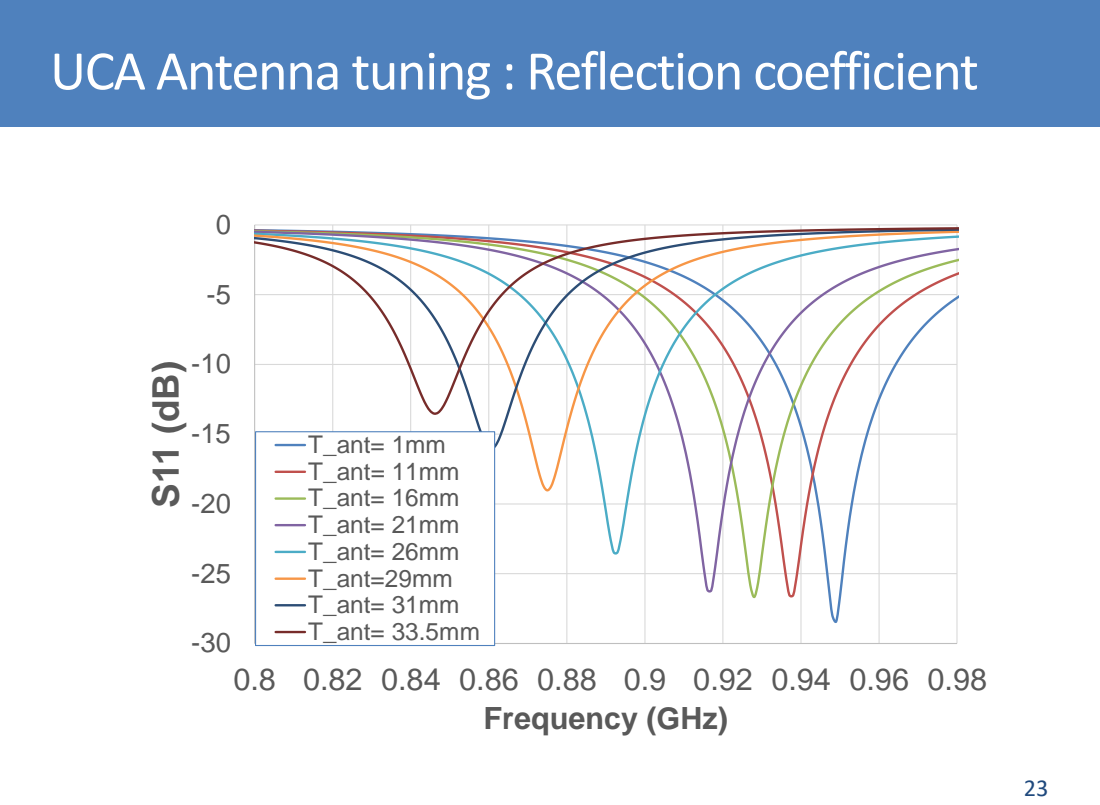
[picture p268: page 23]
Frequency (GHz)

T_ant= 1mm T_ant= 11mm T_ant= 16mm

T_ant= 21mm T_ant= 26mm

T_ant=29mm T_ant= 31mm T_ant= 33.5mm

## UCA Antenna : Linear Total Rad. Efficiency

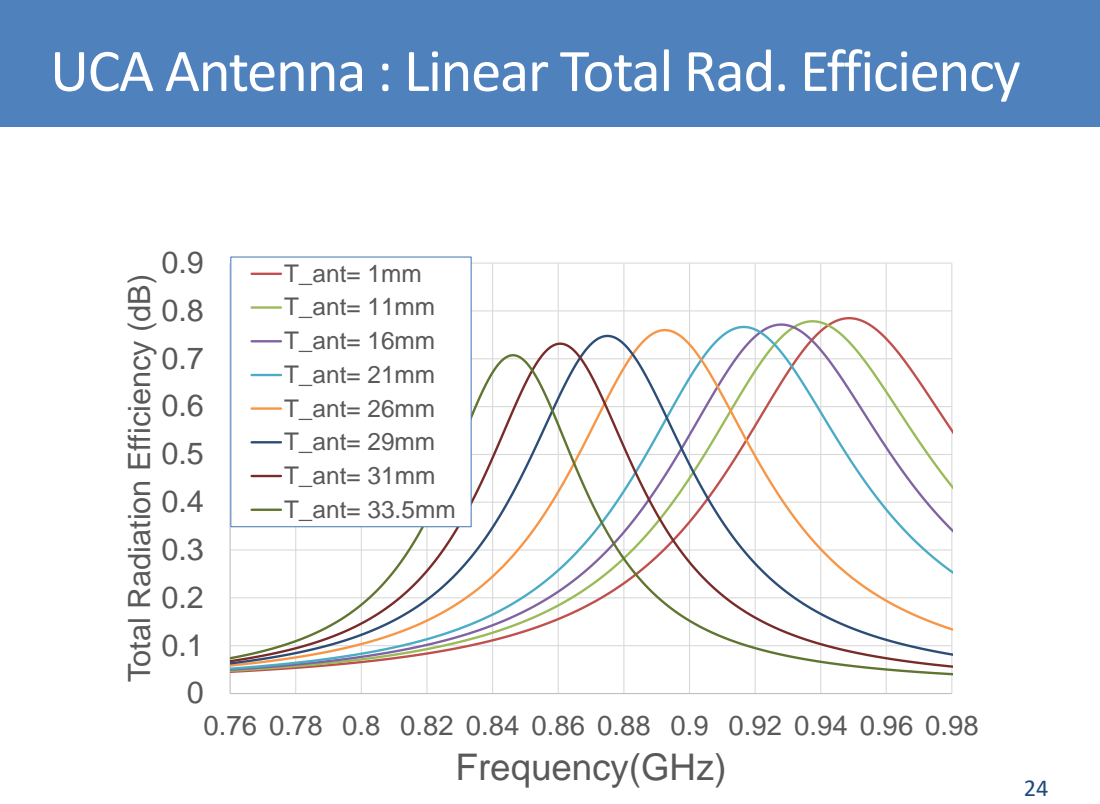
[picture p269: page 24]
0.76 0.78 0.8 0.82 0.84 0.86 0.88 0.9 0.92 0.94 0.96 0.98 Frequency(GHz)

Total Radiation Efficiency (dB)

T_ant= 1mm T_ant= 11mm

T_ant= 16mm
T_ant= 21mm
T_ant= 26mm T_ant= 29mm

T_ant= 31mm
T_ant= 33.5mm

## Comparison with on-the-shelf antenna

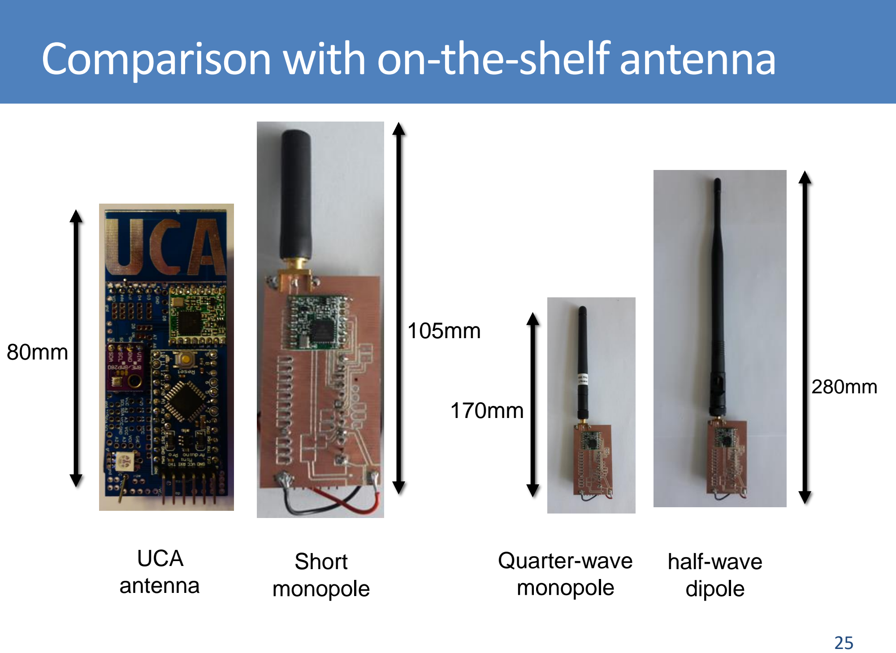
[picture p270: page 25]

80mm

170mm

Short
monopole

Quarter-wave
monopole

280mm

half-wave
dipole

UCA
antenna

105mm

- Measurement on Satimo
Starlab station
- Continuous wave with 14 dBm power from RFM95W module
- Efficiency calculated from the
3D antenna measurement


Antenna structure | TRP (dBm) | Total efficiency | Max Dimension
Small monopole | 14.7 | 74% | 105 mm
Quarter-wave monop. | 15.7 | 94% | 170 mm
Half-wave dipole | 13.9 | 61% | 280 mm
UCA untuned | 13.8 | 60% | 80mm
UCA after tuning | 14.8 | 76% | 80mm

## Comparison with on-the-shelf antenna

https://github.com/FabienFerrero/UCA_Board

## Outline

- Why antenna is important ? A practical example
- Antenna key parameters
- Low-cost Antenna Open Source project
- Micro-tracker Antenna Industrial project
- Conclusion and perspectives

## Micro-tracker Antenna Industrial project


- Specs
- LoRa 868 or 915MHz
- WiFi/BLE (2.4GHz)
- GPS L1
- Terminal size: 50*28mm²
- Proposed solution
- Dual-band LoRa/GPS
- SP4T to switch between LoRa Rx/Tx/Txboost and GPS.
- WiFi/BLE antenna (2.4-2.48 GHz)

## Micro-tracker Antenna Industrial project


LoRa/GPS
13*28mm²

WiFi/BLE
5*5mm²

13mm

## Micro-tracker Antenna Industrial project


- Total Efficiency LoRa -4 dB (40%)
- Total Efficiency GPS -1.5 dB (70%)
- Total Efficiency WiFi/BLE -1.5 dB (70%)

## Micro-tracker Antenna Industrial project

Radiation pattern


## Micro-tracker Antenna Industrial project


Measurements :
- LoRa : Peak Gain -1.5dBi
- BLE/WiFi : Peak Gain 0.5 dBi
- GPS : Estimated at 0dB from anechoic chamber measurement with GPS protocol tester.

## Outline

- Why antenna is important ? A practical exemple
- Antenna key parameters
- Low-cost Antenna Open Source project
- Micro-tracker Antenna Industrial project
- Conclusion and perspectives

## Conclusion and Perspectives

- Take care of your antenna, else your project might fail
- With a carefull design, antenna can be low-cost and good
- Advanced matching network can be used to enlarge bandwidth
- Reconfigurable antenna using RF switch can be a good solution to compensate environment effect or to add antenna diversity

## REFERENCES

- C. Pham, F. Ferrero, M. Diop, L. Lizzi, O. Dieng, O. Thiaré, "Low-cost Antenna Technology for
LPWAN IoT in Rural Applications", Proceedings of the 7th IEEE International Workshop on Advances (http://cpham.perso.univ-pau.fr/Paper/IWASI17.pdf) in Sensors and Interfaces (IWASI'17), Vieste, Italy, June 15-16, 2017.
- F. Ferrero, L. Lizzi, C. Danchesi and S. Boudaud, "Environmental sensitivity of miniature antennas for IoT devices," 2016 IEEE International Symposium on Antennas and Propagation (APSURSI), Fajardo, 2016, pp. 1749-1750.
- H. Berrada, F. Ferrero, L. Lizzi, C. Danchesi and S. Boudaud, "Characterization of miniature antenna for sub-GHz on-body applications," 2017 IEEE International Symposium on Antennas and Propagation & USNC/URSI National Radio Science Meeting, San Diego, CA, 2017, pp. 2001-2002.
- Juan Nogueira Nine, Stephane Boudaud, Fabien Ferrero and Leonardo Lizzi, “LPWAN as Enabler for Widespread Geolocation Solutions”, Embedded World 2017, Nuremberg, Germany

Thanks to Cong Duc Pham for sharing the nice pictures and use cases

Thanks to Christophe Danchesi and Stephane Boudaud from Abeeway for sharing the micro-tracker pictures

Thanks to Juan Nogueira for the nice pictures from Flex

And Thanks to Leonardo Lizzi from UCA for contributing on most on this work

## Laboratory of Electronics Antennas and Telecommunications


fabien.ferrero@unice.fr
leat.unice.fr
