FabienFerrero/UCA_Board/documents/Labs/Lab2_Understanding_LoRa_modulation.pdf

# Lab2 Understanding LoRa modulation

F. Ferrero

## LoRa modulation is based on CSS

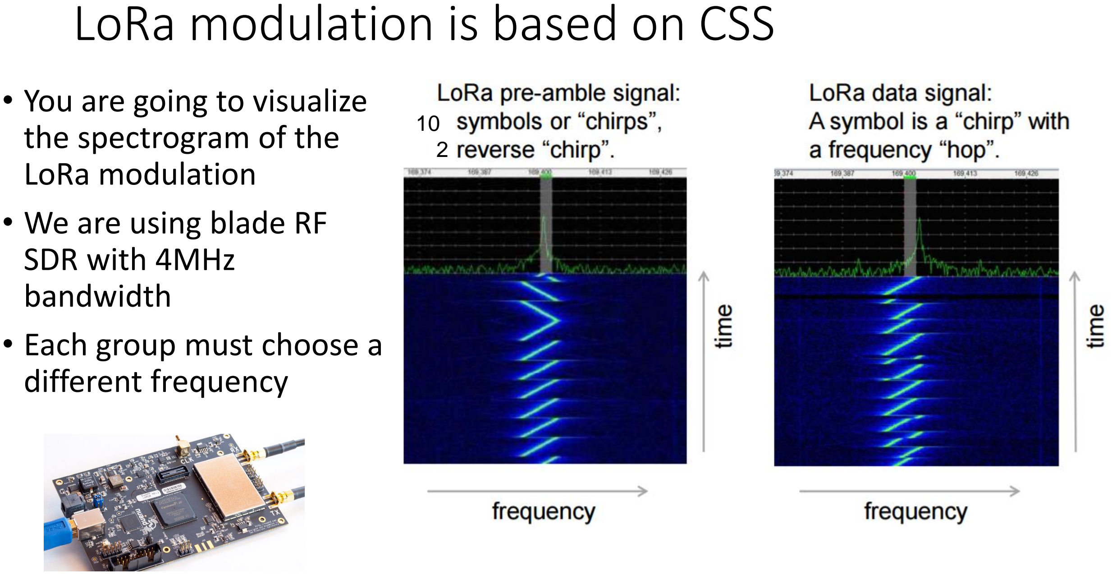
[picture p271: page 2]

- You are going to visualize the spectrogram of the
LoRa modulation
- We are using blade RF
SDR with 4MHz
bandwidth
- Each group must choose a different frequency

2

10

## LoRa modulation is based on CSS

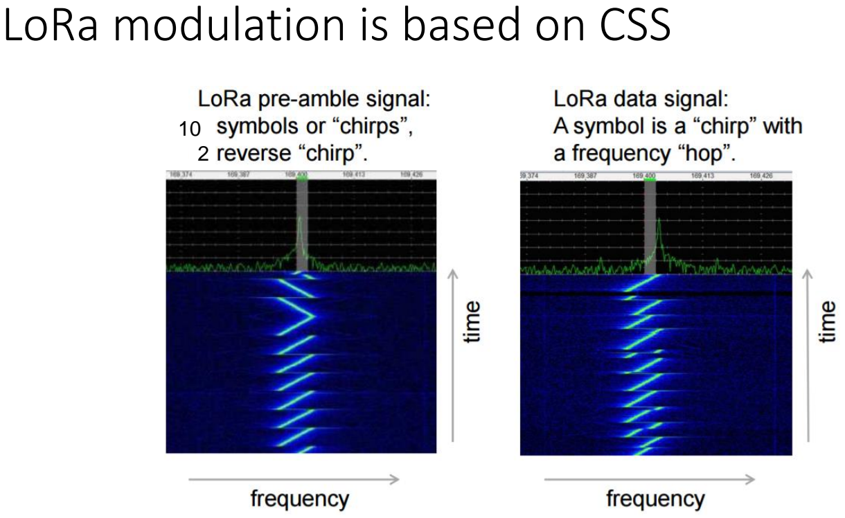
[picture p272: page 3]

2

10

## LoRa modulation is based on CSS

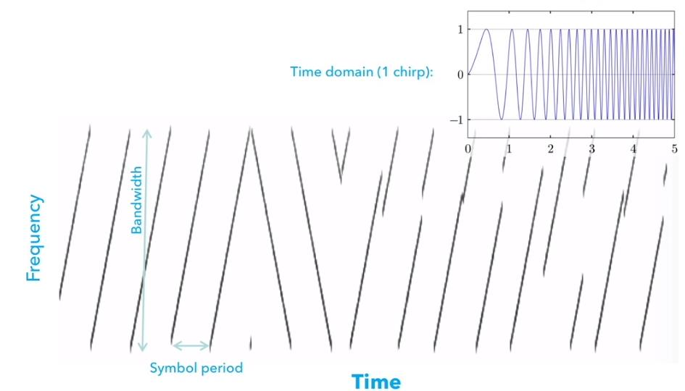
[picture p273: figure]

## LoRa modulation is based on CSS

- Download the code LoraPHY.ino in UCA_Board/Arduino_Code/LoRa_PHY/LoRaSender_Phy.ino
- You can tune the :
- SF : from 7 to 12
- BW : from 7.8KHz to 500KHz
- N° of Peamble from 6 to 65535, yielding total preamble lengths of 6+4 to 65535+4 symbols, once the fixed overhead of the preamble data is considered.
- Payload
- Upload the code in the board
- Watch the Spectrogram and explain the effect of the different parameters on the signal

## LoRa modulation is based on CSS

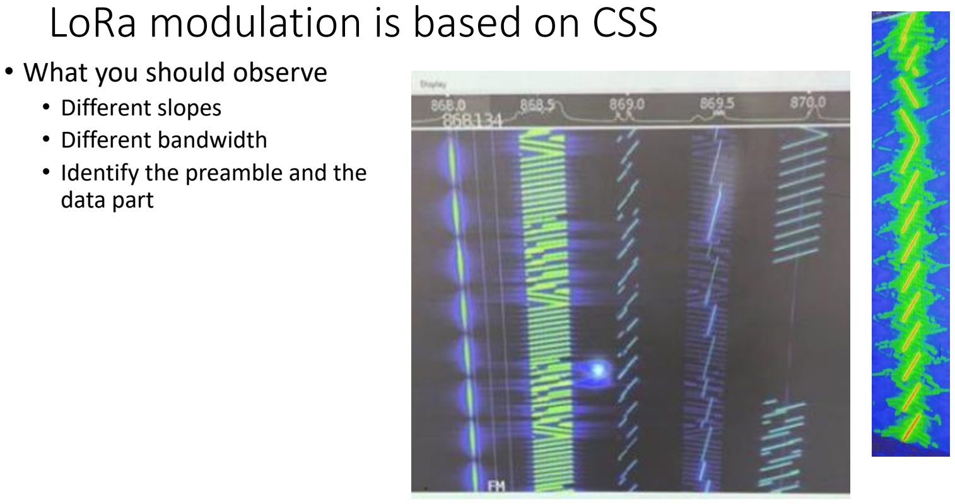
[picture p274: page 6]

- What you should observe
- Different slopes
- Different bandwidth
- Identify the preamble and the data part

## LoRa modulation is based on CSS

- Have also a look tp this application :
- LoRa Calculator :
https://www.semtech.com/products/wireless-rf/loratransceivers/SX1276#download-resources
