FabienFerrero/UCA_Board/documents/pictures/TTN_LED.png

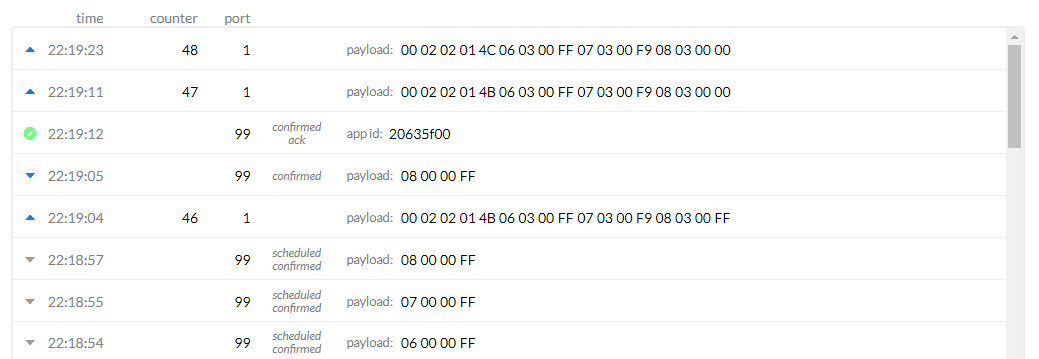
documents/pictures/TTN_LED.png
