FabienFerrero/UCA_Board/documents/tutorial/readme.md

You can find here some tutorial on the antenna, PCB ordering ...
