FabienFerrero/UCA_Board/documents/tutorial/LoRaWan_TTN_tuto_v2.pdf

# LoRaWan Register a device on TTN

F. Ferrero

## LoRaWan with The Thing Network

- The Things Network is a global, open, crowd-sourced Internet of Things data
network.
- The Things Network Backend route messages from Nodes to the right Application, and back
- First, you have to register to https://www.thethingsnetwork.org/ , when it is done, tell me your ID, I will add you as a collaborator on the Polytech’ application
- You can also join the Sophia Antipolis TTN community : (https://www.thethingsnetwork.org/community/sophia-antipolis/)


## Adding a new device

- Go to « Projets Polytech »application and register device
- For ID and EUI, use the N° 50ff1a00000000XX and just incremant XX.
- To remember it : « 50ff1a » is for « SOPHIA »
- It will provide Device EUI, Application EUI and App Key


## Activation by Personalization (ABP)

- Go to settings
- Select ABP and save
- Go back to Overview
- You have now the Device Address and the two 128 AES keys
- You can click on Hex-C Style to have the key in the right format


## Activation by Personalization (ABP)

- Go to my Github : https://github.com/FabienFerrero/UCA_Board
- Download the archive (.zip) and extract the archive
- Copy the file from Arduino_Code/Libraries/ to /Document/Arduino/ Libraries/
- Open the code Arduino_Code/LORAWAN/ABP/Basic/UCA-ABP_Basic.ino
- Copy/Paste NWKSKEY, APPSKEY and DEVADDR with your IDs from TTN


## Activation by Personalization (ABP)

- Compile and download the code on your board
- Look at the TTN device overview
- Frames up should increment each half minute as your board is sending an uplink each 30s (« TX_INTERVAL »)
- Have look on Data
- For each uplink, you can look many details as RSSI, SNR, airtime, modulation, coding rate, GW ID, etc …


## Activation by Personalization (ABP)

Frame counter security
- Now reset you board (click on the red button on the Arduino mini pro)
- TTN is no more receiving the data
- Click on « reset frame counters » and reset you board again
- As you can see, frame counter is a security features to avoid replay attack (done by capturing and re-transmitting the messages)
- Frame counter can be disabled for debug test in Settings
Downlink
- Open your serial monitor
- In TTN overview, go to downling, add a payload like « BABA » and click on send, and go to Data
- After the next uplink, you should see the number of byte received in downlink

## Activation by Personalization (ABP)

Change SF, power, payload …
- At the end of the arduino code, you have : LMIC_setDrTxpow(DR_SF12,14);
- You can change SF from DR_SF7 to DR_SF12
- You can change the power from 2 dBm to 20 dBm
- Payload is in mydata[], and you can change the text.
- Do some test, what is the effect on the RSSI ?

## Over the Air Activation (OTAA)

- In TTN Settings of your device, select OTAA and save
- Open the code Arduino_Code/LORAWAN/OTAA/LP_Basic/UCA-OTAA_Basic.ino
- Copy paste after clicking on hexa-style the DEV-EUI, APP-EUI and App Key
- Be carefull !!!
- Device EUI and Application EUI are lsb
- App Key is msb

## Over the Air Activation (OTAA)

- Look in data
- You should see a first uplink that
request the connection
- And a second packet witht the first data
- On the serial monitor you can see the Joining process and then Joined and Tx.
- The device go to sleep after the Tx

Board
request for
connection


First packet
with data

## Over the Air Activation (OTAA) and data

- Try now the code
Arduino_Code/LORAWAN/OTAA/LP_BME280/UCA-BME280.ino
- It use the sensor BME280 that measure T°c, Humidity and Pressure
- The code is using Cayenne LPP format (https://github.com/myDevicesIoT/cayenne-docs/blob/master/docs/LORA.md)
- Now you can see sensor data in the uplink packet


## Using Cayenne to see you data

- Go to https://mydevices.com/ and create an account
- Add a device by selecting LoRa/TheThingNetwork and Cayenne LPP.
- Just add your device EUI
- You should see your data


## Downlink with LoRaWAN

- You are not going to control the color of a LED from CAYENNE.
- Use the code in :
https://github.com/FabienFerrero/UCA_Board/tree/master/Arduino_Code/LORAWAN/OTAA/LED_CONTROLLER

## Downlink with LoRaWAN

- You are now going to control the color of a LED from CAYENNE.
- Use the code in :
https://github.com/FabienFerrero/UCA_Board/tree/master/Arduino_Code/LORAWAN/OTAA/LED_CONTROLLER

## Downlink with LoRaWAN

- Upload the code
- It will send uplink all 15 seconds
- The LED are controlled by a PWM with 255 states
- Change in your Cayenne Dashboard to have the slider from 0 to 255

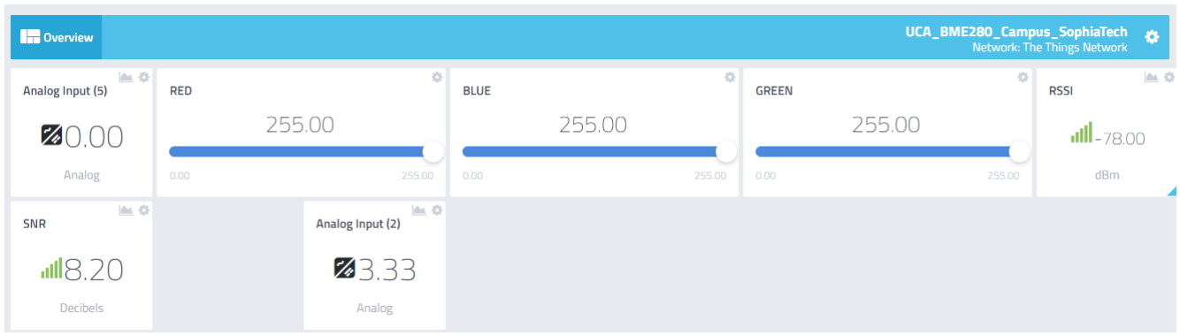
[picture p295: figure]

## Downlink with LoRaWAN

- When you change the slider value, look at your data in TTN
- You should see that the downlink is scheduled
- Then it is confirmed and the node send an ack

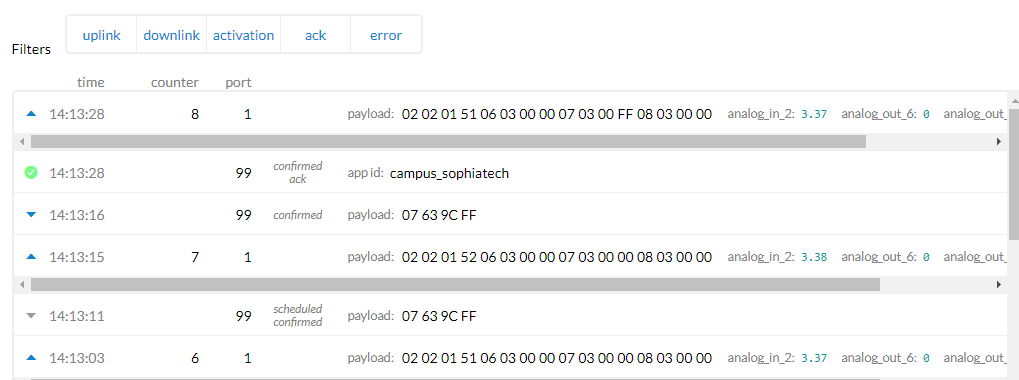
[picture p296: figure]

## Downlink with LoRaWAN

- After each uplink, the node open a received window for downlink
- With Cayenne, only one color can be updated at the same time

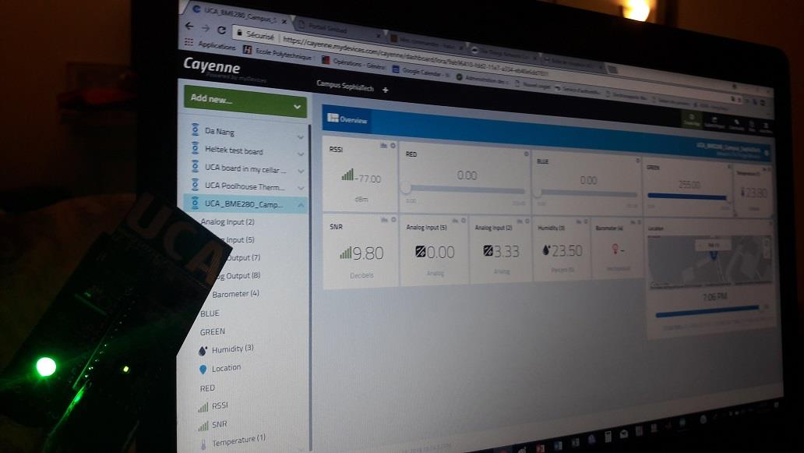
[picture p297: figure]


## Good luck for you projects !
