FabienFerrero/UCA_Board/documents/tutorial/DaNang/DA NANG SMART CAMPUS-2018_2019_ATIGB.pdf

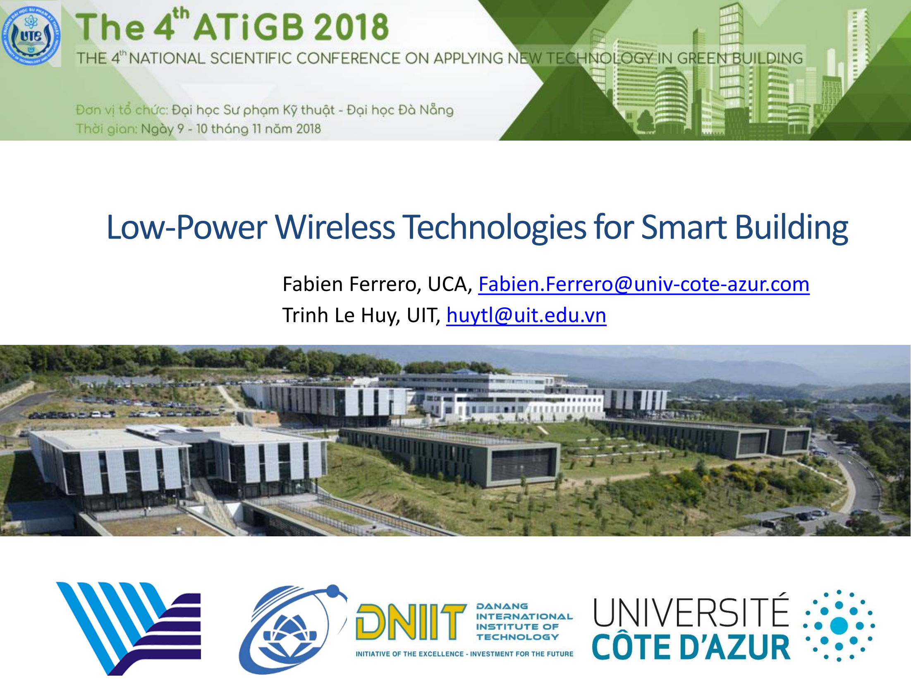
[picture p298: page 1]

# Low-Power Wireless Technologies for Smart Building

Fabien Ferrero, UCA, Fabien.Ferrero@univ-cote-azur.com Trinh Le Huy, UIT, huytl@uit.edu.vn

# Outline

## - LP-WAN motivation

## - Smart Campus Campaign 2018-2019

## - Channel measurement in a Vietnamese Building

## - UCA LoRa Node Platform

## - SmartCampus UCA Node

## - Conclusion and Perspectives

# IoT opportunities : Potential market

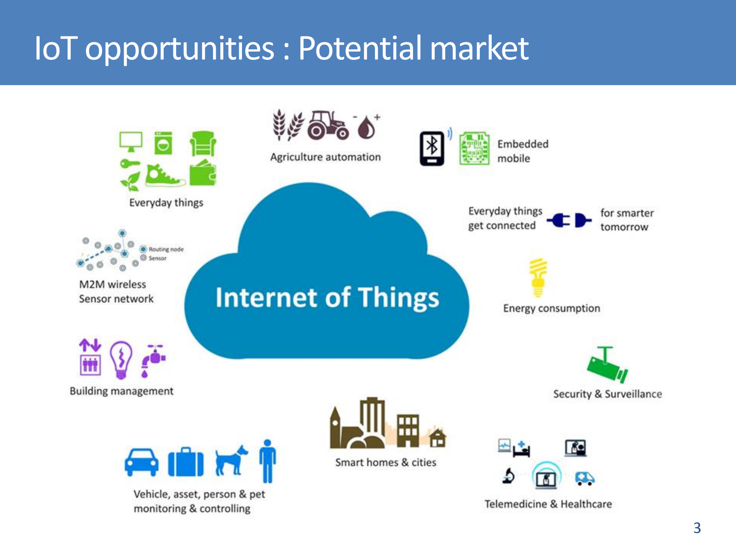
[picture p299: page 3]

3

# IoT opportunities : Hype cycle

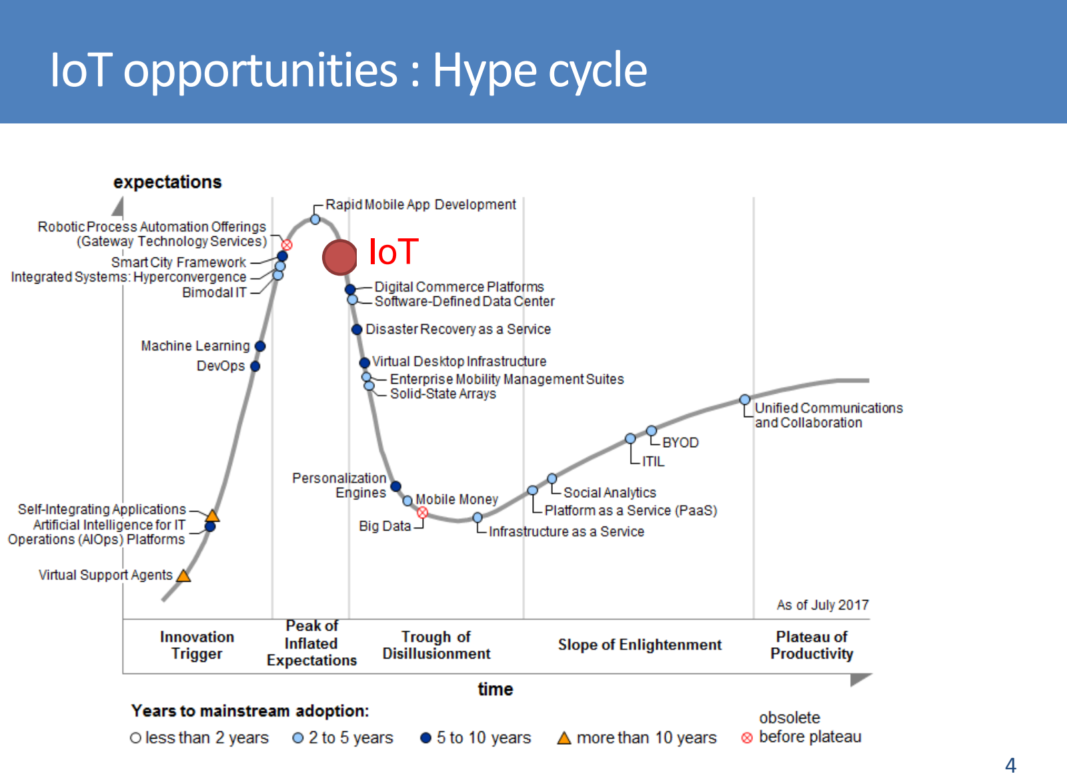
[picture p300: page 4]

4

## IoT

# Smart Building

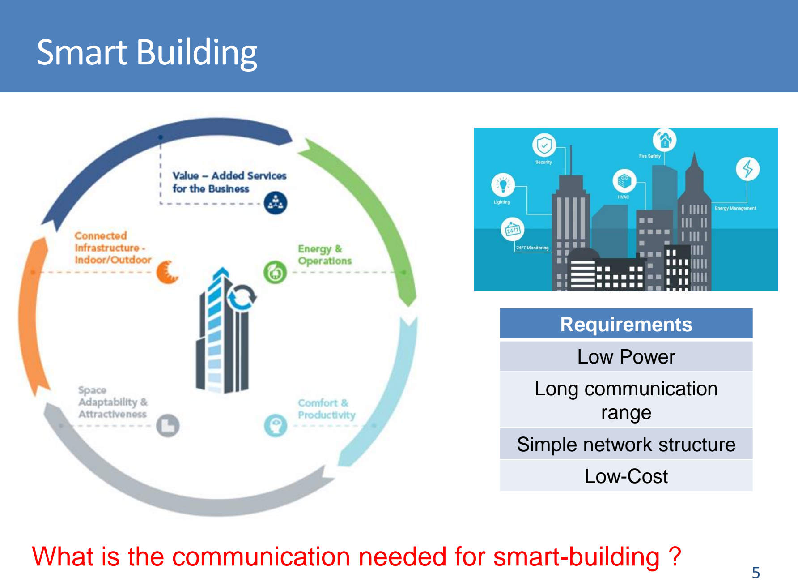
[picture p301: page 5]

5

## What is the communication needed for smart-building ?

Requirements
Low Power
Long communication
range
Simple network structure
Low-Cost

# LP-WAN technologies opportunities


6

## LP-WAN provides new capabilities :

## Low-power and long communication range

Power | 1mW | 10mW | 100mW

# LP-WAN technologies comparison

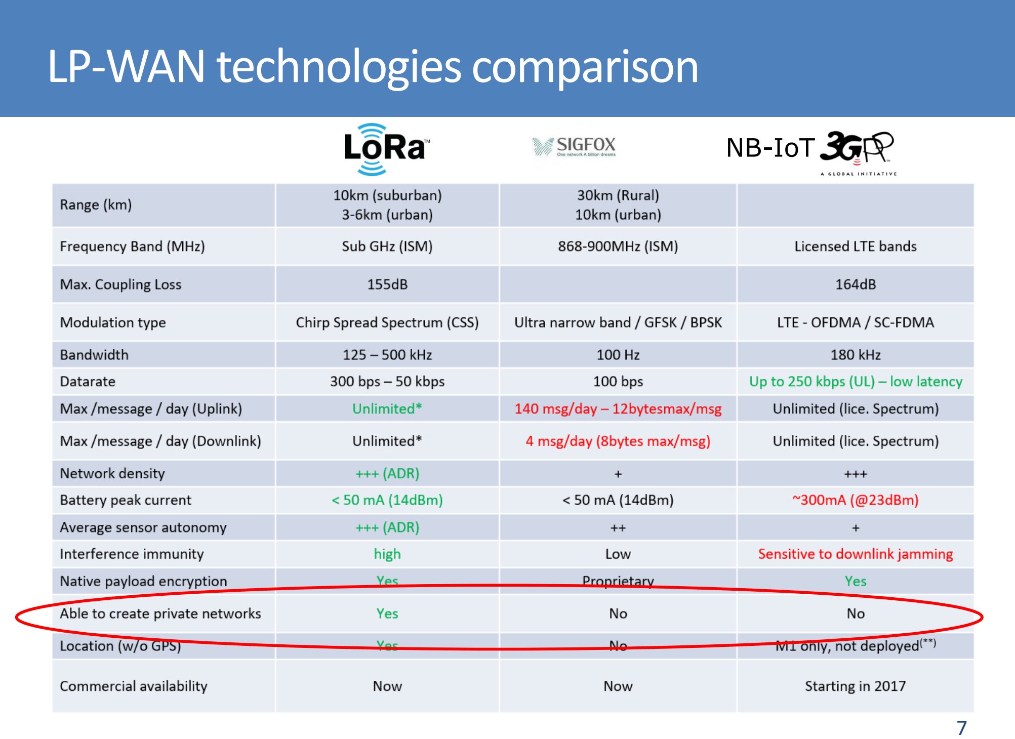
[picture p302: page 7]

7

NB-IoT

# LP-WAN technologies comparison

8

## - IoT communication standards

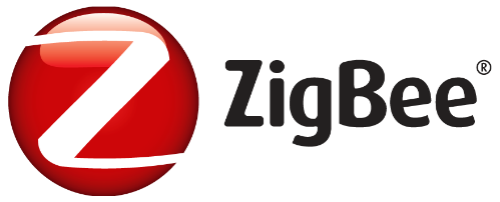
[picture p303: figure]

Frequency : 2.4GHz
Data rates : 20-250 kbps
Power consumption :
- Tx : 34 mA
- Rx : 24mA
Budget Link : around 100 dB Range : 50m
CC2538 TI

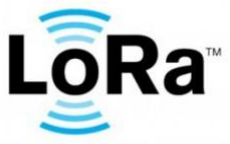
[picture p304: figure]

Frequency : 868MHz
Data rates : 240 bps to 5.5 kbps Power consumption :
- Tx : 28mA
- Rx : 11mA
Budget Link : around 150 dB Range : 2 km
SX1272 Semtech

# LoRa modulation : Spreading factor

## - LoRa Spreading factor

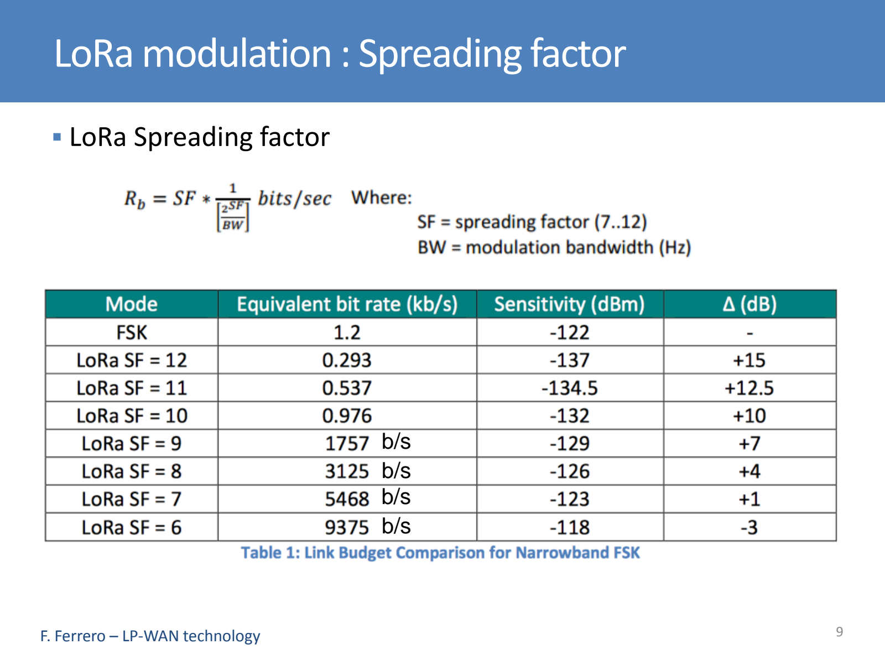
[picture p305: page 9]

9 F. Ferrero – LP-WAN technology

b/s
b/s
b/s
b/s

# LP-WAN network

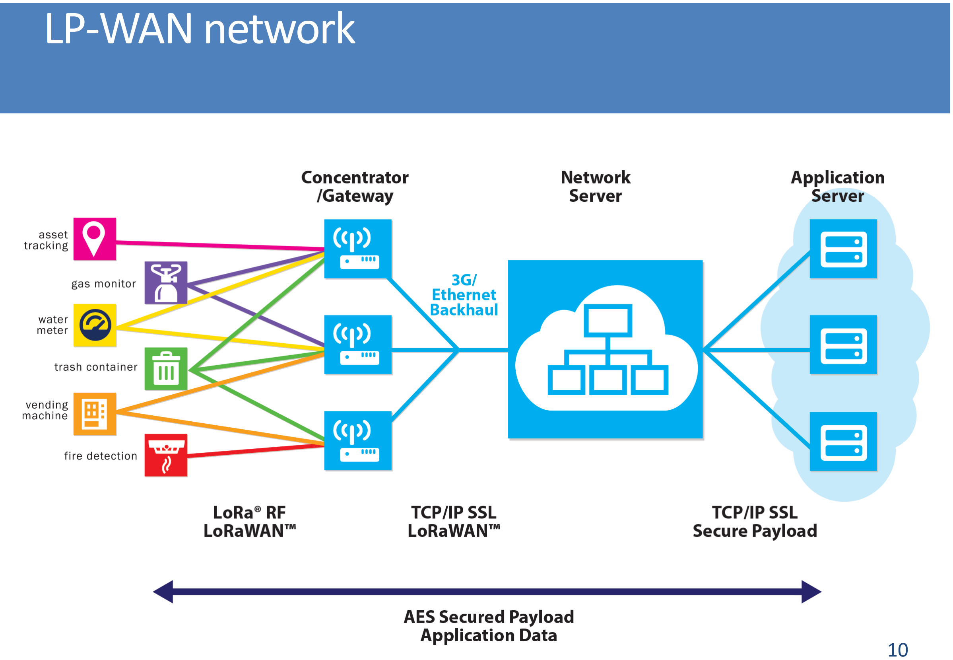
[picture p306: page 10]

10

# LoRa vs LoRaWan

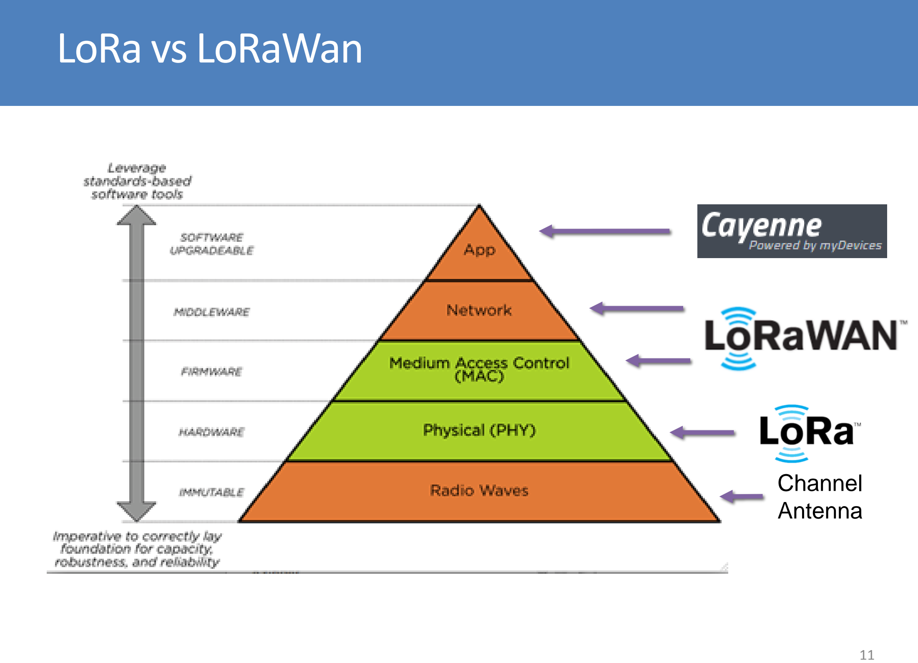
[picture p307: page 11]

11

Channel
Antenna

# LoRaWan Class A

12


Assumptions: Pout = +14 dBm, Average Current
- 10 packets / day
- Sleep current ~1uA (includes the MCU)
- MCU is mostly Off during Tx
- No ACK received
- The energy usage of the 2 unused Rx windows is low (<10%)
- Pout = +14 dBm, IDDTX = 32 mA

# Outline

## - LP-WAN motivation

## - Smart Campus Campaign 2018-2019

## - Channel measurement in a Vietnamese Building

## - UCA LoRa Node Platform

## - SmartCampus UCA Node

## - Conclusion and Perspectives

# Smart Campus Campaign : General objectives

- Memorandum between on August 22, 2017 between :
- The University of Danang- University of Science and Technology
- Danang International Institute of Technology (DNIIT)
- Objective is to promote research toward the Industrial Revolutionary 4.0, Internet of Things and Artificial Intelligence
- Set up, on UD campuses wireless IoT networks (e.g. LoRa technology) and intelligent services of connected objects.
- Innovation platform mobilizing students, lecturer-researchers and companies
- Four campuses of The University of Danang: DUT, UTE and CIT campus and the headquater of UD.
- Competition of innovative projects
- Annual Call for Proposals
- Development by project groups with the support of lecturers/researchers
- Project development : 5 months (beginning of Nov – April)
- Jury rankings and awards (board of judge: members from univ., industry, investors,...)

# Outline

## - LP-WAN motivation

## - Smart Campus Campaign 2018-2019

## - Channel measurement in a Vietnamese Building

## - UCA LoRa Node Platform

## - SmartCampus UCA Node

## - Conclusion and Perspectives

# Measurement Building

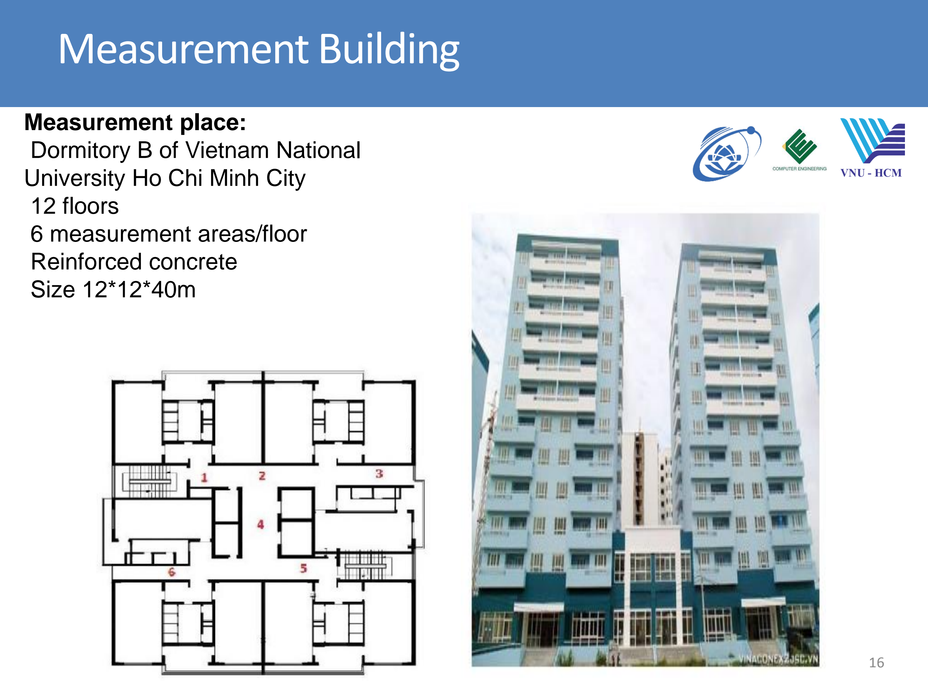
[picture p308: page 16]

16

Measurement place:
Dormitory B of Vietnam National University Ho Chi Minh City
12 floors
6 measurement areas/floor
Reinforced concrete
Size 12*12*40m

# Measurement Building

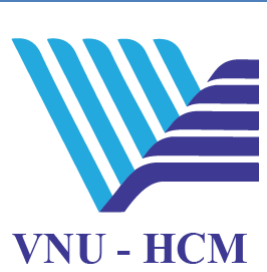
[picture p309: figure]
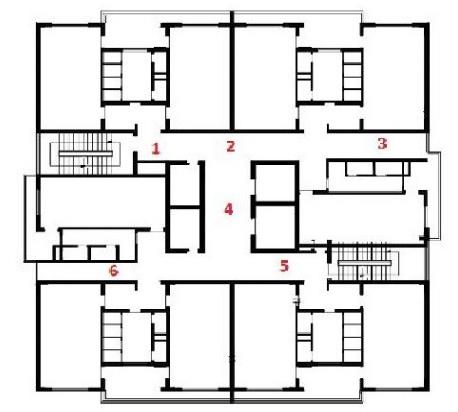
[picture p310: figure]

17

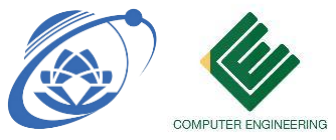
[picture p311: figure]

Scenario:
1. LoRa Gateway is placed at 12th floor at 6 different positions.
2. 6 LoRA End nodes are placed at 6 positions of each floor.
3. RSSI level is measured then uploaded to webserver
4. Data processing and display

# Measurement Building

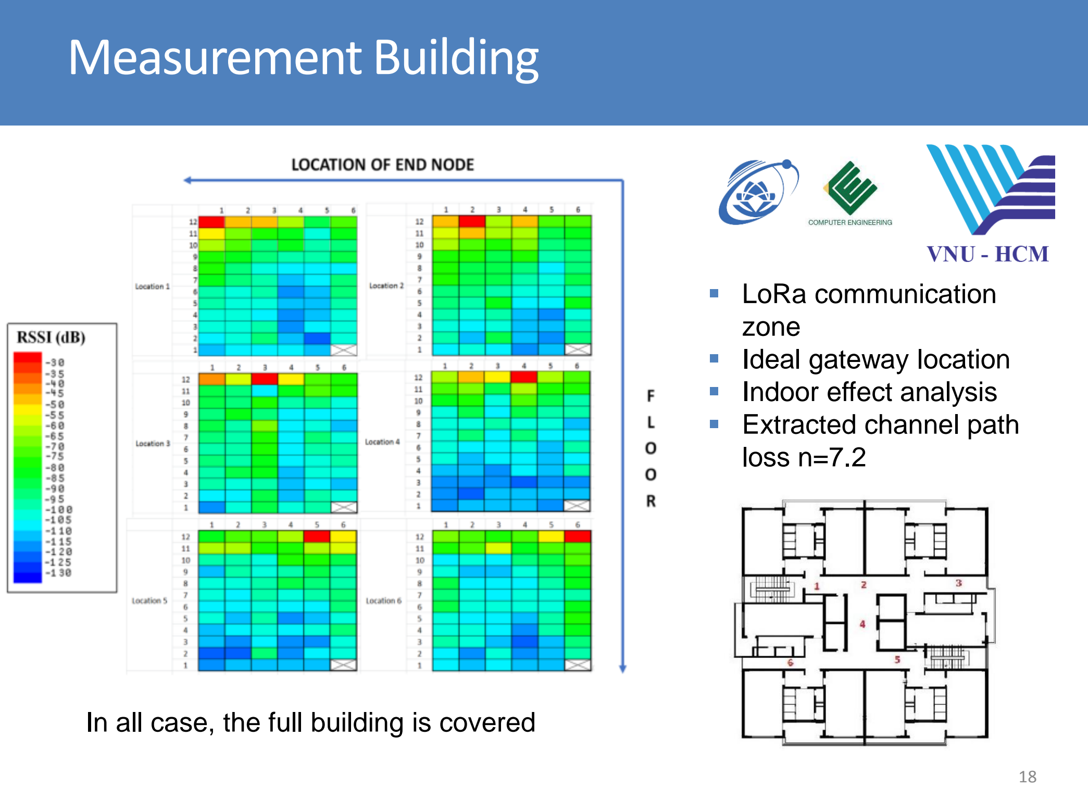
[picture p312: page 18]

18

- LoRa communication
zone
- Ideal gateway location
- Indoor effect analysis
- Extracted channel path
loss n=7.2

In all case, the full building is covered

# Outline

## - LP-WAN motivation

## - Smart Campus Campaign 2018-2019

## - Channel measurement in a Vietnamese Building

## - UCA LoRa Node Platform

## - SmartCampus UCA Node

## - Conclusion and Perspectives

# UCA IoT Plateform

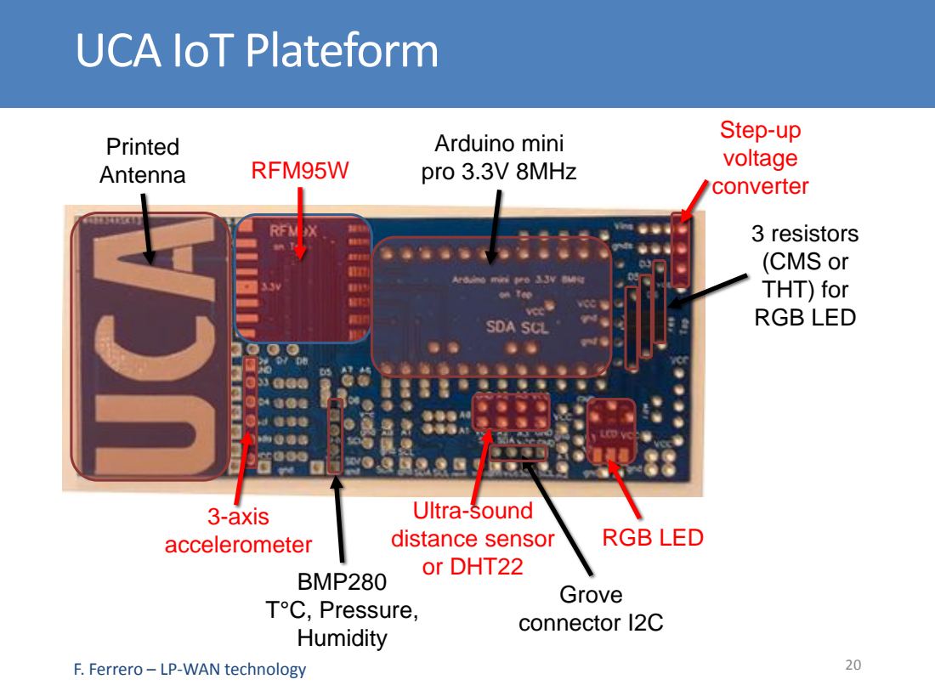
[picture p313: page 20]
F. Ferrero – LP-WAN technology; 3 resistors (CMS or THT) for RGB LED; RFM95W; Arduino mini pro 3.3V 8MHz; Step-up voltage converter; RGB LED; 3-axis accelerometer; BMP280 T°C, Pressure, Humidity; Grove connector I2C; Ultra-sound distance sensor or DHT22; Printed Antenna

# UCA IoT Plateform

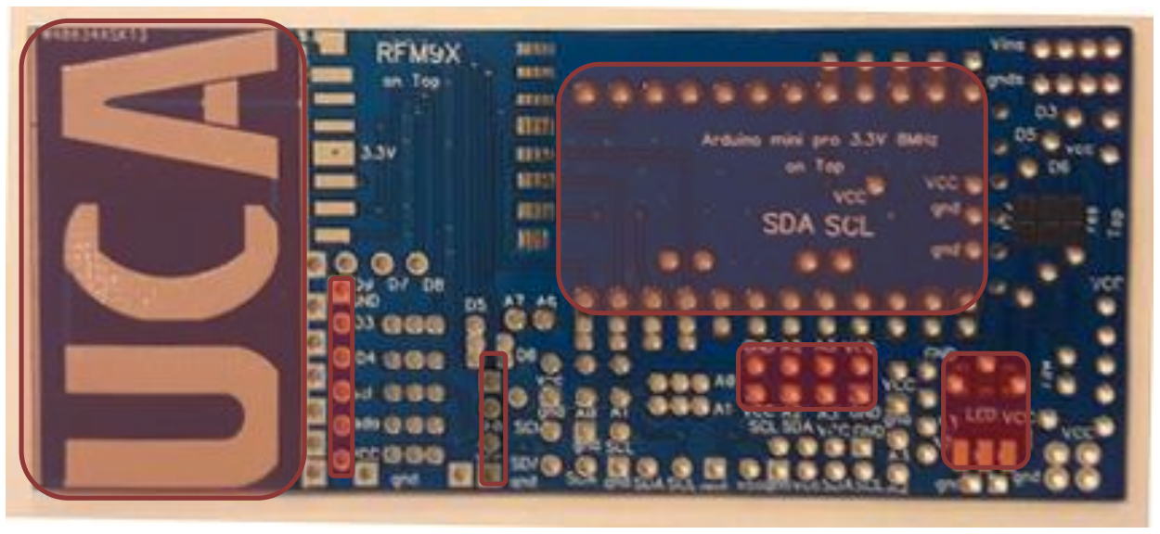
[picture p314: figure]

F. Ferrero – LP-WAN technology | 21
- Communication up to 15 km
- Power consumption when Transmitting : 100mA on 3.3v
- Power consumption when Sleeping : 10 uA on 3.3V
- With a single AA Lithium battery : Autonomy from 1 to 3 years

https://github.com/FabienFerrero/UCA_Board/

# Outline

## - LP-WAN motivation

## - Smart Campus Campaign 2018-2019

## - Channel measurement in a Vietnamese Building

## - UCA LoRa Node Platform

## - SmartCampus UCA Node

## - Conclusion and Perspectives

# Smart Campus UCA : Sensor list

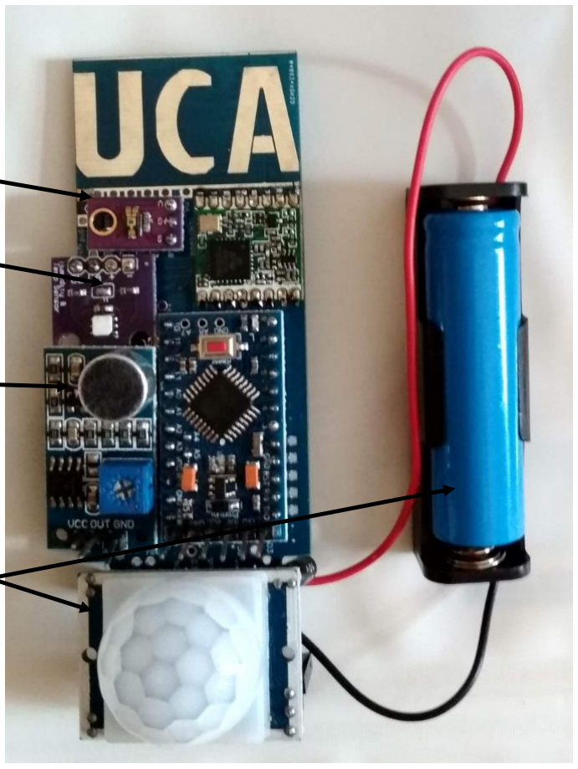
[picture p315: figure]

F. Ferrero – LP-WAN technology | 23

https://github.com/FabienFerrero/UCA_SmartCampus

Light sensor
TEMT 6000

T°c and Humidity
Si 7021

Sound Sensor

PIR Sensor

Lithium Battery

# Smart Campus UCA : BOM

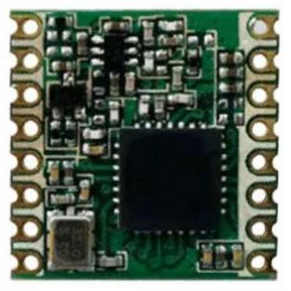
[picture p316: figure]
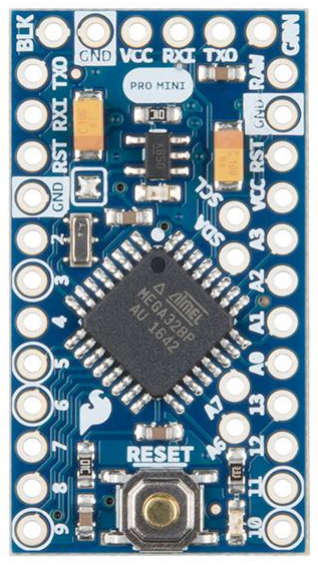
[picture p317: figure]

F. Ferrero – LP-WAN technology | 24

Bill of Material & Power Consumption for 3.3V :
- LoRa Sx1276 (RFM95)
- Cost : 5$
- Rx : 10mA
- Tx : 50 to 100 mA
- Sleep : < 200 nA

Average Power consumption mainly depend on the Tx interval, Spreading factor and Payload size.

Pav ~ 3.3 ∗ ( Isleep + ITx ∗

TimeonAir

Txinterval

)

- ATMEGA 328p 8MHz (Mini Pro)
- Cost : 1.7$
- Active : 4mA
- Sleep : 9 uA

Pav ~ 3.3 ∗ ( Isleep + Iactive ∗

Timeoperation

Txinterval

)

# Smart Campus UCA : BOM

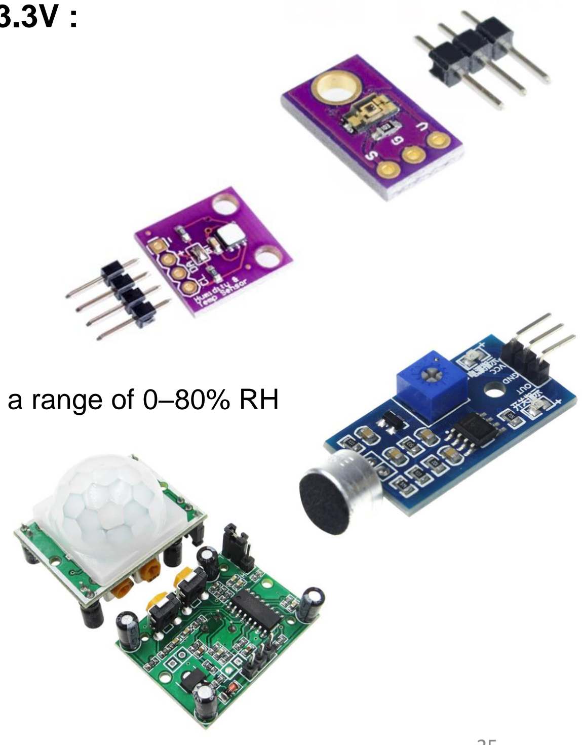
[picture p318: figure]

F. Ferrero – LP-WAN technology | 25

Bill of Material & Power Consumption for 3.3V :
- TEMT6000 : Photo Transistor
- Cost : 0.6 $
- Active : 330 uA during 10ms
- Sleep : 0
- 1 Lux to 10000 Lux
- SI7021 : I2C interface
- Cost : 1.5$
- Active : 330 uA during 10ms
- Sleep : 60 nA
- ±0.4 °C temperature accuracy
- ± 3% relative humidity measurements with a range of 0–80% RH
- Sound Sensor : Analog interface
- Cost : 0.5$
- Active : 3 mA during 100ms
- Sleep : 0
- Must be tuned
- PIR Sensor : Digital Interface
- Cost : 0.7$
- Active : 60 uA
- Sleep : 0
- Must be tuned

# Smart Campus UCA : BOM

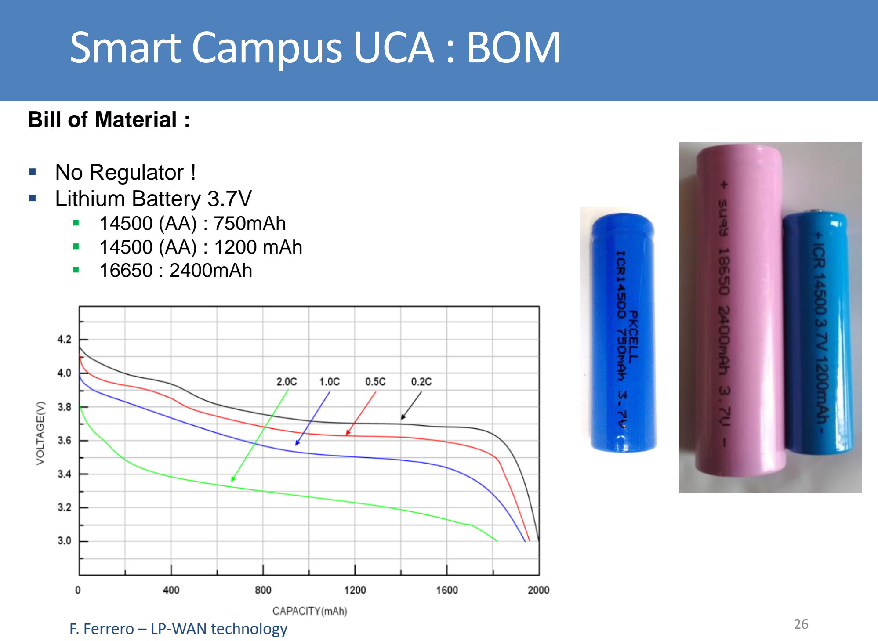
[picture p319: page 26]

F. Ferrero – LP-WAN technology | 26

Bill of Material :

- No Regulator !
- Lithium Battery 3.7V
- 14500 (AA) : 750mAh
- 14500 (AA) : 1200 mAh
- 16650 : 2400mAh

# Smart Campus UCA : Scenario

F. Ferrero – LP-WAN technology | 27

### 2 different modes :

- Active if a Movement or Sound detected
- Uplink sensor information each 5mn
- During the 5mn time slot, each 8s :
- Measure Sound level
- Measure Movement
- Standby mode if no sound or movement detected for 5mn
- Uplink sensor information all 30mn
- In a 30 mn tome slot :
- Each 1mn : Measure light, uplink if large change
- Interruption if Movement detected

Sound level and movement level is averaged over the 5mn time frame
- Sound level is relative
- Movement is expressed in % of detection

PIR Sensor is always ON

# Smart Campus UCA : Average PC

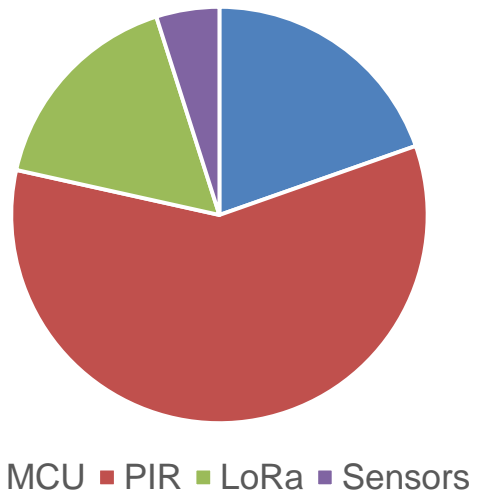
[picture p320: figure]
MCU; PIR; LoRa; Sensors

F. Ferrero – LP-WAN technology | 28

Power Consumption:
- Scenario
- 5mn Interval
- SF7 and 26 bytes payload
- Time on air : 61ms
- No ACK
- Average Power consumption
- 102uA on 3.7V = 0.37mW
- Autonomy
- No considering battery self-discharge
Battery | Autonomy
750mA.h | 25 months
1200mA.h | 41 months
2400mA.h | 81 months

# Smart Campus UCA : System

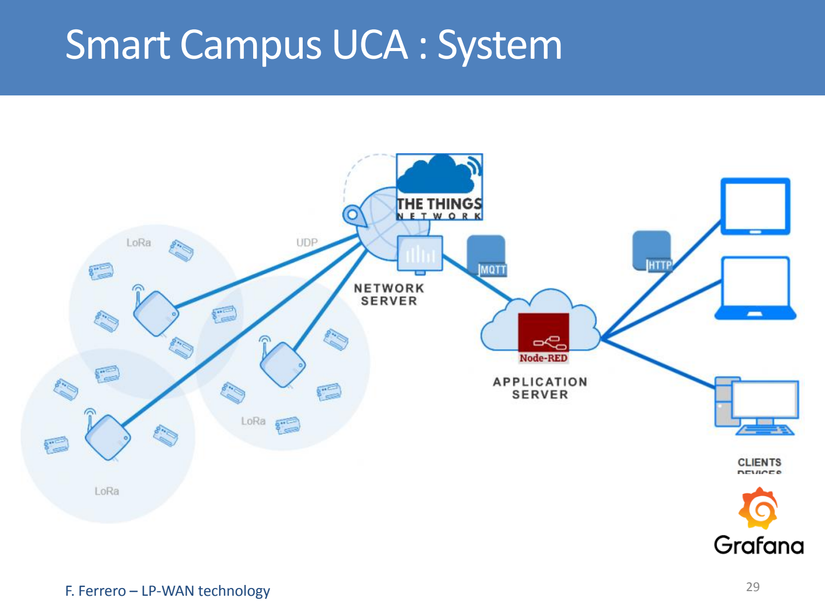
[picture p321: page 29]

F. Ferrero – LP-WAN technology | 29

# Smart Campus UCA : Results

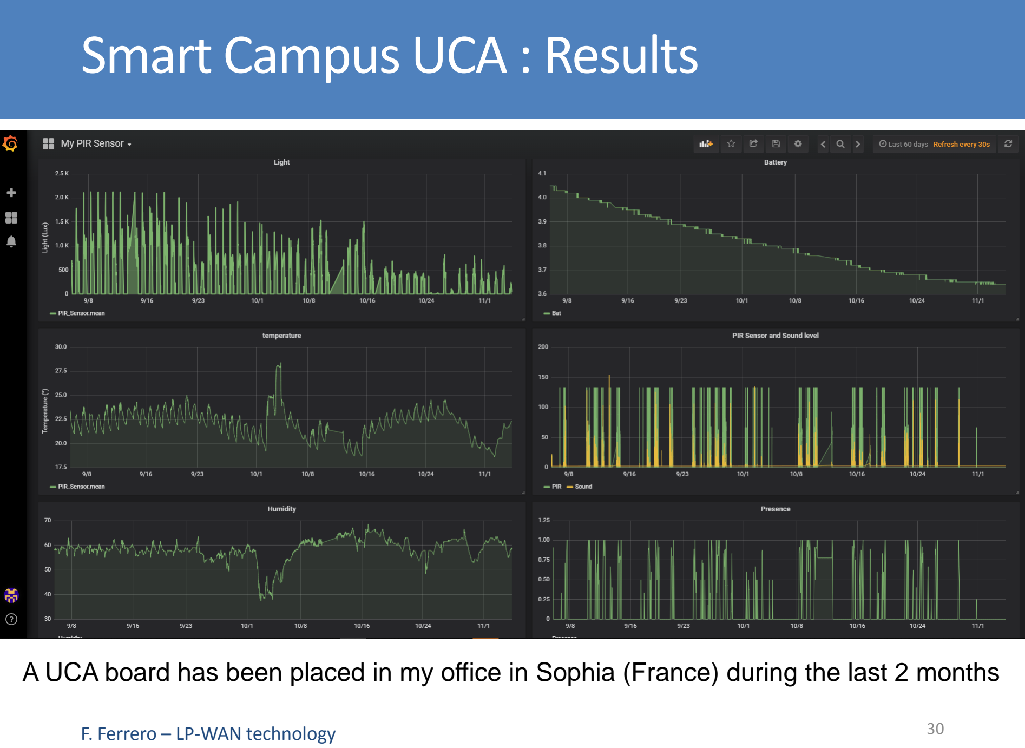
[picture p322: page 30]

F. Ferrero – LP-WAN technology | 30

A UCA board has been placed in my office in Sophia (France) during the last 2 months

# Smart Campus UCA : Results

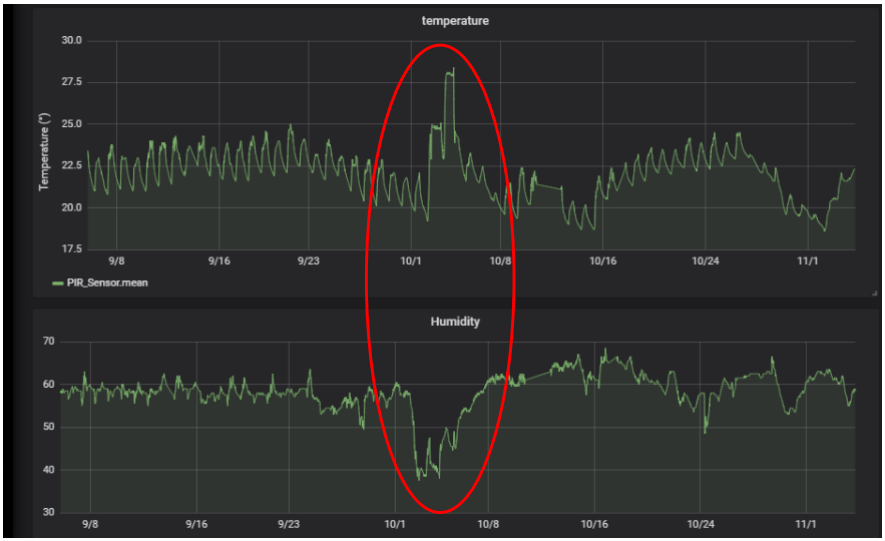
[picture p323: figure]

F. Ferrero – LP-WAN technology | 31

3rd of October : my office colleague forget to swith off his radiator

# Smart Campus UCA : Results

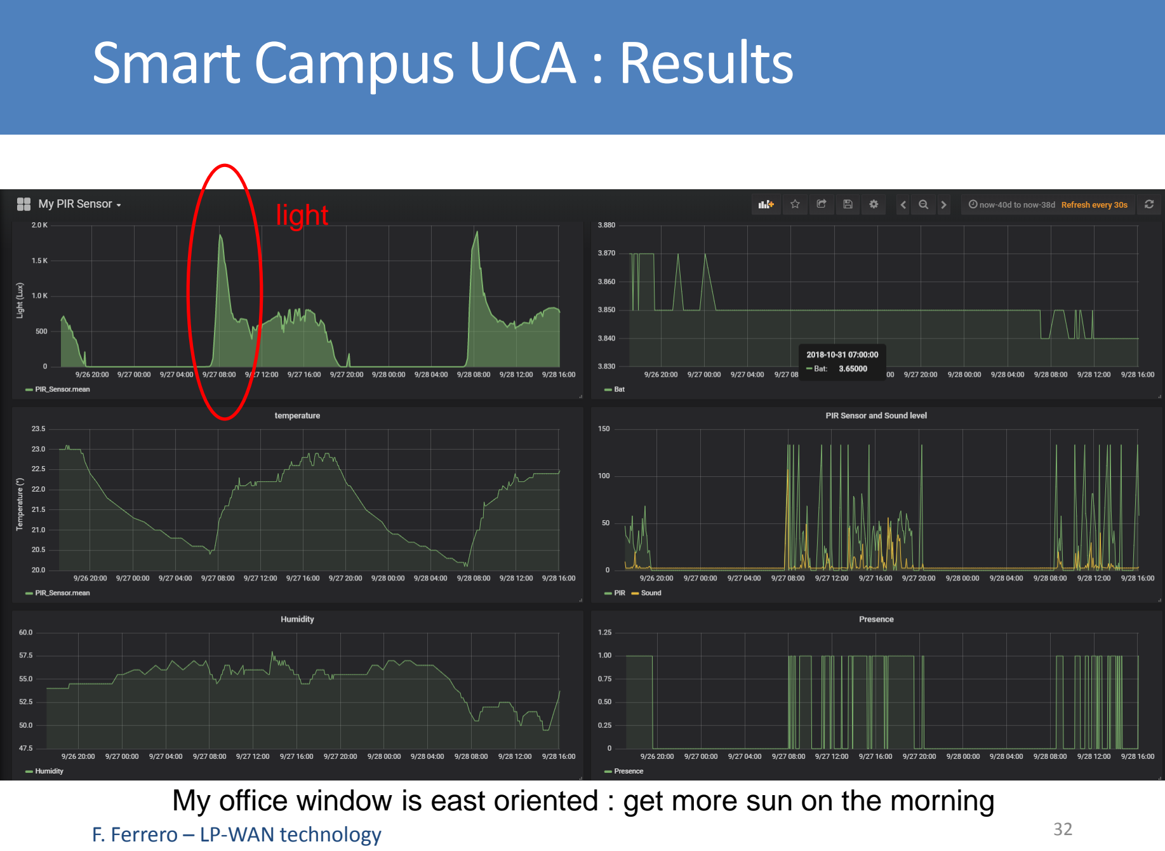
[picture p324: page 32]

F. Ferrero – LP-WAN technology | 32

My office window is east oriented : get more sun on the morning

light

# Smart Campus UCA : Results

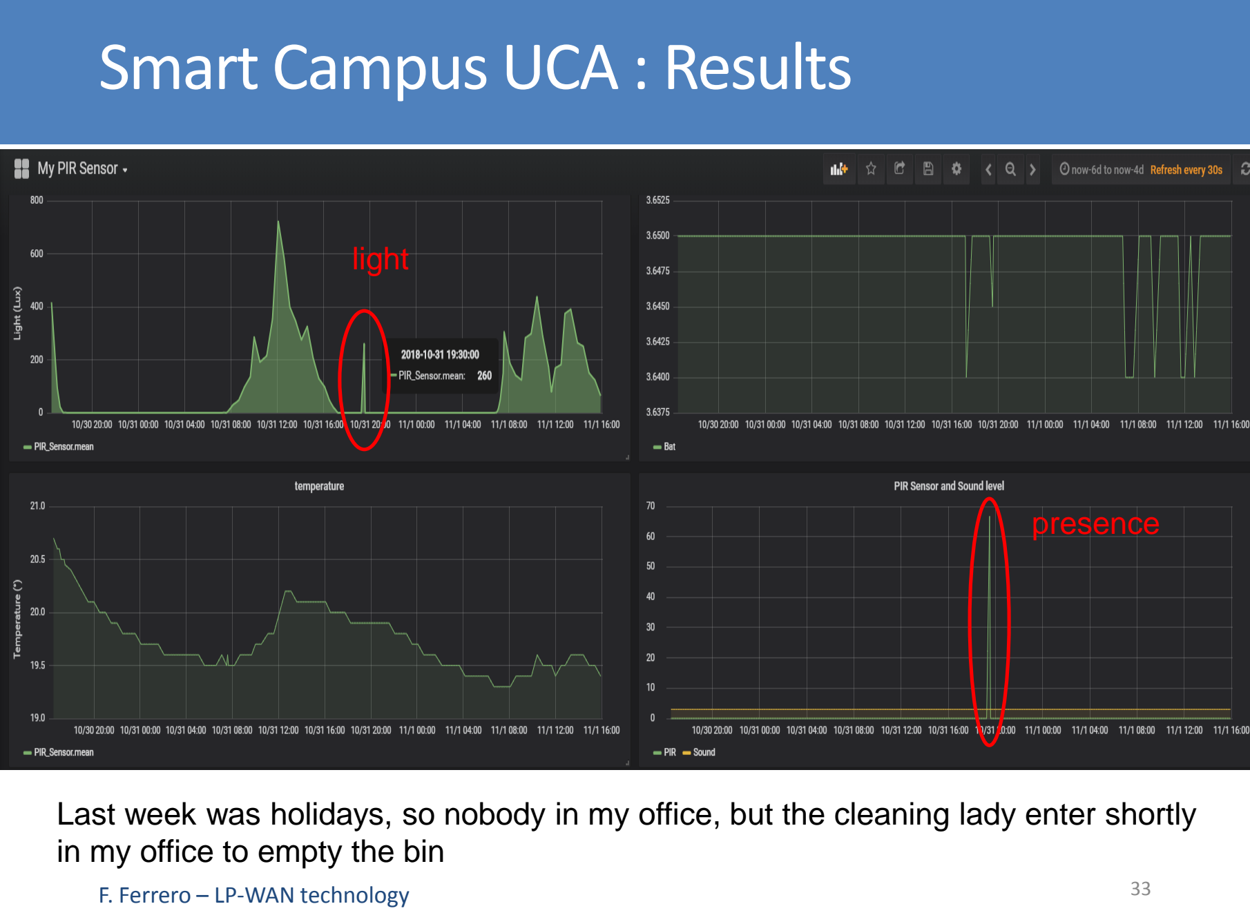
[picture p325: page 33]

F. Ferrero – LP-WAN technology | 33

Last week was holidays, so nobody in my office, but the cleaning lady enter shortly in my office to empty the bin

light

presence

# Smart Campus UCA : Results

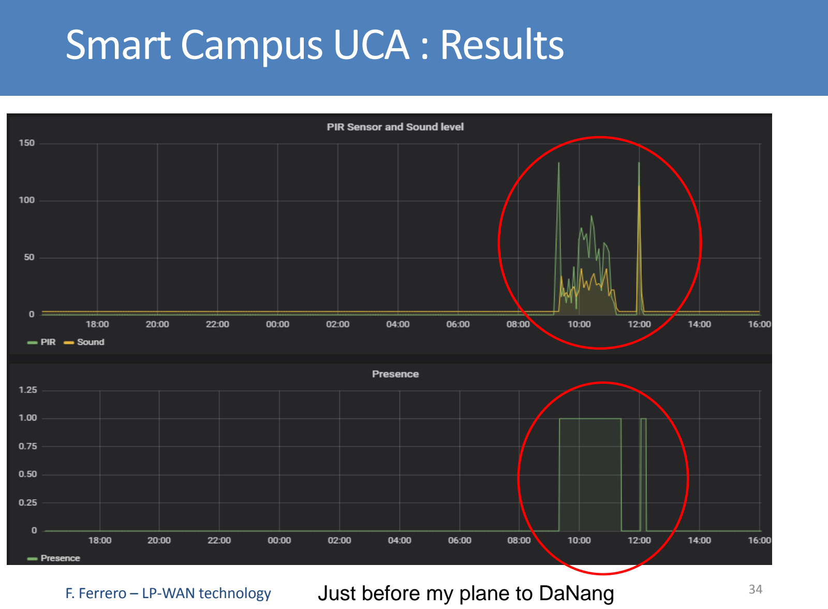
[picture p326: page 34]

F. Ferrero – LP-WAN technology | 34 Just before my plane to DaNang

# Smart Campus UCA : Autonomy

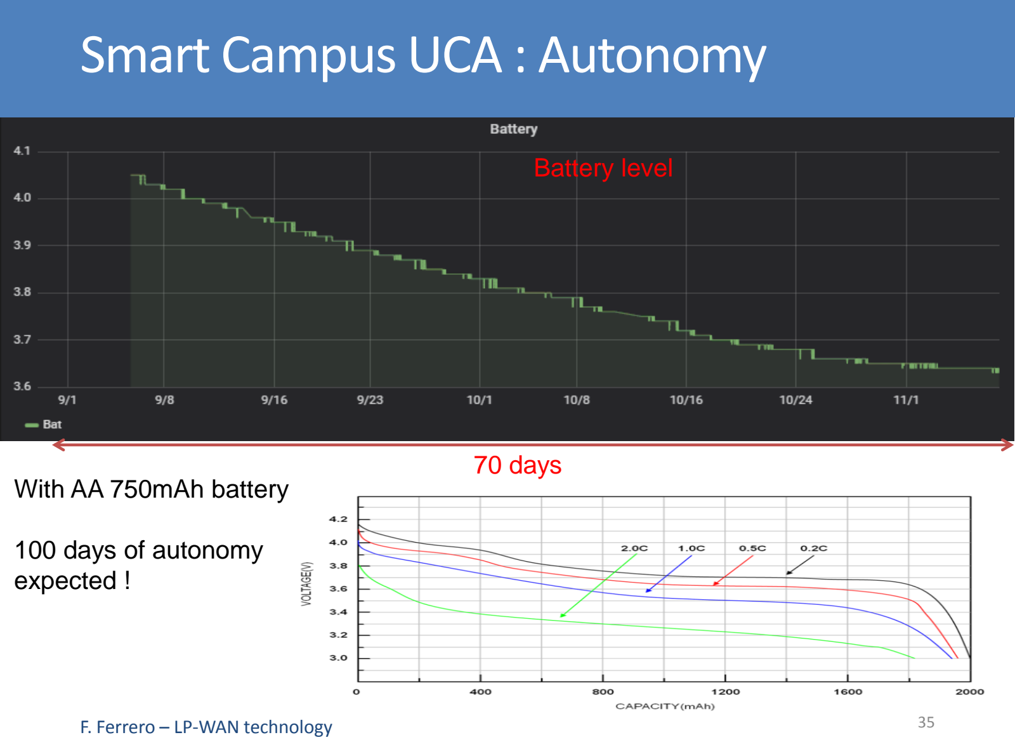
[picture p327: page 35]

F. Ferrero – LP-WAN technology | 35

70 days
With AA 750mAh battery

100 days of autonomy
expected !

Battery level

# Outline

## - LP-WAN motivation

## - Smart Campus Campaign 2018-2019

## - Channel measurement in a Vietnamese Building

## - UCA LoRa Node Platform

## - SmartCampus UCA Node

## - Conclusion and Perspectives

# Conclusion and Perspectives

Université Côte d’Azur | CNRS | LEAT | 37
- We demonstrate that LoRa technology is relevant for Smart Building applications
- A low-cost and low-power platform can be used for sensing application with several months of autonomy
- From 100 to 300 days of autonomy depending on the battery
- Total cost is around 10$
- This live and high resolution (HR) sensor provide rich contents for context-aware services
- Next important steps is the live data analysis from the collected data
- Actuators node will be used to control building equipements
- Smart Campus 2018 is a great occasion to start projects on this topic !

## DANANG INTERNATIONAL INSTITUTE OF TECHNOLOGY

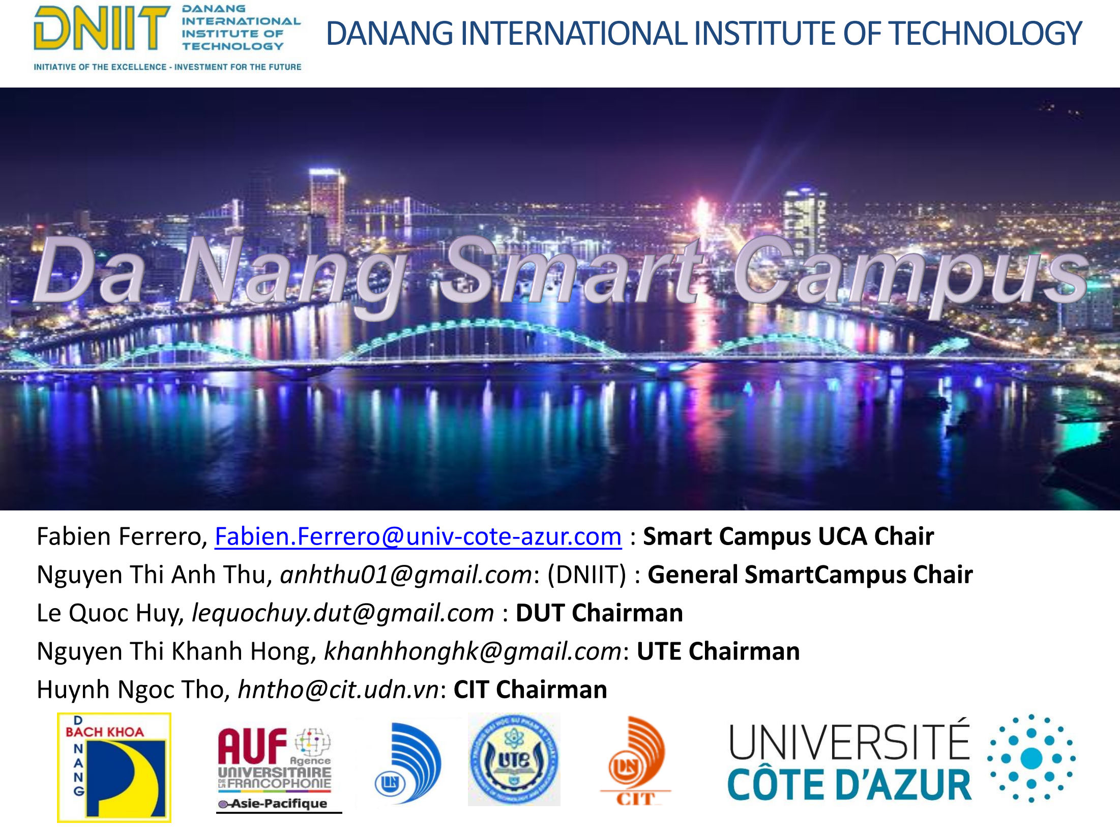
[picture p328: page 38]

Fabien Ferrero, Fabien.Ferrero@univ-cote-azur.com : Smart Campus UCA Chair Nguyen Thi Anh Thu, anhthu01@gmail.com: (DNIIT) : General SmartCampus Chair Le Quoc Huy, lequochuy.dut@gmail.com : DUT Chairman
Nguyen Thi Khanh Hong, khanhhonghk@gmail.com: UTE Chairman
Huynh Ngoc Tho, hntho@cit.udn.vn: CIT Chairman
