FabienFerrero/UCA_Board/documents/tutorial/DaNang/DA NANG SMART CAMPUS-2018_2019_Seminar.pdf

# DANANG INTERNATIONAL INSTITUTE OF TECHNOLOGY

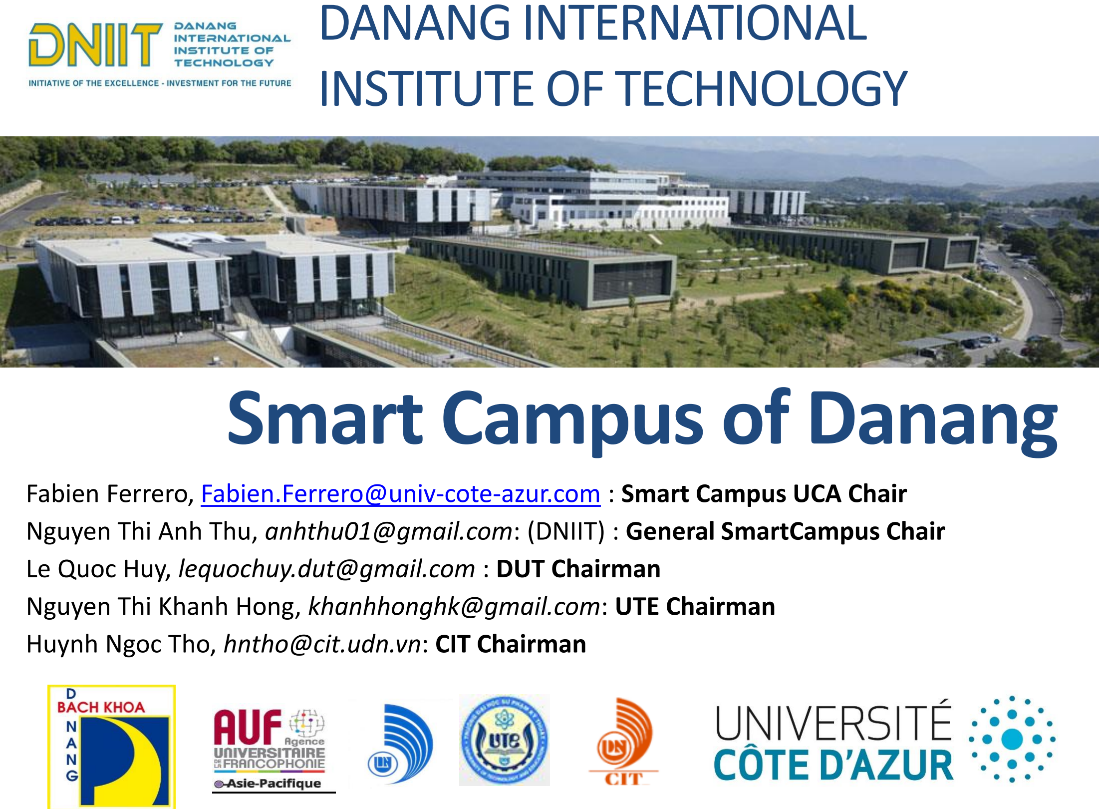
[picture p337: page 1]

# Smart Campus of Danang

Fabien Ferrero, Fabien.Ferrero@univ-cote-azur.com : Smart Campus UCA Chair Nguyen Thi Anh Thu, anhthu01@gmail.com: (DNIIT) : General SmartCampus Chair Le Quoc Huy, lequochuy.dut@gmail.com : DUT Chairman
Nguyen Thi Khanh Hong, khanhhonghk@gmail.com: UTE Chairman
Huynh Ngoc Tho, hntho@cit.udn.vn: CIT Chairman

# Outline

## - LP-WAN motivation

## - SMART CAMPUS objectives

## - 2018-2019 Smart Campus Campaign

# IoT opportunities : Potential market


3

# IoT opportunities : Hype cycle


4

## IoT

# LP-WAN technologies opportunities


5

## LP-WAN provides new capabilities :

## Low-power and long communication range

Power | 1mW | 10mW | 100mW

# LP-WAN technologies opportunities


6

# LP-WAN ISM bands

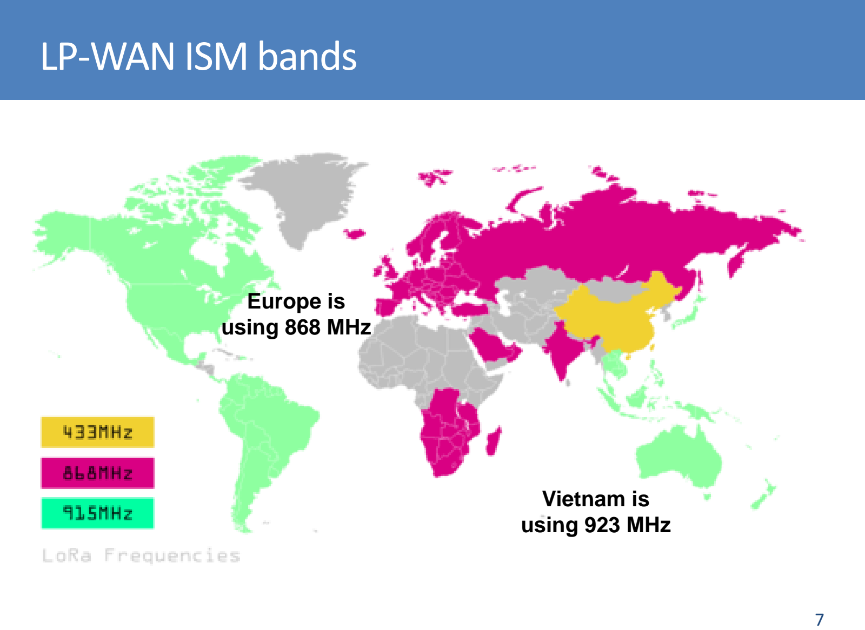
[picture p338: page 7]

7

Europe is
using 868 MHz

Vietnam is
using 923 MHz

# LP-WAN technologies comparison

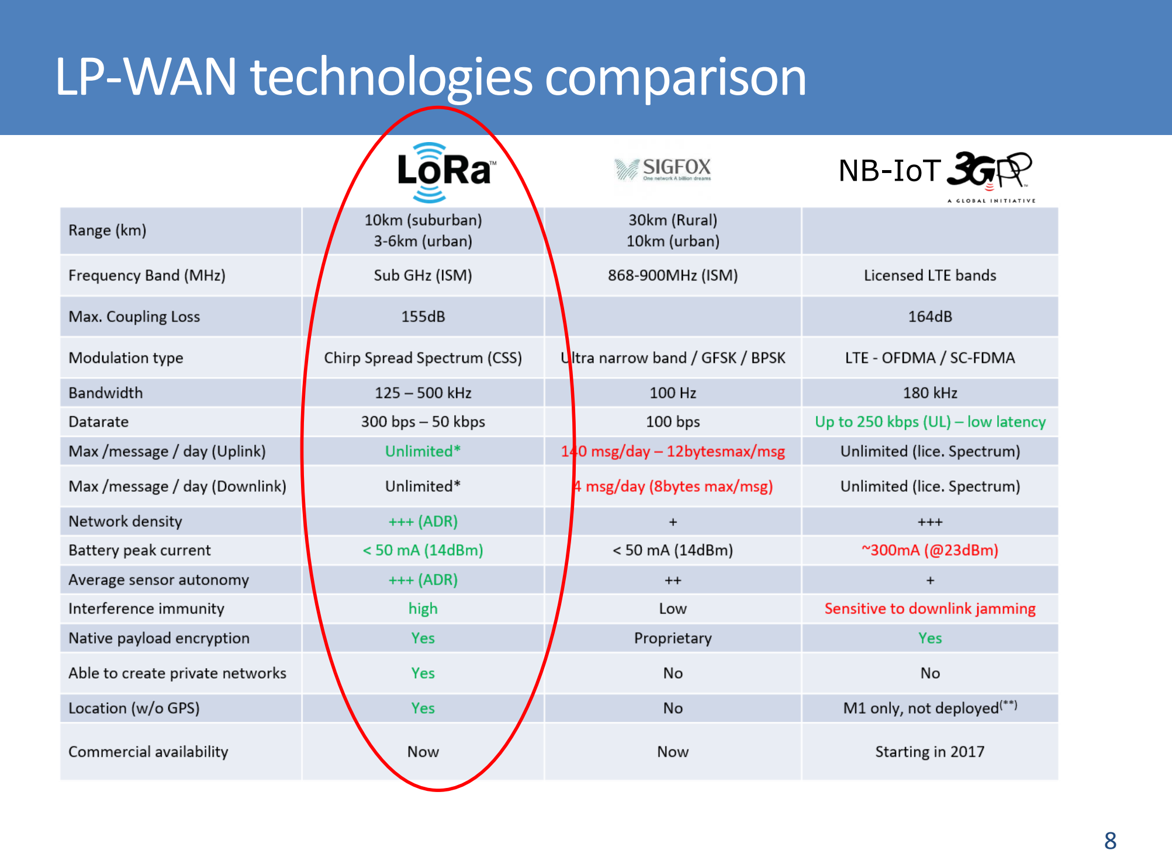
[picture p339: page 8]

8

NB-IoT

# LP-WAN technologies comparison

9

## - IoT communication standards


Frequency : 2.4GHz
Data rates : 20-250 kbps
Power consumption :
- Tx : 34 mA
- Rx : 24mA
Budget Link : around 100 dB Range : 50m
CC2538 TI


Frequency : 868MHz
Data rates : 240 bps to 5.5 kbps Power consumption :
- Tx : 28mA
- Rx : 11mA
Budget Link : around 150 dB Range : 2 km
SX1272 Semtech

# LoRa modulation : CSS (Chirp Spread Spectrum)

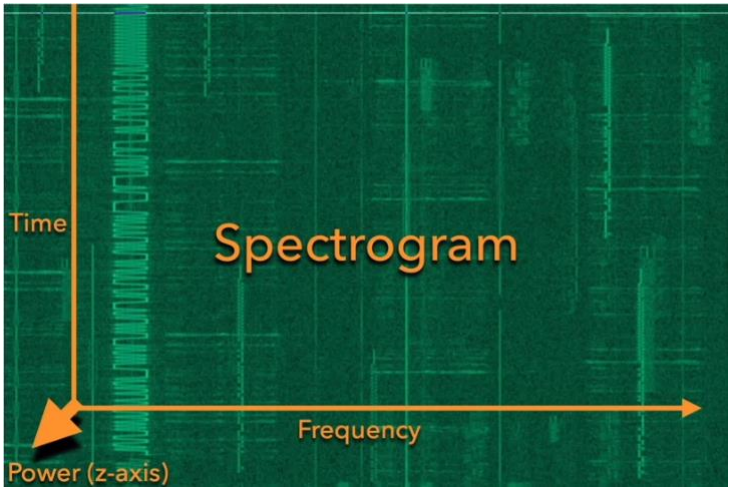
[picture p340: figure]

10 F. Ferrero – LP-WAN technology

# LoRa modulation : CSS (Chirp Spread Spectrum)

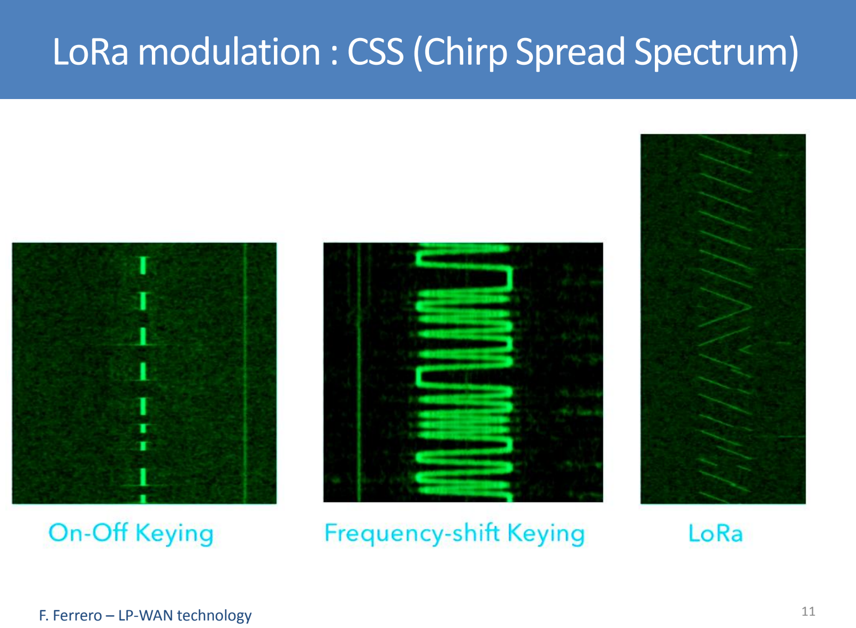
[picture p341: page 11]

11 F. Ferrero – LP-WAN technology

# LoRa modulation : CSS (Chirp Spread Spectrum)

## Different spreading factors

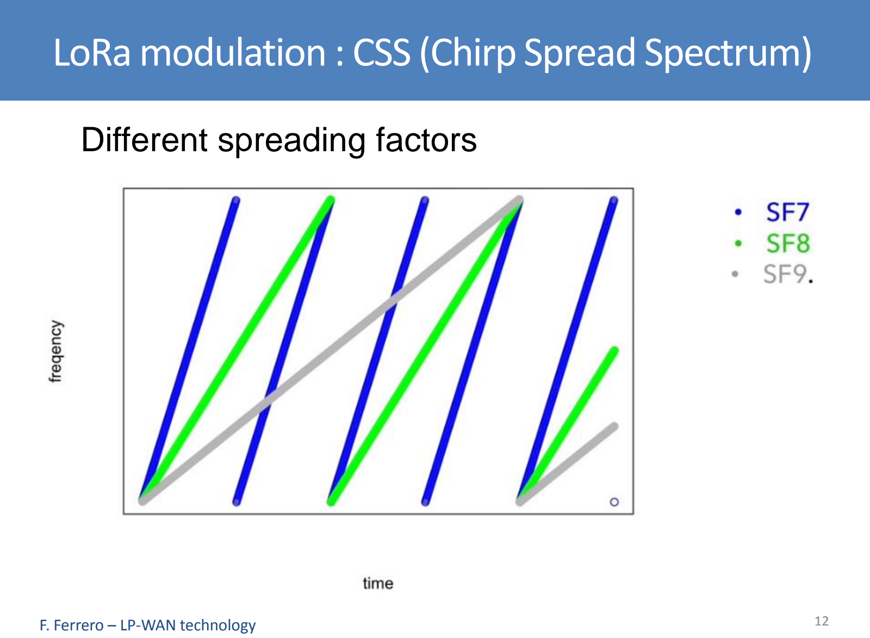
[picture p342: page 12]

12 F. Ferrero – LP-WAN technology

# LoRa modulation : Spreading factor

## - LoRa Spreading factor

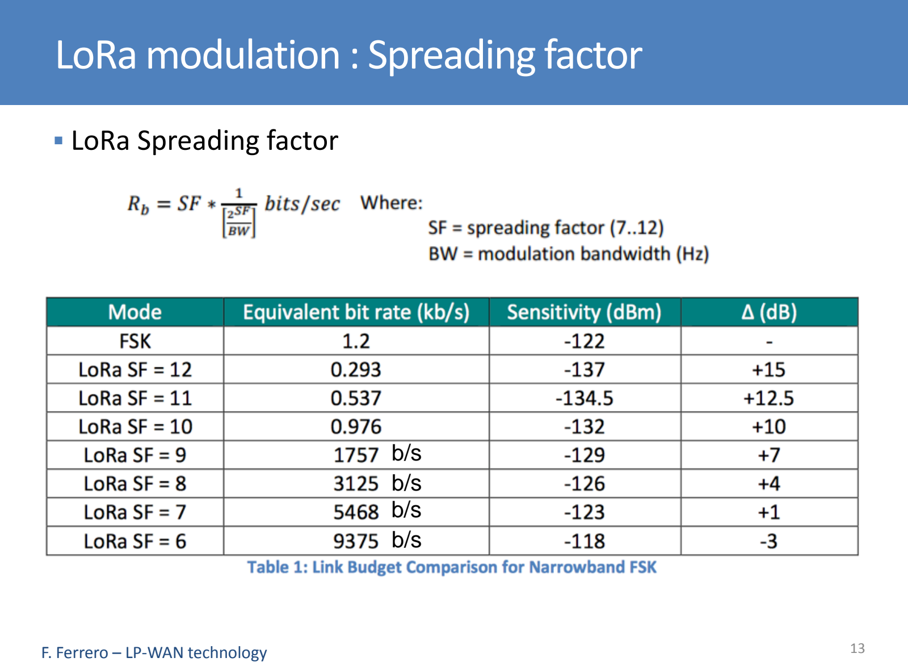
[picture p343: page 13]

13 F. Ferrero – LP-WAN technology

b/s
b/s
b/s
b/s

# LP-WAN network

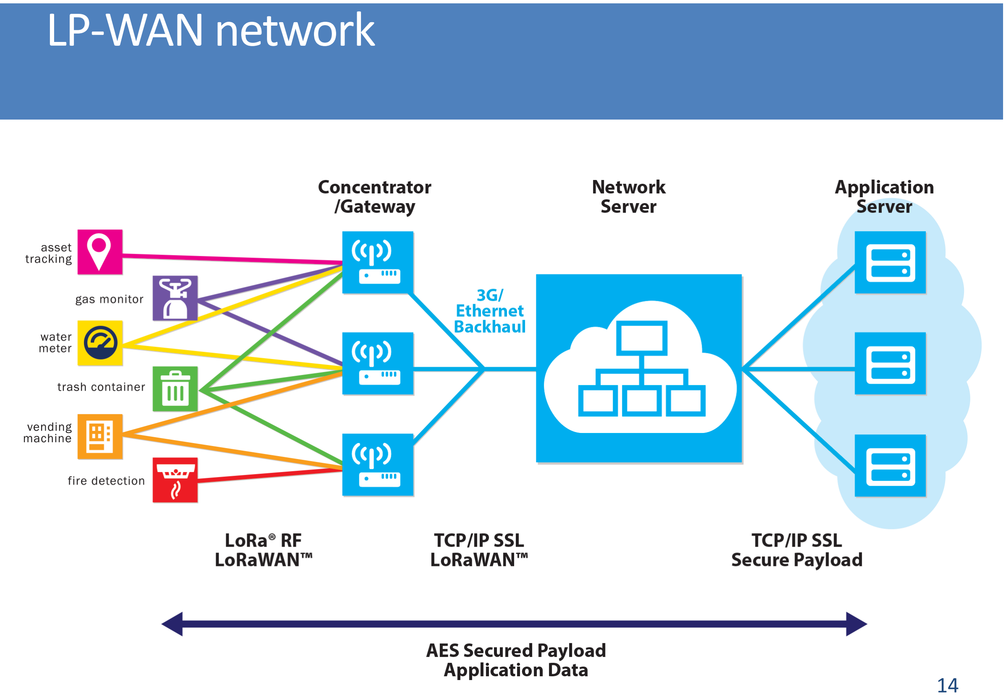
[picture p344: page 14]

14

# LoRa vs LoRaWan

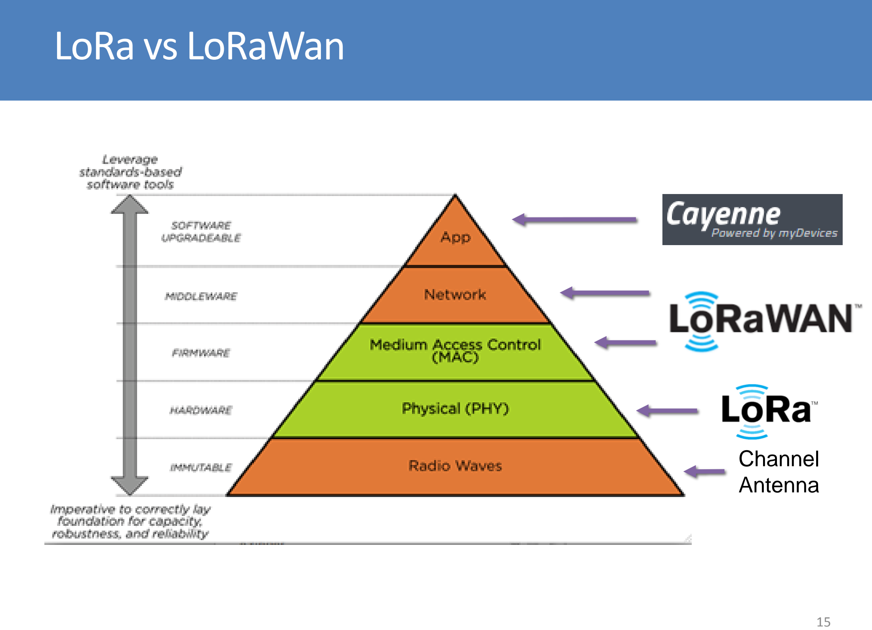
[picture p345: page 15]

15

Channel
Antenna

# LoRaWan Class A

16


Assumptions: Pout = +14 dBm, Average Current
- 10 packets / day
- Sleep current ~1uA (includes the MCU)
- MCU is mostly Off during Tx
- No ACK received
- The energy usage of the 2 unused Rx windows is low (<10%)
- Pout = +14 dBm, IDDTX = 32 mA

# The Things Network : LoRa back end ser ver

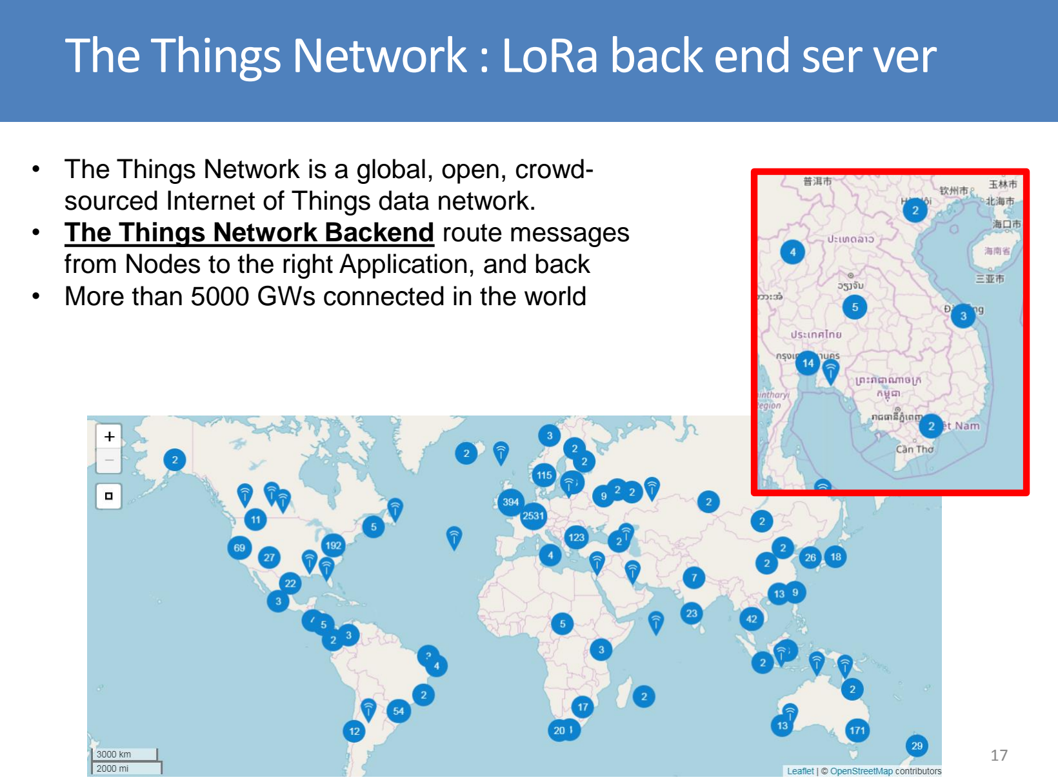
[picture p346: page 17]

17

- The Things Network is a global, open, crowd-sourced Internet of Things data network.
- The Things Network Backend route messages from Nodes to the right Application, and back
- More than 5000 GWs connected in the world

# UCA IoT Plateform

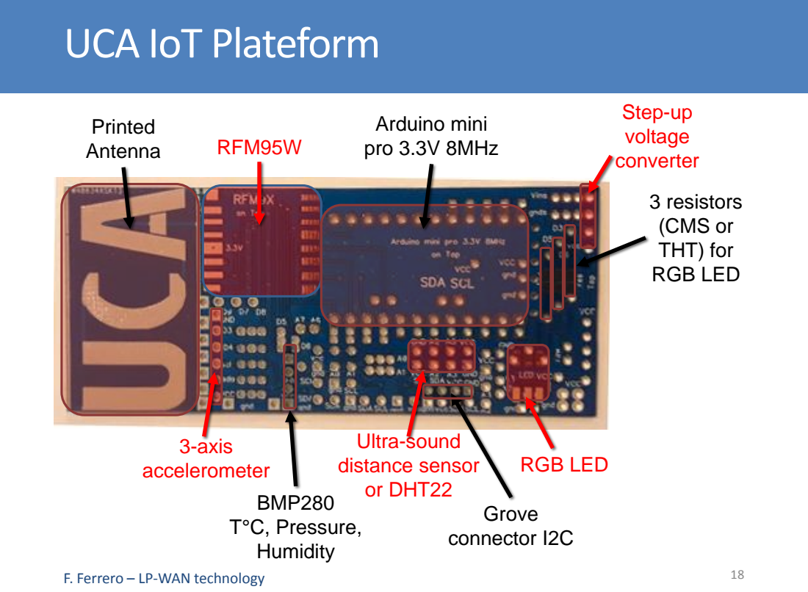
[picture p347: page 18]
F. Ferrero – LP-WAN technology; 3 resistors (CMS or THT) for RGB LED; RFM95W; Arduino mini pro 3.3V 8MHz; Step-up voltage converter; RGB LED; 3-axis accelerometer; BMP280 T°C, Pressure, Humidity; Grove connector I2C; Ultra-sound distance sensor or DHT22; Printed Antenna

# UCA IoT Plateform


F. Ferrero – LP-WAN technology | 19
- Communication up to 15 km
- Power consumption when Transmitting : 100mA on 3.3v
- Power consumption when Sleeping : 10 uA on 3.3V
- With a single AA Lithium battery : Autonomy from 1 to 3 years

https://github.com/FabienFerrero/UCA_Board/

# STM32 Murata Plateform

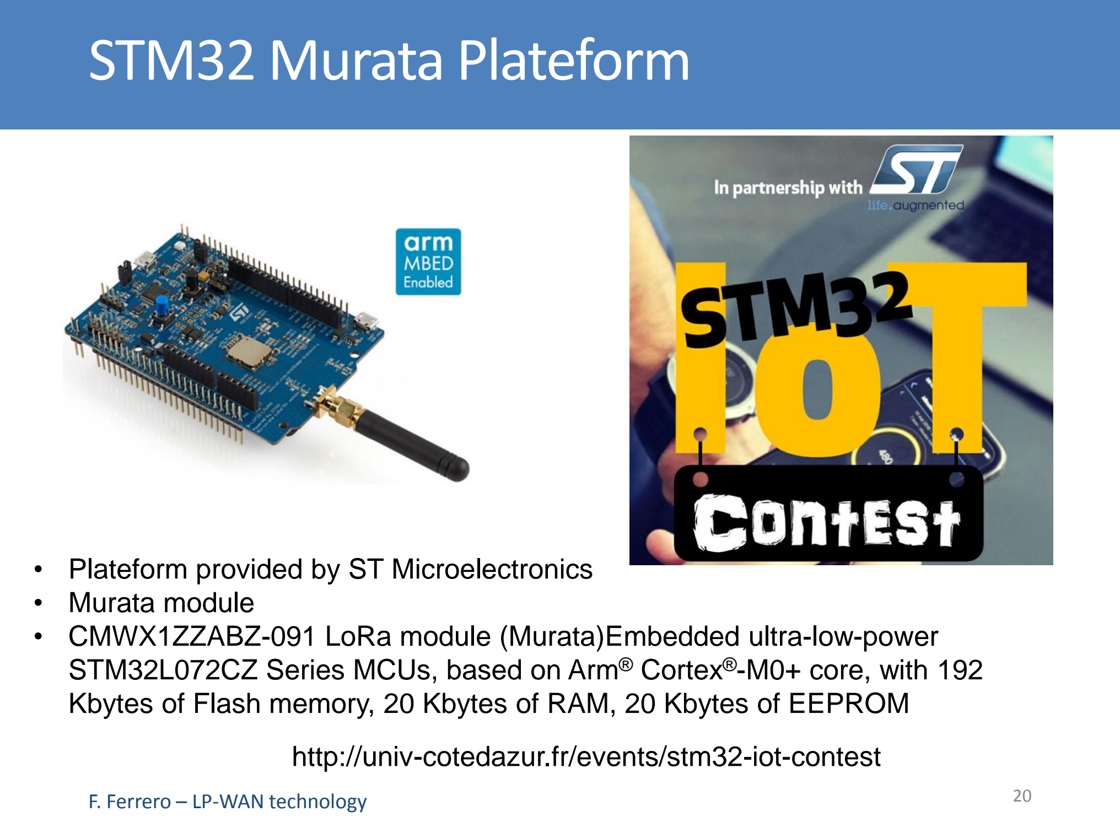
[picture p348: page 20]

F. Ferrero – LP-WAN technology | 20
- Plateform provided by ST Microelectronics
- Murata module
- CMWX1ZZABZ-091 LoRa module (Murata)Embedded ultra-low-power STM32L072CZ Series MCUs, based on Arm® Cortex®-M0+ core, with 192 Kbytes of Flash memory, 20 Kbytes of RAM, 20 Kbytes of EEPROM

http://univ-cotedazur.fr/events/stm32-iot-contest

# Outline

## - LP-WAN motivation

## - SMART CAMPUS objectives

## - 2018-2019 Smart Campus Campaign

# Smart Campus Campaign : General objectives

Université Côte d’Azur | CNRS | LEAT | 22

## - Memorandum between on August 22, 2017 between :

- The University of Danang- University of Science and Technology
- Danang International Institute of Technology (DNIIT)

## - Objective is to promote research toward the Industrial Revolutionary 4.0, Internet of Things and Artificial Intelligence

- Set up, on UD campuses wireless IoT networks (e.g. LoRa technology) and intelligent services of connected objects.
- Innovation platform mobilizing students, lecturer-researchers and companies
- Four campuses of The University of Danang: DUT, UTE and CIT campus and the headquater of UD.

# Functional objectives

Université Côte d’Azur | CNRS | LEAT | 23

## The smart campus main objectives are :

- To provide optimal teaching and learning as well as administration activities in the university through intelligent services on the IoT platforms
- Collaborative research projects between academic partners of Da Nang University, DNIIT, governmental organizations, and the companies
- Technology transfer through direct exploitation by an industrial partner or the creation of startup.

# Technology and innovation challenges

Université Côte d’Azur | CNRS | LEAT | 24

The IoT brings together three major trends in modern society: mobility, automation and an inextinguishable need for data.

Mains challenges are :

- IoT wireless data collection platform : large number of nodes connected to the network
- In real time a mass of colossal data to be analyzed and processed.
- Study of adequate solutions of the semantic web and the processing of "Big Data" allowing the reception, the filtering and the classification
- Intelligent services and applications using the data collected in a unified information system

# Organisation

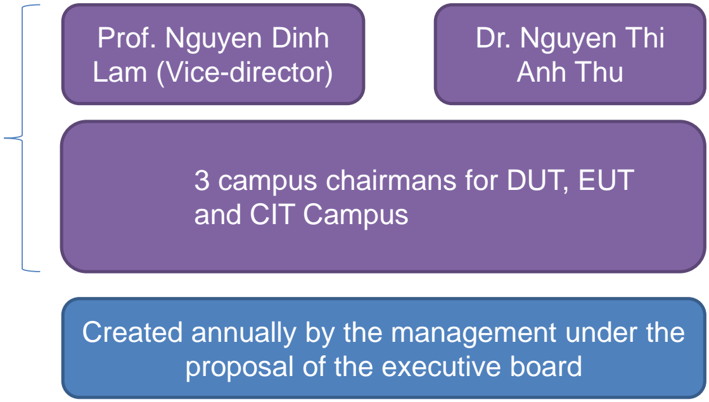
[picture p349: figure]
Dr. Nguyen Thi Anh Thu; Prof. Nguyen Dinh Lam (Vice-director); proposal of the executive board; 3 campus chairmans for DUT, EUT and CIT Campus

Université Côte d’Azur | CNRS | LEAT | 25

DNIIT
Ass. Prof. F. Ferrero

DUT
Dr. Le Quoc Huy

Academic
direction

Executive
boards

Created annually by the management under the

Commission
of jury

# Competition of innovative projects

Université Côte d’Azur | CNRS | LEAT | 26

- Annual Call for Proposals - Development by project groups with the support of lecturers/researchers - Project development : 5 months (beginning of Nov – April) - Jury rankings and awards (board of judge: members from univ., industry, investors,...) - Awards - Lecturer research awards : - Student research awards :
- Best technical project
- Best innovative idea
- Most promising project for industrial transfer

# Technical Jury - CRITERIA

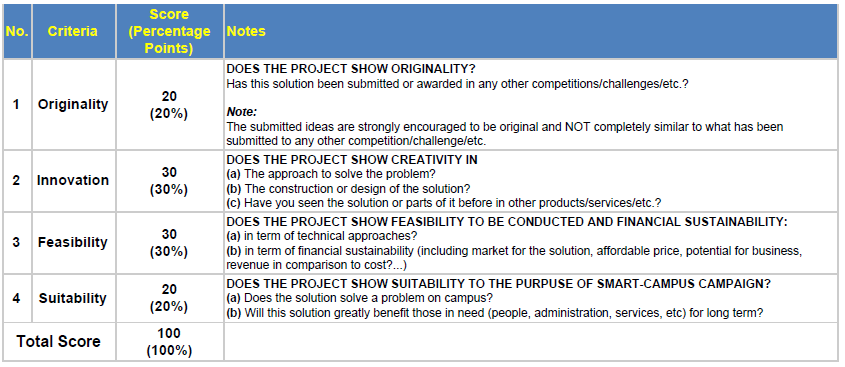
[picture p350: figure]

Université Côte d’Azur | CNRS | LEAT | 27

# Results 2018 : Lecturer Contest

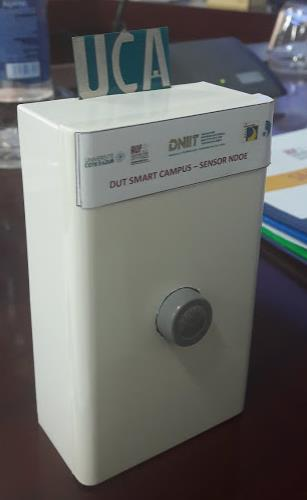
[picture p351: figure]
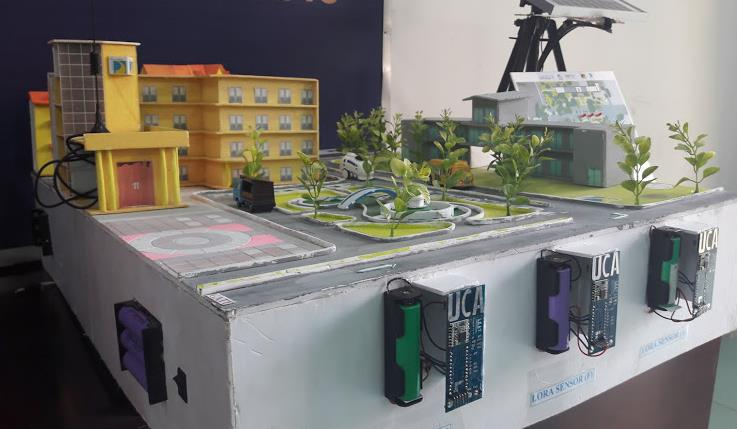
[picture p352: figure]

Université Côte d’Azur | CNRS | LEAT | 28

First Price : Owlhouse
Tran Van Lic, Nguyen Van Thuan, Chau Ngoc, Que, Nguyen Dinh Quy
The development of Smart Campus using IoT as case study: System includes electric device control, lighting and motion sensor, fire alert, student attendance management system

Second Price : SMART Parking System
Vu Van Thanh, Nguyen Quang Quoc, Tran Dinh Loi, Phan Tran Dang Khoa
End-to-end parking system based on LoRa technology powered by renewable energy

Third Price : EcoLoRa
Ngo Dinh Thanh, Pham, Nguyen Phu Hien, Le Loc Minh Phuc
IoT eco-gateway for smart campus : Develop an IoT ecosystem gateway in physical layer and application including popular IoT communication standards : MQTT, RF, Z-Wave, LoRa, etc …

# Results 2018 : Student Contest

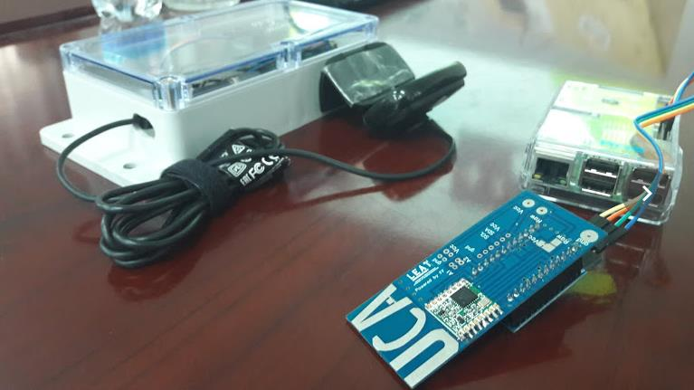
[picture p353: figure]
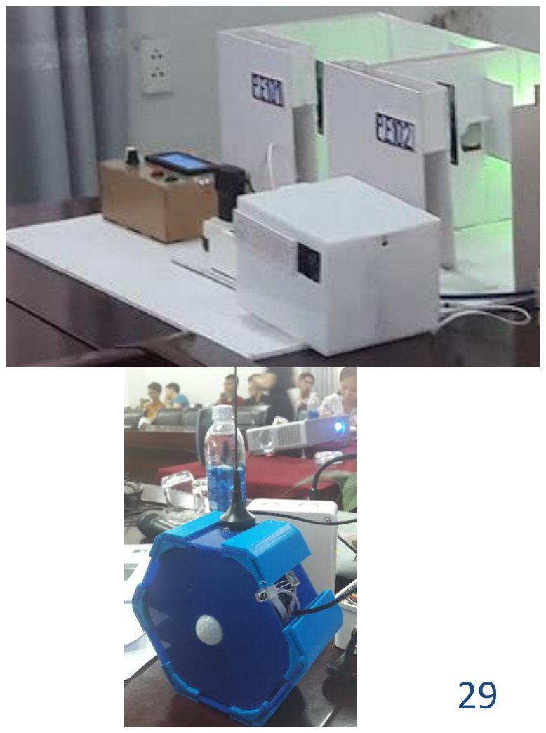
[picture p354: figure]

Université Côte d’Azur | CNRS | LEAT | 29

First Price : Wow
Le Loc Minh Phuc, Pham Nguyen Phu Hien, Bui Van Khoi, Van Tan Hien
Design an IoT LoRa gateway for self-study space management system in a smart campus based on video processing

Second Price : Galaxy team
Huynh Van Tien, Huynh Ngoc Tan, Tran, Thanh Hieu, Duong Ngoc
Quoc
IoT Solution for classroom management with presence detector, screen remotely controlled and light control.

Third Price : Tapit
Smart control of classroom environment: light, air conditioning and air quality

# Results : Most promising project for industrial transfer

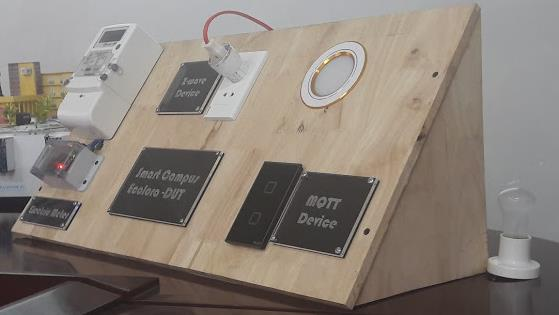
[picture p355: figure]

Université Côte d’Azur | CNRS | LEAT | 30

EcoLoRa
Ngo Dinh Thanh, Pham, Nguyen Phu Hien, Le Loc Minh Phuc
IoT eco-gateway for smart campus : Develop an IoT ecosystem gateway in physical layer and application including popular IoT communication standards : MQTT, RF, Z-Wave, LoRa, etc …

# Outline

## - LP-WAN motivation

## - SMART CAMPUS objectives

## - 2018-2019 Smart Campus Campaign

# Next Smart Campus Objectives

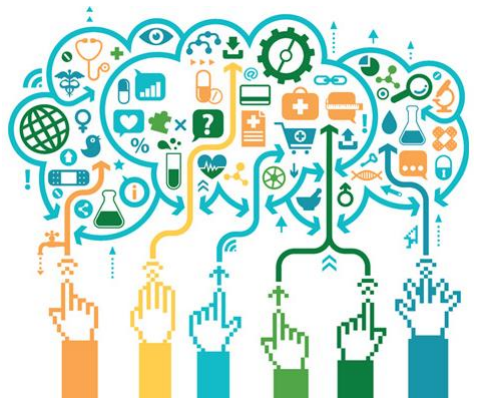
[picture p356: figure]
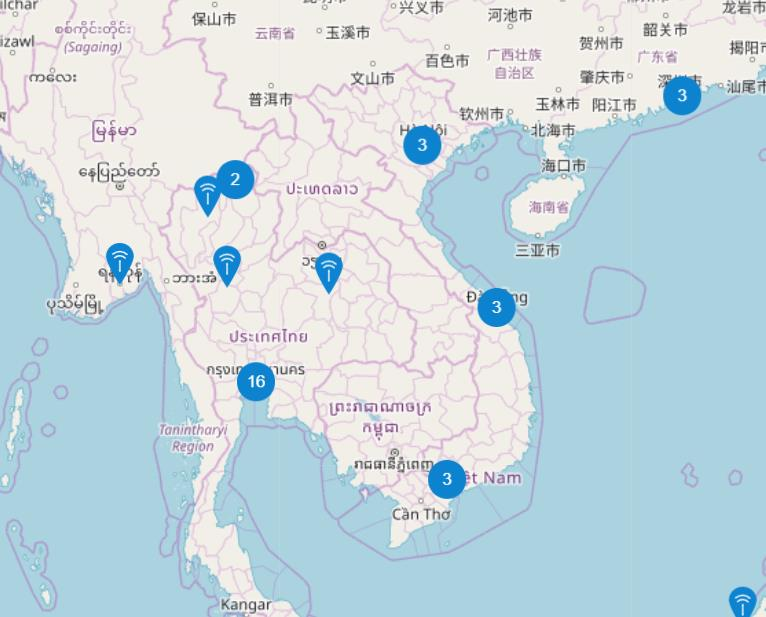
[picture p357: figure]

Université Côte d’Azur | CNRS | LEAT | 32

## - Extend projects from Smart Campus to Smart city - Set-up an open data base using connected objects developed in the frame of the projects - Highlight student and lecturer projects - Involve other departments including

mechanics, human and social science,

## economics, marketing … - Use LoRaWAN network in your campus

# Next Smart Campus Campaign

Université Côte d’Azur | CNRS | LEAT | 33

✓ Before 10th of November, submit the 1-page registration form with a description of your project and team.

✓ In November, participate to one of the tutorial organized in your campus, and receive the lora board to start your project.

✓ Create a github about your project and send the link to your campus chairman

✓ Before the 30th of December 2019, provide 1-page of your idea. The 3 best innovative ideas will receive a prize.

✓ Semi-final will be organized by each campus (DUT, UTE and CIT) to select the best projects for the final

✓ During the IEEE RIVF Conference which will be held in Da Nang the 20-22 March 2019, you will present a poster and a live demo. The best projects will receive prizes at the award ceremony.

# Next Smart Campus Objectives

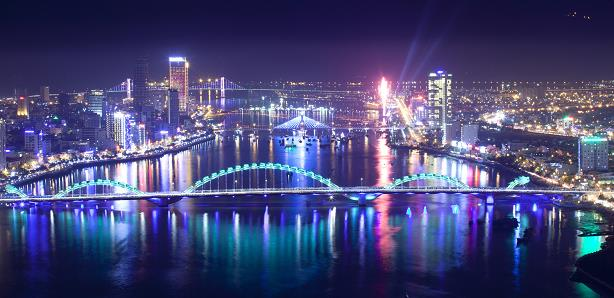
[picture p358: figure]

Université Côte d’Azur | CNRS | LEAT | 34

The proposed project shall focus on Smart Campus themes, with extension to Smart City topics. Possible projects, but not limited to, are :
- DUT : Smart Building and smart city (Energy saving management, Building security, …)
- UTE : Advanced services for e-tourism (e-cultural, e-sports, e-guide …) and more
- CIT : Green technology and e-learning (Energy harvesting, smart teaching …)

# DANANG INTERNATIONAL INSTITUTE OF TECHNOLOGY

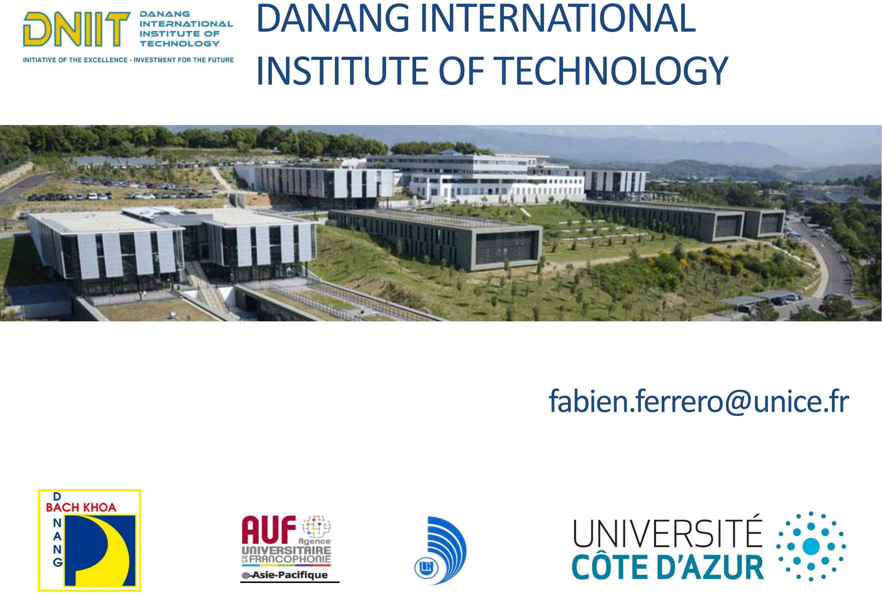
[picture p359: page 35]

## fabien.ferrero@unice.fr
