FabienFerrero/UCA_Board/documents/tutorial/DaNang/LORA_tutorial_2017.pdf

## Demo Steps by Steps

- How to connect a LoRa end-node with a LoRa Gateway
- Go to website
https://github.com/CongducPham/LowCostLoRaGw
- Click « Clone or download »
- Unzip the downloaded file
- Install Arduino IDE :
https://www.arduino.cc/en/Main/Software
- Copy all library in « \LowCostLoRaGwmaster\Arduino\libraries » to your Arduino library core directory
- Open Arduino and Arduino_LoRa_Gateway_1_4.ino project

## Demo Steps by Steps

- In Arduino_LoRa_Gateway_1_4.ino code, uncomment the #define PABOOST line

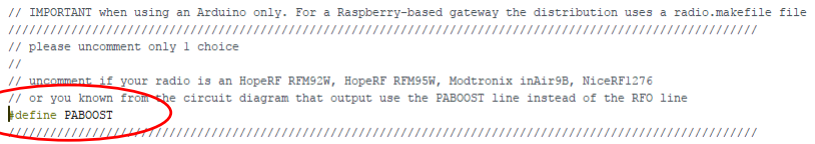
[picture p360: figure]

- Several parameters can be changed, but the LoRA modes, SF and frequency band must be the same between the GW and the node
- It is time to connect your board

## Demo Steps by Steps

- Connection between the USB-UART programmer to the Arduino mini pro
- Vcc – 3.3V
- Rx -> Tx
- Tx -> Rx
- Gnd -> Gnd
- GRN-> DTR-RST
- Select the right port in Arduino IDE
- Compile and upload the code on your board (the UART-USB should blink during the operation)
- Open your serial monitor and use 38400 baud

## Demo Steps by Steps

- You should have this screen :

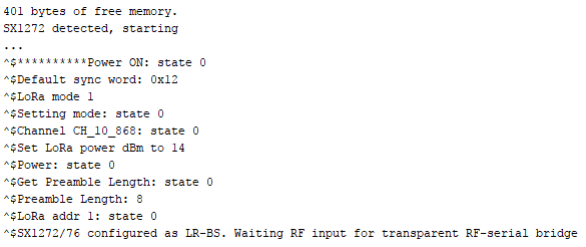
[picture p361: figure]

- Now the gateway is ready to receive data

## Demo Steps by Steps

- Now open a second Arduino IDE program (not a new window, really a second application)
- Open the Arduino_LoRa_Ping_Pong.ino sketch
- In the code, uncomment the #define PABOOST line

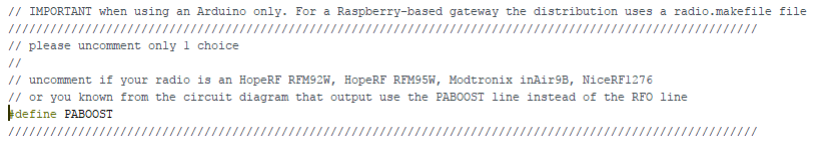
[picture p362: figure]

- Select the right port
- Check that the gateway and node configuration are the same (frequency band, mode, etc ...)
- Upload your code on the board

## Demo Steps by Steps

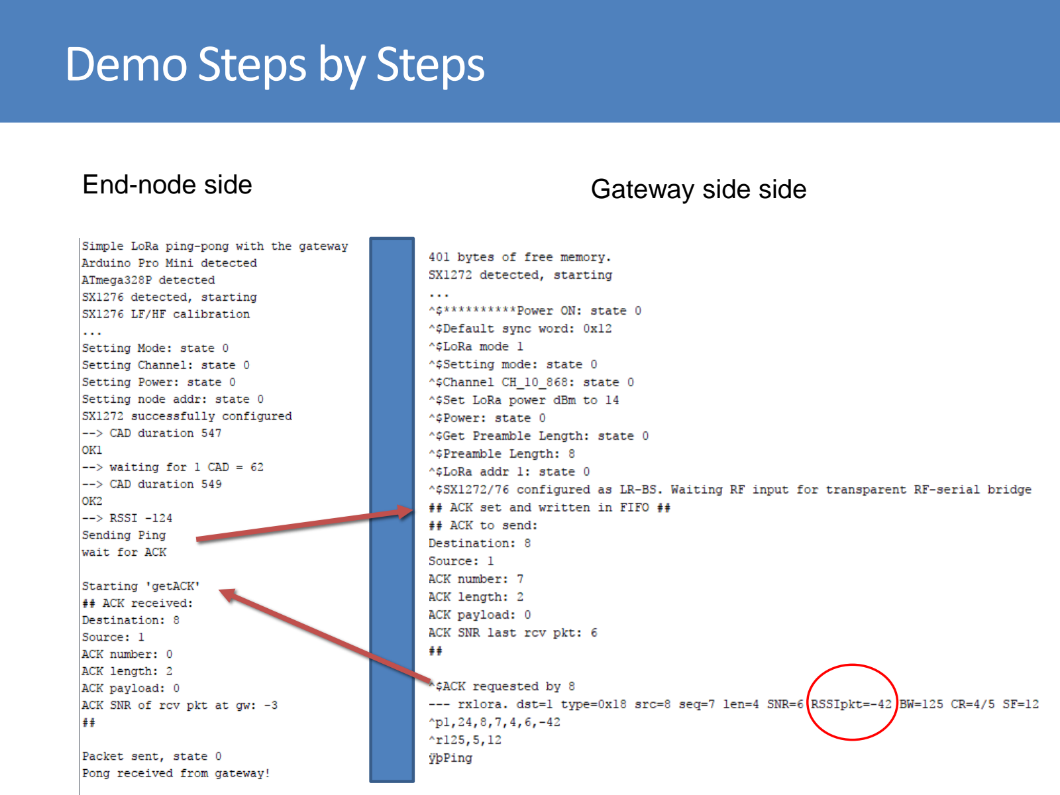
[picture p363: page 6]

End-node side | Gateway side side

## Demo Steps by Steps

- With the board very close, your RSSI should be around -45
- If not, try to upload the code again
- Add a battery to the node
- And run !
- Then you can add sensor, actuator …
- Let’s start your project
