FabienFerrero/UCA_Board/(threads)

Thread 1 (2018-02-03):

PCBWays file is corrupted

ethicstechOSS, 2018-02-03:
Hi Fabien Ferrero,
I would like to thank this project and UCA based antenna should be very useful when we target the portable LoRa based project to avoid the external antenna.

I found that the "Ordering a PCBWays" file under document/tutorial folder is either corrupted or in wrong format.

Keep it up your great job.

TIA,
Prakash

FabienFerrero, 2018-02-14:
Hi Prakash !

Thanks a lot for your comment, I've corrected the pdf file and updated it.

Regards

Fabien

Closed 2018-02-14.

Thread 2 (2018-02-15):

PCB design issues during fabrication

ethicstechOSS, 2018-02-15:
Hi. I am trying to fabricate the uploaded the PCB gerber file and forwarded it for PCB fabrication. Its look like there are some design issues they are facing before the fabrication. The following issues has been raised by fabrication engineer and need to be fixed. Kindly go through the issue and help me to fix these issues.
1. Two drill files are given, hole.drl & via.drl. What are the roles of these two files?.
2. In your design, the drill to drill distance is 0.08mm. Can we increase upto 0.15mm?.
3. In your design the TT-TP-PP-TW is 0.0179mm. Can we increase upto 0.125mm?
[UCA_PCB_Error.pdf](https://github.com/FabienFerrero/UCA_Board/files/1727886/UCA_PCB_Error.pdf)

I have attached a error document in detail. PFA.

It should be useful if you share the schematic document as well.

TIA,
Prakash

FabienFerrero, 2018-02-16:
Hi Prakash,

This main issues are due to the fact that I've done manually the layout.

So I havent't any schematic document (just the electrical connection shown in the main page of my github.

1. via.drl are PTH, hole.drl are non-PTH

2. I tried to add a maximum of pads for various connection, so some drill distance do not respect the 0.15mm. If it can help, all the drill that do not respect the D2D distance are electrically connected.

3. I confirm that the best option is a suggested, to making short where PAD TO TRACK error found. I used an isolation of 0.25mm between the track that need to be disconnected.

Hope it help

Fabien

Thread 3 (2018-03-08):

Ultrasonic Sensor Damaging Pro Mini 3.3V Board

mccarr, 2018-03-08:
Hi Fabien,

I saw your new version 3 has pin support for the HC-SR04 Ultrasonic Distance sensor. The HC-SR04 is a 5V device and I've found it doesn't work with 3.3V input (so have others on the internet apparently). The echo pin outputs 5V which is fed into one of the inputs of the Pro Mini board.

I think this could potentially damage the board. According to the ATMEGA328P datasheet, the maximum safe voltage on any input pins is VCC + 0.5V. So if you are powering the device by a typical 3.6V (or thereabouts) battery, the 5V input could damage the Arduino Pro Mini.

I actually recently destroyed a board by doing this. Maybe you could include a word of warning on your page where you mentioned the Ultrasonic sensor?

FabienFerrero, 2018-03-31:
Hi,

Thanks a lot for your comment. I do not check that HC-SR04 doen't work properly on 3.3V (because it was giving values !).

I'm going to add the warning.

See you

Fabien

Thread 4 (2018-03-19):

LoRa radio is not working.

ethicstechOSS, 2018-03-19:
Hi. I ordered PCBs from PCBWAY. I soldered the radio & Mini Pro. Then I tried cpham's GPS arduino program, https://github.com/CongducPham/LowCostLoRaGw/tree/master/Arduino/Arduino_LoRa_GPS

The lora module is not detected even I used CS  as pin #10. However, I realized that your current board and the board he used for collar project is different. May I know if you have any sample program to test the lora module and please share the schematic to cross check the pin connections.

TIA.

ethicstechOSS, 2018-03-19:
Hi. I found a LoRa_test_states program in arduino folder and tested. Its working straightaway and started sending the Hello message. Then I cross check Cpham's program. RST is missing in his SZ1272.H file. Then I added. Its working now. Thanks.

Closed 2018-03-19.

Thread 5 (2018-04-03):

GPS sensor is NOT working on this latest PCB.

ethicstechOSS, 2018-04-03:
Hi. I got your latest version of PCB and testing CPham's GPS Collar project, https://github.com/CongducPham/tutorials/blob/master/Low-cost-LoRa-Collar.pdf
But I am not receiving any GPS  datas at gateway side. I also realized that the PCB board he used on his document/experiment and your current PCB might have some differences. Kindly share the schematic document for current version of PCB.

Also like to know if you had tried GPS sensor (GPS collar project expected to work straightaway) on your latest version of PCB.

TIA.

FabienFerrero, 2018-04-09:
Hi Tia,

Personaly I don't try this tutorial, but I know that CongDuc Pham has tested it.

There is one mistake in this PCB version, the RAW pads are connected to the wrong pin of the Arduino (the reset pin).
So if you use the raw input, you have to connect directly to the pin below the Arduino raw pin.

As shown in this picture :

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

Sorry for the inconveniance

Fabien

Thread 6 (2018-04-15):

PCBWay isue

escyes, 2018-04-15:
Thank you very much for sharing your work.
I have tested your previous design with hopeful results regarding the efficiency of the antenna.
I just requested samples of the current design by the method of requesting them directly to "PCB Way" and they have sent me the following:

**For order W157029ASU2, please check attached pictures, the copper layers and soldermask layers format are not correct, you designed all of them as Raster, but we require line, smt pad and through hole formats, here attached other pictures about correct format for your reference**

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

I would appreciate it if you confirmed the option added by the manufacturer.

Very thankful.

Enrique Sainz

FabienFerrero, 2018-05-09:
Sorry for my late answer,

It's true that the file do not separate pads from line, but you can just answer to PCBway that this gerber files were already process as raster type and the results was ok.

Kind regards

Fabien

Thread 7 (2018-07-27):

Just arrived

lbauchwitz, 2018-07-27:
Hello Fabien, I just received pcb from pcbway. Thanks for your job. I notice you with my progress!
I wait from bme280 sensor.
I use the same pins as BMP280 (you have a graphic with this)?

Thanks in advance

Leonardo

FabienFerrero, 2018-10-27:
Hi,

BME280 or BMP280 use I2C, so you should use the pin SDA and SCL

Fabien

Thread 8 (2018-07-27):

Test hope rf95

lbauchwitz, 2018-07-27:
At least, i do not solder in pcb. I try to test in protoboard, but rf95 not respond.
How can i sure the module is ok?

FabienFerrero, 2018-10-27:
The easyest test, is to run the continuous wave code.
Look on the serial monitor with 38400 baud rate, it will tell if the module is detected.

Fabien

Thread 9 (2018-09-11):

Tunning antenna

lbauchwitz, 2018-09-11:
I configure gw with 91 MHZ Band, in the frequency 913.88
I read the antenna tuto but i dont understand.
I need to make a cut at 21 mm? to tune? (I see the yellow curve)
Thanks in advance

FabienFerrero, 2018-10-27:
Hi,

Sorry for my late answer,

Yes, you need to cut at 21mm from the edge. To move the antenna from 868 to 914MHz, the antenna need to be shorter.

Kind regards

Fabien

Thread 10 (2019-08-11):

Short circuit between Antenna and Ground plane

man4567890, 2019-08-11:
There seem to be a short circuit between the ground plane and the Antenna connection pad
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
Even on the boards I ordered from a PCB manufacturer, with nothing populated on the board, it shows as a full short
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

If I cut the track in the A, the board works as expected
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

Is the short on purpose? Must it be cut?

FabienFerrero, 2019-08-31:
Hi,
I know that it can seem strange, but this type of antenna (Inverted F antenna) is optimized thanks to this short circuit.
By cutting this line, you will reduce by 3-4dB the gain of the antenna.

So don't worry about the short circuit.

Kind regards

Closed 2019-08-31.

Thread 11 (2021-01-08):

How to tune the antena for a 1mm board.

ludiazv, 2021-01-08:
Thanks Fabien for this project.

  Some manufactures do not offer 0.8mm on some services. The thiner they offer is 1mm. Can the antenna be tuned for that thickness or requires a new desing?

FabienFerrero, 2021-02-20:
Dear Ludiazv,

The antenna can be easily tuned by cutting the top line (see document on antenna tuning).
For 1mm pcb thickness, the actual antenna frequency will be probably decreased by few MHz, so a very short cut (1 mm max) will be needed. Whatever, if you keep actual configuration, the decrease in performance will be very small

ludiazv, 2021-02-21:
Thanks a lot.

Closed 2021-02-20.

Thread 12 (2021-04-17):

What changes would need to happen if the extra sensor space is not needed?

Qqwy, 2021-04-17:
Dear Prof. Ferrero,

The UCA board is a wonderful project!
In our case, we will however not need to add any extra sensors to the board (besides an external button), and are hoping to keep the PCB small.
As far as I understood from watching the video of your presentation at the TTN conference, altering the PCB size would mean that the antenna itself would also need to be altered.

Is it possible to slightly modify the UCA board for this purpose, or would a complete redesign of the antenna be needed for such a situation?

Thank you for your time,

~Marten/Qqwy
