FabienFerrero/UCA_Board/(commit log)

2018-08-20 Adding GYVL53X sensor
2018-08-20 Sound sensor added
2019-02-05 Sensors update
2019-03-08 update power consumption
